drewsum/VFD_Clock/README.md

A VFD clock centered around a PIC32MZ EF microcontroller
