drewsum/VFD_Clock/rev_b/hdw/README.md

rev B control boards use rev A display boards
