drewsum/VFD_Clock/(threads)

Thread 21 (2020-02-05):

Consider a different RTC for backup RTC

drewsum, 2020-02-05:
The DS3231 is too large to be justified since it's in an SO-16 package. Try to find an 8 pin part

drewsum, 2020-02-06:
This ended up being fake news

Closed 2020-02-06.

Thread 22 (2020-02-07):

Consider IV-1 tubes as colons

drewsum, 2020-02-07:

drewsum, 2020-02-13:
Parts ordered, just need to find pinout

drewsum, 2020-02-17:
https://www.radiomuseum.org/tubes/tube_iv-1.html

drewsum, 2020-02-17:
Looks like that source requires you to register to access pinouts/datasheets

drewsum, 2020-02-17:
http://www.tube-tester.com/sites/nixie/dat_arch/russian_tubes.pdf

drewsum, 2020-02-17:
https://radiokot.ru/circuit/digital/home/175/

drewsum, 2020-02-17:
https://kama-labs.com/vfd_iv-11-4

drewsum, 2020-02-17:
https://kama-labs.com/boards

drewsum, 2020-02-17:
http://www.spark-tube.com/wp-content/uploads/2018/08/iv-1-datasheet.jpg

drewsum, 2020-02-17:
Translation of previous comment:
AND B-1
Vacuum luminescent indicator for displaying information-
mations in the form of dots and dashes.
Design-glass, over-
miniature. Pro indication-
is harassed through the side by-
the surface of the cylinder. The color of the candles-
nia green. Weight 7
7 g.
Thirty
Thirty six
Twenty
The findings of the electrodes:
1 ... cathode;
7 grid (mask); 8-cathode,
conductive layer on the inner-
surface area of the balloon; 10
anode-segment (dash); 13-anode-
segment (point).
Master data
The brightness of
Viewing angle
Incandescent current
The current of anode-segment (in static mode)
Total anode current
Filament voltage
The voltage of the anode and the grid:
in static mode
in pulse mode
MTBF
300-500 CD / m2
60°
2.5-5.0 mA
0.25 mA
0.6 mA

drewsum, 2020-02-24:
The above pinout was verified using received parts:
GND(cathode): 1
Grid: 7
Filament voltage: 8
Dash anode: 10
Dot anode: 13
in numbering follows the same scheme as IV-6, but with more pins

Closed 2020-03-04.

Thread 25 (2020-02-13):

Switch to LTC6900 for buzzer clock generation

drewsum, 2020-02-13:
The 555 is bulky and takes up too much room with its external circuits. LTC6900 looks like a good alternative to keep part count and solution size down

Closed 2020-02-15.

Thread 30 (2020-02-25):

Flip connector/buffer pinout for grid drive signals

drewsum, 2020-02-25:
This would make routing on the display board easier and since the signals are just paired to PIC I/O it doesn't matter which GPIO they go to

Closed 2020-02-27.

Thread 33 (2020-02-28):

VFD tube sanity check

drewsum, 2020-02-28:
Do a final sanity check on VFD tube pinout before ordering boards. This is a lot to get wrong

Closed 2020-03-04.

Thread 37 (2020-03-18):

Fix dsp io connector footprints

drewsum, 2020-03-18:
The connector footprint used on the logic board is far too narrow. Extend the pads outward to make it easier to solder. The same might be the case for the connector on the display board

Closed 2020-10-07.

Thread 38 (2020-03-20):

Adjust clock settings to source clock from 8MHz external POSC

drewsum, 2020-03-20:
Replace the stuff in the `PLLInitialize()` function within device_control.c

Closed 2020-03-26.

Thread 42 (2020-03-28):

Fix schematic I2C addresses

drewsum, 2020-03-28:
A lot of the I2C addresses noted in the schematic are wrong. All INA219s are wrong

Closed 2020-04-13.

Thread 44 (2020-04-03):

BOM change  display I/O expander series resistors to a higher value

drewsum, 2020-04-03:
Right now they're 499 ohms, which leaves the cyan LEDs way too bright. Try something way higher. Try something as strong as 10k or 100k

drewsum, 2020-04-03:
Switched to 10k in hardware, if this is good need to update the schematic

drewsum, 2020-04-03:
These should probably actually be on the order of 100k, they're still too bright with 10k

drewsum, 2020-04-14:
Going to leave these at 10k

Closed 2020-04-14.

Thread 45 (2020-04-10):

BOM change all INA219 Filter Resistors

drewsum, 2020-04-10:
You had 100 ohms in the schematic. INA219 datasheet recommends 10. This could have something to do with odd current results

Closed 2020-04-14.

Thread 46 (2020-04-10):

Move WDT clearing to main()

drewsum, 2020-04-10:
Right now the ISR for the heartbeat timer is what clears the watchdog. This leaves room for issues to arise when the application does not properly return back to `main()`. You should switch to setting a clear WDT request flag in the ISR, and actually clear the WDT from main. This would absolutely force a reset if `main()` is not being properly returned to

Closed 2020-04-11.

Thread 48 (2020-04-11):

Fix I2C driver to avoid weird interrupt return issues

drewsum, 2020-04-11:
An issue with I2C that has plagued the electronic calendar is appearing on this board as well. This is making me think it's either interrupt related or has something to do with storing all of your telemetry in a C structure. Regardless, the CPU gets hung up every once in a while. Since moving the WDT clearing function to `main()`, rather than "stall", the CPU is reset by the WDT. This confirms that when this stalling issue happens, the CPU core is not returning back to IPL level 0, or back to main. If I comment out the continuous I2C polling for all of the telemetry sensors, this issue disappears.

Figure this out and apply it to electronic_calendar too.

May want to switch to a purely-blocking implementation of I2C instead of interrupt driven, since you're blocking anyway. If shit is still completely broken, consider using a bit bang implementation.

I2C has a lot tied to it on this board and it would suck to throw in the towel on this. At the very least, leave the IO expander/RTC nonsense but get rid of polling telemetry sensors. This really sucks to see appear on this project as well.

drewsum, 2020-04-15:
This is in progress. I've minimized the likelihood of the issue arising during normal operation by having I2C sensors only be polled during telemetry serial stream. I also set the I2C1 Master Interrupt to IPL7 in the hopes that this was caused by strange timing issues with the master interrupt being interrupted by higher priority interrupts. Seems promising so far. I also gutted all of the 10-bit I2C support code in the I2C master driver since this is never used. This should hopefully speed up execution of the master ISR, since it's really long. Here'es hoping this will fix this!

drewsum, 2020-04-15:
This didn't fix it, but it helped.

drewsum, 2020-04-15:
Actually it's unclear if these changes even helped, I'm still seeing a ton of resets

drewsum, 2020-07-09:
This was solved by changing to the MPLabX Harmony I2C driver. Use this for future projects, this is what was used on pulse oximeter

Closed 2020-10-07.

Thread 51 (2020-04-12):

Fix *IDN? Return string

drewsum, 2020-04-12:
Still prints out that it's an electronic calendar, oops

Closed 2020-04-13.

Thread 58 (2020-04-19):

Add BLE stuff?

drewsum, 2020-04-19:
This is hit or miss. The project is clearly complex enough already as it is. I kicked the can down the road on this and wasn't able to get the BLE module to reply to the host. I'm planning on soldering another one down in the case that the installed module is blown or something. If I still can't get it to work after replacing the part, let's ditch this. Setting over USB and pushbuttons is good enough.

Closed 2020-10-07.

Thread 59 (2020-04-19):

Add I2C slaves status command

drewsum, 2020-04-19:
print off manufacturing ID stuff for supported I2C slave devices from a serial command

drewsum, 2020-04-19:
I completed this for INA219

drewsum, 2020-04-19:
Finished this! It's awesome

Closed 2020-04-19.

Thread 61 (2020-10-07):

Control Board rev B

drewsum, 2020-10-07:
Improvements from rev A would include:
~~* Fixing display board I/O connector footprint (pads are located too close to centerline/anchor to hand solder)~~
~~* Remove PIC32MZ backup VCC supply from battery, hard wire to +3.3V~~
~~* Make expensive components like telemetry and time of flight optional with config hardstraps~~
~~* Remove USB UART isolation, share grounds~~
~~* Switch to PICKIT4 header for programming~~
~~* Switch to cheaper input power protection circuitry~~
~~* Switch to smaller +3.3V, +5V and +1.2VFF power supplies (lower output current rating, smaller inductor)~~
~~* Remove BLE module~~
~~* Switch to smaller CR1616 RTC backup battery, remove duplicate battery footprints, add VBAT comparator~~

drewsum, 2020-10-07:
* Change power discharge circuits to match your more recent projects

drewsum, 2020-10-07:
* Fix USB bridge sheet to use most recent version of this circuit

drewsum, 2020-10-07:
* Remove excessive MCU bypass (1000pF, 10nF) and switch to using a 0.1uF and 10uF parallel combination per power pin bank

drewsum, 2020-10-07:
* Change all telemetry filter resistors to 10 ohms
* Remove input telemetry on converters?

drewsum, 2020-10-08:
Change UART level shifter to SN74AVC2T245RSWR

drewsum, 2020-10-09:
~~* Switch from TPS62130 to TPS62150A to fix PGOOD issues with older part~~
I actually used the correct Digi-Key part number for this, just need to update my schematic symbol library to reflect the parts I've been ordering are the "A" version

drewsum, 2020-10-09:
* Add notes to TPS62150 sheets to keep offsheet output capacitance below 200uF

drewsum, 2020-10-13:
* Remove VBAT comparator and switch to this: https://electronics.stackexchange.com/questions/416336/monitor-coin-cell-voltage-without-loading-it-when-power-is-off

drewsum, 2020-10-14:
Switch PIC32MZ oscillator voltage source to +3.3V from +3.3V_BCKUP

drewsum, 2020-10-14:
* Remove DNP pull resistors in order to clean up BOM, make hand soldering easier

drewsum, 2020-10-14:
* Change POS5_USB current sense filter resistors to 10 ohms, they're currently at 100

Closed 2020-10-26.

Thread 63 (2020-10-20):

fix PIC digi-key PN in rev B schematic

drewsum, 2020-10-20:
change from 12x12mm part number to 14x14mm part number, since the footprint is 14mmx14mm

Closed 2020-10-26.

Thread 64 (2020-10-26):

Add "Display Toggle" serial command

drewsum, 2020-10-26:
sending this serial command would essentially do the same thing as pressing the power capacitive touch button

Closed 2020-12-17.

Thread 65 (2020-11-16):

Fix 2 bit UART transceiver footprint

drewsum, 2020-11-16:
the pin order of this footprint was reversed. Try to fix it to match the actual device pinout for future projects

Thread 67 (2020-11-25):

Goals for Rev B Firmware

drewsum, 2020-11-25:
* ~~Update GPIO macros and pin setup to match rev B hardware~~
* ~~Update all I2C device drivers to use new I2C master code~~
* ~~Update peripheral files such as I2C, RTCC, USB UART, ADC~~
* ~~Update device control to fix clocking issues~~
* ~~Update telemetry to remove PS input power monitors, since these are not present on rev B hardware~~
* ~~Update USB UART commands to include optimizations made in past projects~~
* ~~Update error handler~~
* ~~Make functionality configurable with hardstraps~~
* ~~convert all I2C code from I2C5 to I2C1 (or make configurable with macros like you did for USB UART)~~
* ~~Convert to new, faster heartbeat timer with PWM LED~~
* ~~Properly implement `IDLE` mode on power pushbutton toggle~~ Not doing this
* ~~Add serial command to set power state (emulate pressing the power button)~~
* ~~Add serial command to set clock display state (pressing menu buttons)~~
* ~~Add backup rtc temp and battery voltage telemetry configuration based on hardstrap~~
* ~~Copy INA219 driver bug fixes from analog clock firmware~~
* ~~Add display board time of flight to platform status command~~
* ~~Add firmware version macro~~
* ~~Start powered off by default~~

Closed 2020-12-17.

Thread 70 (2020-12-30):

Add RTC Backup when setting time with pushbuttons

drewsum, 2020-12-30:
Rev B firmware doesn't backup RTC time in the backup IC when setting time with capacitive touch pushbuttons. Add this when the user switches any RTC parameters using these pushbuttons and "locks" them

Closed 2021-01-09.
