drewsum/VFD_Clock/rev_b/hdw/Logic_Board/VFD_Clock/VFD_Clock.pdf

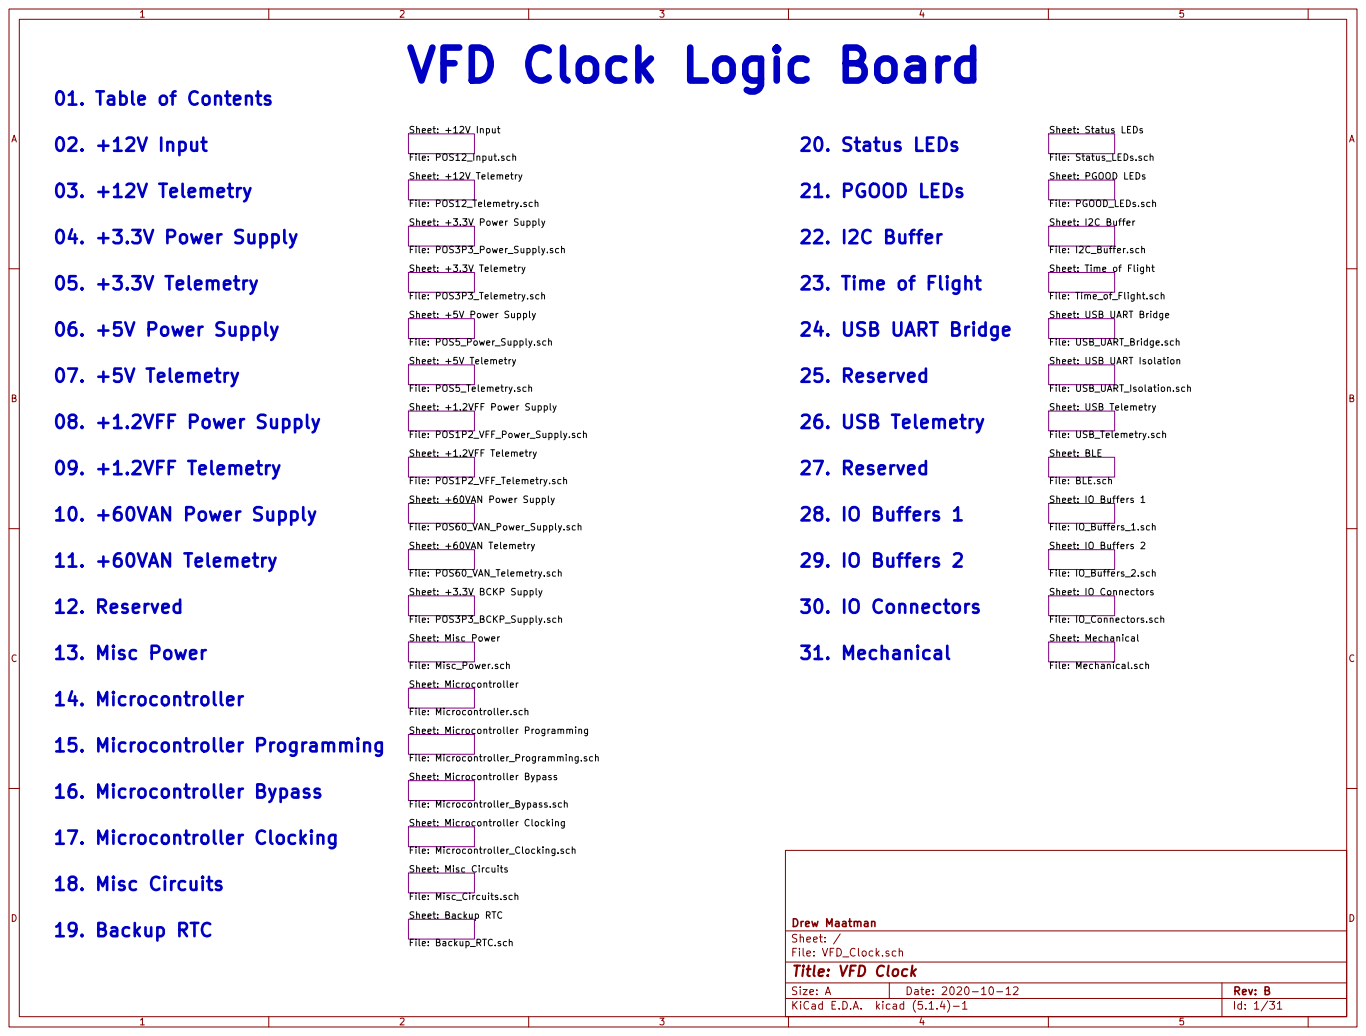
[picture p1: page 1]

VFD Clock Logic Board

File: Time_of_Flight.sch Sheet: I2C Buffer File: I2C_Buffer.sch Sheet: PGOOD LEDs File: PGOOD_LEDs.sch Sheet: Status LEDs File: Status_LEDs.sch

Sheet: Time of Flight

File: USB_Telemetry.sch Sheet: USB UART Isolation File: USB_UART_Isolation.sch Sheet: USB UART Bridge

File: BLE.sch Sheet: USB Telemetry

File: POS3P3_BCKP_Supply.sch Sheet: Misc Power File: Misc_Power.sch Sheet: Microcontroller File: Microcontroller.sch Sheet: Microcontroller Programming

File: Microcontroller_Programming.sch
File: Backup_RTC.sch Sheet: Misc Circuits File: Misc_Circuits.sch Sheet: Microcontroller Bypass

File: VFD_Clock.sch Sheet: / Drew Maatman

Id: 1/31 Title: VFD Clock

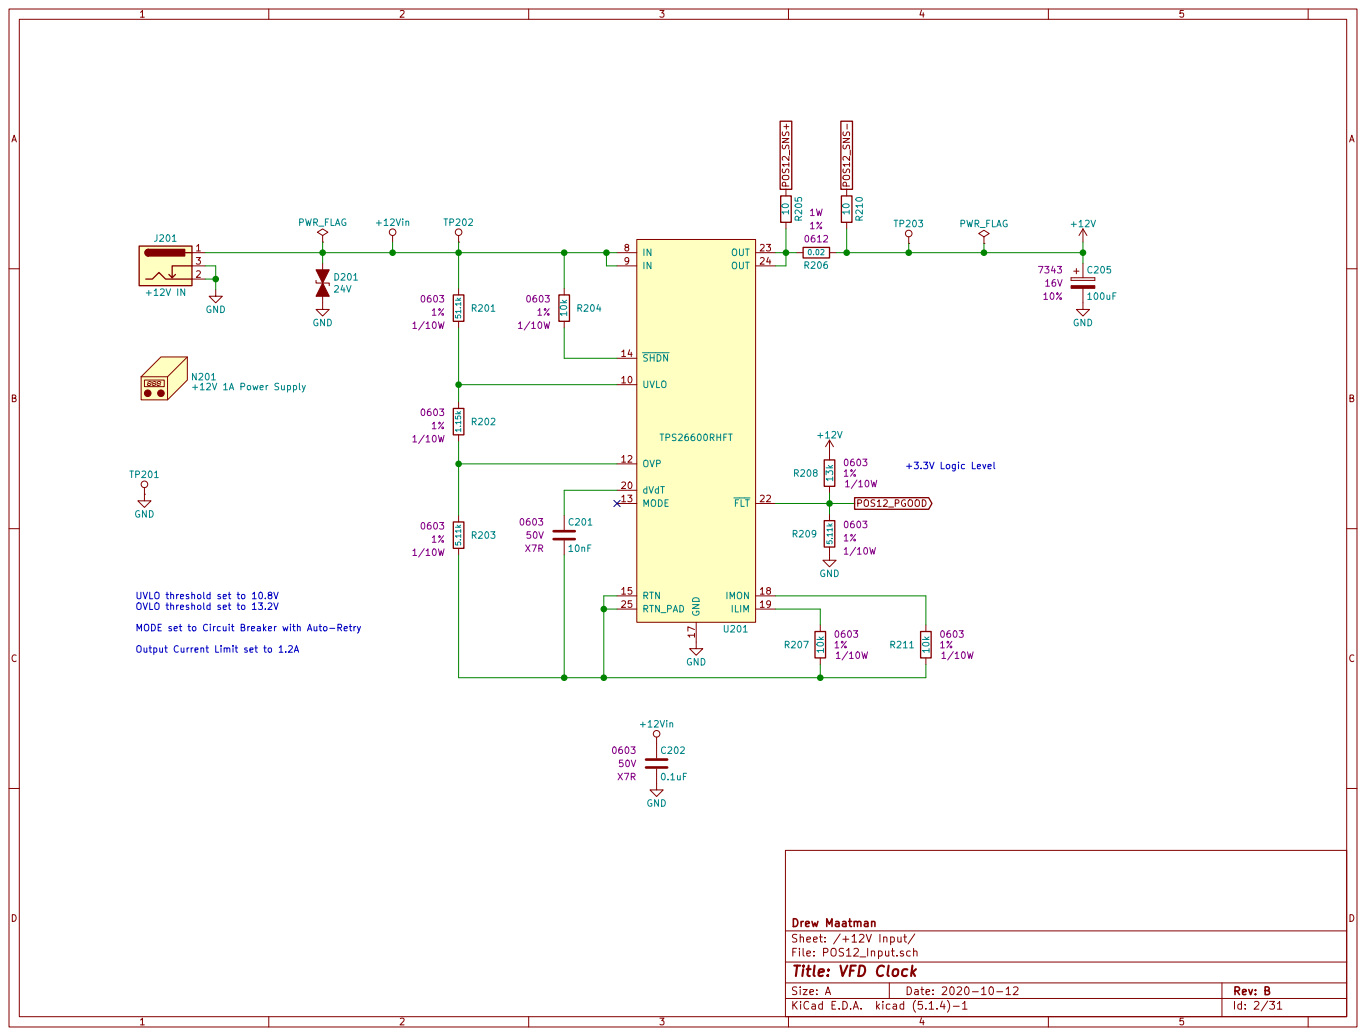
[picture p2: page 2]

+3.3V Logic Level UVLO threshold set to 10.8V OVLO threshold set to 13.2V MODE set to Circuit Breaker with Auto-Retry

Sheet: /+12V Input/ Drew Maatman GND

Output Current Limit set to 1.2A

File: POS12_Input.sch
Id: 2/31 Title: VFD Clock

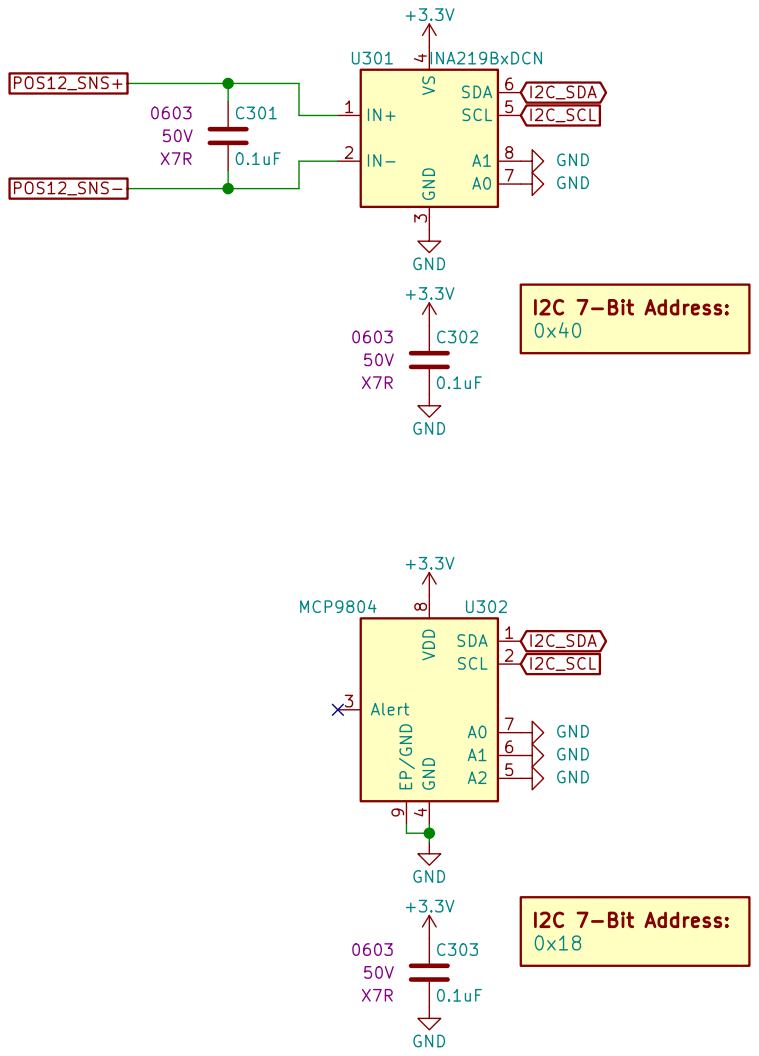
[picture p3: page 3]

Sheet: /+12V Telemetry/ Drew Maatman

File: POS12_Telemetry.sch
Id: 3/31 Title: VFD Clock

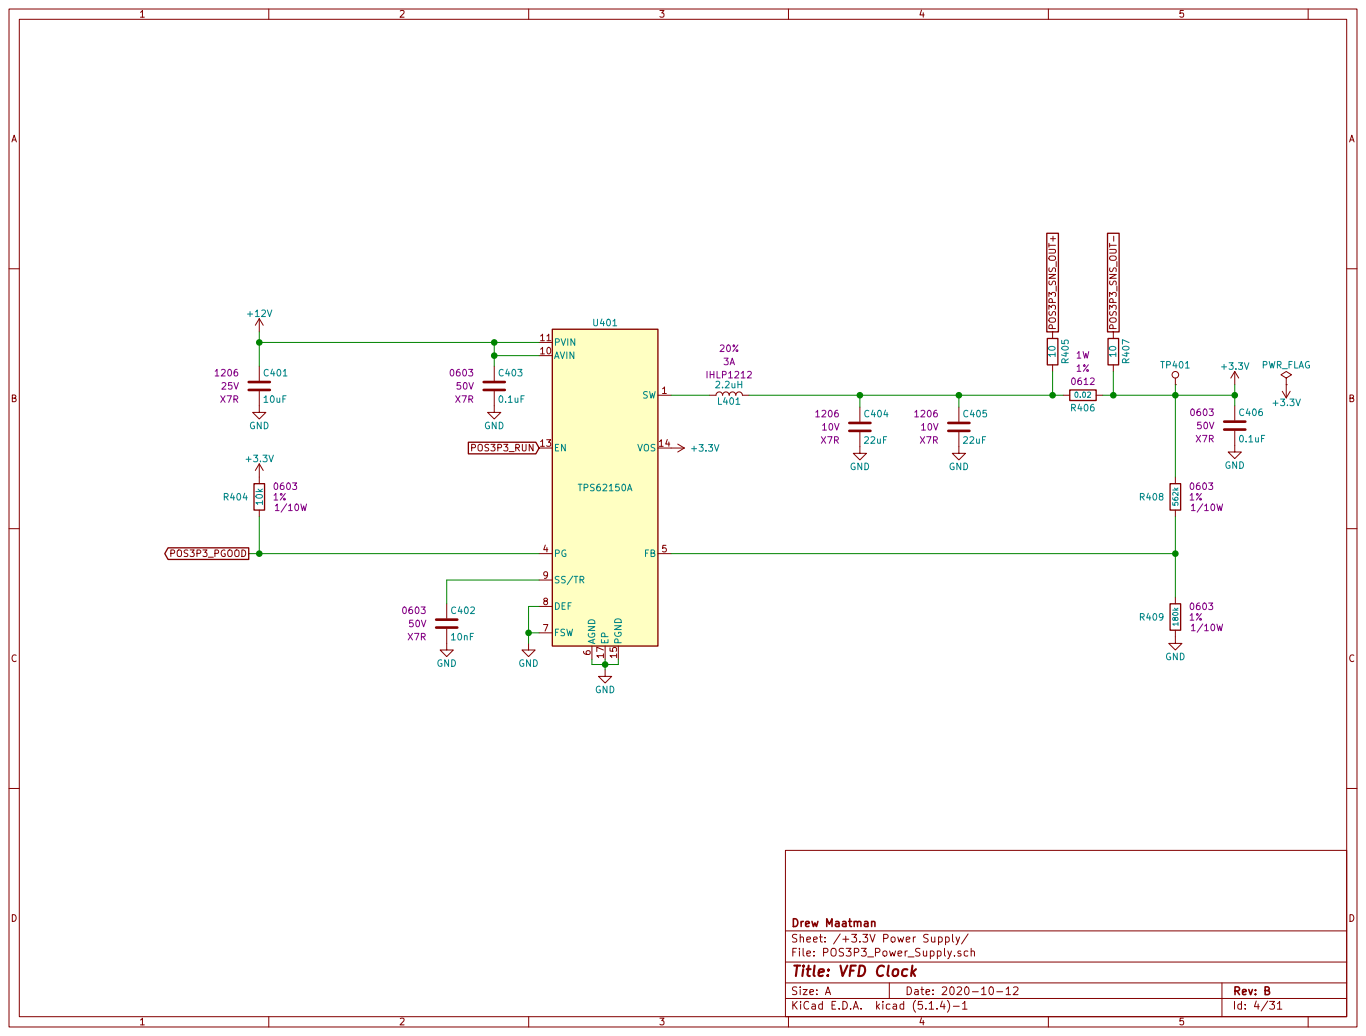
[picture p4: page 4]

6 FSW 7 DEF 8 SS/TR 9 U401 TPS62150A C403

Sheet: /+3.3V Power Supply/ Drew Maatman

File: POS3P3_Power_Supply.sch
Id: 4/31 Title: VFD Clock

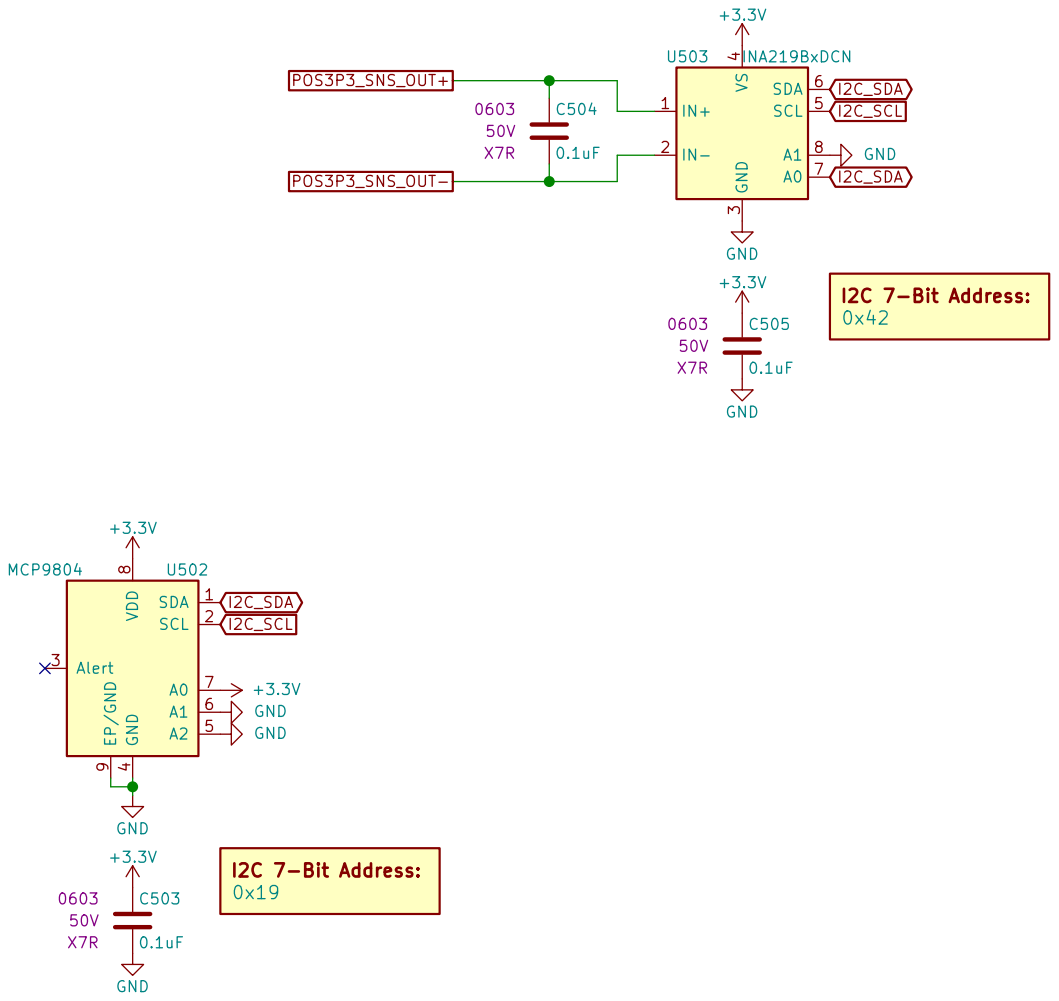
[picture p5: page 5]

File: POS3P3_Telemetry.sch
Id: 5/31 Title: VFD Clock

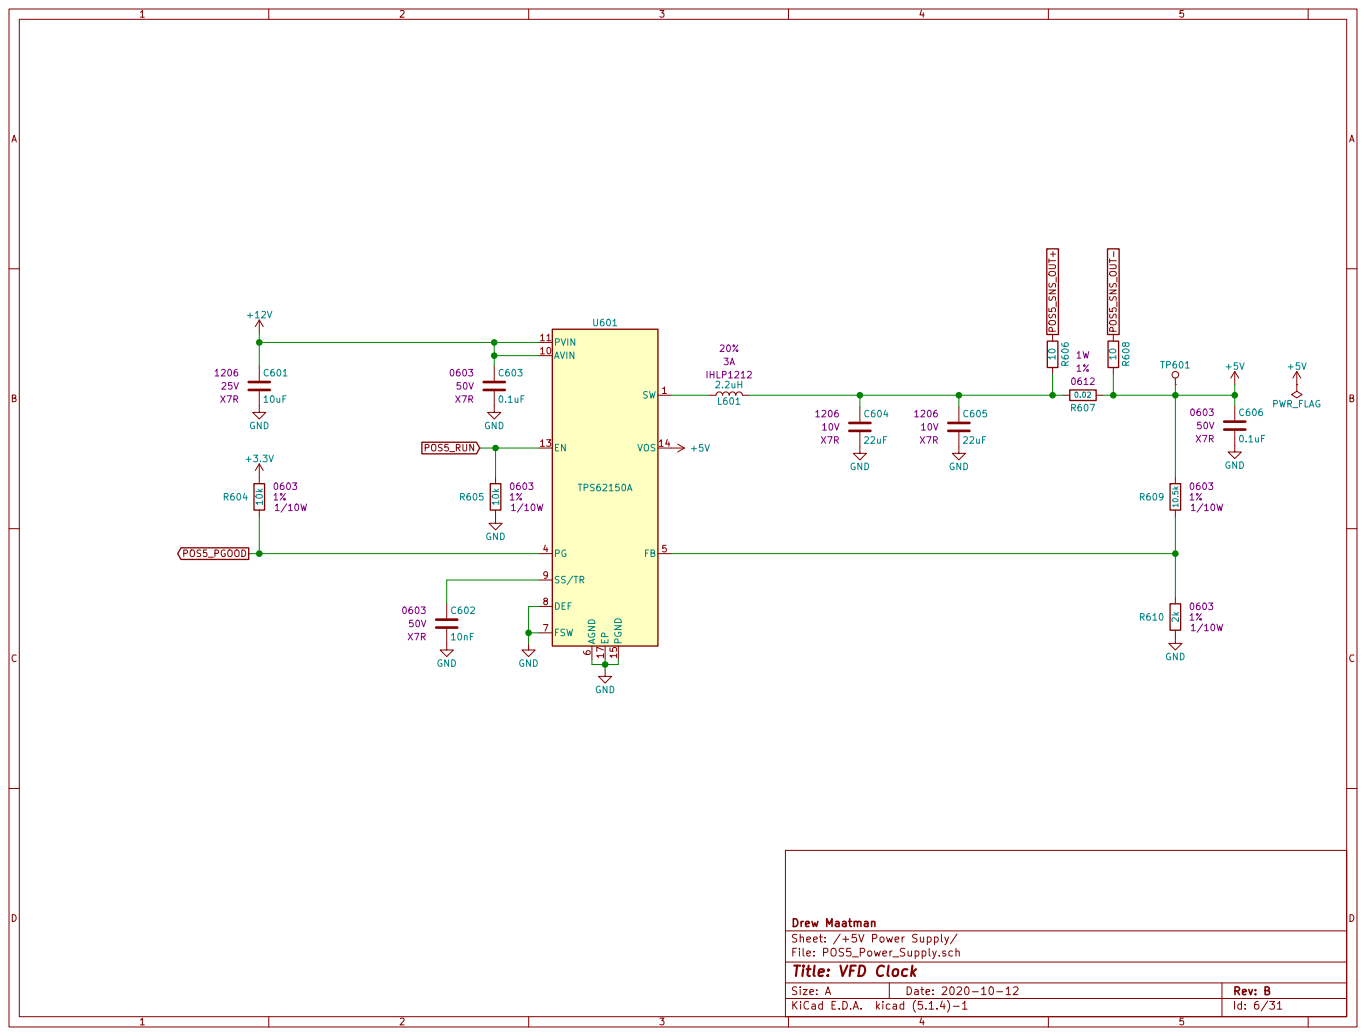
[picture p6: page 6]

6 FSW 7 DEF 8 SS/TR 9 U601 TPS62150A

Sheet: /+5V Power Supply/ Drew Maatman

File: POS5_Power_Supply.sch
Id: 6/31 Title: VFD Clock

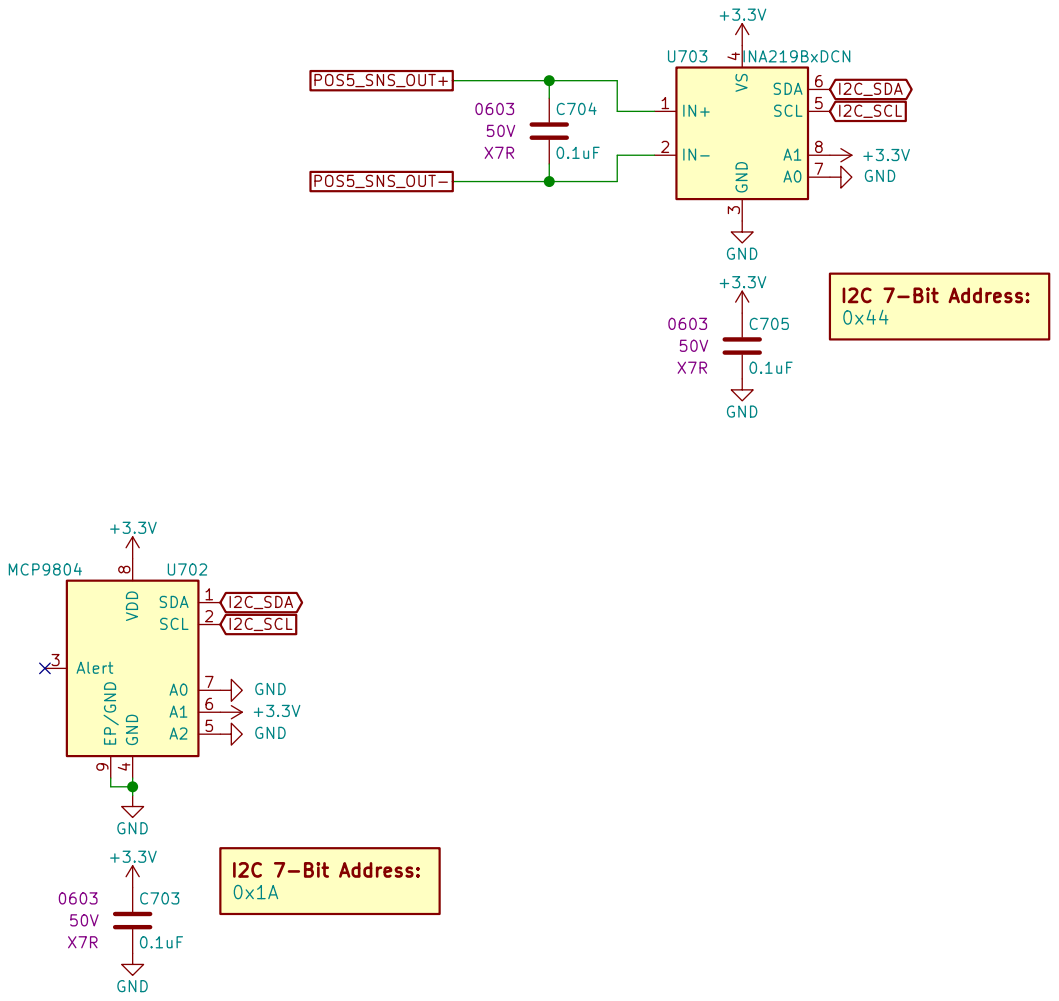
[picture p7: page 7]

File: POS5_Telemetry.sch
Id: 7/31 Title: VFD Clock

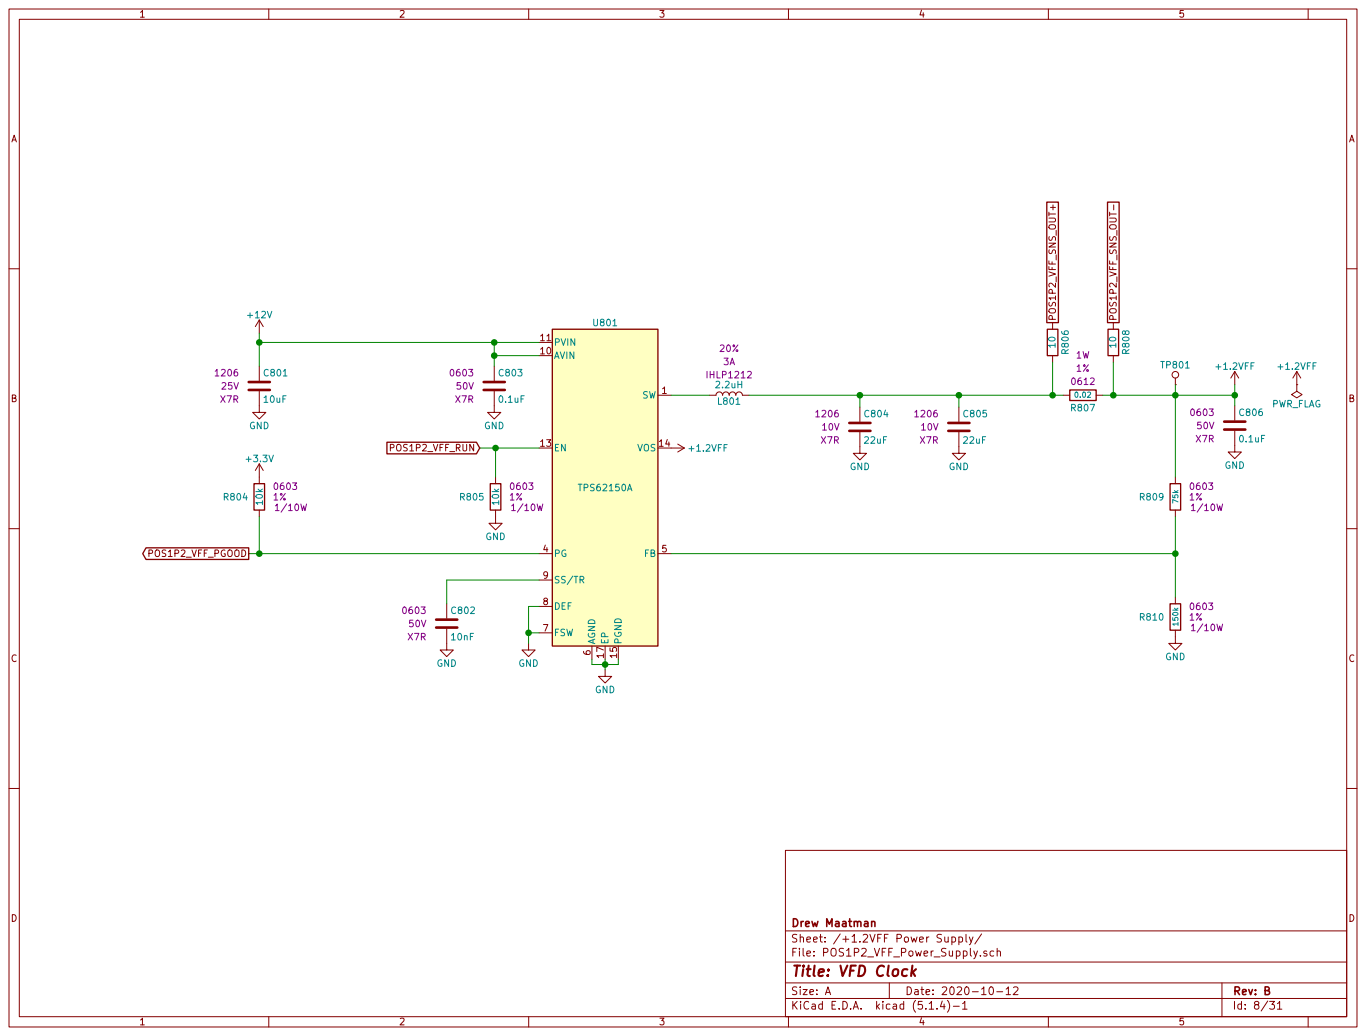
[picture p8: page 8]

6 FSW 7 DEF 8 SS/TR 9 U801 TPS62150A GND GND

File: POS1P2_VFF_Power_Supply.sch
Id: 8/31 Title: VFD Clock

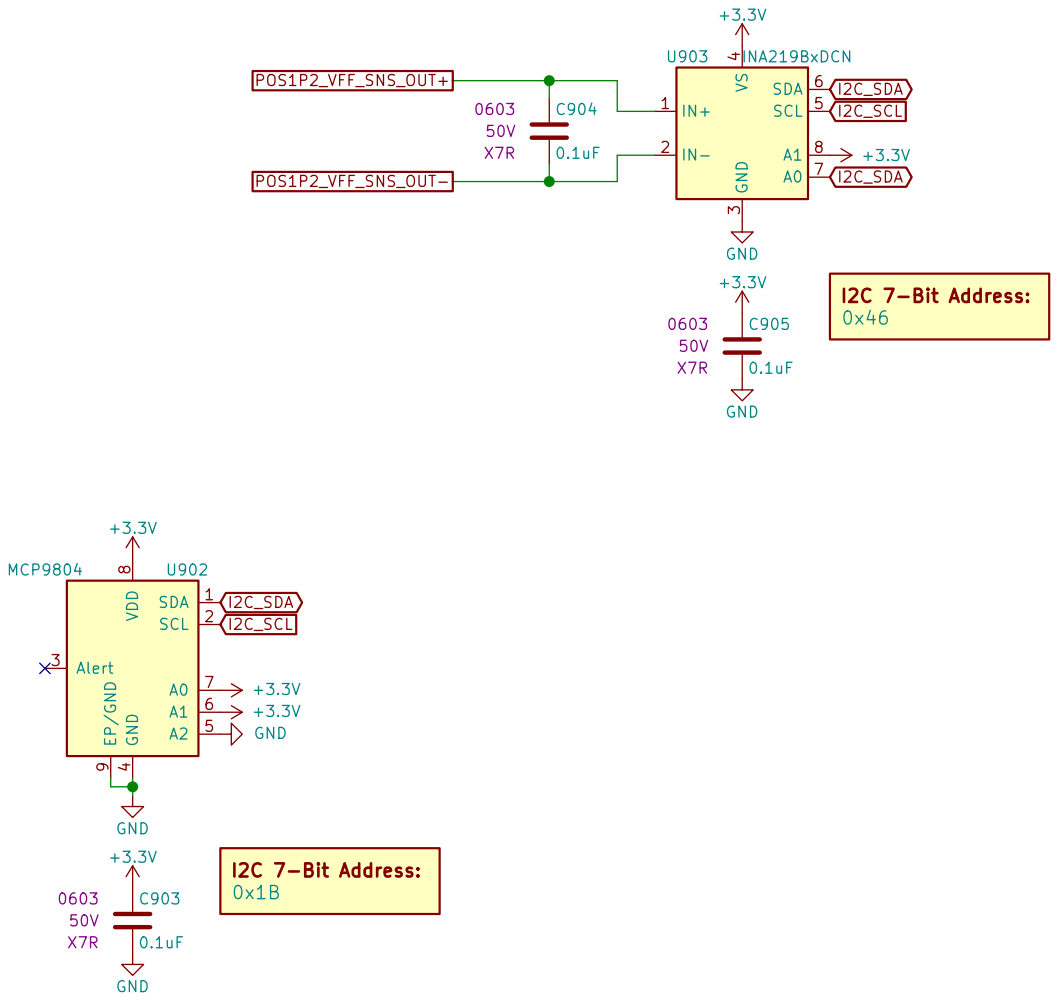
[picture p9: page 9]

File: POS1P2_VFF_Telemetry.sch
Id: 9/31 Title: VFD Clock

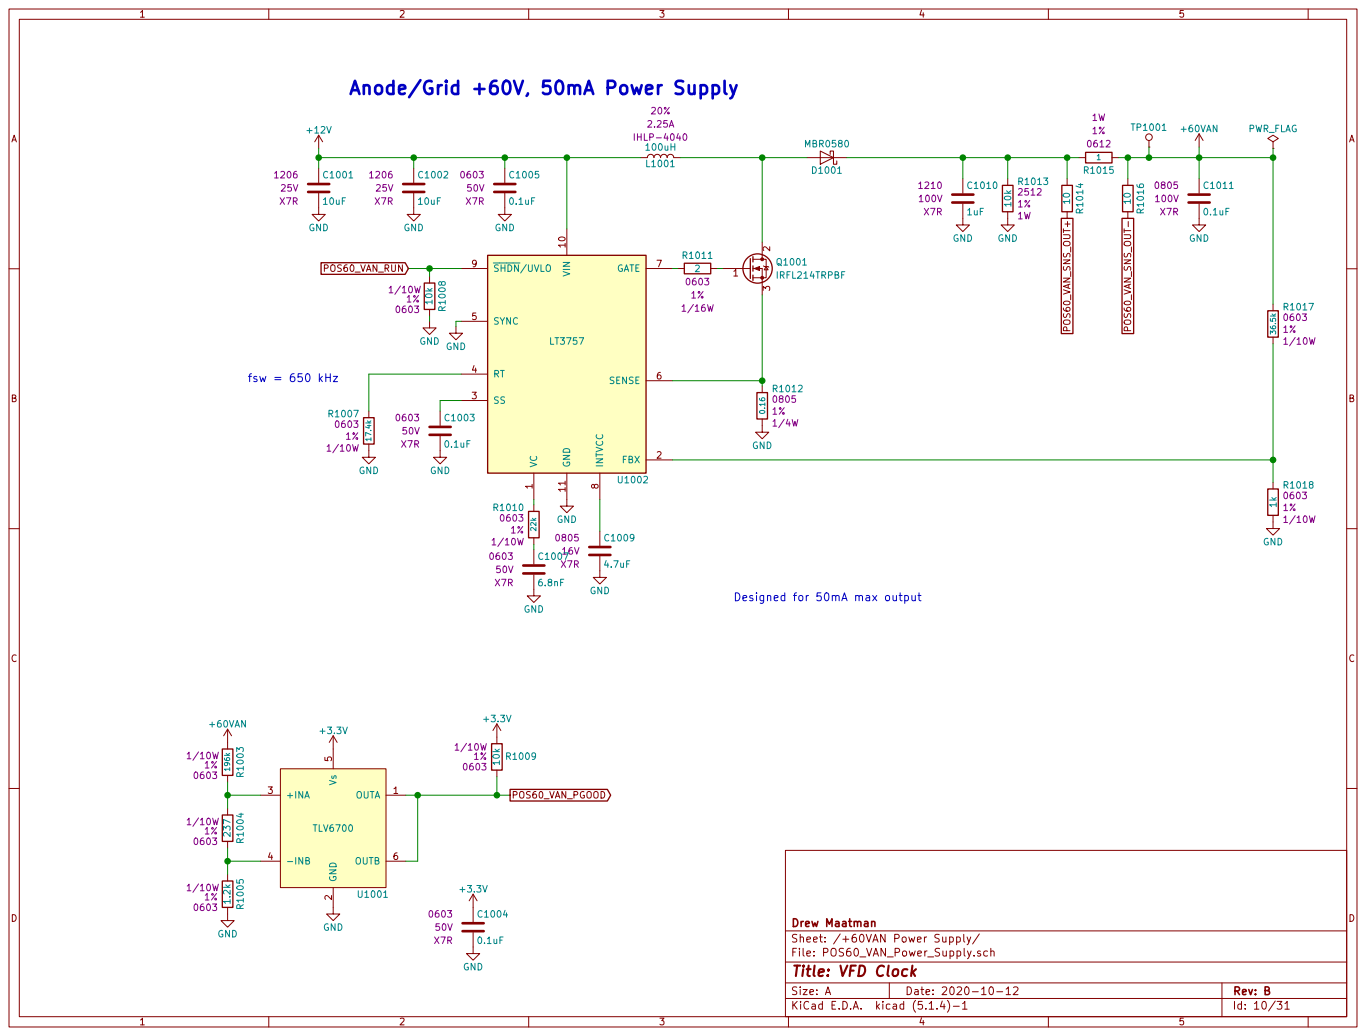
[picture p10: page 10]

POS60_VAN_PGOOD Anode/Grid +60V, 50mA Power Supply

1 VIN 10 GND 11 FBX 2 SS 3 RT 4 SYNC 5 SENSE 6 GATE 7 INTVCC

Sheet: /+60VAN Power Supply/ Drew Maatman GND

Designed for 50mA max output

File: POS60_VAN_Power_Supply.sch
Id: 10/31 Title: VFD Clock

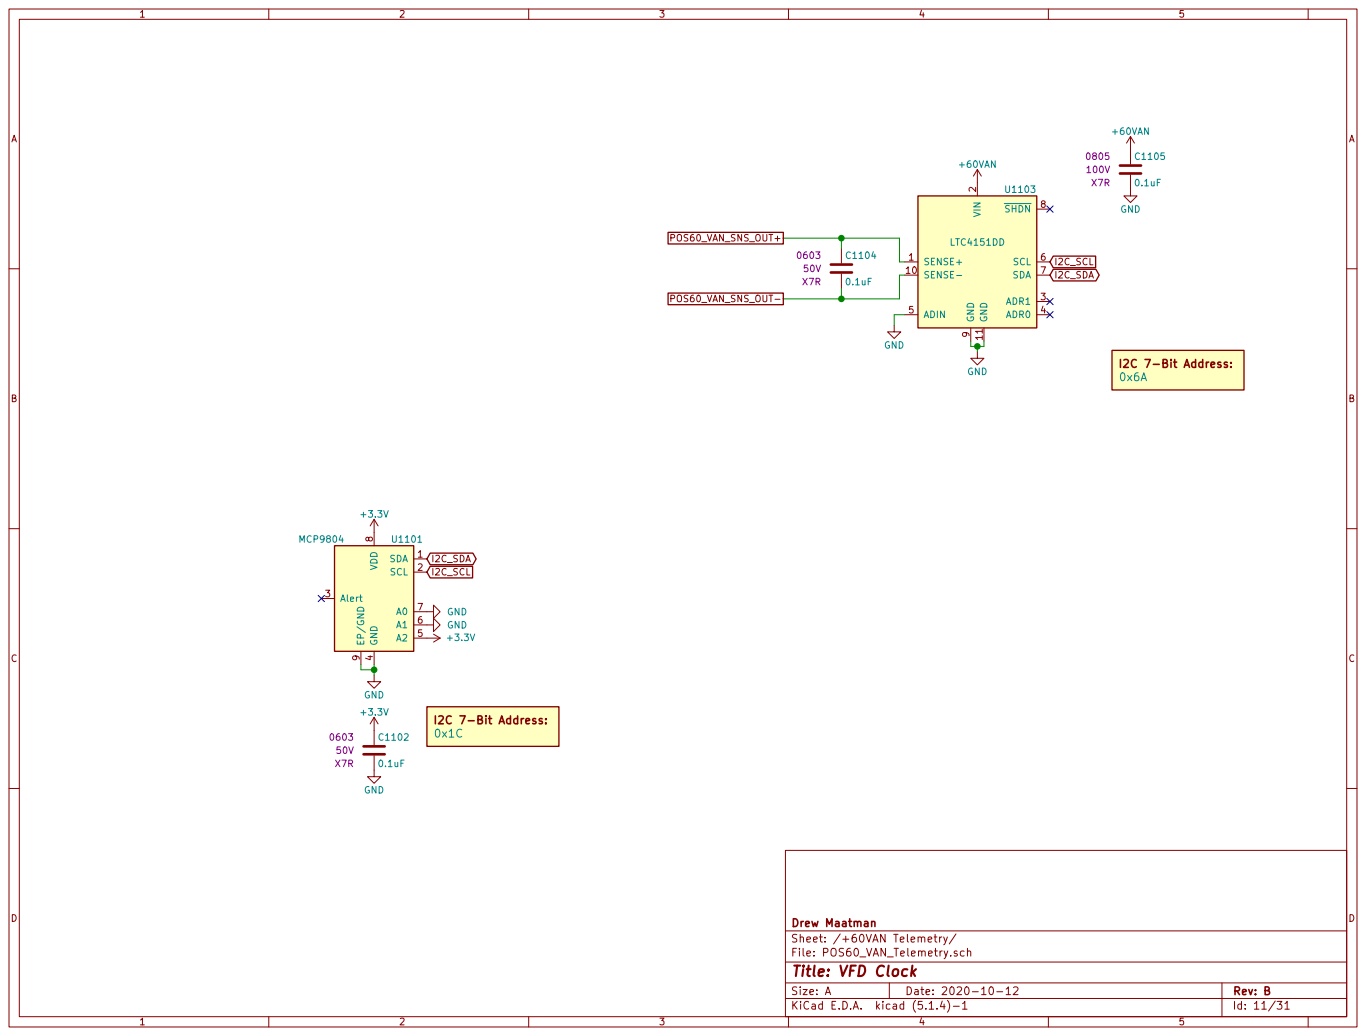
[picture p11: page 11]

2 ADR1 3 ADR0 4 ADIN 5 SCL 6 SDA 7 SHDN 8 GND

Sheet: /+60VAN Telemetry/ Drew Maatman

File: POS60_VAN_Telemetry.sch
Id: 11/31 Title: VFD Clock

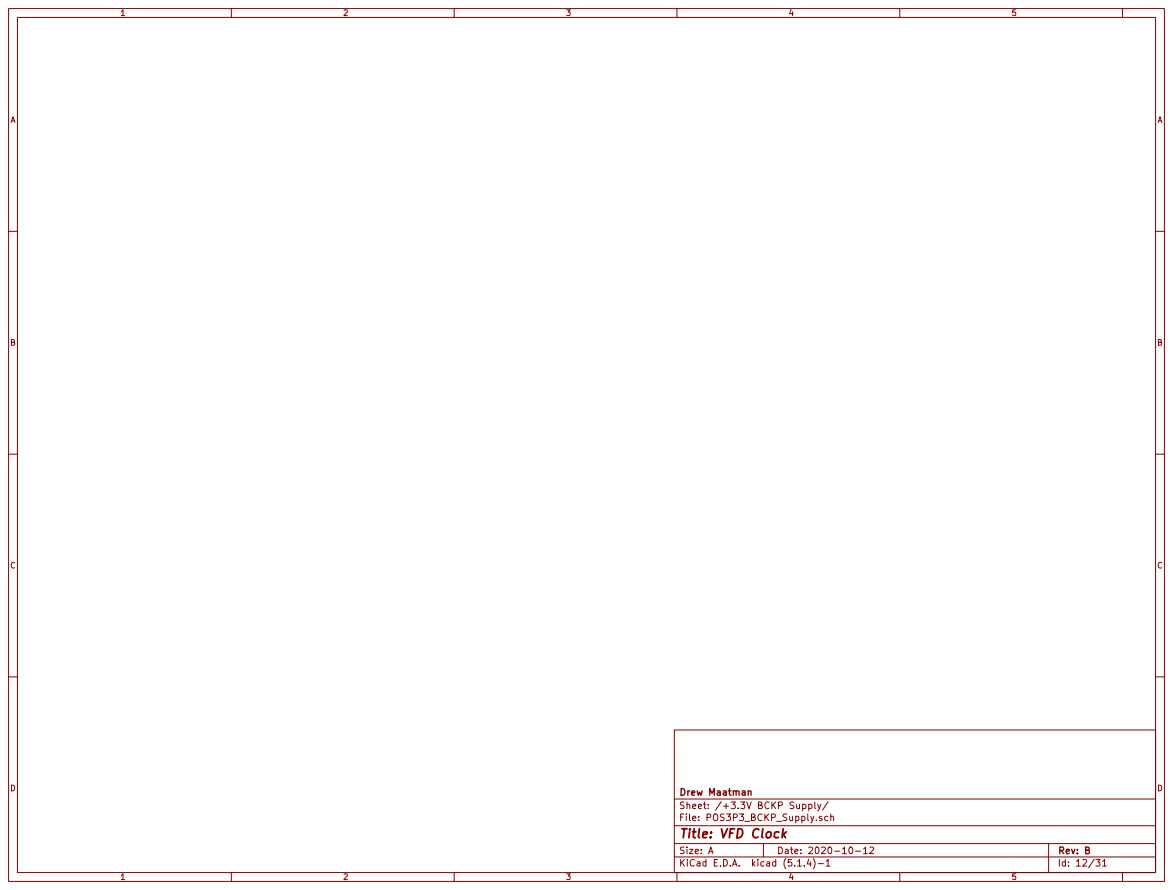
[picture p12: page 12]

Sheet: /+3.3V BCKP Supply/ Drew Maatman

File: POS3P3_BCKP_Supply.sch
Id: 12/31 Title: VFD Clock

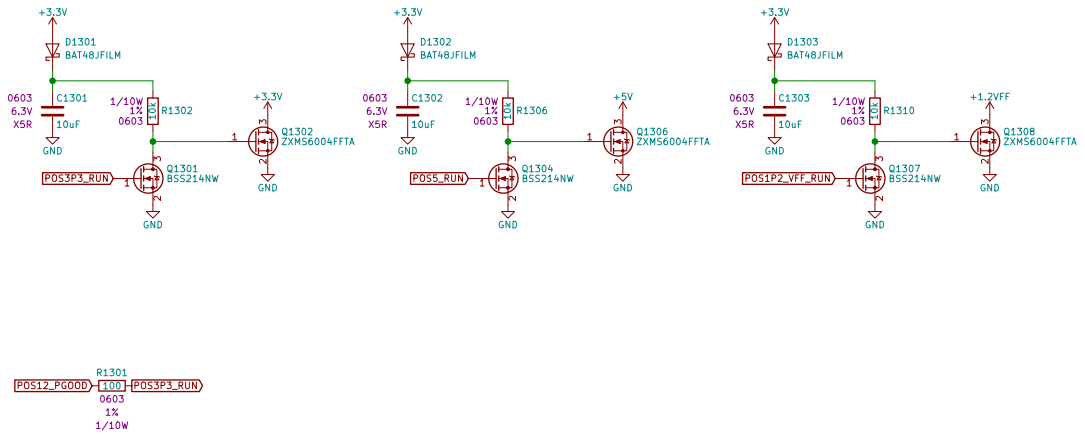
[picture p13: page 13]

File: Misc_Power.sch Sheet: /Misc Power/ Drew Maatman

Id: 13/31 Title: VFD Clock

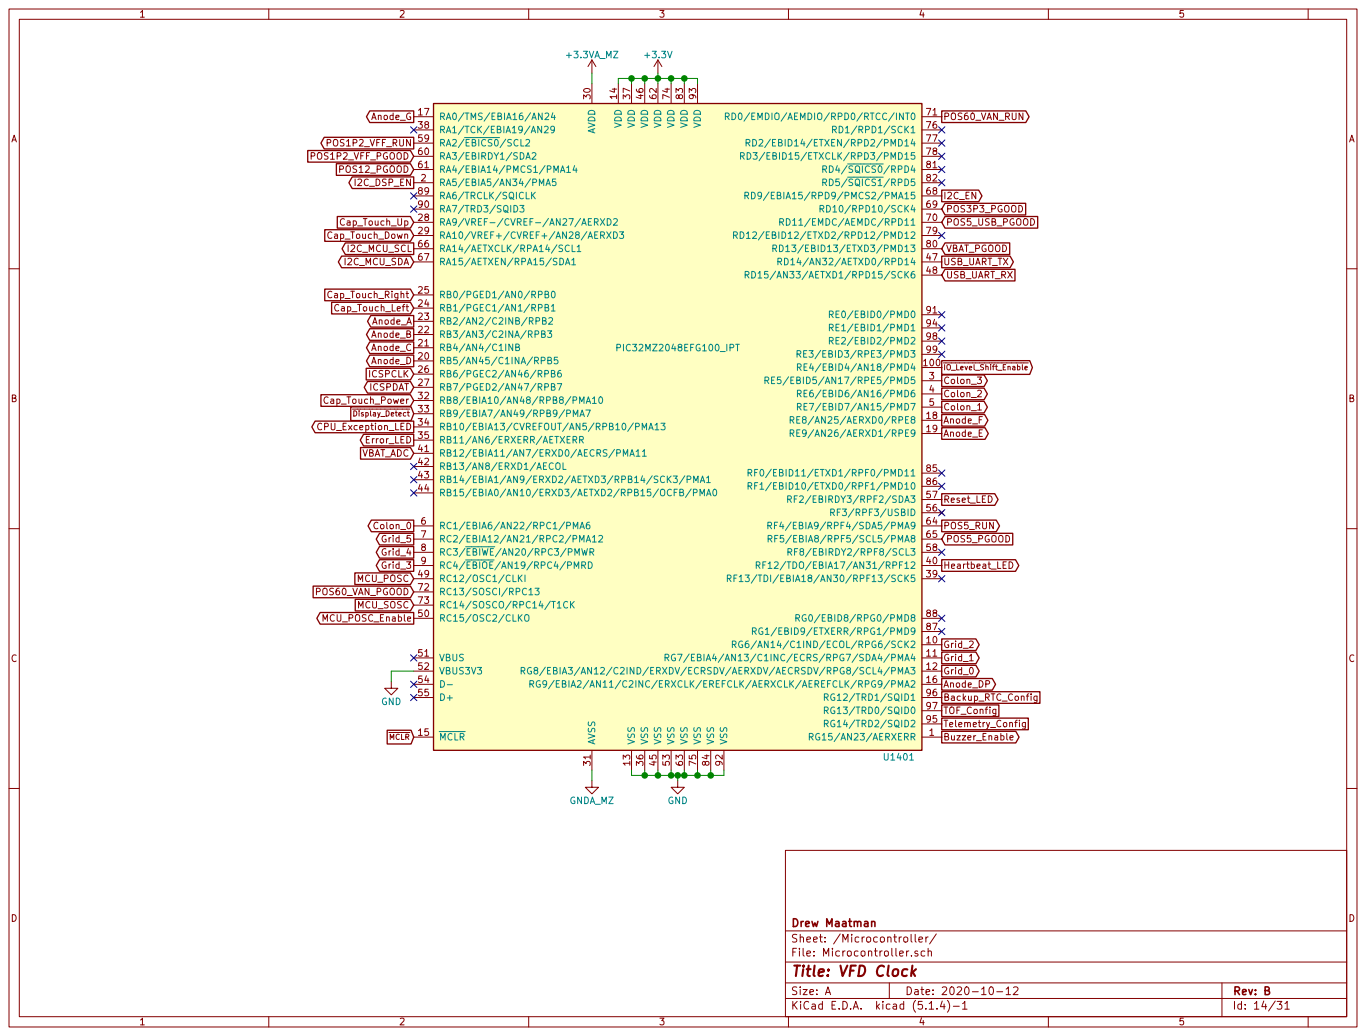
[picture p14: page 14]

File: Microcontroller.sch Sheet: /Microcontroller/ Drew Maatman

Id: 14/31 Title: VFD Clock

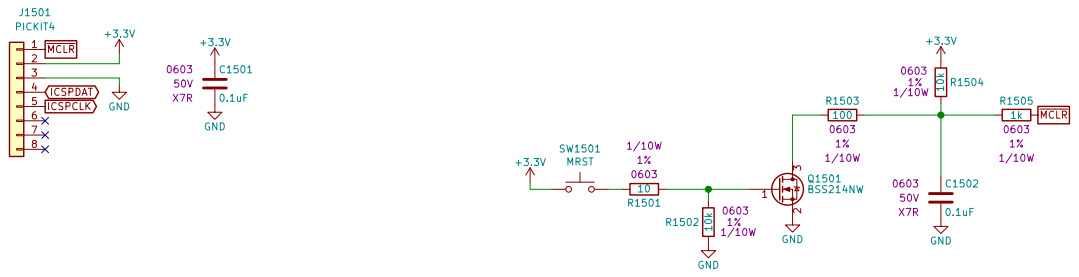
[picture p15: page 15]

Sheet: /Microcontroller Programming/ Drew Maatman

File: Microcontroller_Programming.sch
Id: 15/31 Title: VFD Clock

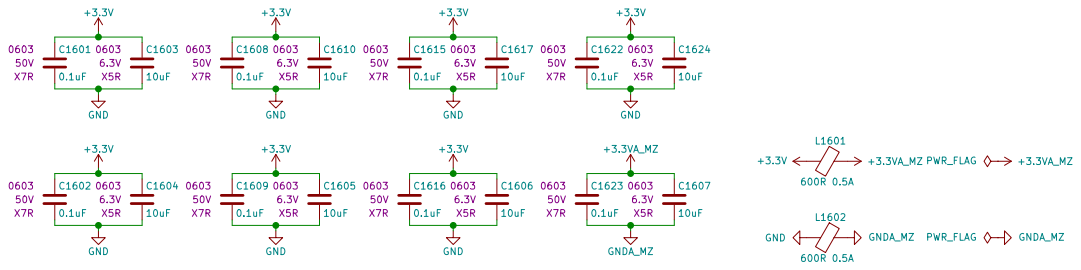
[picture p16: page 16]

Sheet: /Microcontroller Bypass/ Drew Maatman

File: Microcontroller_Bypass.sch
Id: 16/31 Title: VFD Clock

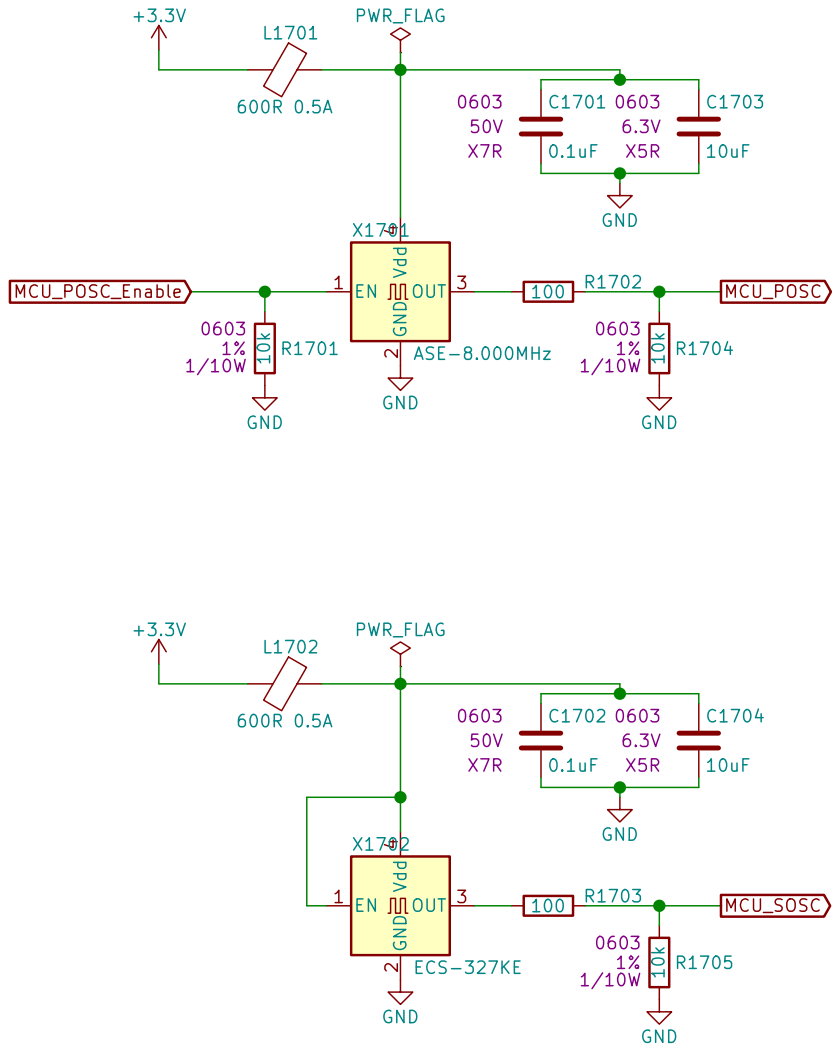
[picture p17: page 17]

2 OUT 3 Vdd X17024 ECS-327KE GND

Sheet: /Microcontroller Clocking/ Drew Maatman

File: Microcontroller_Clocking.sch
Id: 17/31 Title: VFD Clock

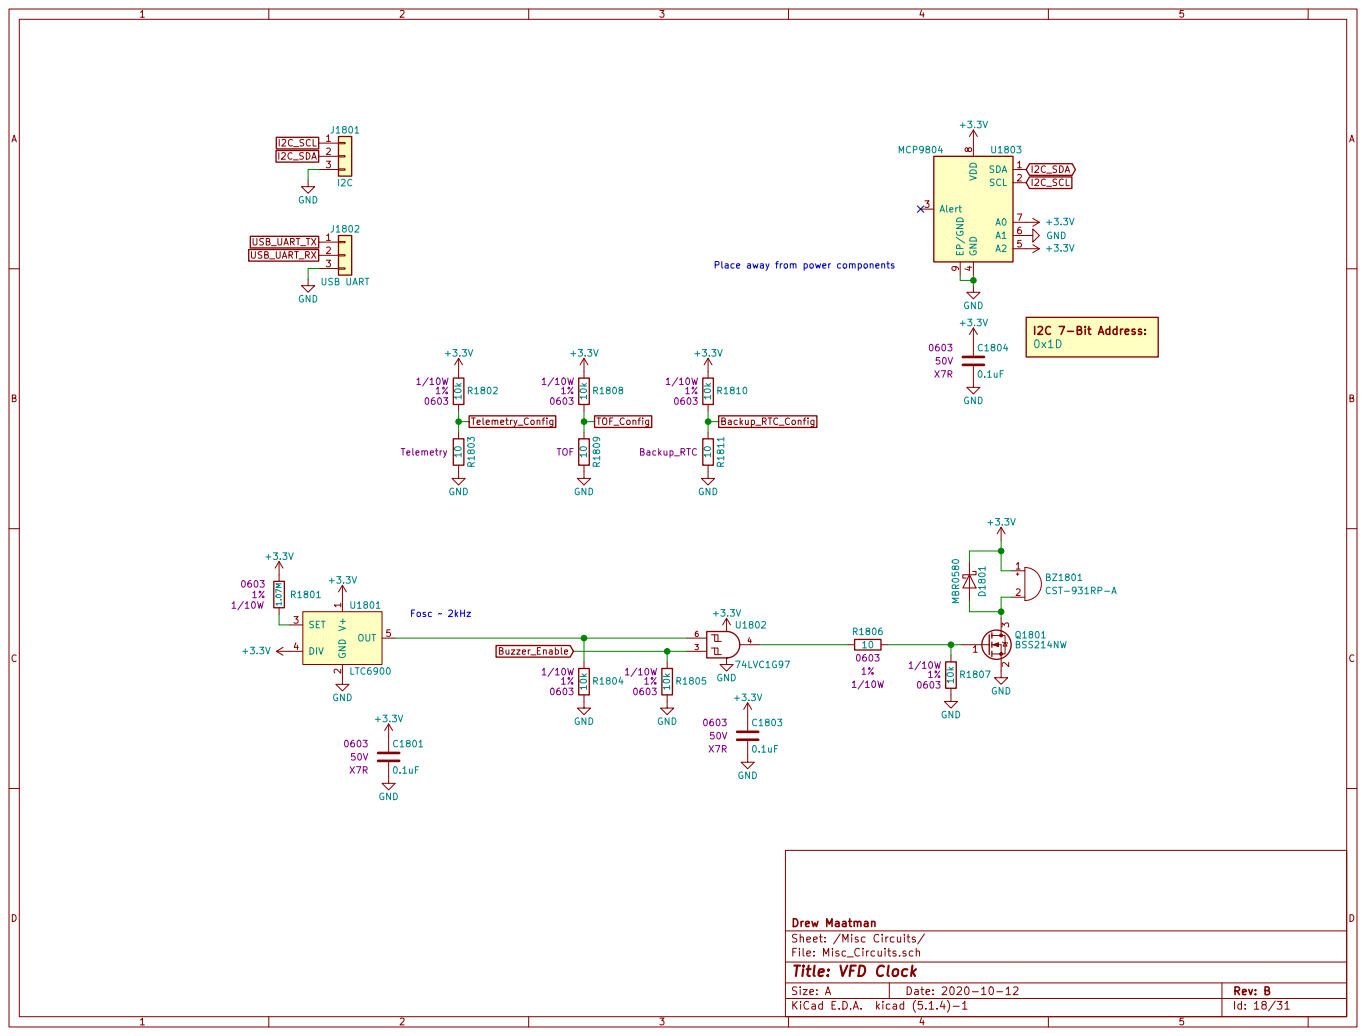
[picture p18: page 18]

Id: 18/31 Title: VFD Clock

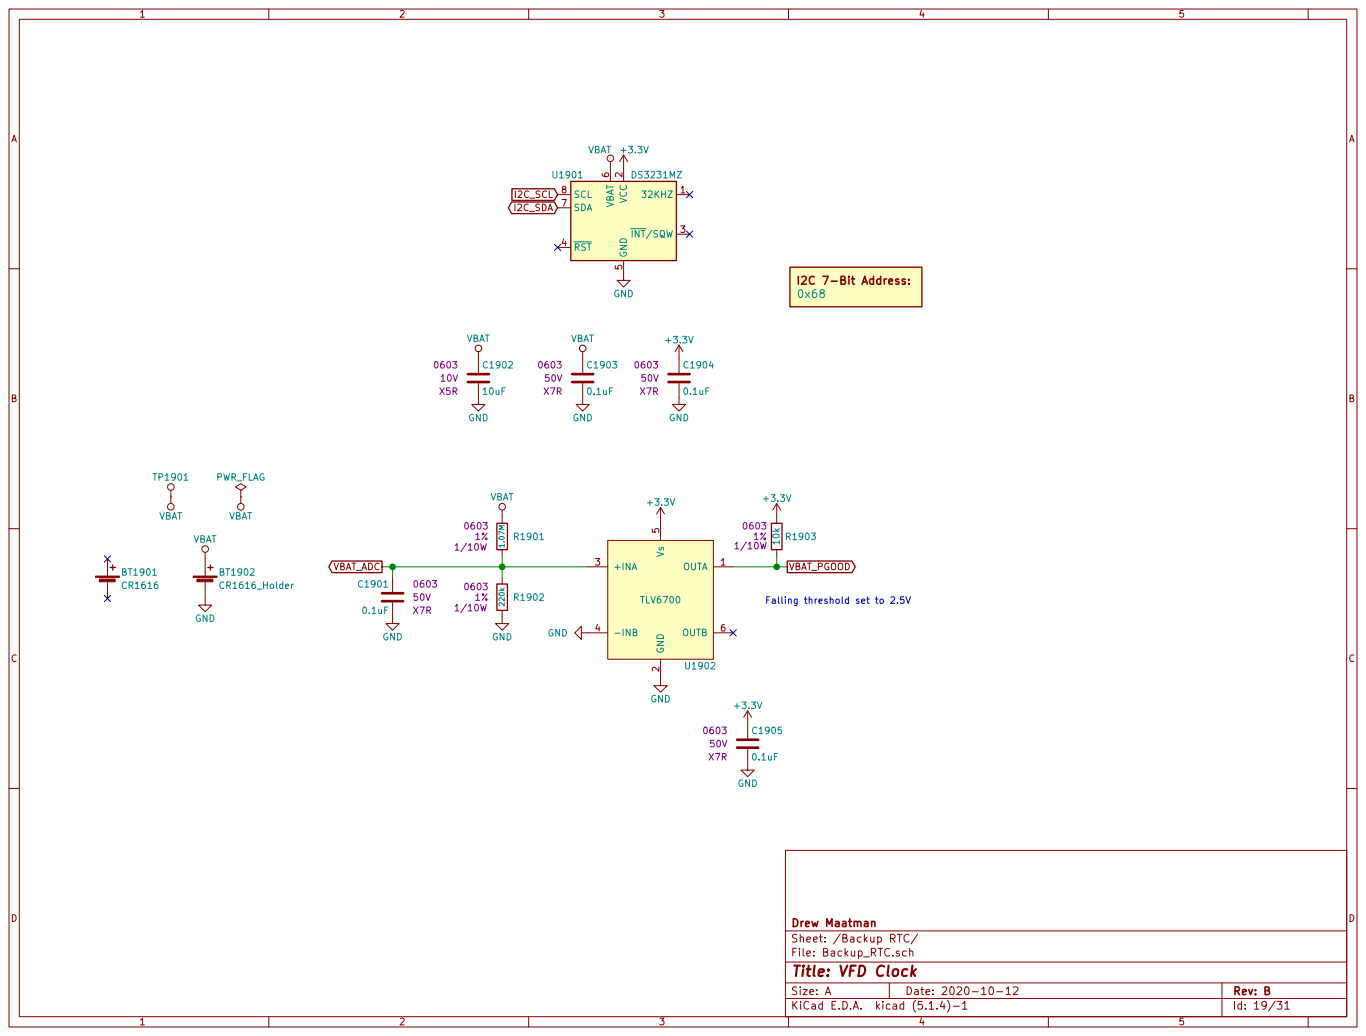
[picture p19: page 19]

File: Backup_RTC.sch
Id: 19/31 Title: VFD Clock

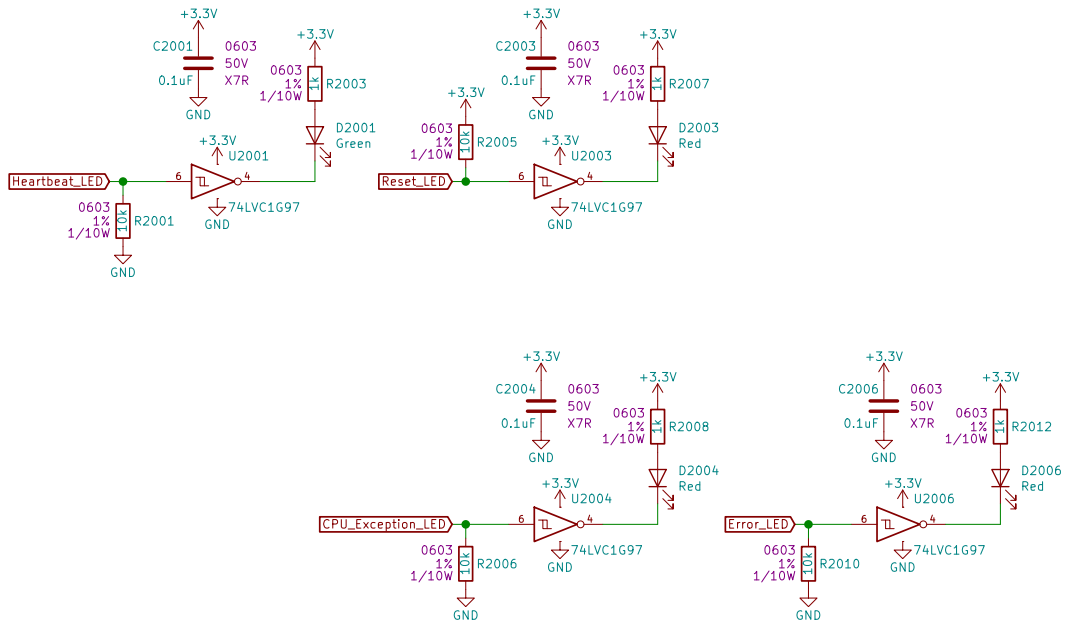
[picture p20: page 20]

File: Status_LEDs.sch Sheet: /Status LEDs/ Drew Maatman GND

Id: 20/31 Title: VFD Clock

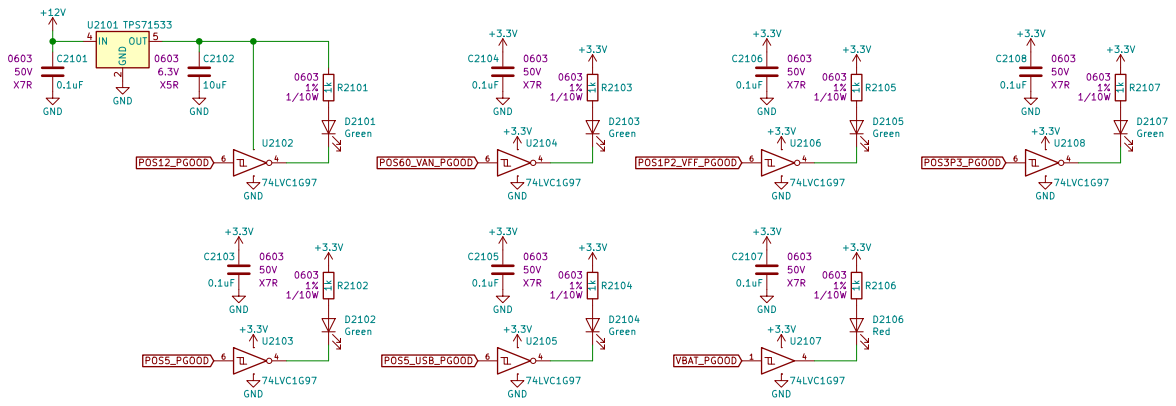
[picture p21: page 21]

File: PGOOD_LEDs.sch Sheet: /PGOOD LEDs/ Drew Maatman

Id: 21/31 Title: VFD Clock

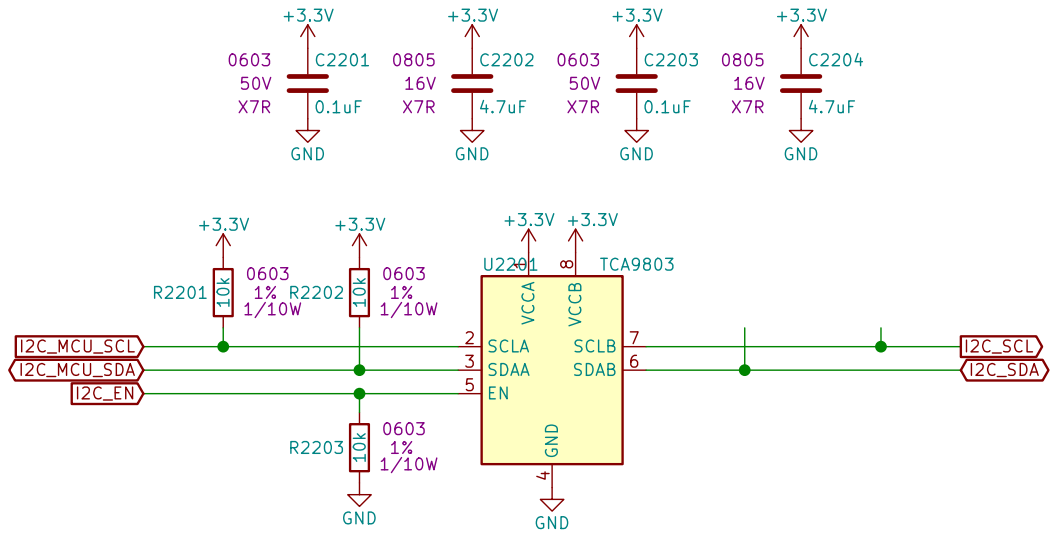
[picture p22: page 22]

4 EN 5 SDAB 6 SCLB 7 VCCB U2201 8TCA9803 C2202

File: I2C_Buffer.sch Sheet: /I2C Buffer/ Drew Maatman

Id: 22/31 Title: VFD Clock

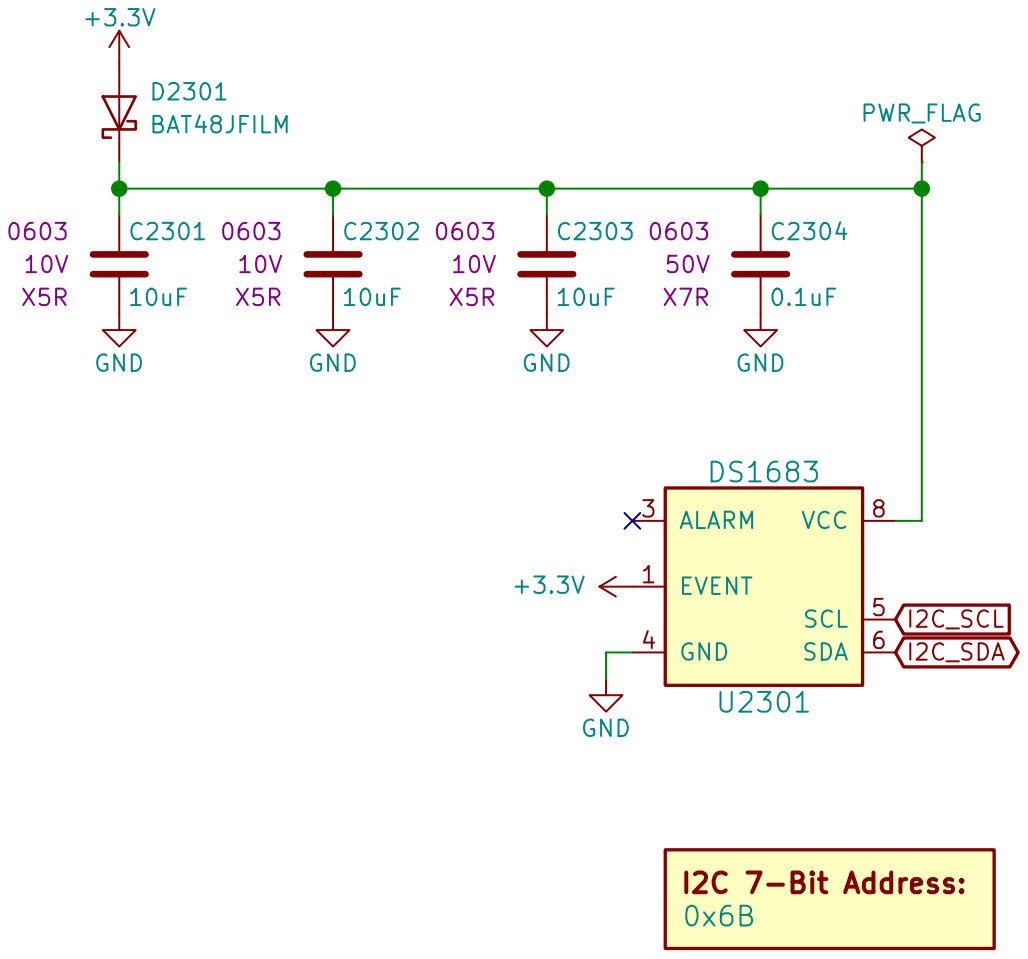
[picture p23: page 23]

Sheet: /Time of Flight/ Drew Maatman

File: Time_of_Flight.sch
Id: 23/31 Title: VFD Clock

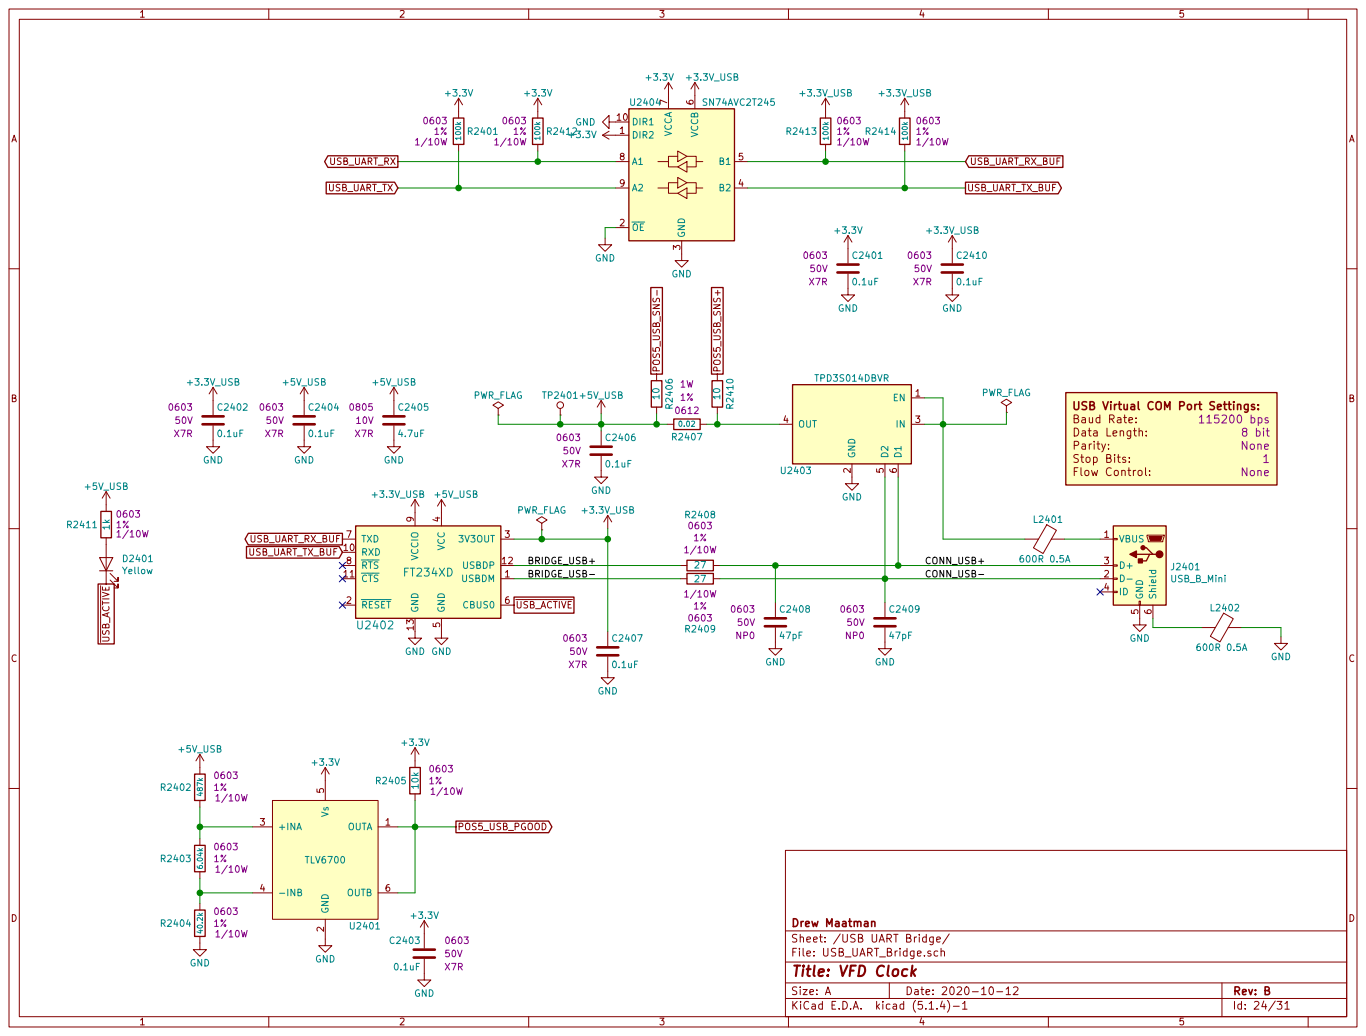
[picture p24: page 24]

USB Virtual COM Port Settings:
Baud Rate: Data Length:

Sheet: /USB UART Bridge/ Drew Maatman

File: USB_UART_Bridge.sch
Id: 24/31 Title: VFD Clock

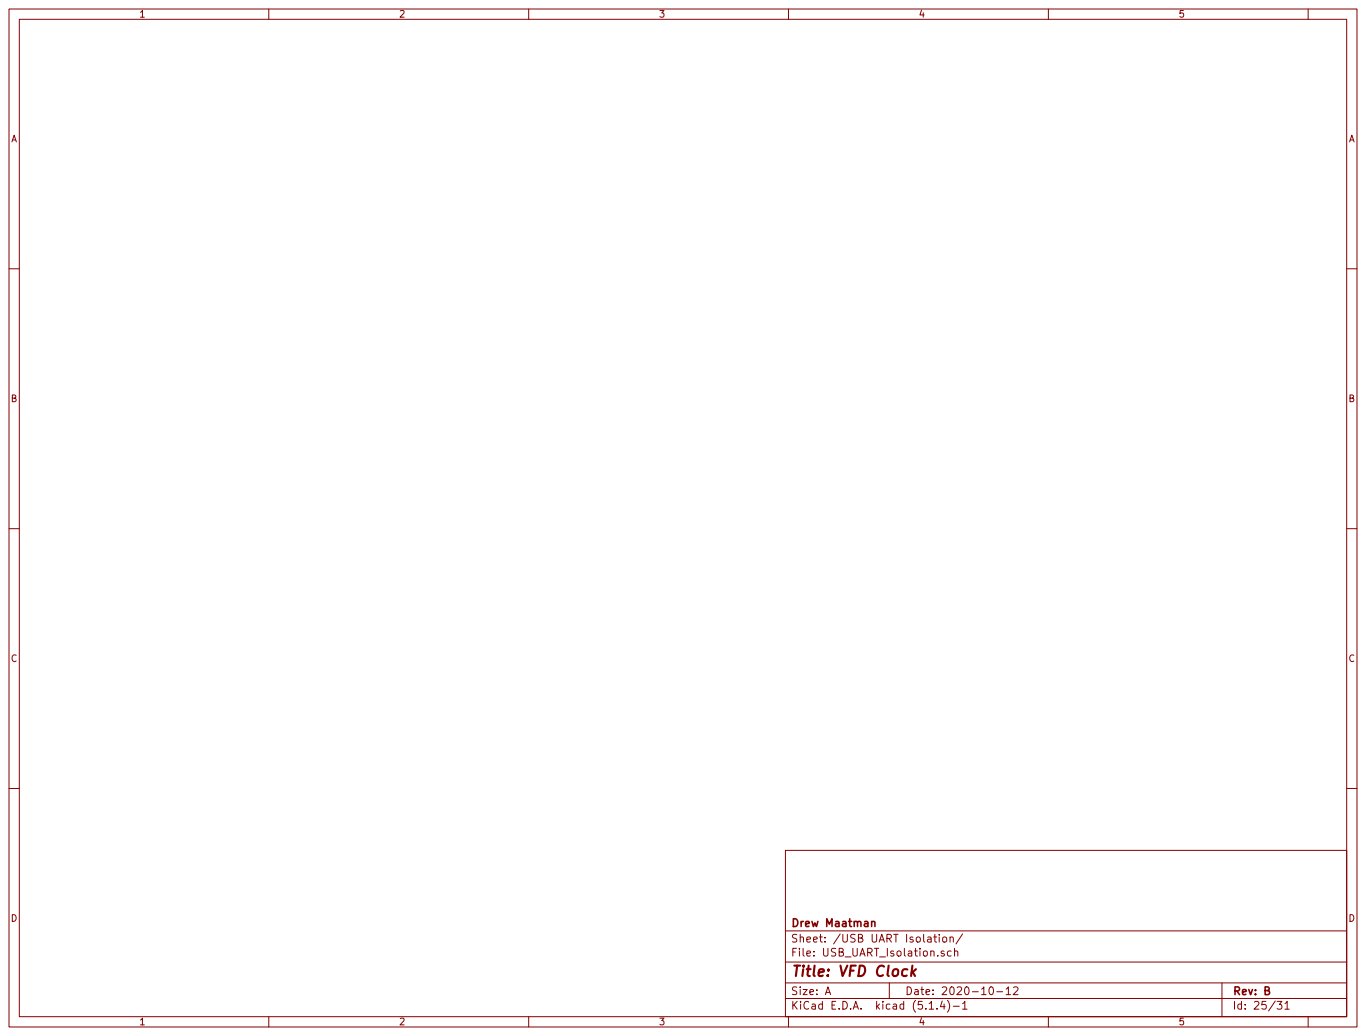
[picture p25: page 25]

File: USB_UART_Isolation.sch Sheet: /USB UART Isolation/ Drew Maatman

Id: 25/31 Title: VFD Clock

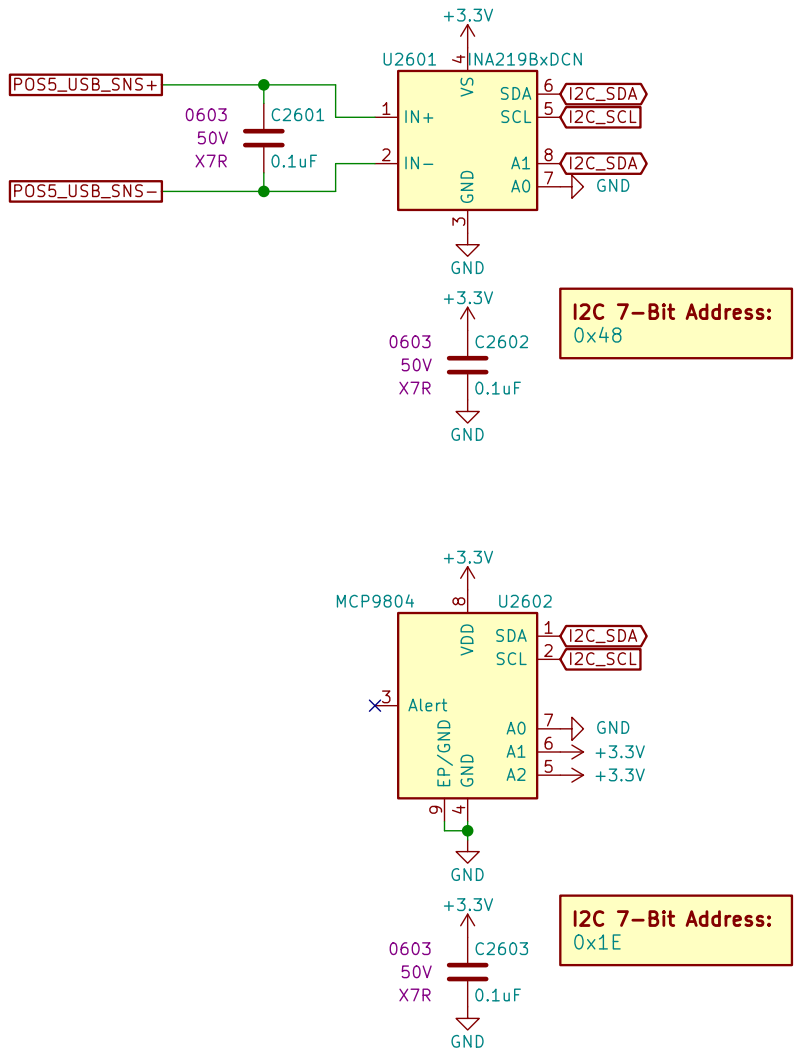
[picture p26: page 26]

File: USB_Telemetry.sch
Id: 26/31 Title: VFD Clock

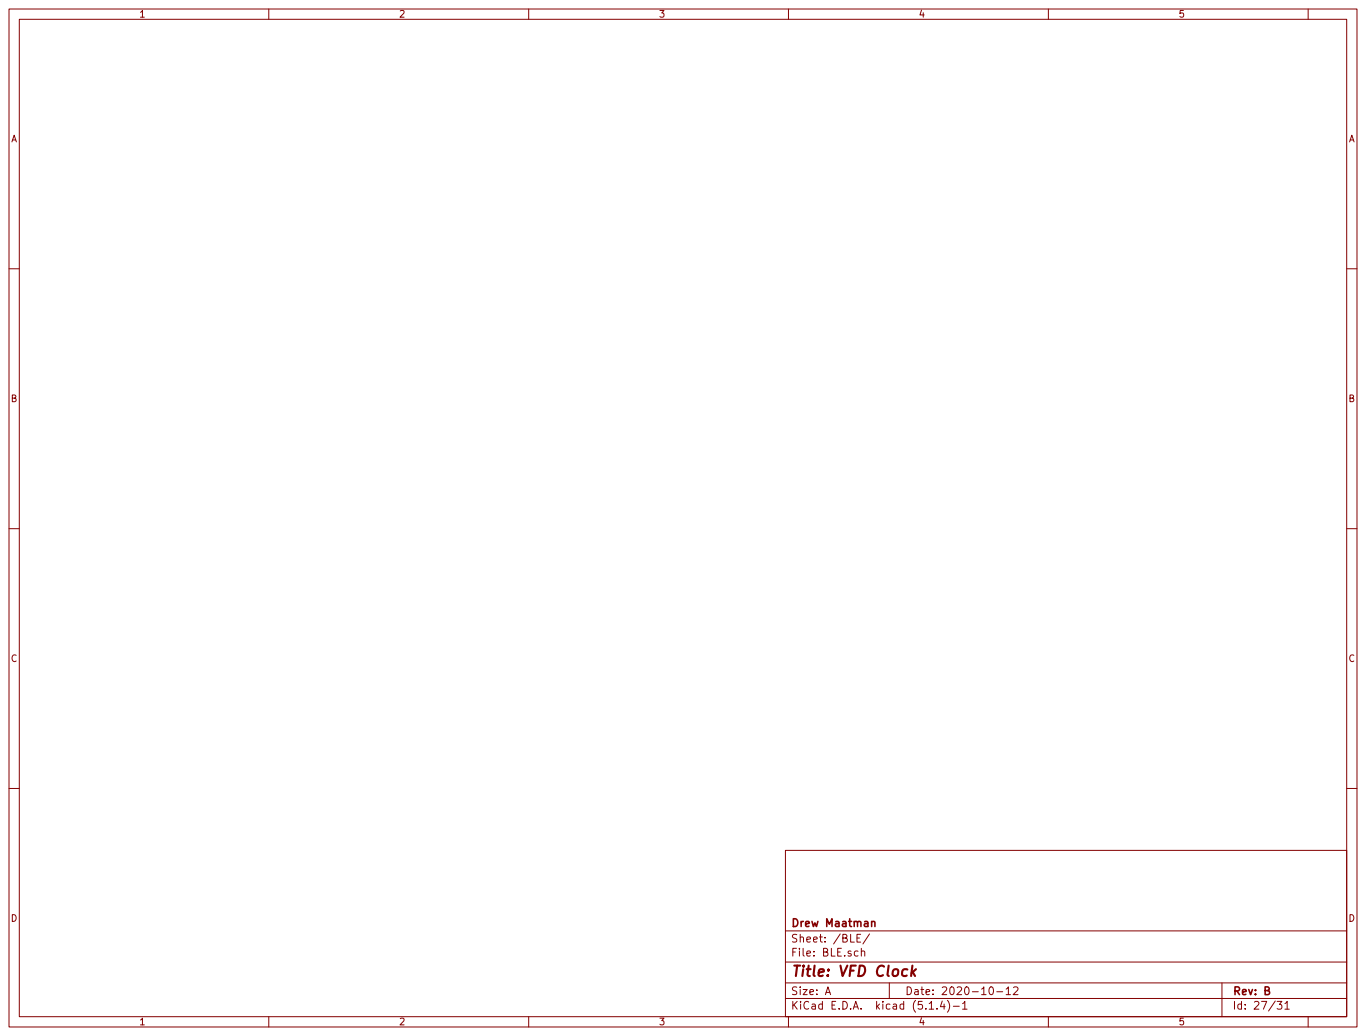
[picture p27: page 27]

File: BLE.sch Sheet: /BLE/ Drew Maatman

Id: 27/31 Title: VFD Clock

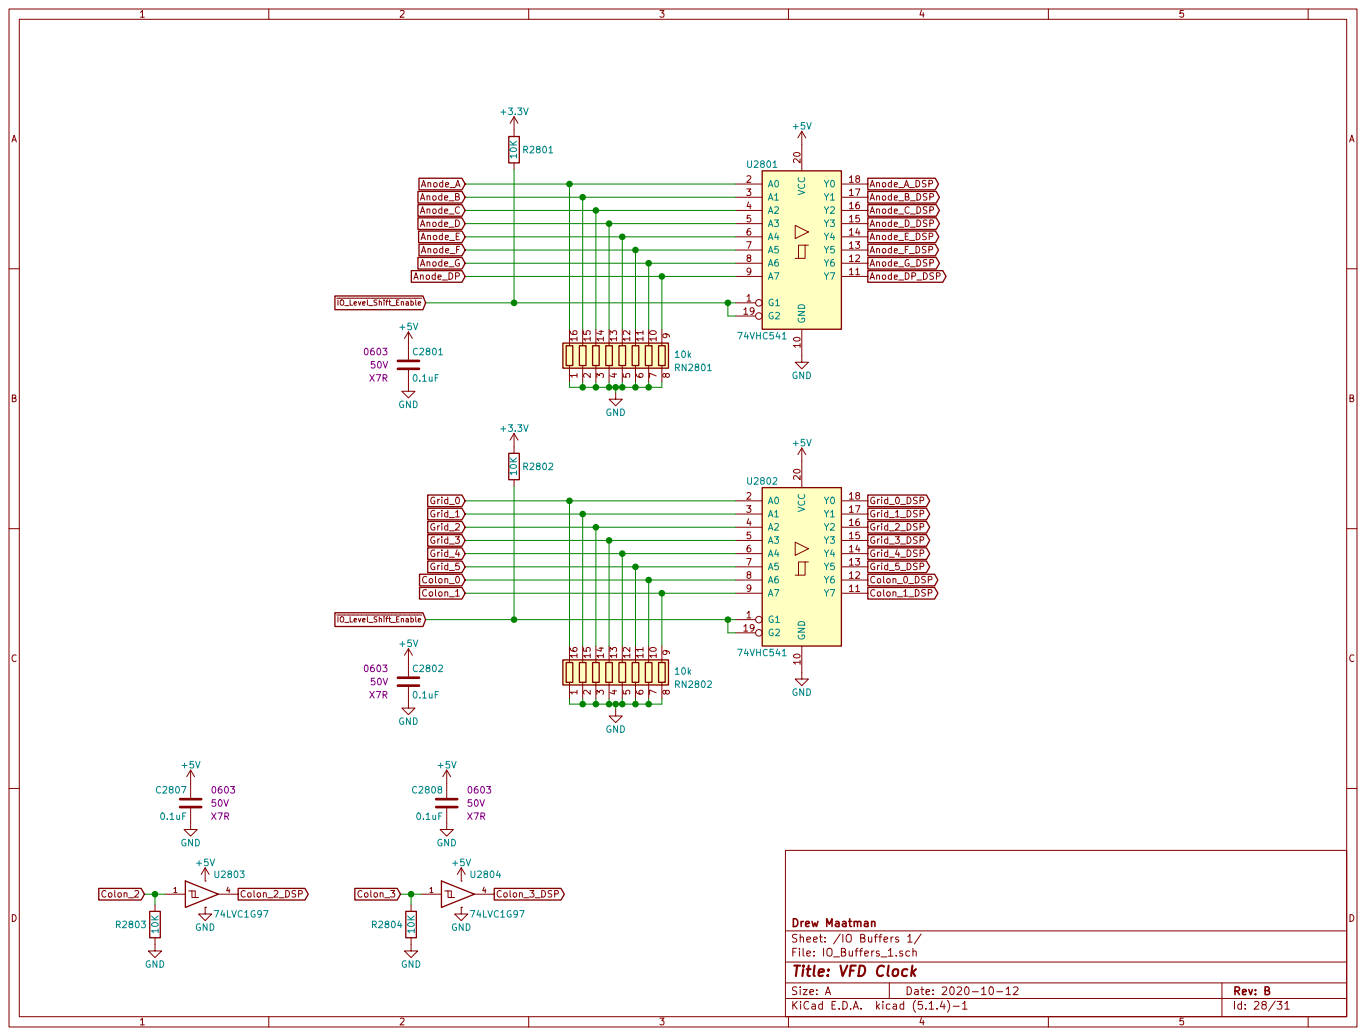
[picture p28: page 28]

File: IO_Buffers_1.sch Sheet: /IO Buffers 1/ Drew Maatman

Id: 28/31 Title: VFD Clock

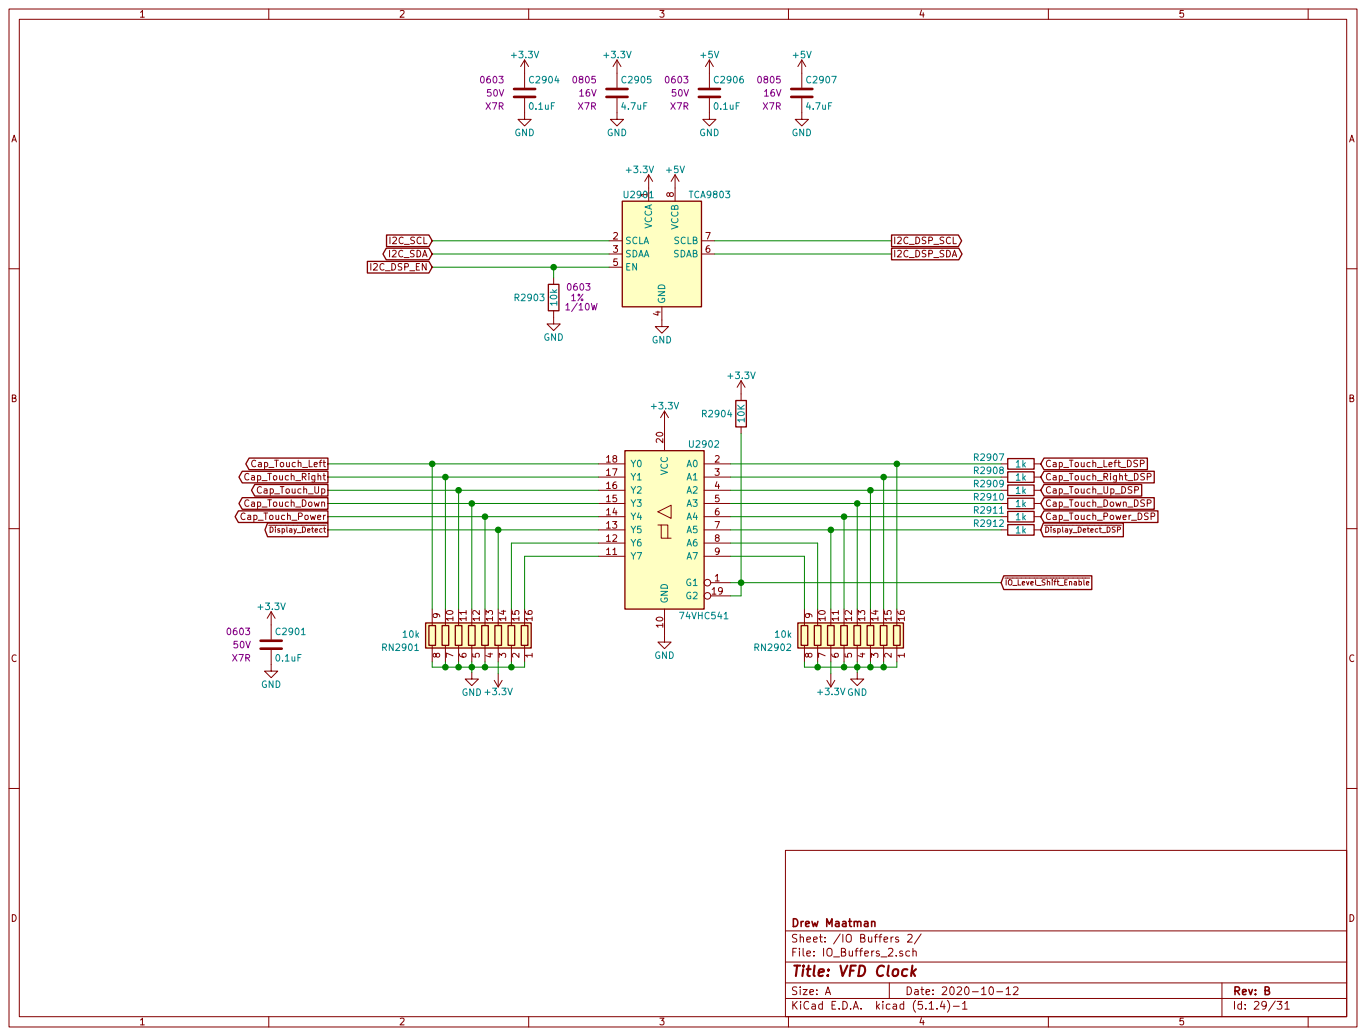
[picture p29: page 29]

4 EN 5 SDAB 6 SCLB 7 VCCB U2901 8TCA9803 GND

Id: 29/31 Title: VFD Clock

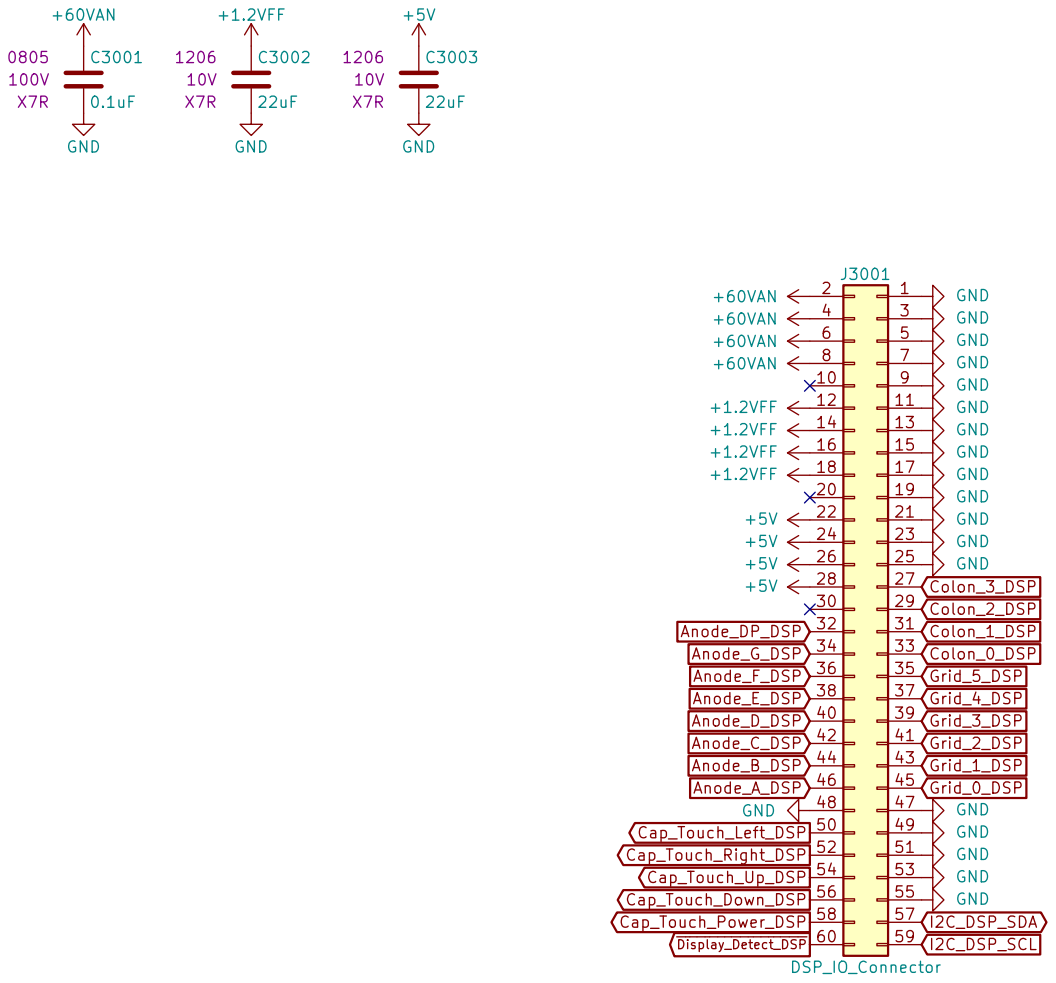
[picture p30: page 30]

File: IO_Connectors.sch Sheet: /IO Connectors/ Drew Maatman

Id: 30/31 Title: VFD Clock

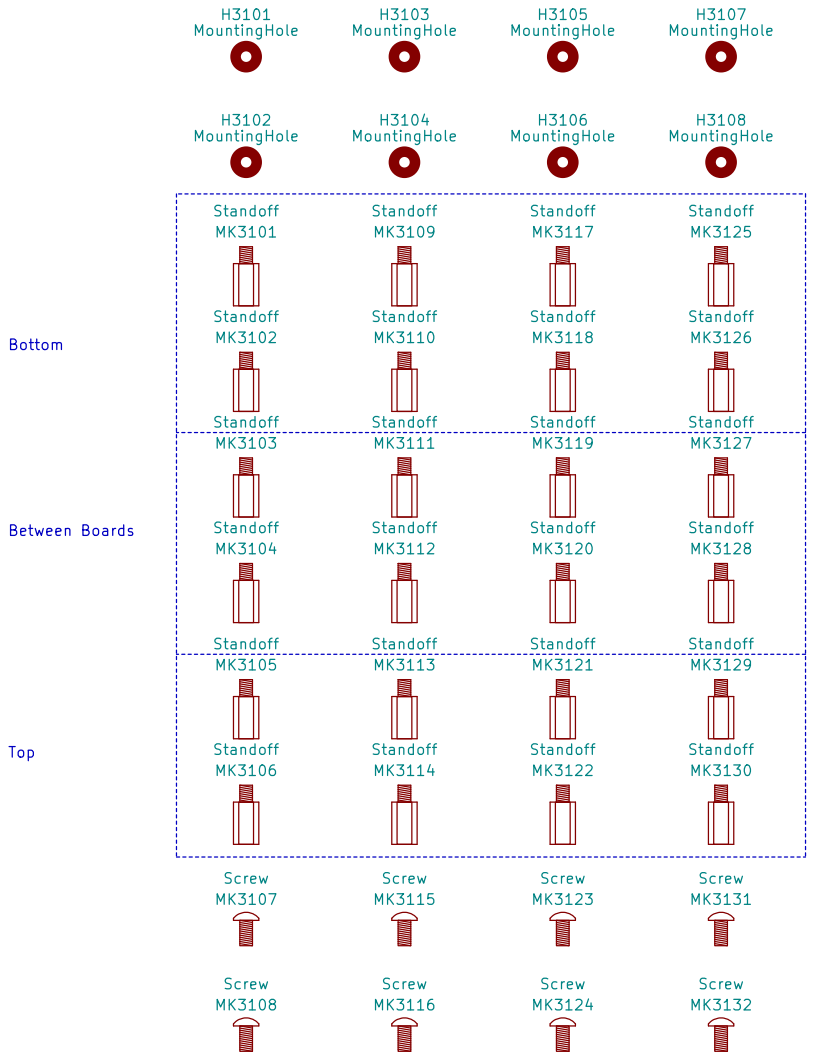
[picture p31: page 31]

Id: 31/31 Title: VFD Clock
