drewsum/VFD_Clock/rev_a/hdw/Display_Board/IV-6_Display_Board/IV-6_Display_Board.pdf

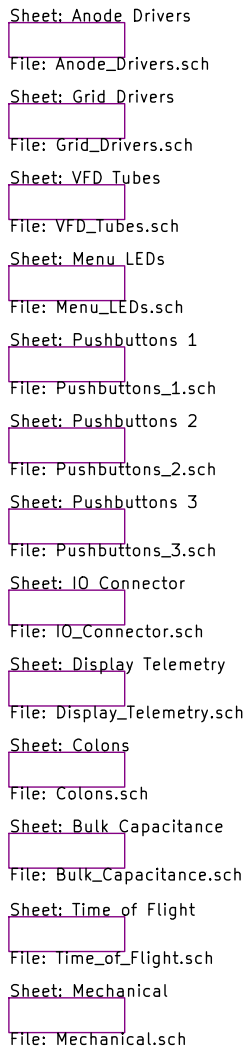
[picture p32: page 1]

Sheet: Anode Drivers File: Anode_Drivers.sch Sheet: Grid Drivers File: Grid_Drivers.sch Sheet: VFD Tubes File: VFD_Tubes.sch Sheet: Menu LEDs File: Menu_LEDs.sch Sheet: Pushbuttons 1 File: Pushbuttons_1.sch Sheet: IO Connector File: IO_Connector.sch Sheet: Pushbuttons 2 File: Pushbuttons_2.sch Sheet: Pushbuttons 3 File: Pushbuttons_3.sch Sheet: Display Telemetry

File: Display_Telemetry.sch Sheet: Colons File: Colons.sch Sheet: Bulk Capacitance

File: Bulk_Capacitance.sch
Sheet: Time of Flight

File: Time_of_Flight.sch Sheet: Mechanical File: Mechanical.sch

File: IV-6_Display_Board.sch Sheet: /

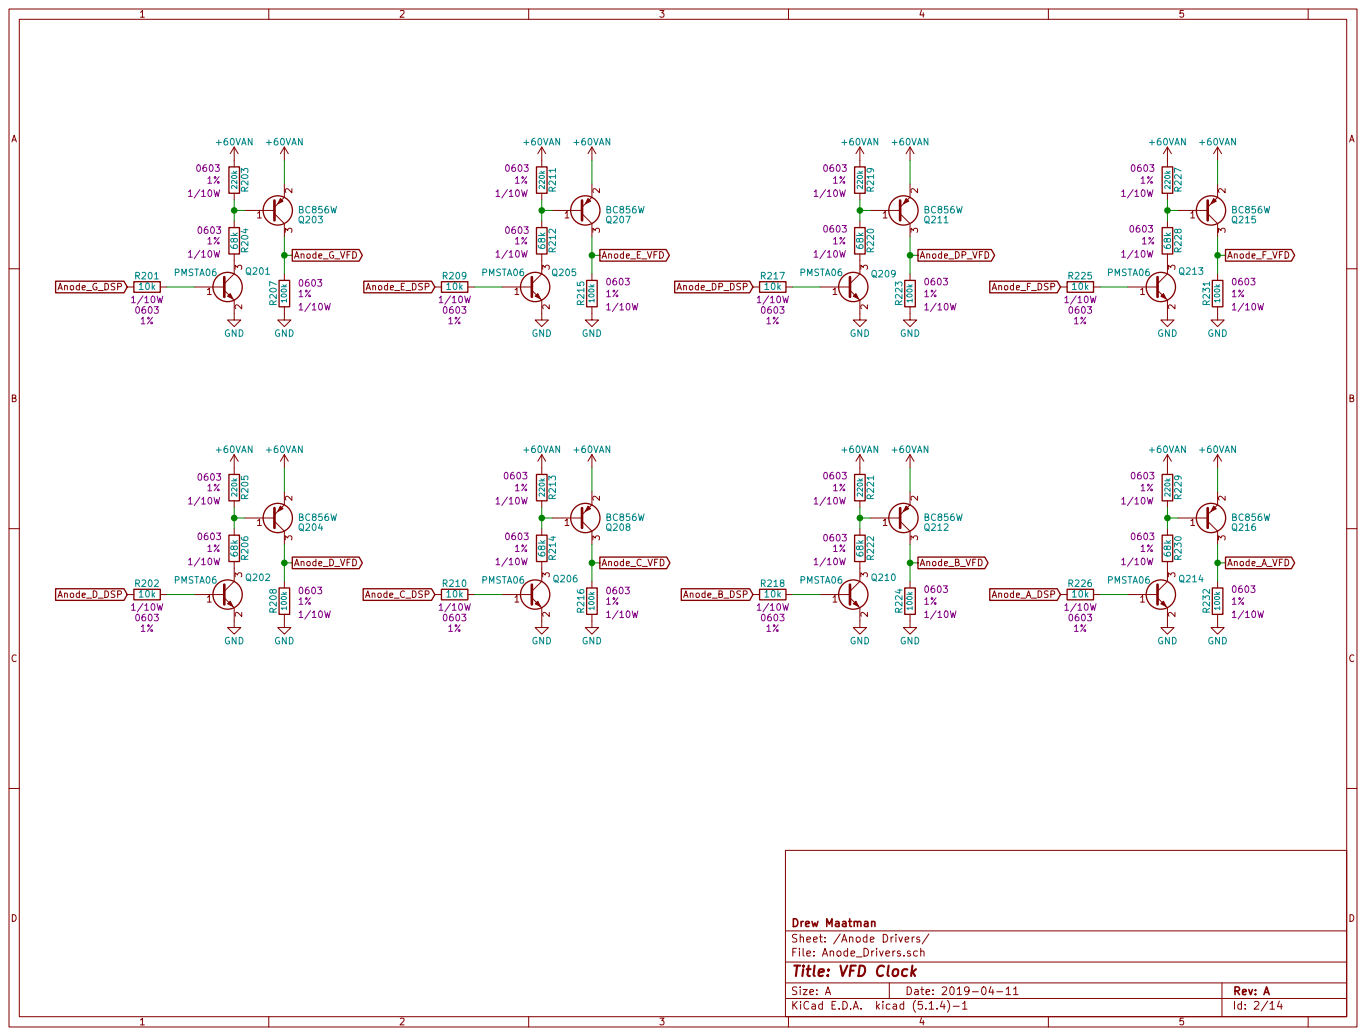
[picture p33: page 2]

2 3PMSTA06 Q209 GND GND GND GND

2 3PMSTA06 Q214 GND GND GND GND

Id: 2/14 Title: VFD Clock

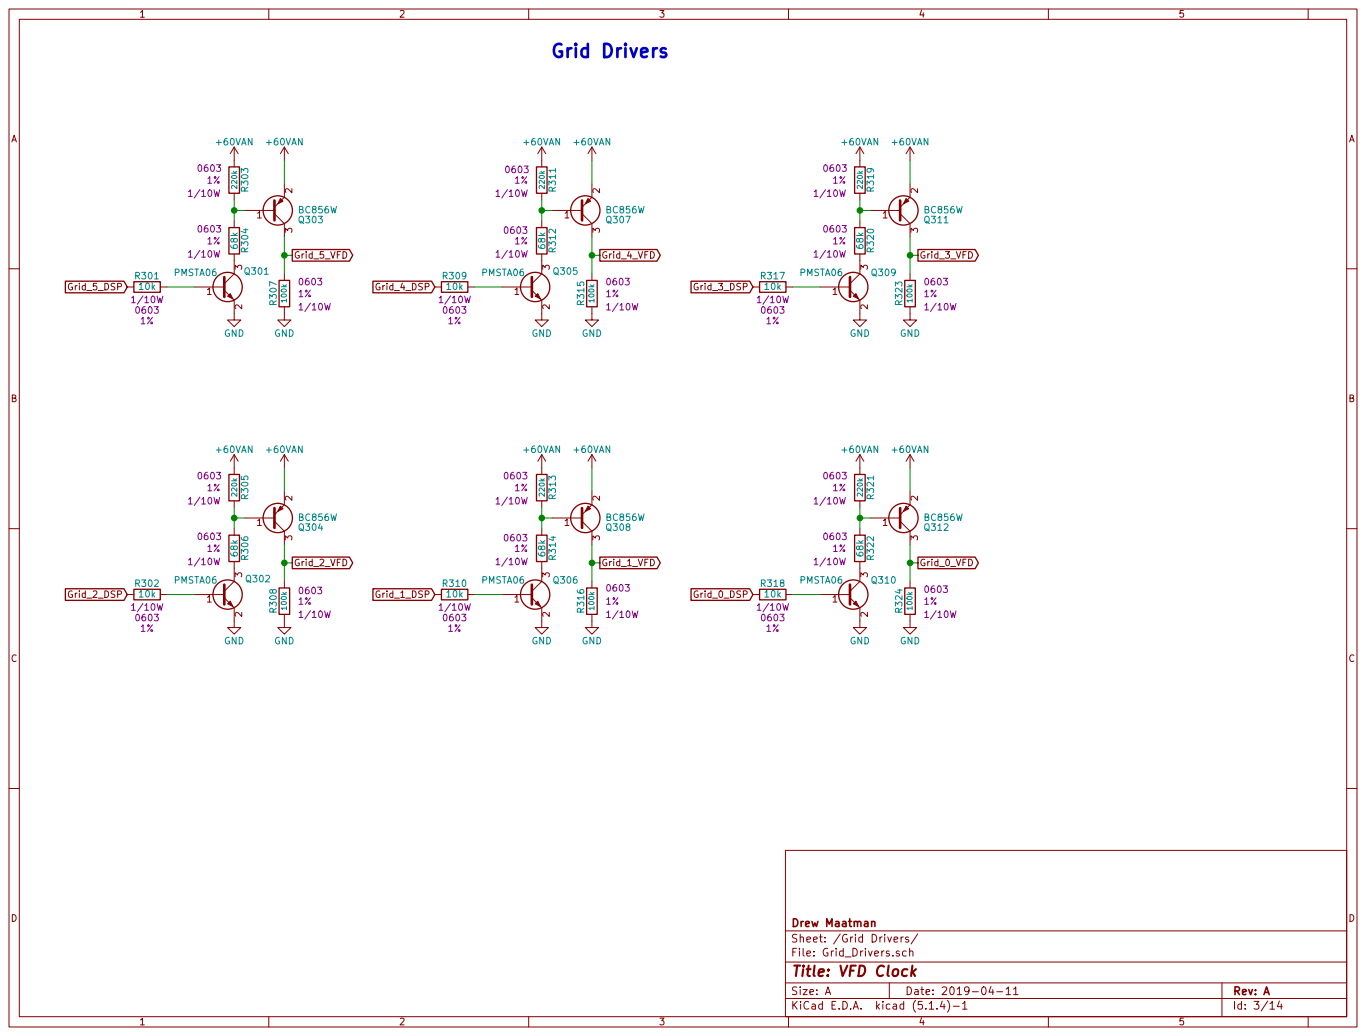
[picture p34: page 3]

File: Grid_Drivers.sch Sheet: /Grid Drivers/ Drew Maatman

Id: 3/14 Title: VFD Clock

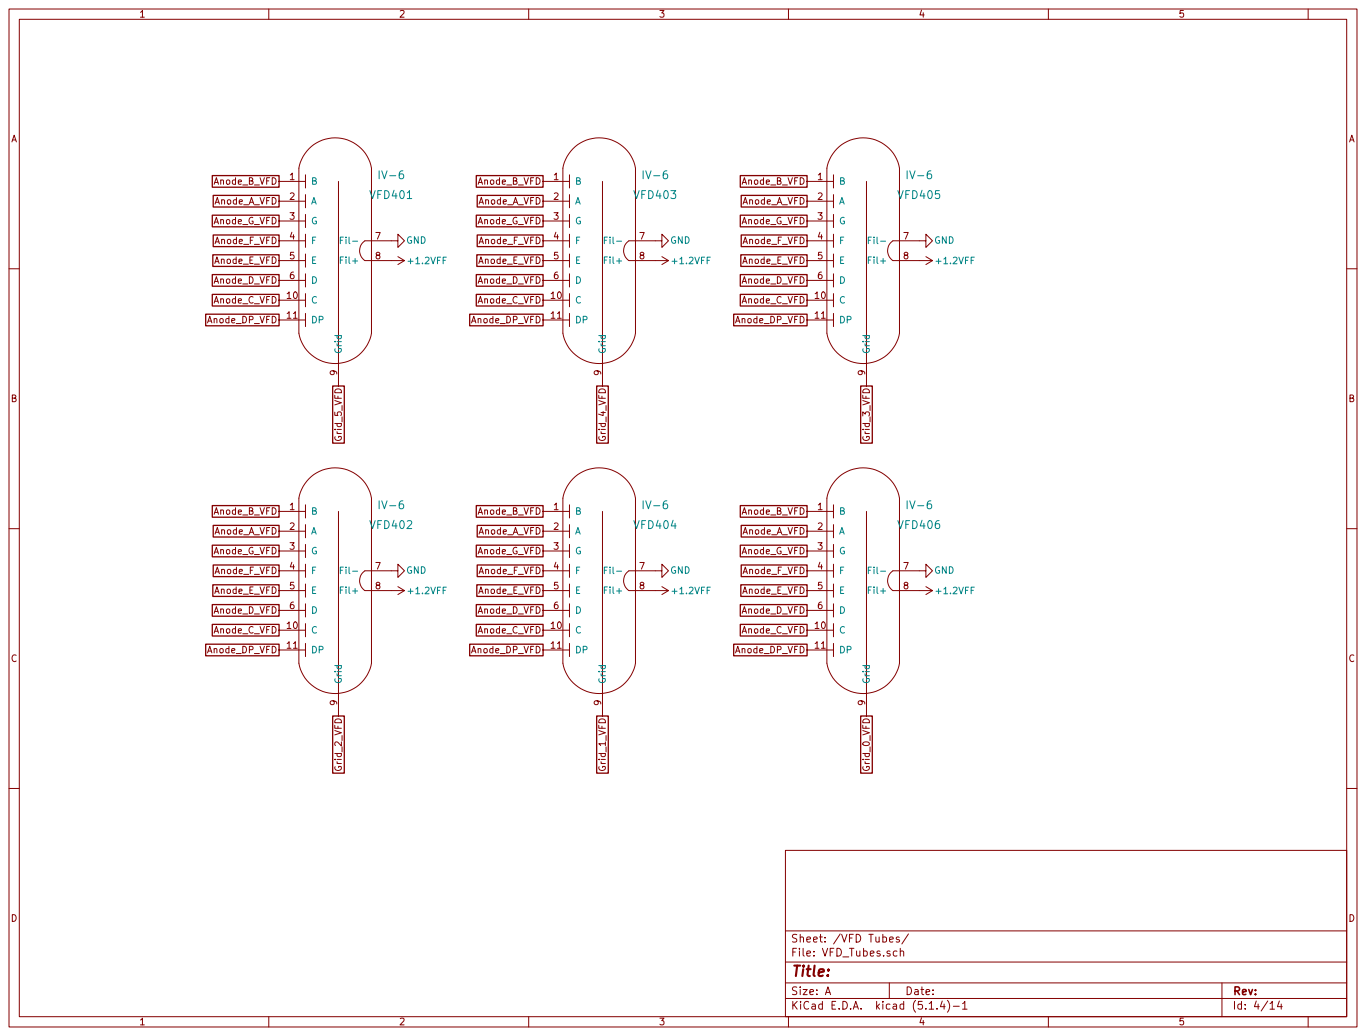
[picture p35: page 4]

File: VFD_Tubes.sch Sheet: /VFD Tubes/

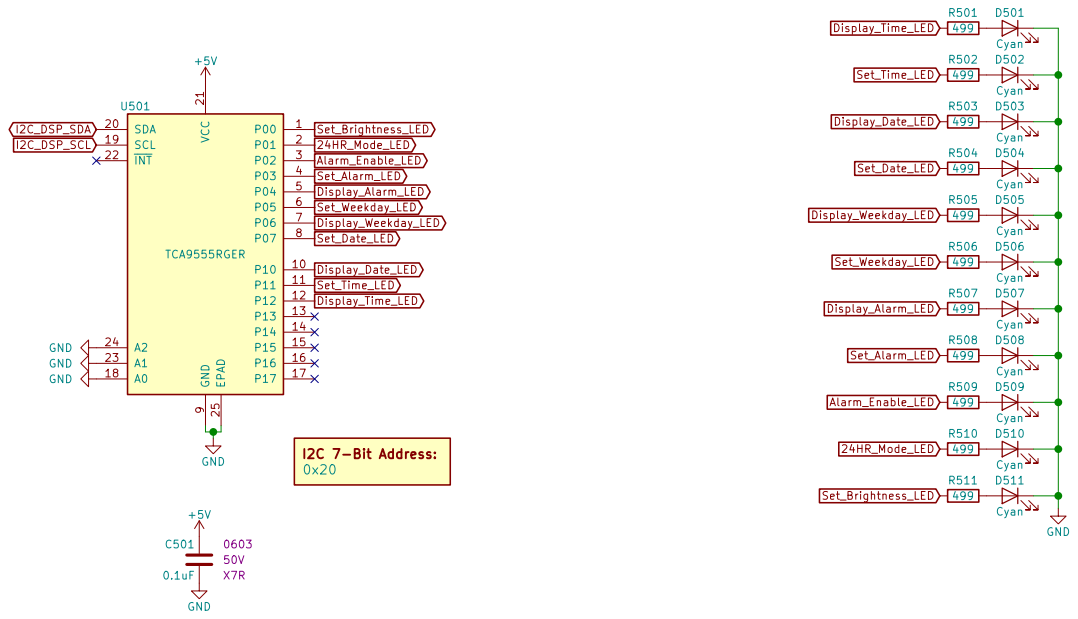
[picture p36: page 5]

File: Menu_LEDs.sch Sheet: /Menu LEDs/

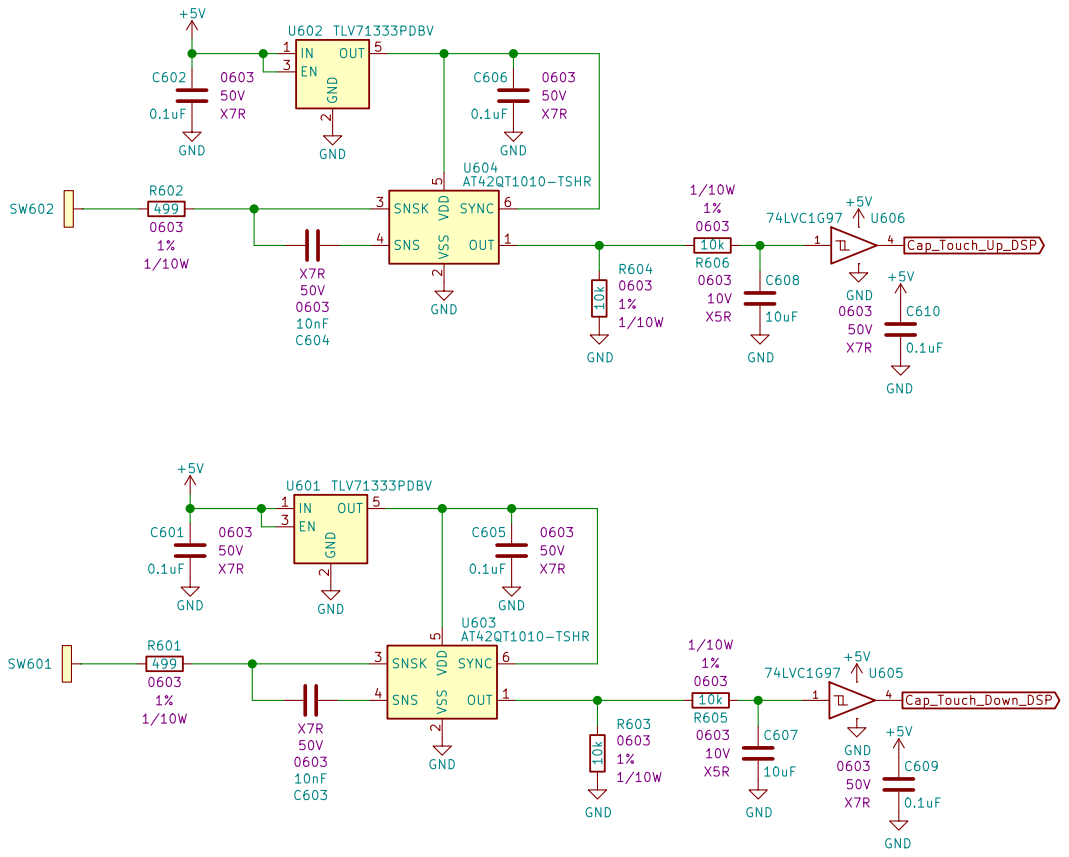
[picture p37: page 6]

File: Pushbuttons_1.sch Sheet: /Pushbuttons 1/ Drew Maatman C605

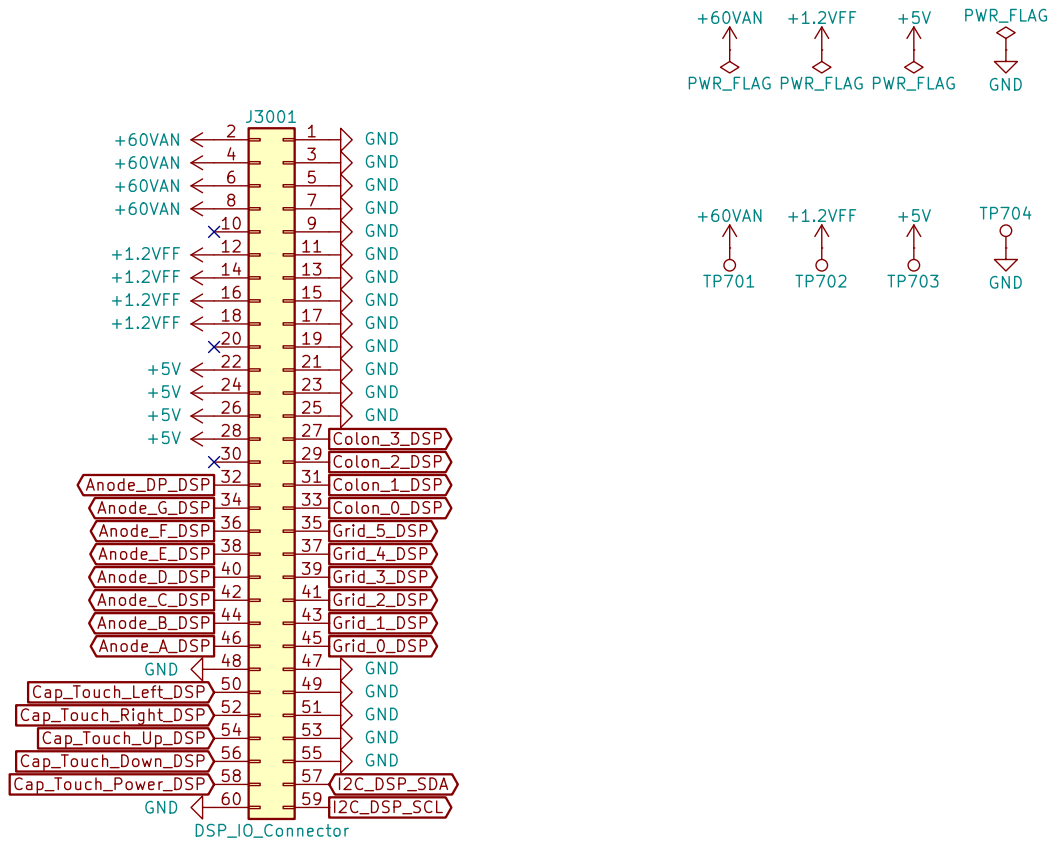
[picture p38: page 7]

File: IO_Connector.sch Sheet: /IO Connector/

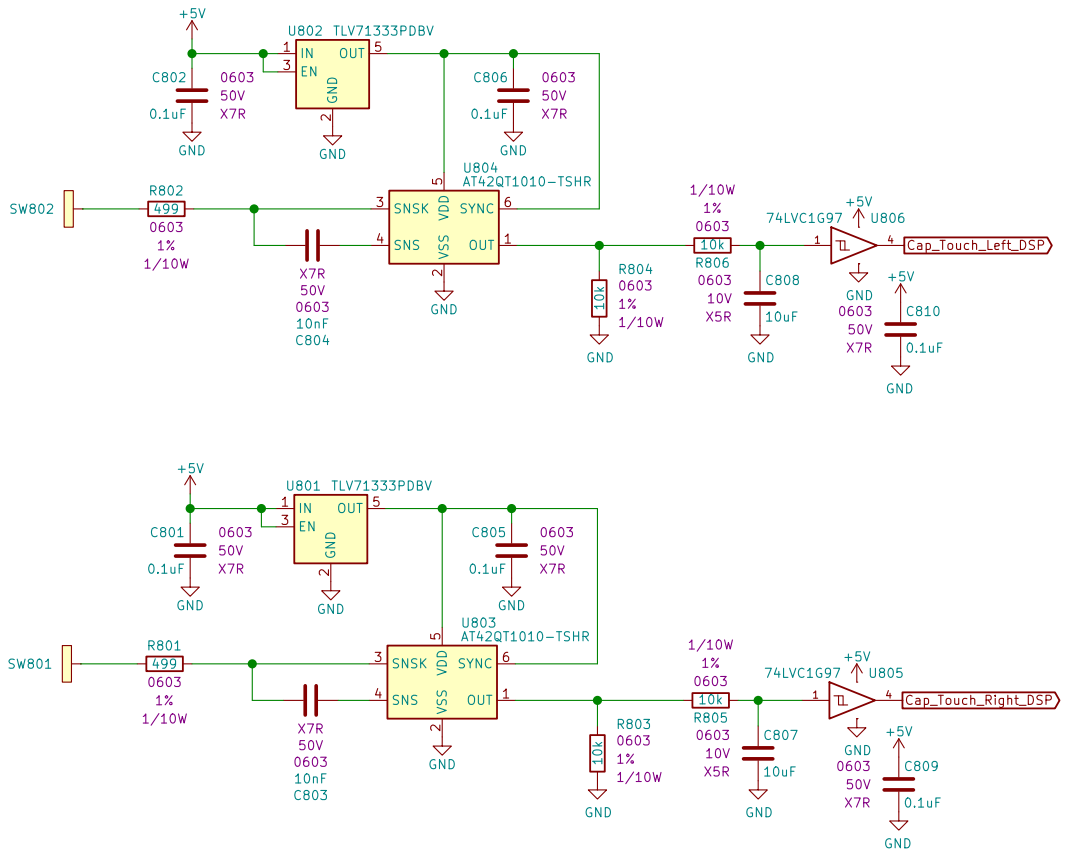
[picture p39: page 8]

File: Pushbuttons_2.sch Sheet: /Pushbuttons 2/ Drew Maatman C805

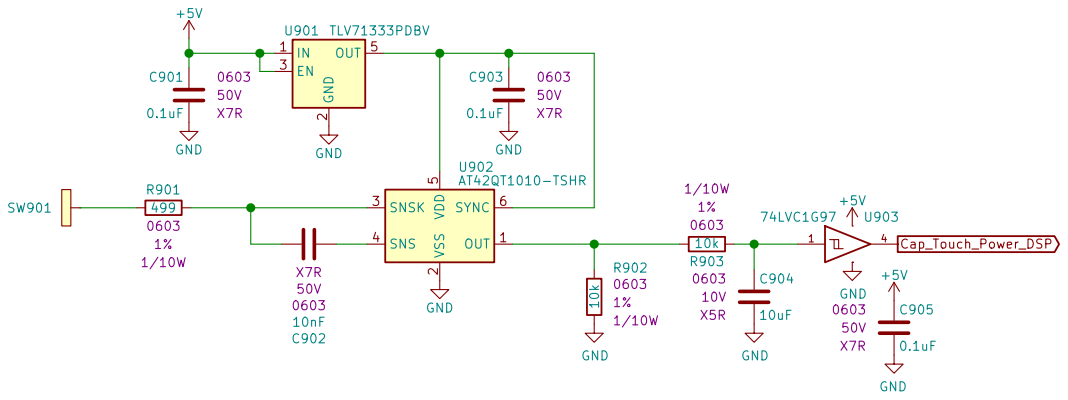
[picture p40: page 9]

File: Pushbuttons_3.sch Sheet: /Pushbuttons 3/ Drew Maatman

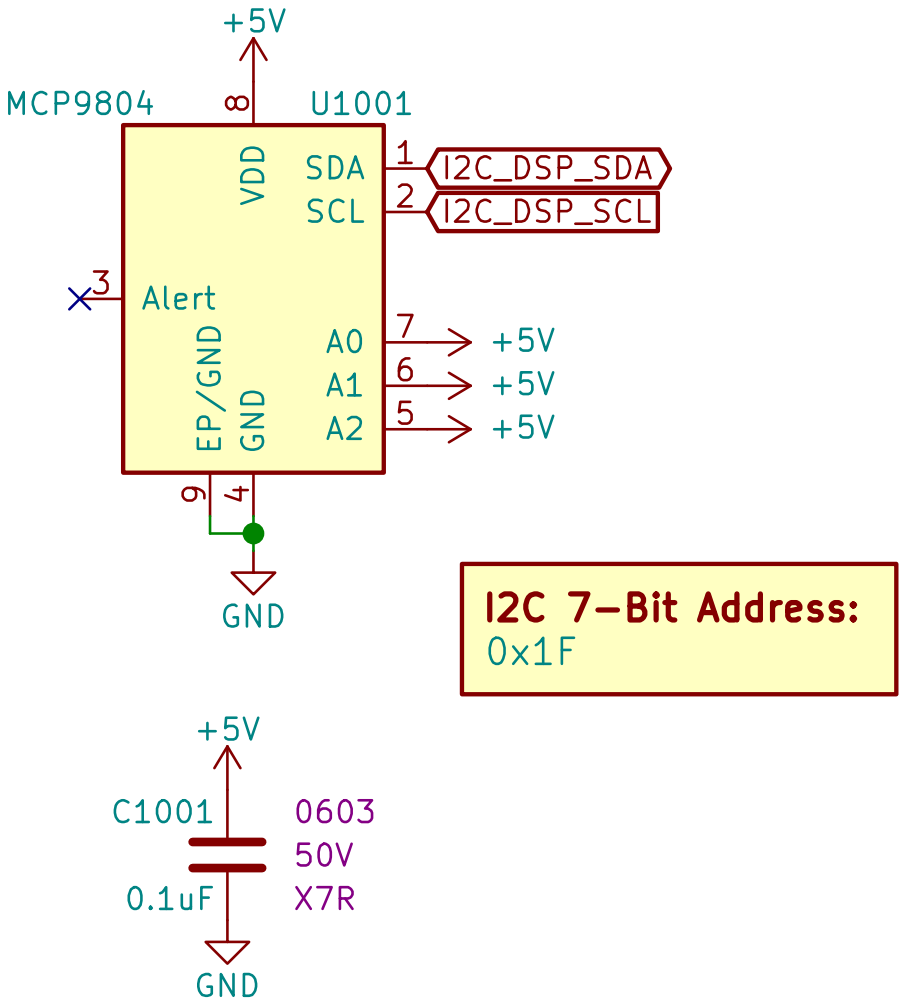
[picture p41: page 10]

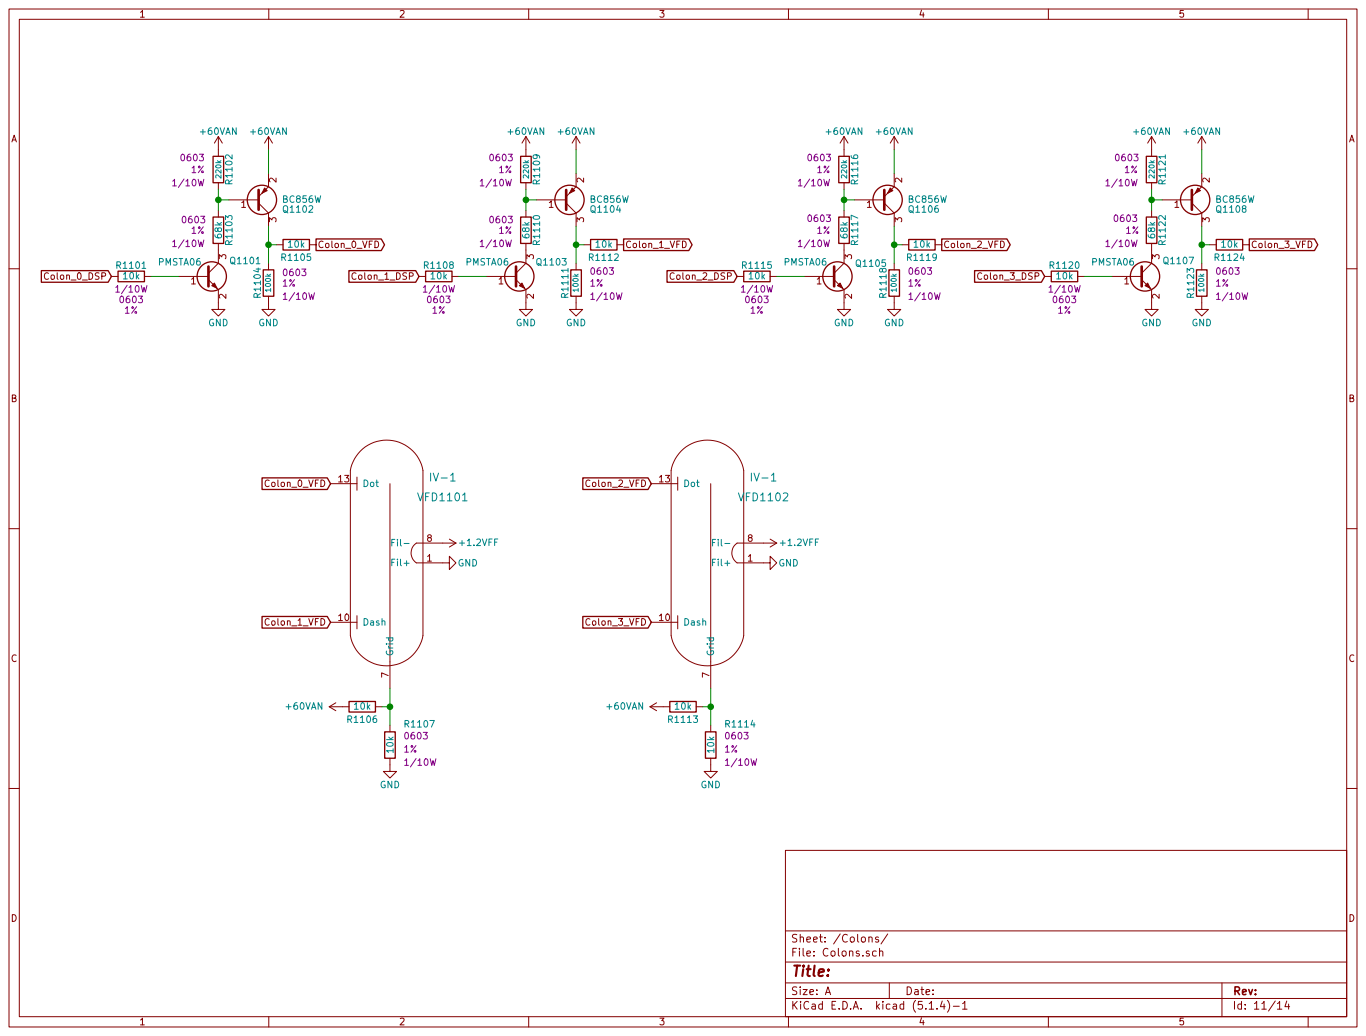
[picture p42: page 11]

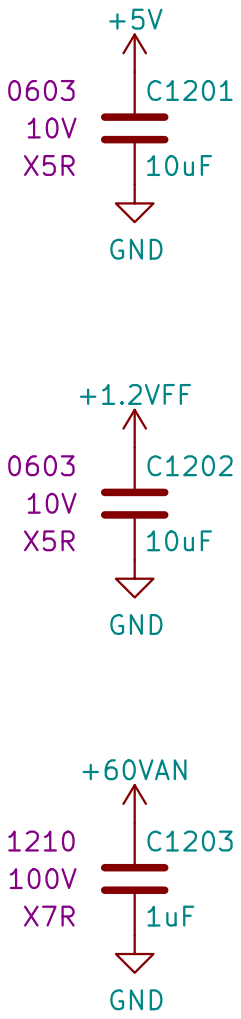
[picture p43: page 12]

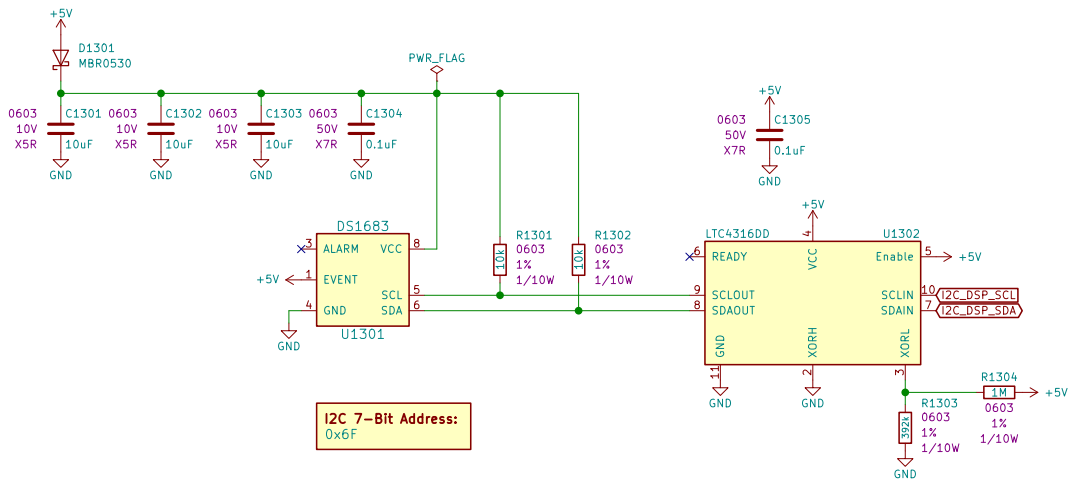
[picture p44: page 13]

4 Enable 5 READY 6 SDAIN 7 SDAOUT 8 SCLOUT 9

Sheet: /Time of Flight/
File: Time_of_Flight.sch
Id: 13/14 Title:

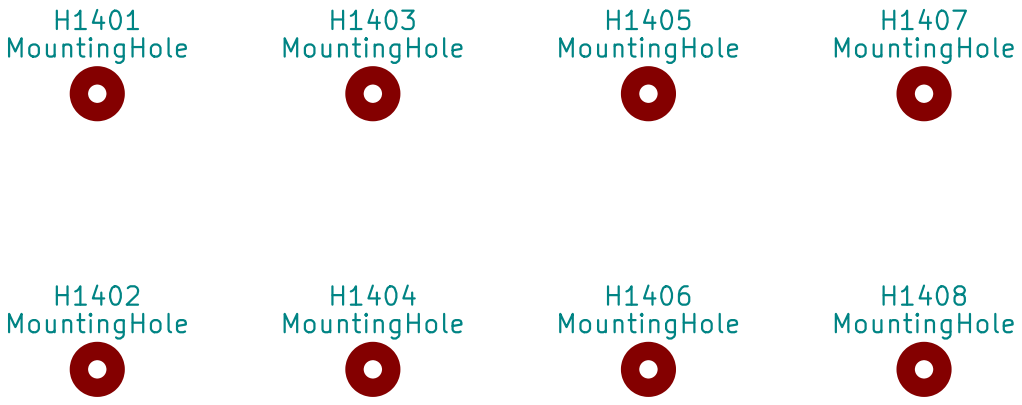
[picture p45: page 14]

Id: 14/14 Title: File: Mechanical.sch Sheet: /Mechanical/
