drewsum/VFD_Clock/(list of files, drawings)

Other design files:
rev_a/hdw/Display_Board/IV-6_Display_Board/IV-6_Display_Board.dsn
