drewsum/VFD_Clock/rev_a/hdw/Display_Board/IV-6_Display_Board/IV-6_Display_Board.kicad_pcb

## KiCad design rev_a/hdw/Display_Board/IV-6_Display_Board/IV-6_Display_Board.kicad_pcb (2020-03-08, an earlier design)

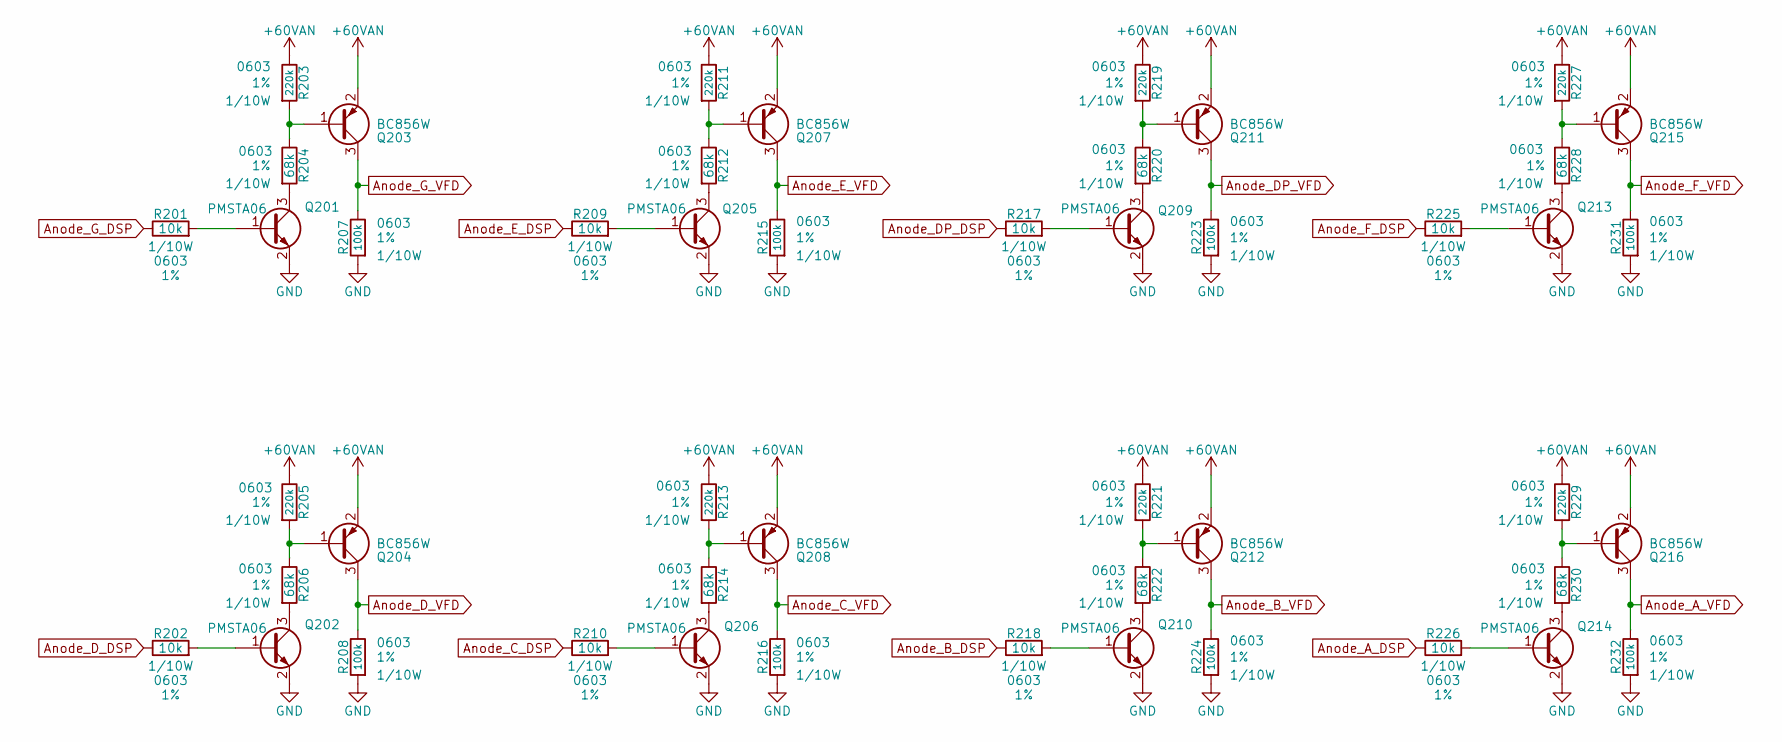
[picture p46: schematic Anode_Drivers.sch, VFD Clock]

Parts:
Q201, Q202, Q205, Q206, Q209, Q210, Q213, Q214: PMSTA06; SOT-323_SC-70; Digi-Key PN 1727-6293-1-ND
Q203, Q204, Q207, Q208, Q211, Q212, Q215, Q216: BC856W; SOT-323_SC-70; Digi-Key PN 1727-4865-1-ND
R201, R202, R209, R210, R217, R218, R225, R226: 10k; R_0603; Tolerance 1%; Digi-Key PN P10.0KHCT-ND
R203, R205, R211, R213, R219, R221, R227, R229: 220k; R_0603; Tolerance 1%; Digi-Key PN P220KHCT-ND
R204, R206, R212, R214, R220, R222, R228, R230: 68k; R_0603; Tolerance 1%; Digi-Key PN P68KDBCT-ND
R207, R208, R215, R216, R223, R224, R231, R232: 100k; R_0603; Tolerance 1%; Digi-Key PN P16019CT-ND

Connections:
+60VAN: Q203.2 (E), Q204.2 (E), Q207.2 (E), Q208.2 (E), Q211.2 (E), Q212.2 (E), Q215.2 (E), Q216.2 (E), R203.1, R205.1, R211.1, R213.1, R219.1, R221.1, R227.1, R229.1; also elsewhere on the board
Anode_A_DSP: R226.1; also elsewhere on the board
Anode_A_VFD: Q216.3 (C), R232.1; also elsewhere on the board
Anode_B_DSP: R218.1; also elsewhere on the board
Anode_B_VFD: Q212.3 (C), R224.1; also elsewhere on the board
Anode_C_DSP: R210.1; also elsewhere on the board
Anode_C_VFD: Q208.3 (C), R216.1; also elsewhere on the board
Anode_DP_DSP: R217.1; also elsewhere on the board
Anode_DP_VFD: Q211.3 (C), R223.1; also elsewhere on the board
Anode_D_DSP: R202.1; also elsewhere on the board
Anode_D_VFD: Q204.3 (C), R208.1; also elsewhere on the board
Anode_E_DSP: R209.1; also elsewhere on the board
Anode_E_VFD: Q207.3 (C), R215.1; also elsewhere on the board
Anode_F_DSP: R225.1; also elsewhere on the board
Anode_F_VFD: Q215.3 (C), R231.1; also elsewhere on the board
Anode_G_DSP: R201.1; also elsewhere on the board
Anode_G_VFD: Q203.3 (C), R207.1; also elsewhere on the board
GND: Q201.2 (E), Q202.2 (E), Q205.2 (E), Q206.2 (E), Q209.2 (E), Q210.2 (E), Q213.2 (E), Q214.2 (E), R207.2, R208.2, R215.2, R216.2, R223.2, R224.2, R231.2, R232.2; also elsewhere on the board
unnamed: Q201.1 (B), R201.2
unnamed: Q201.3 (C), R204.2
unnamed: Q202.1 (B), R202.2
unnamed: Q202.3 (C), R206.2
unnamed: Q203.1 (B), R203.2, R204.1
unnamed: Q204.1 (B), R205.2, R206.1
unnamed: Q205.1 (B), R209.2
unnamed: Q205.3 (C), R212.2
unnamed: Q206.1 (B), R210.2
unnamed: Q206.3 (C), R214.2
unnamed: Q207.1 (B), R211.2, R212.1
unnamed: Q208.1 (B), R213.2, R214.1
unnamed: Q209.1 (B), R217.2
unnamed: Q209.3 (C), R220.2
unnamed: Q210.1 (B), R218.2
unnamed: Q210.3 (C), R222.2
unnamed: Q211.1 (B), R219.2, R220.1
unnamed: Q212.1 (B), R221.2, R222.1
unnamed: Q213.1 (B), R225.2
unnamed: Q213.3 (C), R228.2
unnamed: Q214.1 (B), R226.2
unnamed: Q214.3 (C), R230.2
unnamed: Q215.1 (B), R227.2, R228.1
unnamed: Q216.1 (B), R229.2, R230.1

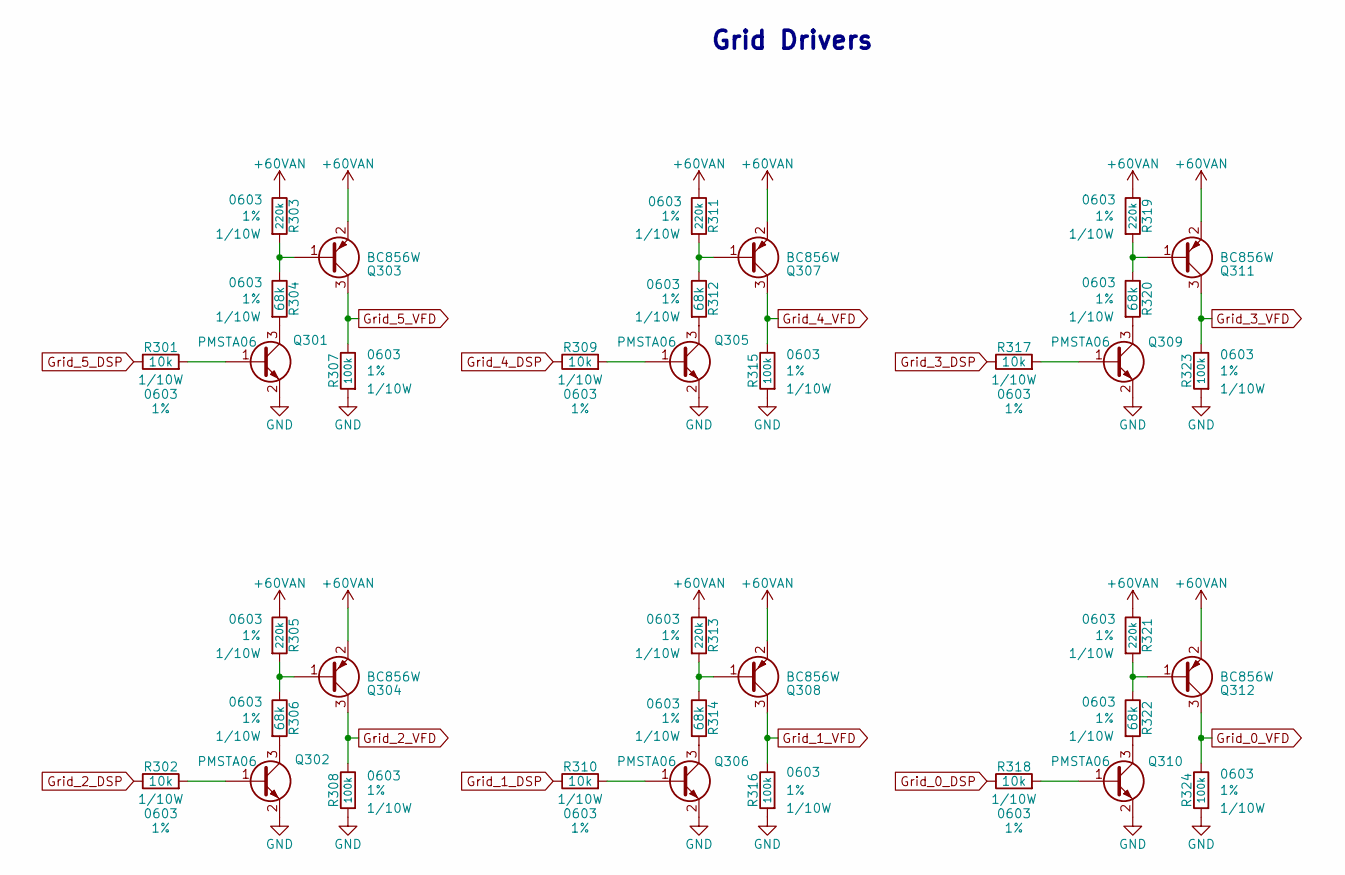
[picture p47: schematic Grid_Drivers.sch, VFD Clock]

Parts:
Q301, Q302, Q305, Q306, Q309, Q310: PMSTA06; SOT-323_SC-70; Digi-Key PN 1727-6293-1-ND
Q303, Q304, Q307, Q308, Q311, Q312: BC856W; SOT-323_SC-70; Digi-Key PN 1727-4865-1-ND
R301, R302, R309, R310, R317, R318: 10k; R_0603; Tolerance 1%; Digi-Key PN P10.0KHCT-ND
R303, R305, R311, R313, R319, R321: 220k; R_0603; Tolerance 1%; Digi-Key PN P220KHCT-ND
R304, R306, R312, R314, R320, R322: 68k; R_0603; Tolerance 1%; Digi-Key PN P68KDBCT-ND
R307, R308, R315, R316, R323, R324: 100k; R_0603; Tolerance 1%; Digi-Key PN P16019CT-ND

Connections:
+60VAN: Q303.2 (E), Q304.2 (E), Q307.2 (E), Q308.2 (E), Q311.2 (E), Q312.2 (E), R303.1, R305.1, R311.1, R313.1, R319.1, R321.1; also elsewhere on the board
GND: Q301.2 (E), Q302.2 (E), Q305.2 (E), Q306.2 (E), Q309.2 (E), Q310.2 (E), R307.2, R308.2, R315.2, R316.2, R323.2, R324.2; also elsewhere on the board
Grid_0_DSP: R318.1; also elsewhere on the board
Grid_0_VFD: Q312.3 (C), R324.1; also elsewhere on the board
Grid_1_DSP: R310.1; also elsewhere on the board
Grid_1_VFD: Q308.3 (C), R316.1; also elsewhere on the board
Grid_2_DSP: R302.1; also elsewhere on the board
Grid_2_VFD: Q304.3 (C), R308.1; also elsewhere on the board
Grid_3_DSP: R317.1; also elsewhere on the board
Grid_3_VFD: Q311.3 (C), R323.1; also elsewhere on the board
Grid_4_DSP: R309.1; also elsewhere on the board
Grid_4_VFD: Q307.3 (C), R315.1; also elsewhere on the board
Grid_5_DSP: R301.1; also elsewhere on the board
Grid_5_VFD: Q303.3 (C), R307.1; also elsewhere on the board
unnamed: Q301.1 (B), R301.2
unnamed: Q301.3 (C), R304.2
unnamed: Q302.1 (B), R302.2
unnamed: Q302.3 (C), R306.2
unnamed: Q303.1 (B), R303.2, R304.1
unnamed: Q304.1 (B), R305.2, R306.1
unnamed: Q305.1 (B), R309.2
unnamed: Q305.3 (C), R312.2
unnamed: Q306.1 (B), R310.2
unnamed: Q306.3 (C), R314.2
unnamed: Q307.1 (B), R311.2, R312.1
unnamed: Q308.1 (B), R313.2, R314.1
unnamed: Q309.1 (B), R317.2
unnamed: Q309.3 (C), R320.2
unnamed: Q310.1 (B), R318.2
unnamed: Q310.3 (C), R322.2
unnamed: Q311.1 (B), R319.2, R320.1
unnamed: Q312.1 (B), R321.2, R322.1

Notes on the sheet:
Grid Drivers

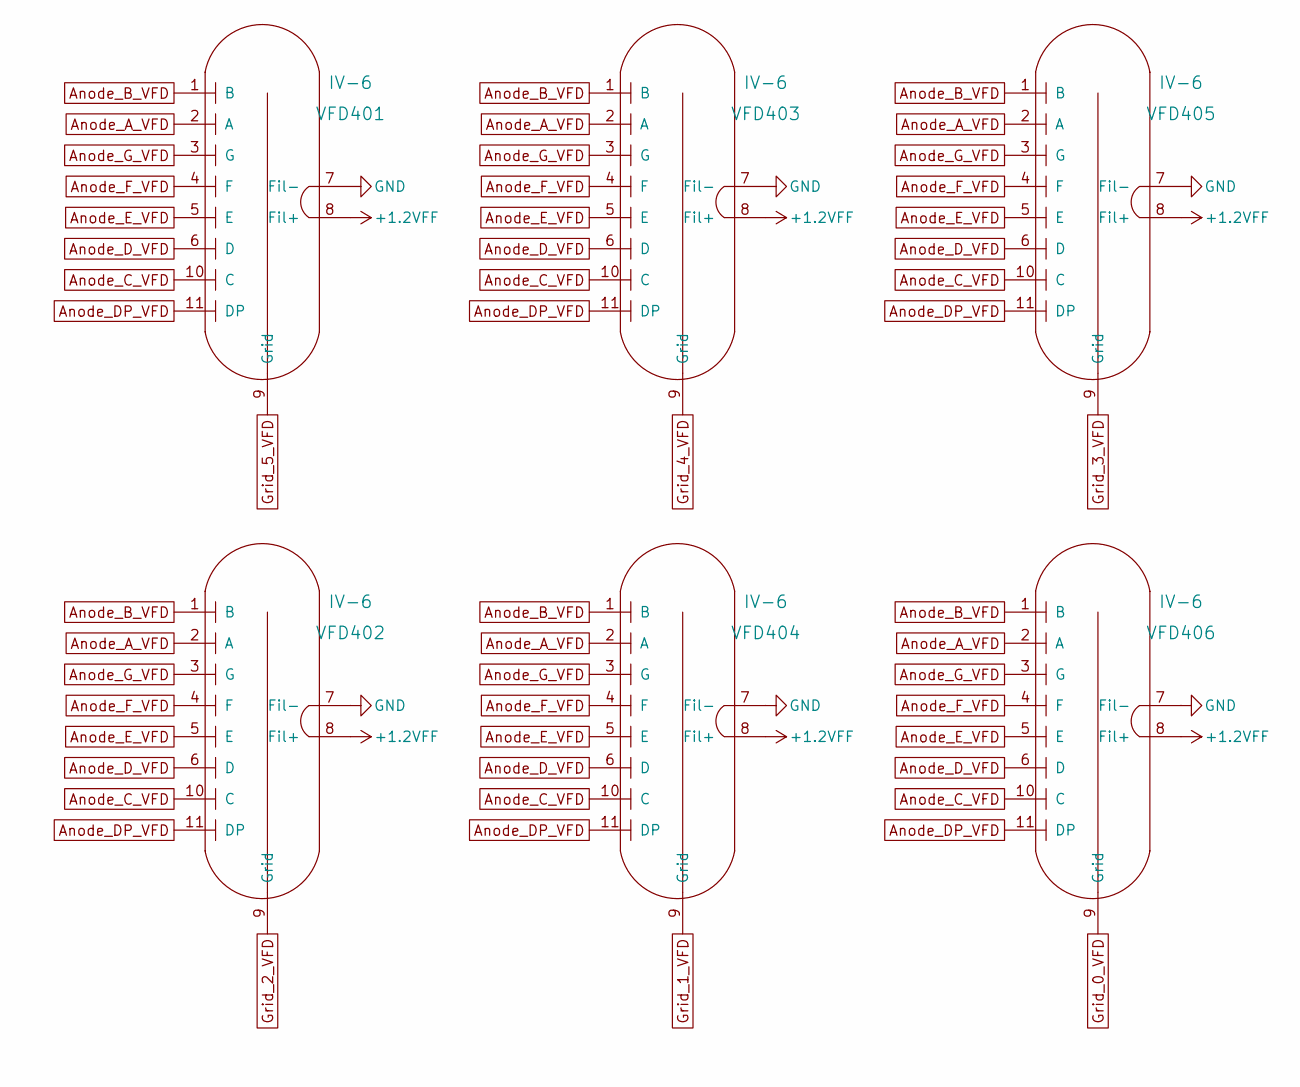
[picture p48: schematic VFD_Tubes.sch]

Parts:
VFD401, VFD402, VFD403, VFD404, VFD405, VFD406: IV-6

Connections:
+1.2VFF: VFD401.8 (Fil+), VFD402.8 (Fil+), VFD403.8 (Fil+), VFD404.8 (Fil+), VFD405.8 (Fil+), VFD406.8 (Fil+); also elsewhere on the board
Anode_A_VFD: VFD401.2 (A), VFD402.2 (A), VFD403.2 (A), VFD404.2 (A), VFD405.2 (A), VFD406.2 (A); also elsewhere on the board
Anode_B_VFD: VFD401.1 (B), VFD402.1 (B), VFD403.1 (B), VFD404.1 (B), VFD405.1 (B), VFD406.1 (B); also elsewhere on the board
Anode_C_VFD: VFD401.10 (C), VFD402.10 (C), VFD403.10 (C), VFD404.10 (C), VFD405.10 (C), VFD406.10 (C); also elsewhere on the board
Anode_DP_VFD: VFD401.11 (DP), VFD402.11 (DP), VFD403.11 (DP), VFD404.11 (DP), VFD405.11 (DP), VFD406.11 (DP); also elsewhere on the board
Anode_D_VFD: VFD401.6 (D), VFD402.6 (D), VFD403.6 (D), VFD404.6 (D), VFD405.6 (D), VFD406.6 (D); also elsewhere on the board
Anode_E_VFD: VFD401.5 (E), VFD402.5 (E), VFD403.5 (E), VFD404.5 (E), VFD405.5 (E), VFD406.5 (E); also elsewhere on the board
Anode_F_VFD: VFD401.4 (F), VFD402.4 (F), VFD403.4 (F), VFD404.4 (F), VFD405.4 (F), VFD406.4 (F); also elsewhere on the board
Anode_G_VFD: VFD401.3 (G), VFD402.3 (G), VFD403.3 (G), VFD404.3 (G), VFD405.3 (G), VFD406.3 (G); also elsewhere on the board
GND: VFD401.7 (Fil-), VFD402.7 (Fil-), VFD403.7 (Fil-), VFD404.7 (Fil-), VFD405.7 (Fil-), VFD406.7 (Fil-); also elsewhere on the board
Grid_0_VFD: VFD406.9 (Grid); also elsewhere on the board
Grid_1_VFD: VFD404.9 (Grid); also elsewhere on the board
Grid_2_VFD: VFD402.9 (Grid); also elsewhere on the board
Grid_3_VFD: VFD405.9 (Grid); also elsewhere on the board
Grid_4_VFD: VFD403.9 (Grid); also elsewhere on the board
Grid_5_VFD: VFD401.9 (Grid); also elsewhere on the board

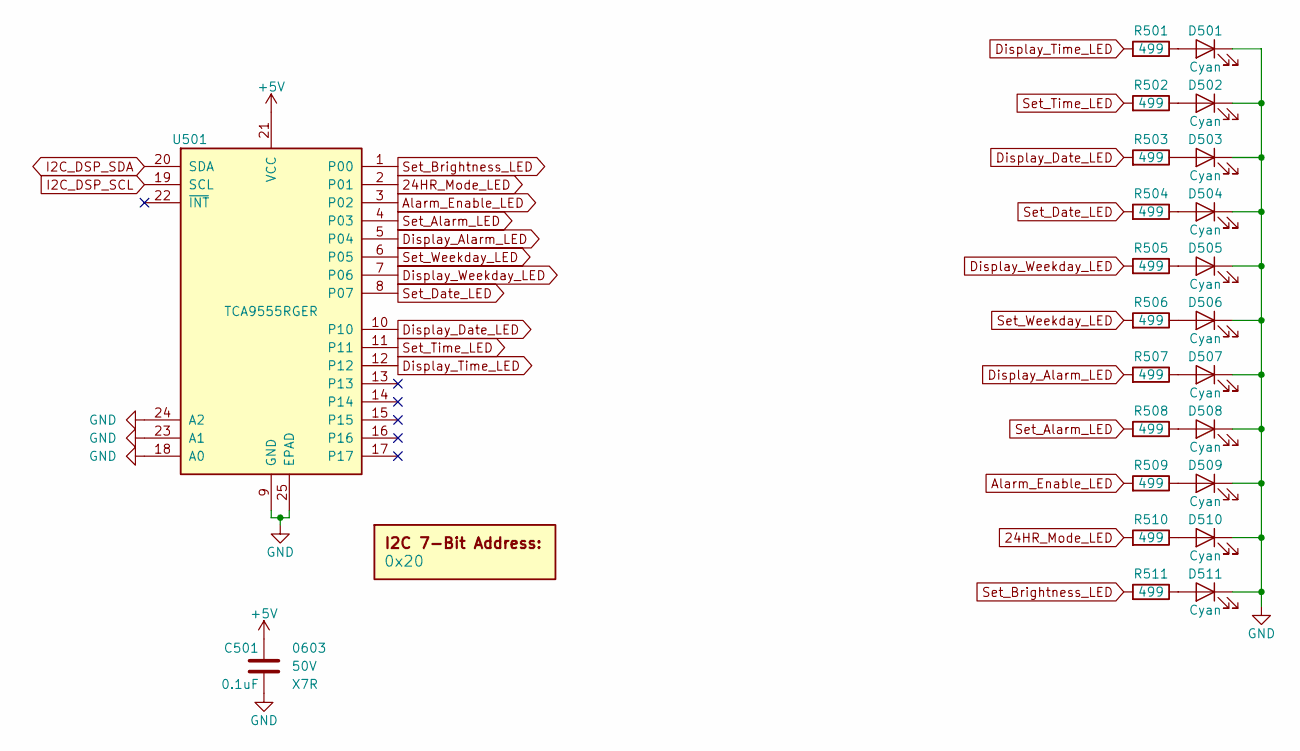
[picture p49: schematic Menu_LEDs.sch]

Parts:
C501: 0.1uF; C_0603; Voltage 50V; Digi-Key PN 311-1344-1-ND
D501, D502, D503, D504, D505, D506, D507, D508, D509, D510, D511: Cyan; LED_0603; Digi-Key PN 754-2180-1-ND
DOC501: 0x20
R501, R502, R503, R504, R505, R506, R507, R508, R509, R510, R511: 499; R_0603; Tolerance 1%; Digi-Key PN P499HCT-ND
U501: TCA9555RGER; QFN-24-1EP_4x4mm_P0.5mm_EP2.6x2.6mm; Digi-Key PN 296-44537-1-ND

Connections:
24HR_Mode_LED: R510.1, U501.2 (P01)
+5V: C501.1, U501.21 (VCC); also elsewhere on the board
Alarm_Enable_LED: R509.1, U501.3 (P02)
Display_Alarm_LED: R507.1, U501.5 (P04)
Display_Date_LED: R503.1, U501.10
Display_Time_LED: R501.1, U501.12
Display_Weekday_LED: R505.1, U501.7 (P06)
GND: C501.2, D501.1 (K), D502.1 (K), D503.1 (K), D504.1 (K), D505.1 (K), D506.1 (K), D507.1 (K), D508.1 (K), D509.1 (K), D510.1 (K), D511.1 (K), U501.9 (GND), U501.18 (A0), U501.23 (A1), U501.24 (A2), U501.25 (EPAD); also elsewhere on the board
I2C_DSP_SCL: U501.19 (SCL); also elsewhere on the board
I2C_DSP_SDA: U501.20 (SDA); also elsewhere on the board
unnamed: D501.2 (A), R501.2
unnamed: D502.2 (A), R502.2
unnamed: D503.2 (A), R503.2
unnamed: D504.2 (A), R504.2
unnamed: D505.2 (A), R505.2
unnamed: D506.2 (A), R506.2
unnamed: D507.2 (A), R507.2
unnamed: D508.2 (A), R508.2
unnamed: D509.2 (A), R509.2
unnamed: D510.2 (A), R510.2
unnamed: D511.2 (A), R511.2
Set_Alarm_LED: R508.1, U501.4 (P03)
Set_Brightness_LED: R511.1, U501.1 (P00)
Set_Date_LED: R504.1, U501.8 (P07)
Set_Time_LED: R502.1, U501.11
Set_Weekday_LED: R506.1, U501.6 (P05)

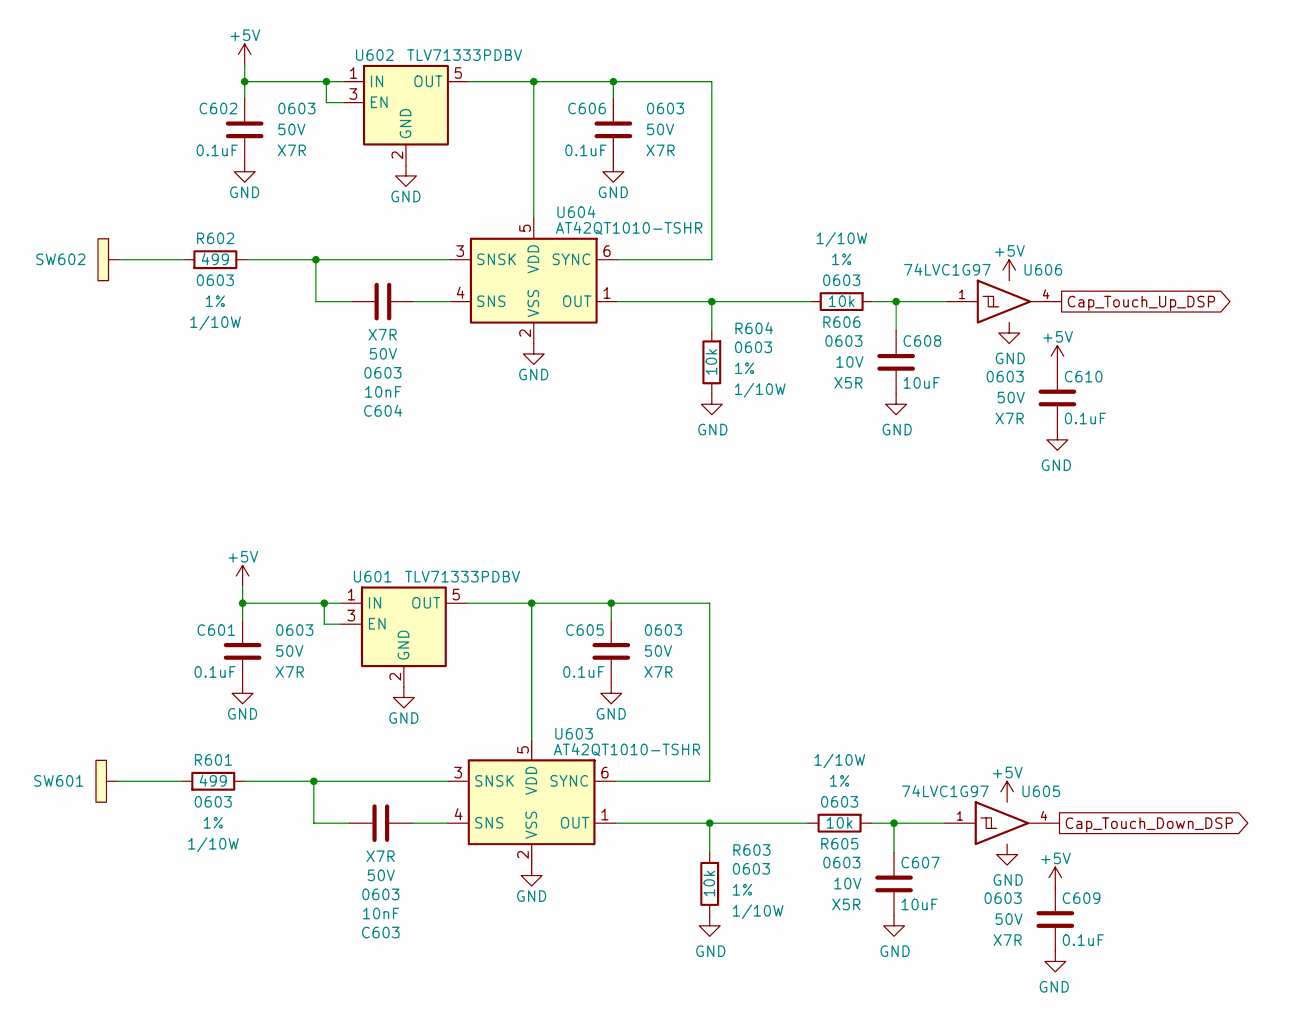
[picture p50: schematic Pushbuttons_1.sch, Incrementor]

Parts:
C601, C602, C605, C606, C609, C610: 0.1uF; C_0603; Voltage 50V; Digi-Key PN 311-1344-1-ND
C603, C604: 10nF; C_0603; Voltage 50V; Digi-Key PN 1276-1921-1-ND
C607, C608: 10uF; C_0603; Voltage 10V; Digi-Key PN 490-14372-1-ND
R601, R602: 499; R_0603; Tolerance 1%; Digi-Key PN P499HCT-ND
R603, R604, R605, R606: 10k; R_0603; Tolerance 1%; Digi-Key PN RMCF0603FT10K0CT-ND
SW601, SW602: Cap_Touch; Capacitive_Touch_Pad
U601, U602: TLV71333PDBV; SOT-23-5; Digi-Key PN 296-35591-1-ND
U603, U604: AT42QT1010-TSHR; SOT-23-6; Digi-Key PN AT42QT1010-TSHRCT-ND
U605, U606: 74LVC1G97; SOT-363_SC-70-6; Digi-Key PN 296-17671-1-ND

Connections:
+5V: C601.1, C602.1, C609.1, C610.1, U601.1 (IN), U601.3 (EN), U602.1 (IN), U602.3 (EN), U605.5 (VCC), U606.5 (VCC); also elsewhere on the board
Cap_Touch_Down_DSP: U605.4; also elsewhere on the board
Cap_Touch_Up_DSP: U606.4; also elsewhere on the board
GND: C601.2, C602.2, C605.2, C606.2, C607.2, C608.2, C609.2, C610.2, R603.2, R604.2, U601.2 (GND), U602.2 (GND), U603.2 (VSS), U604.2 (VSS), U605.2 (GND), U605.3 (GND), U605.6 (GND), U606.2 (GND), U606.3 (GND), U606.6 (GND); also elsewhere on the board
unnamed: C603.1, U603.4 (SNS)
unnamed: C603.2, R601.2, U603.3 (SNSK)
unnamed: C604.1, U604.4 (SNS)
unnamed: C604.2, R602.2, U604.3 (SNSK)
unnamed: C605.1, U601.5 (OUT), U603.5 (VDD), U603.6 (SYNC)
unnamed: C606.1, U602.5 (OUT), U604.5 (VDD), U604.6 (SYNC)
unnamed: C607.1, R605.1, U605.1
unnamed: C608.1, R606.1, U606.1
unnamed: R601.1, SW601.1
unnamed: R602.1, SW602.1
unnamed: R603.1, R605.2, U603.1 (OUT)
unnamed: R604.1, R606.2, U604.1 (OUT)

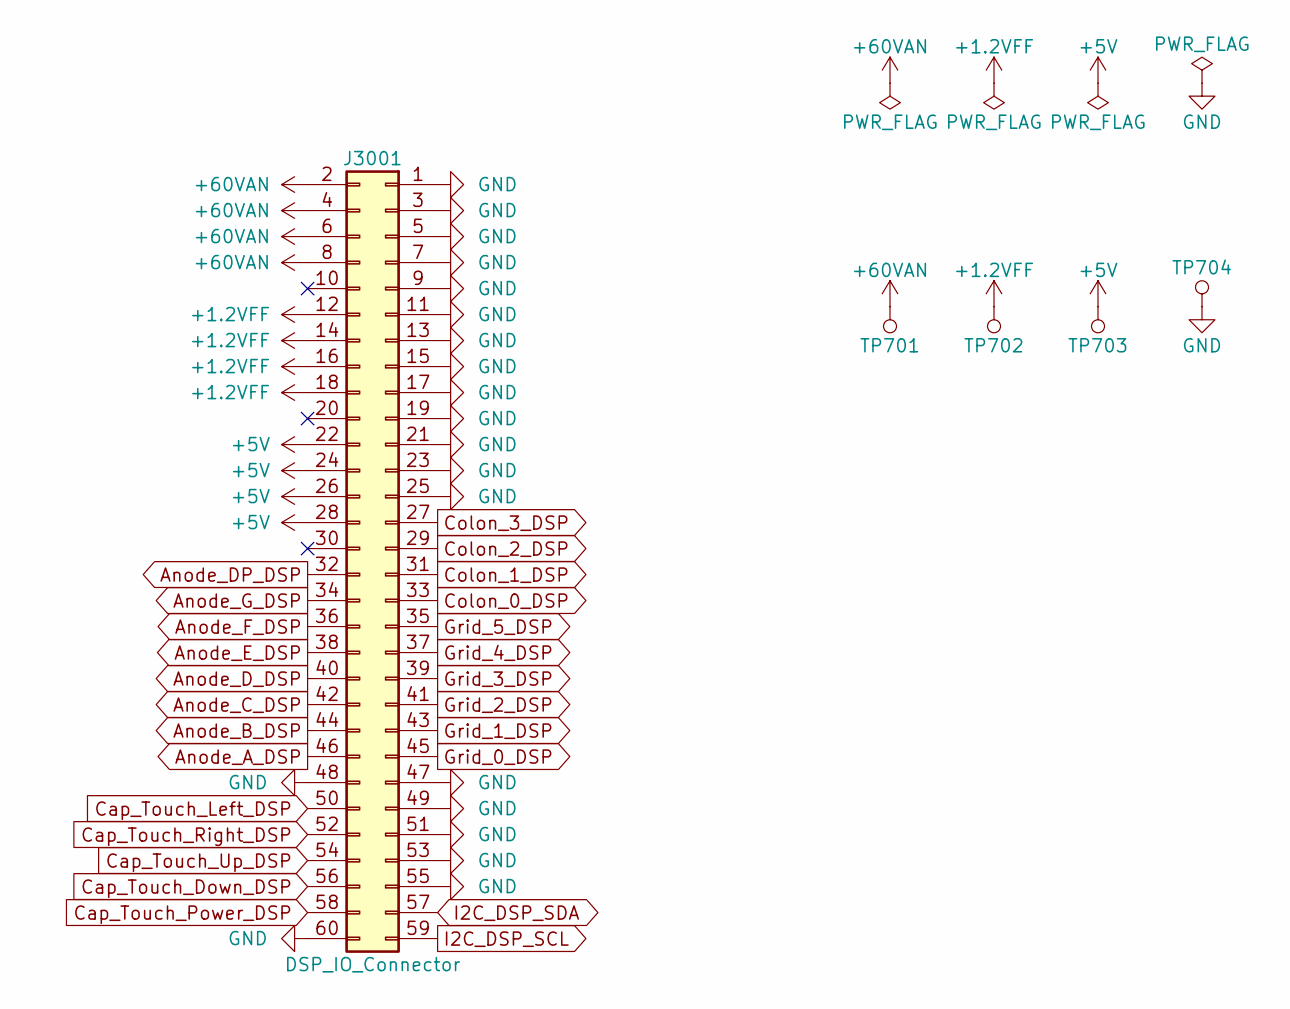
[picture p51: schematic IO_Connector.sch]

Parts:
J3001: DSP_IO_Connector; ERM8-030-09.0-L-DV-TR; Digi-Key PN ERM8-030-09.0-L-DV-K-TR
TP701, TP702, TP703: TP_Pad; Test_Point
TP704: TP; PinHeader_1x01_P2.54mm_Horizontal

Connections:
+1.2VFF: J3001.12, J3001.14, J3001.16, J3001.18, TP702.1; also elsewhere on the board
+5V: J3001.22, J3001.24, J3001.26, J3001.28, TP703.1; also elsewhere on the board
+60VAN: J3001.2, J3001.4, J3001.6, J3001.8, TP701.1; also elsewhere on the board
Anode_A_DSP: J3001.46; also elsewhere on the board
Anode_B_DSP: J3001.44; also elsewhere on the board
Anode_C_DSP: J3001.42; also elsewhere on the board
Anode_DP_DSP: J3001.32; also elsewhere on the board
Anode_D_DSP: J3001.40; also elsewhere on the board
Anode_E_DSP: J3001.38; also elsewhere on the board
Anode_F_DSP: J3001.36; also elsewhere on the board
Anode_G_DSP: J3001.34; also elsewhere on the board
Cap_Touch_Down_DSP: J3001.56; also elsewhere on the board
Cap_Touch_Left_DSP: J3001.50; also elsewhere on the board
Cap_Touch_Power_DSP: J3001.58; also elsewhere on the board
Cap_Touch_Right_DSP: J3001.52; also elsewhere on the board
Cap_Touch_Up_DSP: J3001.54; also elsewhere on the board
Colon_0_DSP: J3001.33; also elsewhere on the board
Colon_1_DSP: J3001.31; also elsewhere on the board
Colon_2_DSP: J3001.29; also elsewhere on the board
Colon_3_DSP: J3001.27; also elsewhere on the board
GND: J3001.1, J3001.3, J3001.5, J3001.7, J3001.9, J3001.11, J3001.13, J3001.15, J3001.17, J3001.19, J3001.21, J3001.23, J3001.25, J3001.47, J3001.48, J3001.49, J3001.51, J3001.53, J3001.55, J3001.60, TP704.1; also elsewhere on the board
Grid_0_DSP: J3001.45; also elsewhere on the board
Grid_1_DSP: J3001.43; also elsewhere on the board
Grid_2_DSP: J3001.41; also elsewhere on the board
Grid_3_DSP: J3001.39; also elsewhere on the board
Grid_4_DSP: J3001.37; also elsewhere on the board
Grid_5_DSP: J3001.35; also elsewhere on the board
I2C_DSP_SCL: J3001.59; also elsewhere on the board
I2C_DSP_SDA: J3001.57; also elsewhere on the board

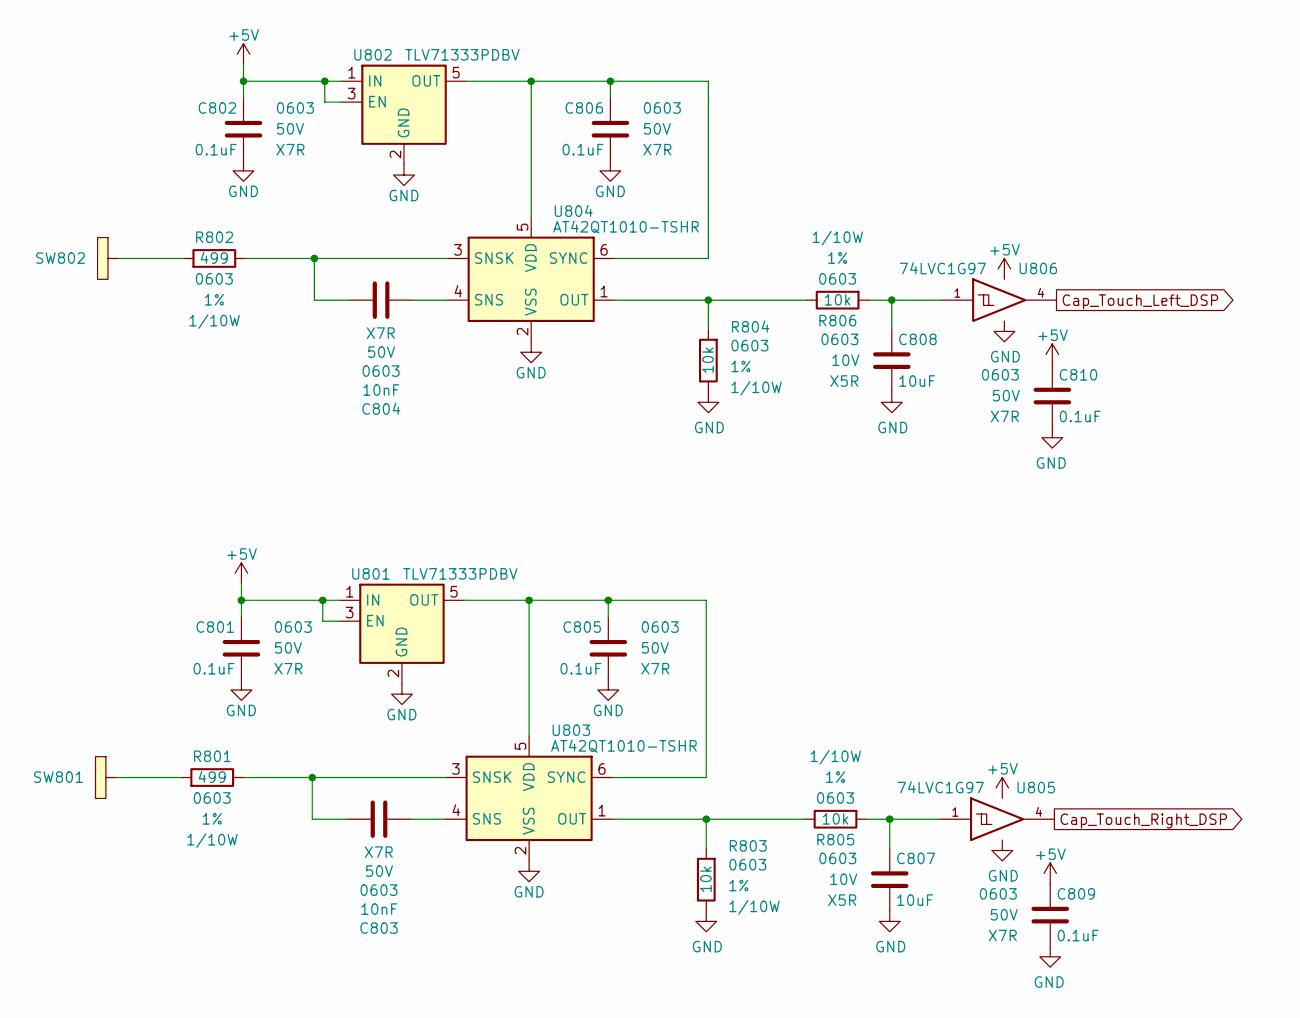
[picture p52: schematic Pushbuttons_2.sch, Incrementor]

Parts:
C801, C802, C805, C806, C809, C810: 0.1uF; C_0603; Voltage 50V; Digi-Key PN 311-1344-1-ND
C803, C804: 10nF; C_0603; Voltage 50V; Digi-Key PN 1276-1921-1-ND
C807, C808: 10uF; C_0603; Voltage 10V; Digi-Key PN 490-14372-1-ND
R801, R802: 499; R_0603; Tolerance 1%; Digi-Key PN P499HCT-ND
R803, R804, R805, R806: 10k; R_0603; Tolerance 1%; Digi-Key PN RMCF0603FT10K0CT-ND
SW801, SW802: Cap_Touch; Capacitive_Touch_Pad
U801, U802: TLV71333PDBV; SOT-23-5; Digi-Key PN 296-35591-1-ND
U803, U804: AT42QT1010-TSHR; SOT-23-6; Digi-Key PN AT42QT1010-TSHRCT-ND
U805, U806: 74LVC1G97; SOT-363_SC-70-6; Digi-Key PN 296-17671-1-ND

Connections:
+5V: C801.1, C802.1, C809.1, C810.1, U801.1 (IN), U801.3 (EN), U802.1 (IN), U802.3 (EN), U805.5 (VCC), U806.5 (VCC); also elsewhere on the board
Cap_Touch_Left_DSP: U806.4; also elsewhere on the board
Cap_Touch_Right_DSP: U805.4; also elsewhere on the board
GND: C801.2, C802.2, C805.2, C806.2, C807.2, C808.2, C809.2, C810.2, R803.2, R804.2, U801.2 (GND), U802.2 (GND), U803.2 (VSS), U804.2 (VSS), U805.2 (GND), U805.3 (GND), U805.6 (GND), U806.2 (GND), U806.3 (GND), U806.6 (GND); also elsewhere on the board
unnamed: C803.1, U803.4 (SNS)
unnamed: C803.2, R801.2, U803.3 (SNSK)
unnamed: C804.1, U804.4 (SNS)
unnamed: C804.2, R802.2, U804.3 (SNSK)
unnamed: C805.1, U801.5 (OUT), U803.5 (VDD), U803.6 (SYNC)
unnamed: C806.1, U802.5 (OUT), U804.5 (VDD), U804.6 (SYNC)
unnamed: C807.1, R805.1, U805.1
unnamed: C808.1, R806.1, U806.1
unnamed: R801.1, SW801.1
unnamed: R802.1, SW802.1
unnamed: R803.1, R805.2, U803.1 (OUT)
unnamed: R804.1, R806.2, U804.1 (OUT)

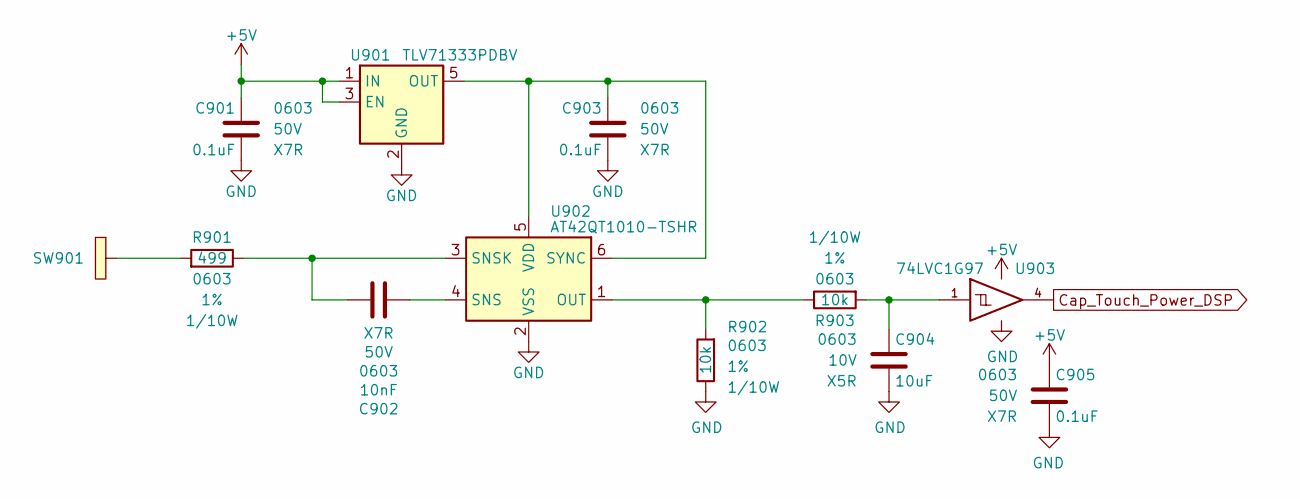
[picture p53: schematic Pushbuttons_3.sch, Incrementor]

Parts:
C901, C903, C905: 0.1uF; C_0603; Voltage 50V; Digi-Key PN 311-1344-1-ND
C902: 10nF; C_0603; Voltage 50V; Digi-Key PN 1276-1921-1-ND
C904: 10uF; C_0603; Voltage 10V; Digi-Key PN 490-14372-1-ND
R901: 499; R_0603; Tolerance 1%; Digi-Key PN P499HCT-ND
R902, R903: 10k; R_0603; Tolerance 1%; Digi-Key PN RMCF0603FT10K0CT-ND
SW901: Cap_Touch; Capacitive_Touch_Pad
U901: TLV71333PDBV; SOT-23-5; Digi-Key PN 296-35591-1-ND
U902: AT42QT1010-TSHR; SOT-23-6; Digi-Key PN AT42QT1010-TSHRCT-ND
U903: 74LVC1G97; SOT-363_SC-70-6; Digi-Key PN 296-17671-1-ND

Connections:
+5V: C901.1, C905.1, U901.1 (IN), U901.3 (EN), U903.5 (VCC); also elsewhere on the board
Cap_Touch_Power_DSP: U903.4; also elsewhere on the board
GND: C901.2, C903.2, C904.2, C905.2, R902.2, U901.2 (GND), U902.2 (VSS), U903.2 (GND), U903.3 (GND), U903.6 (GND); also elsewhere on the board
unnamed: C902.1, U902.4 (SNS)
unnamed: C902.2, R901.2, U902.3 (SNSK)
unnamed: C903.1, U901.5 (OUT), U902.5 (VDD), U902.6 (SYNC)
unnamed: C904.1, R903.1, U903.1
unnamed: R901.1, SW901.1
unnamed: R902.1, R903.2, U902.1 (OUT)

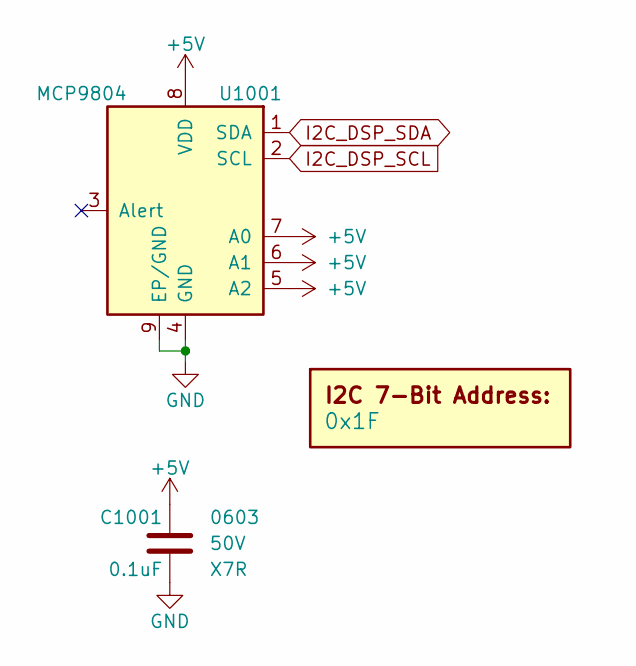
[picture p54: schematic Display_Telemetry.sch]

Parts:
C1001: 0.1uF; C_0603; Voltage 50V; Digi-Key PN 311-1344-1-ND
DOC1001: 0x1F
U1001: MCP9804; DFN-8-1EP_3x2mm_P0.5mm_EP1.75x1.45mm; Digi-Key PN MCP9804T-E/MCCT-ND

Connections:
+5V: C1001.1, U1001.5 (A2), U1001.6 (A1), U1001.7 (A0), U1001.8 (VDD); also elsewhere on the board
GND: C1001.2, U1001.4 (GND), U1001.9 (EP/GND); also elsewhere on the board
I2C_DSP_SCL: U1001.2 (SCL); also elsewhere on the board
I2C_DSP_SDA: U1001.1 (SDA); also elsewhere on the board

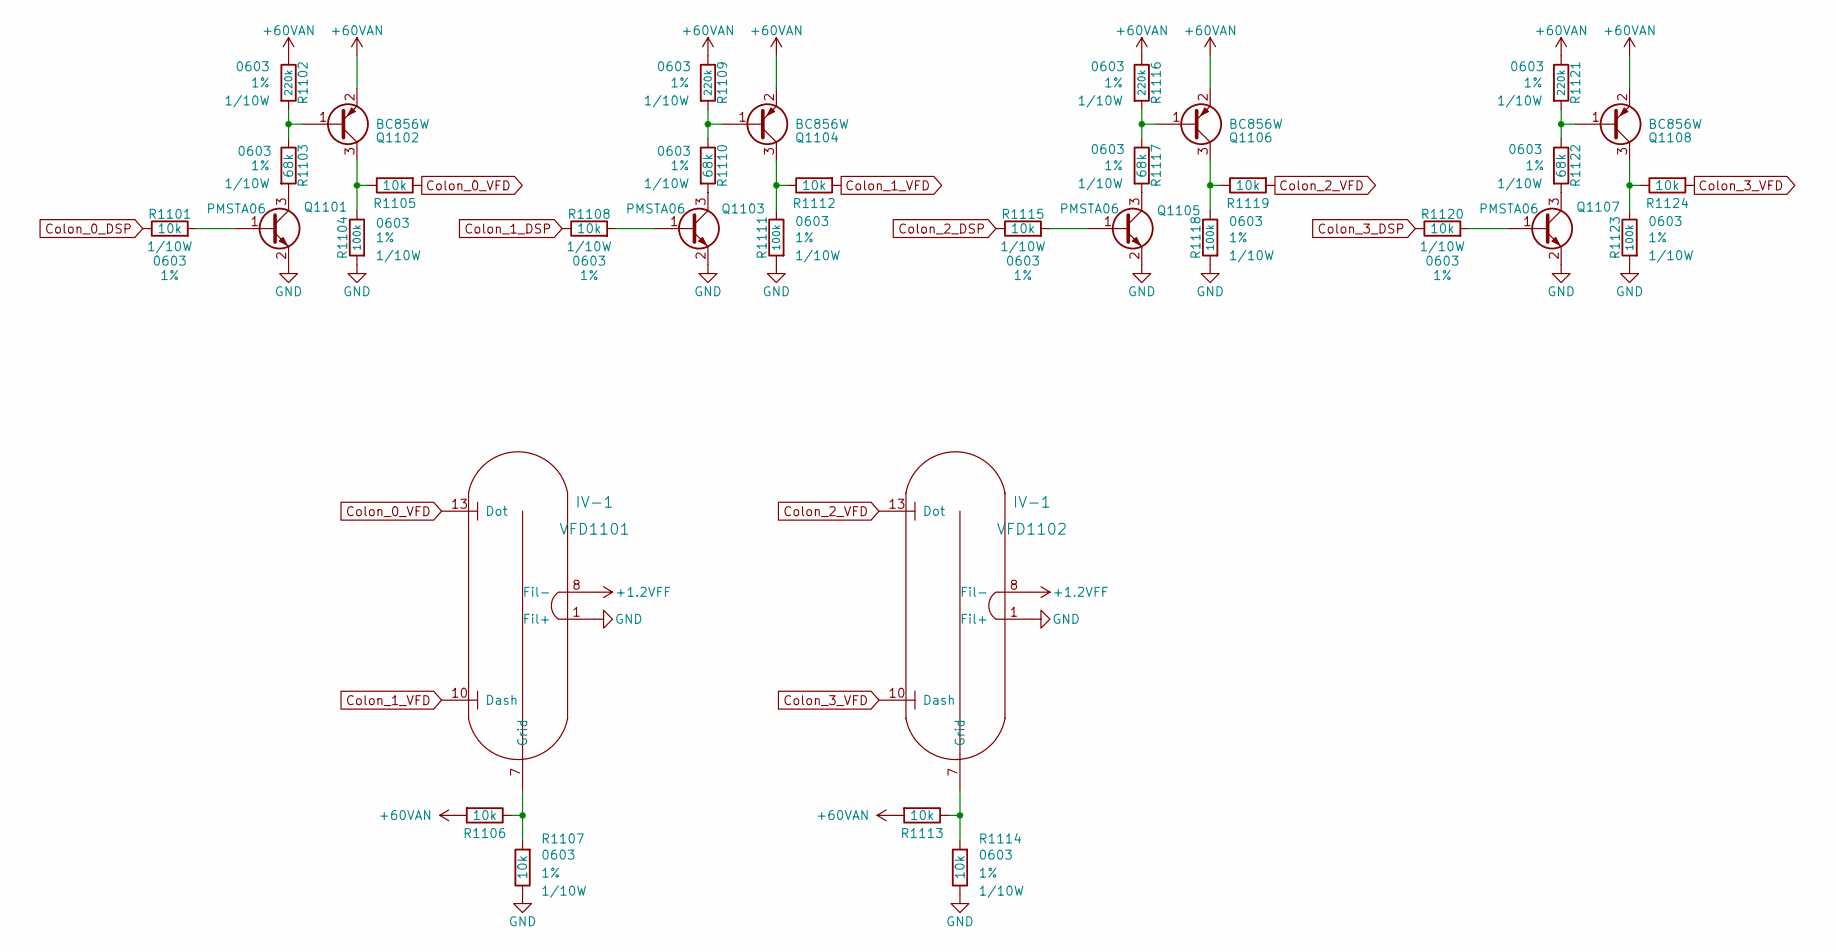
[picture p55: schematic Colons.sch]

Parts:
Q1101, Q1103, Q1105, Q1107: PMSTA06; SOT-323_SC-70; Digi-Key PN 1727-6293-1-ND
Q1102, Q1104, Q1106, Q1108: BC856W; SOT-323_SC-70; Digi-Key PN 1727-4865-1-ND
R1101, R1108, R1115, R1120: 10k; R_0603; Tolerance 1%; Digi-Key PN P10.0KHCT-ND
R1102, R1109, R1116, R1121: 220k; R_0603; Tolerance 1%; Digi-Key PN P220KHCT-ND
R1103, R1110, R1117, R1122: 68k; R_0603; Tolerance 1%; Digi-Key PN P68KDBCT-ND
R1104, R1111, R1118, R1123: 100k; R_0603; Tolerance 1%; Digi-Key PN P16019CT-ND
R1105, R1106, R1107, R1112, R1113, R1114, R1119, R1124: 10k; R_0603; Tolerance 1%; Digi-Key PN RMCF0603FT10K0CT-ND
VFD1101, VFD1102: IV-1

Connections:
+1.2VFF: VFD1101.8 (Fil-), VFD1102.8 (Fil-); also elsewhere on the board
+60VAN: Q1102.2 (E), Q1104.2 (E), Q1106.2 (E), Q1108.2 (E), R1102.1, R1106.1, R1109.1, R1113.1, R1116.1, R1121.1; also elsewhere on the board
Colon_0_DSP: R1101.1; also elsewhere on the board
Colon_0_VFD: R1105.1, VFD1101.13 (Dot)
Colon_1_DSP: R1108.1; also elsewhere on the board
Colon_1_VFD: R1112.1, VFD1101.10 (Dash)
Colon_2_DSP: R1115.1; also elsewhere on the board
Colon_2_VFD: R1119.1, VFD1102.13 (Dot)
Colon_3_DSP: R1120.1; also elsewhere on the board
Colon_3_VFD: R1124.1, VFD1102.10 (Dash)
GND: Q1101.2 (E), Q1103.2 (E), Q1105.2 (E), Q1107.2 (E), R1104.2, R1107.2, R1111.2, R1114.2, R1118.2, R1123.2, VFD1101.1 (Fil+), VFD1102.1 (Fil+); also elsewhere on the board
unnamed: Q1101.1 (B), R1101.2
unnamed: Q1101.3 (C), R1103.2
unnamed: Q1102.1 (B), R1102.2, R1103.1
unnamed: Q1102.3 (C), R1104.1, R1105.2
unnamed: Q1103.1 (B), R1108.2
unnamed: Q1103.3 (C), R1110.2
unnamed: Q1104.1 (B), R1109.2, R1110.1
unnamed: Q1104.3 (C), R1111.1, R1112.2
unnamed: Q1105.1 (B), R1115.2
unnamed: Q1105.3 (C), R1117.2
unnamed: Q1106.1 (B), R1116.2, R1117.1
unnamed: Q1106.3 (C), R1118.1, R1119.2
unnamed: Q1107.1 (B), R1120.2
unnamed: Q1107.3 (C), R1122.2
unnamed: Q1108.1 (B), R1121.2, R1122.1
unnamed: Q1108.3 (C), R1123.1, R1124.2
unnamed: R1106.2, R1107.1, VFD1101.7 (Grid)
unnamed: R1113.2, R1114.1, VFD1102.7 (Grid)

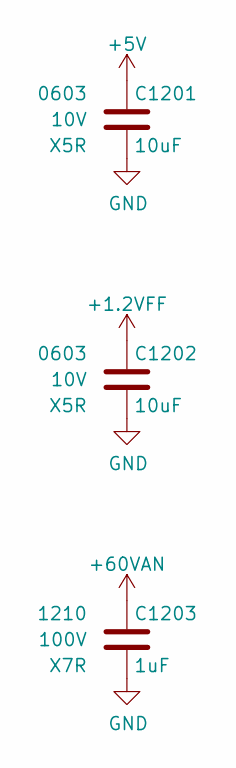
[picture p56: schematic Bulk_Capacitance.sch]

Parts:
C1201, C1202: 10uF; C_0603; Voltage 10V; Digi-Key PN 490-14372-1-ND
C1203: 1uF; C_1210; Voltage 100V; Digi-Key PN 399-17668-1-ND

Connections:
+1.2VFF: C1202.1; also elsewhere on the board
+5V: C1201.1; also elsewhere on the board
+60VAN: C1203.1; also elsewhere on the board
GND: C1201.2, C1202.2, C1203.2; also elsewhere on the board
