drewsum/VFD_Clock/rev_a/hdw/Display_Board/IV-6_Display_Board/IV-6_Display_Board.kicad_pcb

## KiCad design rev_a/hdw/Display_Board/IV-6_Display_Board/IV-6_Display_Board.kicad_pcb (continued)

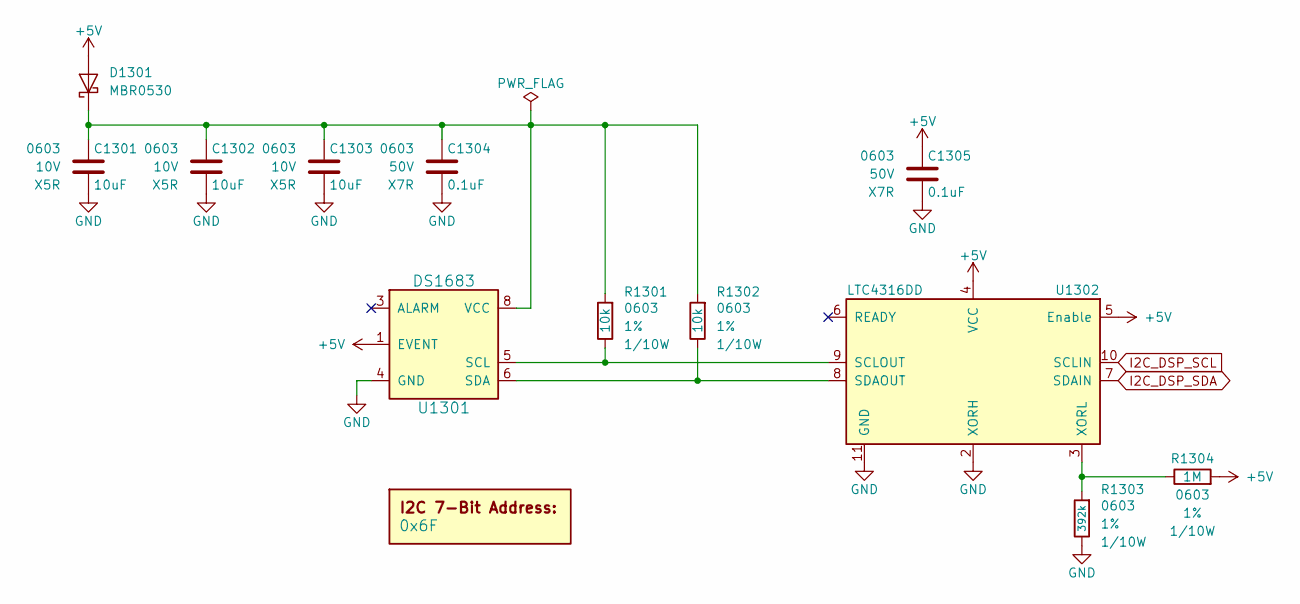
[picture p57: schematic Time_of_Flight.sch]

Parts:
C1301, C1302, C1303: 10uF; C_0603; Voltage 10V; Digi-Key PN 490-14372-1-ND
C1304, C1305: 0.1uF; C_0603; Voltage 50V; Digi-Key PN 311-1344-1-ND
D1301: MBR0530; D_SOD-123; Digi-Key PN MBR0530T1GOSCT-ND
DOC1301: 0x6F
R1301, R1302: 10k; R_0603; Tolerance 1%; Digi-Key PN RMCF0603FT10K0CT-ND
R1303: 392k; R_0603; Tolerance 1%; Digi-Key PN 311-392KHRCT-ND
R1304: 1M; R_0603; Tolerance 1%; Digi-Key PN 311-1.00MHRCT-ND
U1301: DS1683; SOIC-8_3.9x4.9mm_Pitch1.27mm; Digi-Key PN DS1683S+-ND
U1302: LTC4316DD; DFN-10-1EP_3x3mm_Pitch0.5mm; Digi-Key PN LTC4316IDD#PBF-ND

Connections:
+5V: C1305.1, D1301.2 (A), R1304.1, U1301.1 (EVENT), U1302.4 (VCC), U1302.5 (Enable); also elsewhere on the board
GND: C1301.2, C1302.2, C1303.2, C1304.2, C1305.2, R1303.2, U1301.4 (GND), U1302.1 (GND), U1302.2 (XORH), U1302.11 (GND); also elsewhere on the board
I2C_DSP_SCL: U1302.10 (SCLIN); also elsewhere on the board
I2C_DSP_SDA: U1302.7 (SDAIN); also elsewhere on the board
unnamed: C1301.1, C1302.1, C1303.1, C1304.1, D1301.1 (K), R1301.1, R1302.1, U1301.8 (VCC)
unnamed: R1301.2, U1301.5 (SCL), U1302.9 (SCLOUT)
unnamed: R1302.2, U1301.6 (SDA), U1302.8 (SDAOUT)
unnamed: R1303.1, R1304.2, U1302.3 (XORL)

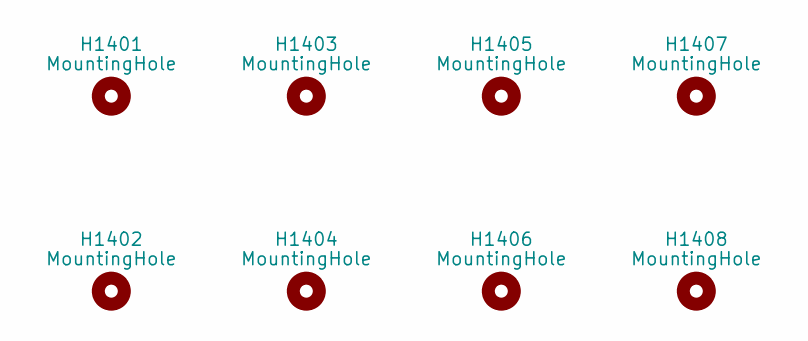
[picture p58: schematic Mechanical.sch]

Parts:
H1401, H1402, H1403, H1404, H1405, H1406, H1407, H1408: MountingHole; MountingHole_3mm

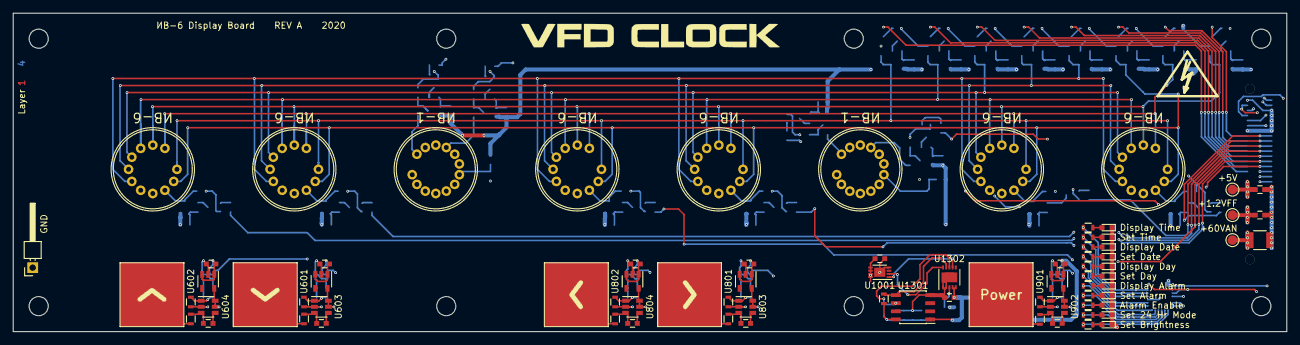
[picture p59: board IV-6_Display_Board.kicad_pcb from above]

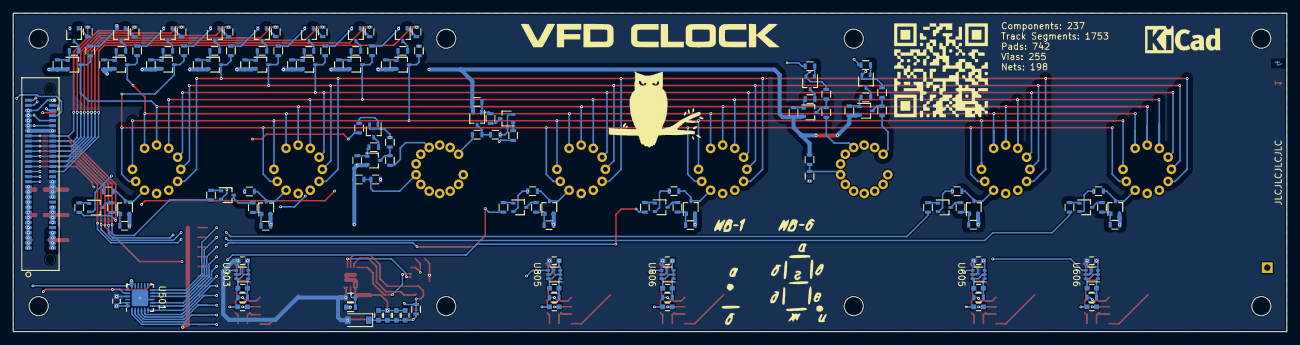
[picture p60: board IV-6_Display_Board.kicad_pcb from below]

Board: 4 copper layers, 200.0 x 50.0 mm, 238 parts (152 on the bottom side), 163 nets.
