drewsum/VFD_Clock/rev_a/hdw/Logic_Board/VFD_Clock/VFD_Clock.kicad_pcb

## KiCad design rev_a/hdw/Logic_Board/VFD_Clock/VFD_Clock.kicad_pcb (2020-03-08, an earlier design)

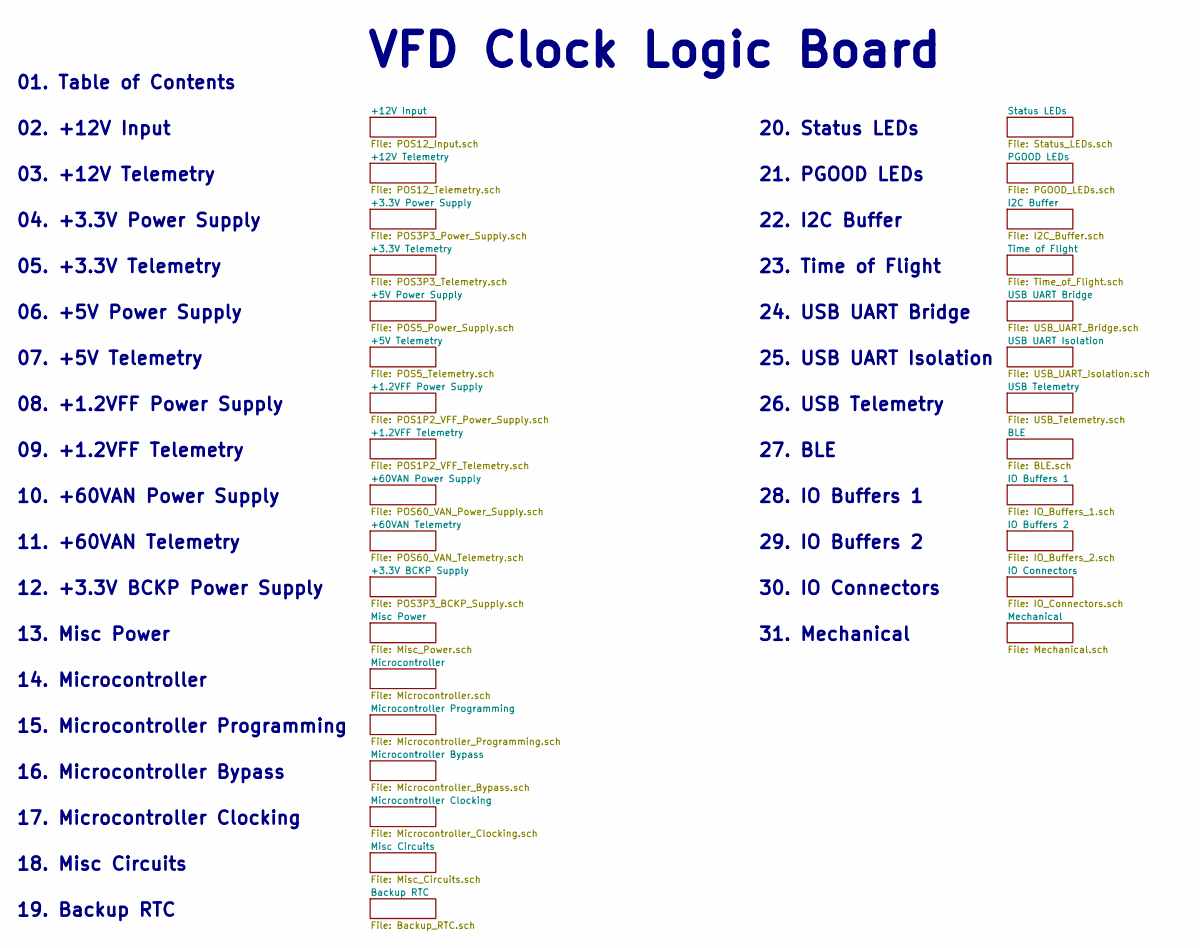
[picture p61: schematic VFD_Clock.sch, VFD Clock]

Notes on the sheet:
VFD Clock Logic Board
02. +12V Input
03. +12V Telemetry
04. +3.3V Power Supply
05. +3.3V Telemetry
06. +5V Power Supply
07. +5V Telemetry
08. +1.2VFF Power Supply
09. +1.2VFF Telemetry
10. +60VAN Power Supply
11. +60VAN Telemetry
12. +3.3V BCKP Power Supply
13. Misc Power
14. Microcontroller
15. Microcontroller Programming
16. Microcontroller Bypass
17. Microcontroller Clocking
18. Misc Circuits
19. Backup RTC
01. Table of Contents
20. Status LEDs
21. PGOOD LEDs
22. I2C Buffer
23. Time of Flight
24. USB UART Bridge
25. USB UART Isolation
26. USB Telemetry
28. IO Buffers 1
29. IO Buffers 2
30. IO Connectors
31. Mechanical
27. BLE

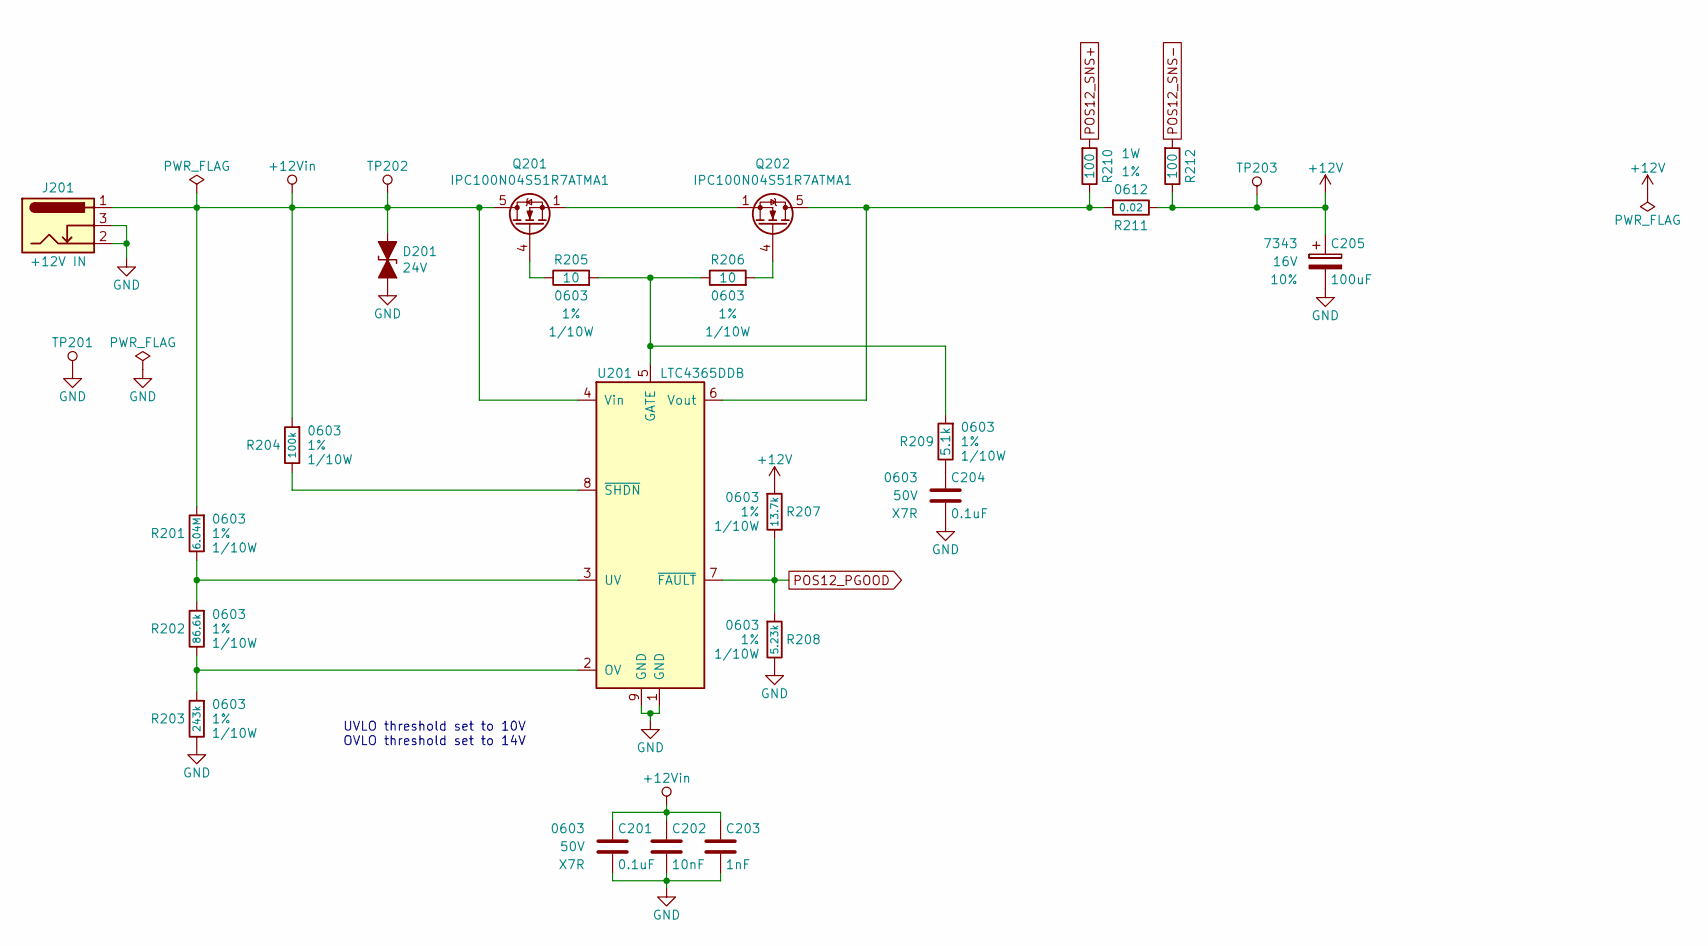
[picture p62: schematic POS12_Input.sch, QI Charger]

Parts:
C201, C204: 0.1uF; C_0603; Voltage 50V; Digi-Key PN 311-1344-1-ND
C202: 10nF; C_0603; Voltage 50V; Digi-Key PN 1276-1921-1-ND
C203: 1nF; C_0603; Voltage 50V; Digi-Key PN 1276-1018-1-ND
C205: 100uF; CP_Tantalum_Case-X_EIA-7343-43_Reflow; Voltage 16V; Tolerance 10%; Digi-Key PN 718-1102-1-ND
D201: 24V; D_SMA; Digi-Key PN SMAJ24CALFCT-ND
J201: +12V IN; BARREL_JACK; Digi-Key PN CP-202BH-ND
Q201, Q202: IPC100N04S51R7ATMA1; TDSON-8-1; Digi-Key PN IPC100N04S51R7ATMA1CT-ND
R201: 6.04M; R_0603; Tolerance 1%; Digi-Key PN 541-6.04MHCT-ND
R202: 86.6k; R_0603; Tolerance 1%; Digi-Key PN 311-86.6KHRCT-ND
R203: 243k; R_0603; Tolerance 1%; Digi-Key PN 311-243KHRCT-ND
R204: 100k; R_0603; Tolerance 1%; Digi-Key PN A106046CT-ND
R205, R206: 10; R_0603; Tolerance 1%; Digi-Key PN YAG3351CT-ND
R207: 13.7k; R_0603; Tolerance 1%; Digi-Key PN RMCF0603FT13K7CT-ND
R208: 5.23k; R_0603; Tolerance 1%; Digi-Key PN RMCF0603FT5K23CT-ND
R209: 5.1k; R_0603; Tolerance 1%; Digi-Key PN YAG3621CT-ND
R210, R212: 100; R_0603; Tolerance 1%; Digi-Key PN A106047CT-ND
R211: 0.02; R_0612; Tolerance 1%; Digi-Key PN P16010CT-ND
TP201: TP; Pin_Header_Angled_1x01_Pitch2.54mm
TP202, TP203: TP; Test_Point
U201: LTC4365DDB; DFN-8-1EP_2x3mm_Pitch0.5mm; Digi-Key PN LTC4365IDDB#TRMPBFCT-ND

Connections:
+12V: C205.1, R207.1, R211.2, R212.2, TP203.1; also elsewhere on the board
+12Vin: C201.1, C202.1, C203.1, D201.1 (A1), J201.1, Q201.5 (D), R201.1, R204.1, TP202.1, U201.4 (Vin)
GND: C201.2, C202.2, C203.2, C204.2, C205.2, D201.2 (A2), J201.2, J201.3, R203.2, R208.2, TP201.1, U201.1 (GND), U201.9 (GND); also elsewhere on the board
unnamed: C204.1, R209.2
unnamed: Q201.1 (S), Q201.2 (S), Q201.3 (S), Q202.1 (S), Q202.2 (S), Q202.3 (S)
unnamed: Q201.4 (G), R205.2
unnamed: Q202.4 (G), R206.1
unnamed: Q202.5 (D), R210.2, R211.1, U201.6 (Vout)
unnamed: R201.2, R202.1, U201.3 (UV)
unnamed: R202.2, R203.1, U201.2 (OV)
unnamed: R204.2, U201.8 (~SHDN)
unnamed: R205.1, R206.2, R209.1, U201.5 (GATE)
POS12_PGOOD: R207.2, R208.1, U201.7 (~FAULT); also elsewhere on the board
POS12_SNS+: R210.1; also elsewhere on the board
POS12_SNS-: R212.1; also elsewhere on the board

Notes on the sheet:
UVLO threshold set to 10V OVLO threshold set to 14V

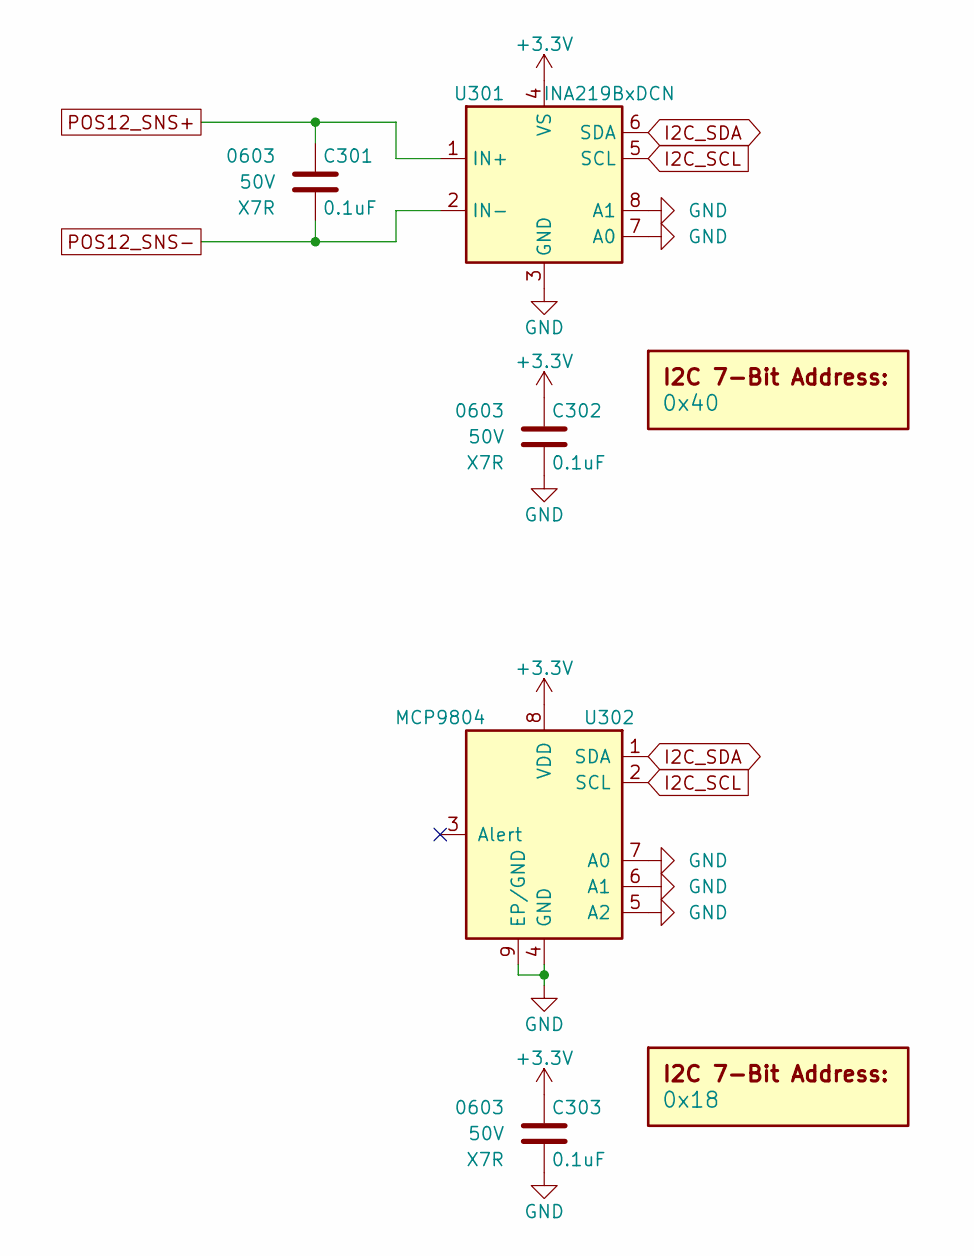
[picture p63: schematic POS12_Telemetry.sch]

Parts:
C301, C302, C303: 0.1uF; C_0603; Voltage 50V; Digi-Key PN 399-6856-1-ND
DOC301: 0x40
DOC302: 0x18
U301: INA219BxDCN; SOT-23-8; Digi-Key PN 296-46420-1-ND
U302: MCP9804; DFN-8-1EP_3x2mm_P0.5mm_EP1.3x1.5mm; Digi-Key PN MCP9804T-E/MCCT-ND

Connections:
+3V3: C302.1, C303.1, U301.4 (VS), U302.8 (VDD); also elsewhere on the board
GND: C302.2, C303.2, U301.3 (GND), U301.7 (A0), U301.8 (A1), U302.4 (GND), U302.5 (A2), U302.6 (A1), U302.7 (A0), U302.9 (EP/GND); also elsewhere on the board
I2C_SCL: U301.5 (SCL), U302.2 (SCL); also elsewhere on the board
I2C_SDA: U301.6 (SDA), U302.1 (SDA); also elsewhere on the board
POS12_SNS+: C301.1, U301.1 (IN+); also elsewhere on the board
POS12_SNS-: C301.2, U301.2 (IN-); also elsewhere on the board

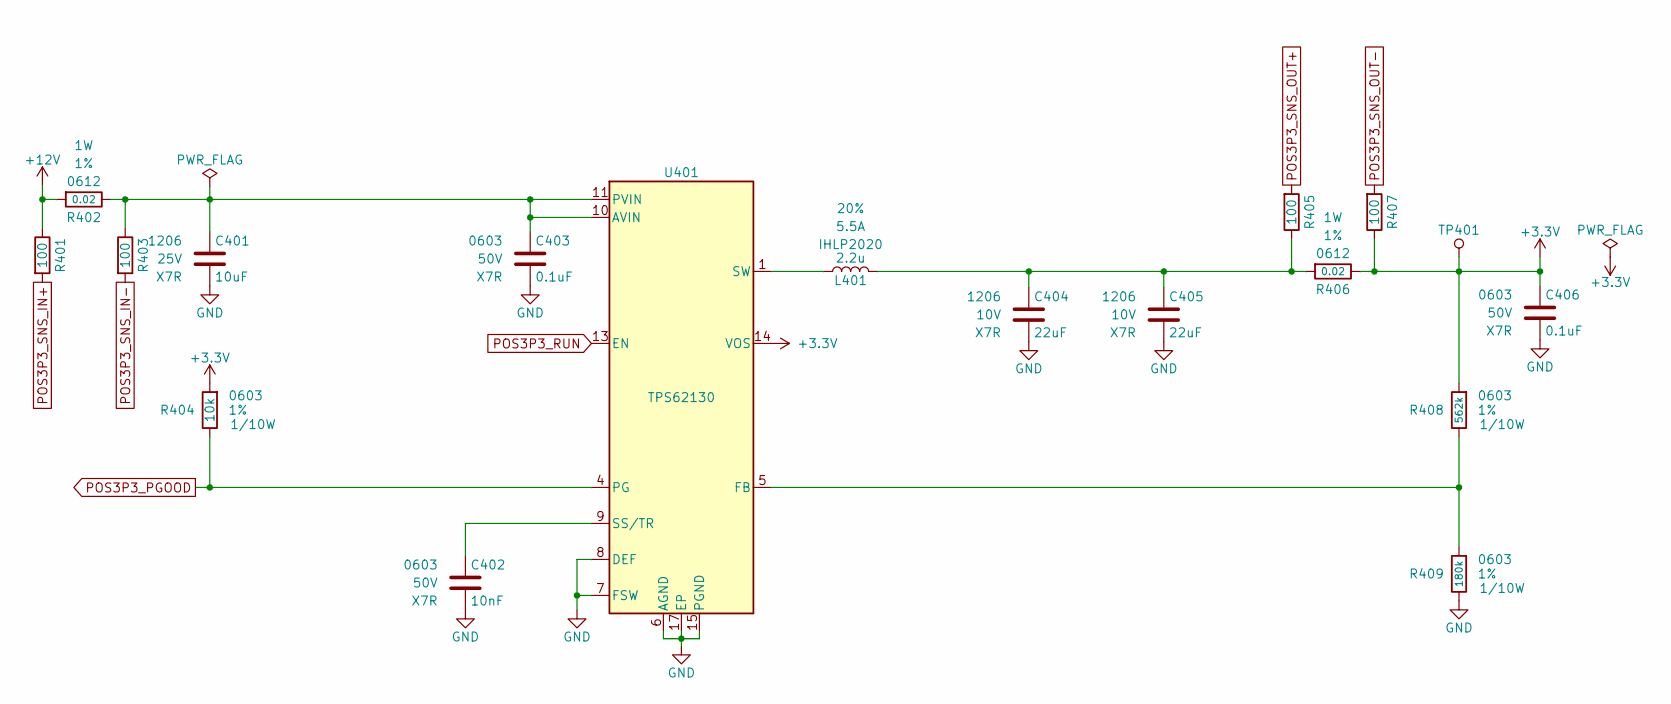
[picture p64: schematic POS3P3_Power_Supply.sch, QI Charger]

Parts:
C401: 10uF; C_1206; Voltage 25V; Digi-Key PN 1276-7031-1-ND
C402: 10nF; C_0603; Voltage 50V; Digi-Key PN 1276-1921-1-ND
C403, C406: 0.1uF; C_0603; Voltage 50V; Digi-Key PN 490-8020-1-ND
C404, C405: 22uF; C_1206; Voltage 10V; Digi-Key PN 1276-3148-1-ND
L401: 2.2u; L_Vishay_IHLP-2020; Tolerance 20%; Digi-Key PN 541-1236-1-ND
R401, R403, R405, R407: 100; R_0603; Tolerance 1%; Digi-Key PN A106047CT-ND
R402, R406: 0.02; R_0612; Tolerance 1%; Digi-Key PN P16010CT-ND
R404: 10k; R_0603; Tolerance 1%; Digi-Key PN RHM10KADCT-ND
R408: 562k; R_0603; Tolerance 1%; Digi-Key PN 311-562KHRCT-ND
R409: 180k; R_0603; Tolerance 1%; Digi-Key PN 749-1763-1-ND
TP401: TP; Test_Point
U401: TPS62130; QFN-16-1EP_3x3mm_Pitch0.5mm; Digi-Key PN 296-37878-1-ND

Connections:
+3V3: C406.1, R404.1, R406.2, R407.2, R408.1, TP401.1, U401.14 (VOS); also elsewhere on the board
+12V: R401.2, R402.1; also elsewhere on the board
GND: C401.2, C402.2, C403.2, C404.2, C405.2, C406.2, R409.2, U401.6 (AGND), U401.7 (FSW), U401.8 (DEF), U401.15 (PGND), U401.16 (PGND), U401.17 (EP); also elsewhere on the board
unnamed: C401.1, C403.1, R402.2, R403.2, U401.10 (AVIN), U401.11 (PVIN), U401.12 (PVIN)
unnamed: C402.1, U401.9 (SS/TR)
unnamed: C404.1, C405.1, L401.2, R405.2, R406.1
unnamed: L401.1, U401.1 (SW), U401.2 (SW), U401.3 (SW)
unnamed: R408.2, R409.1, U401.5 (FB)
POS3P3_PGOOD: R404.2, U401.4 (PG); also elsewhere on the board
POS3P3_RUN: U401.13 (EN); also elsewhere on the board
POS3P3_SNS_IN+: R401.1; also elsewhere on the board
POS3P3_SNS_IN-: R403.1; also elsewhere on the board
POS3P3_SNS_OUT+: R405.1; also elsewhere on the board
POS3P3_SNS_OUT-: R407.1; also elsewhere on the board

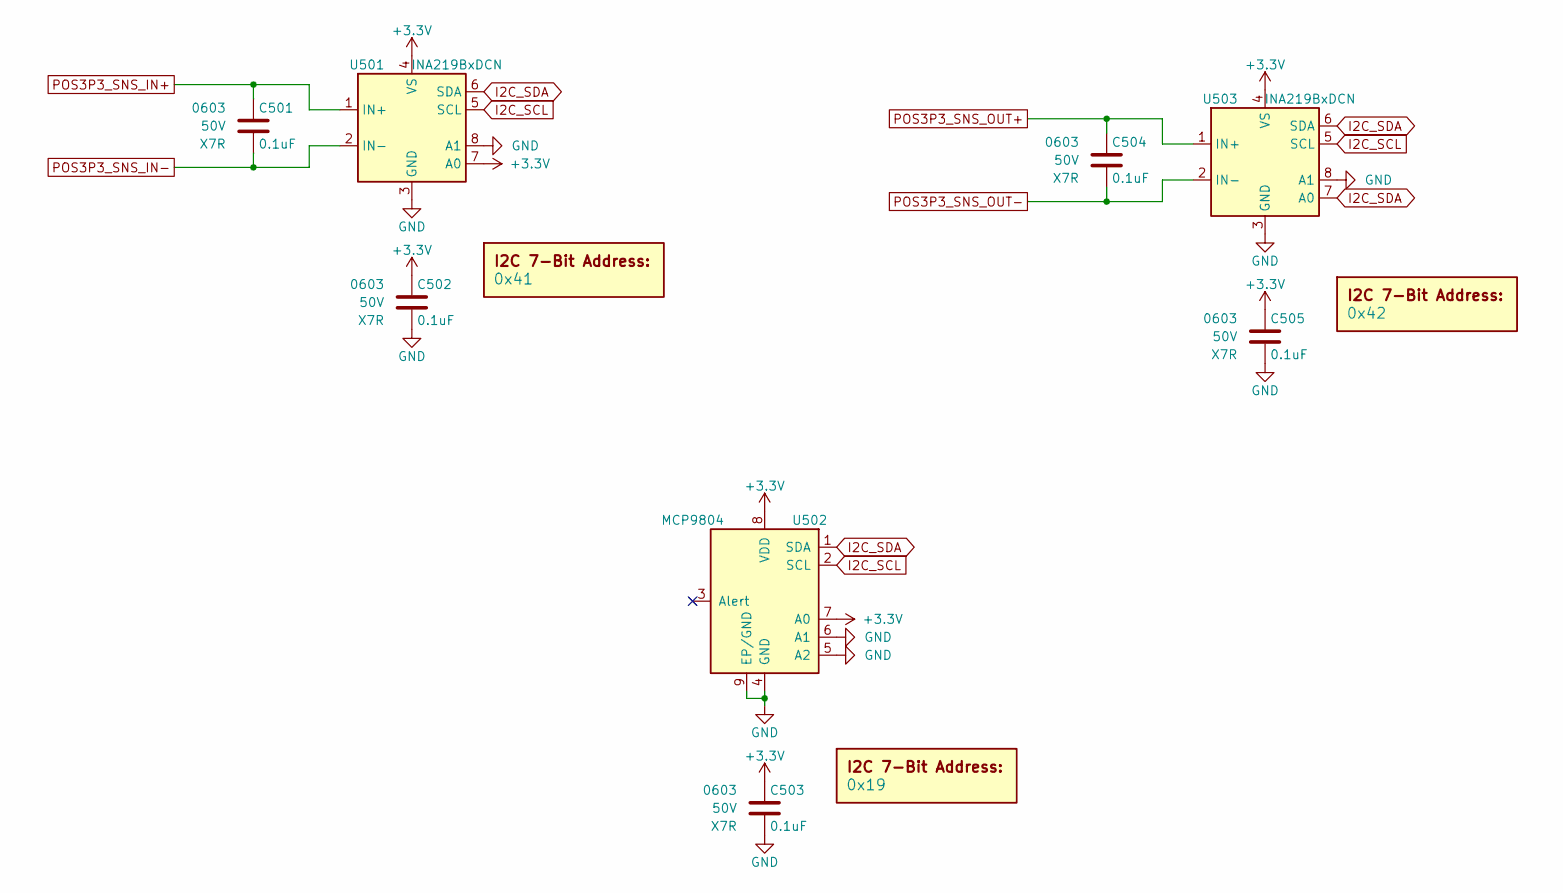
[picture p65: schematic POS3P3_Telemetry.sch]

Parts:
C501, C502, C503, C504, C505: 0.1uF; C_0603; Voltage 50V; Digi-Key PN 399-6856-1-ND
DOC501: 0x41
DOC502: 0x19
DOC503: 0x42
U501, U503: INA219BxDCN; SOT-23-8; Digi-Key PN 296-46420-1-ND
U502: MCP9804; DFN-8-1EP_3x2mm_P0.5mm_EP1.3x1.5mm; Digi-Key PN MCP9804T-E/MCCT-ND

Connections:
+3V3: C502.1, C503.1, C505.1, U501.4 (VS), U501.7 (A0), U502.7 (A0), U502.8 (VDD), U503.4 (VS); also elsewhere on the board
GND: C502.2, C503.2, C505.2, U501.3 (GND), U501.8 (A1), U502.4 (GND), U502.5 (A2), U502.6 (A1), U502.9 (EP/GND), U503.3 (GND), U503.8 (A1); also elsewhere on the board
I2C_SCL: U501.5 (SCL), U502.2 (SCL), U503.5 (SCL); also elsewhere on the board
I2C_SDA: U501.6 (SDA), U502.1 (SDA), U503.6 (SDA), U503.7 (A0); also elsewhere on the board
POS3P3_SNS_IN+: C501.1, U501.1 (IN+); also elsewhere on the board
POS3P3_SNS_IN-: C501.2, U501.2 (IN-); also elsewhere on the board
POS3P3_SNS_OUT+: C504.1, U503.1 (IN+); also elsewhere on the board
POS3P3_SNS_OUT-: C504.2, U503.2 (IN-); also elsewhere on the board

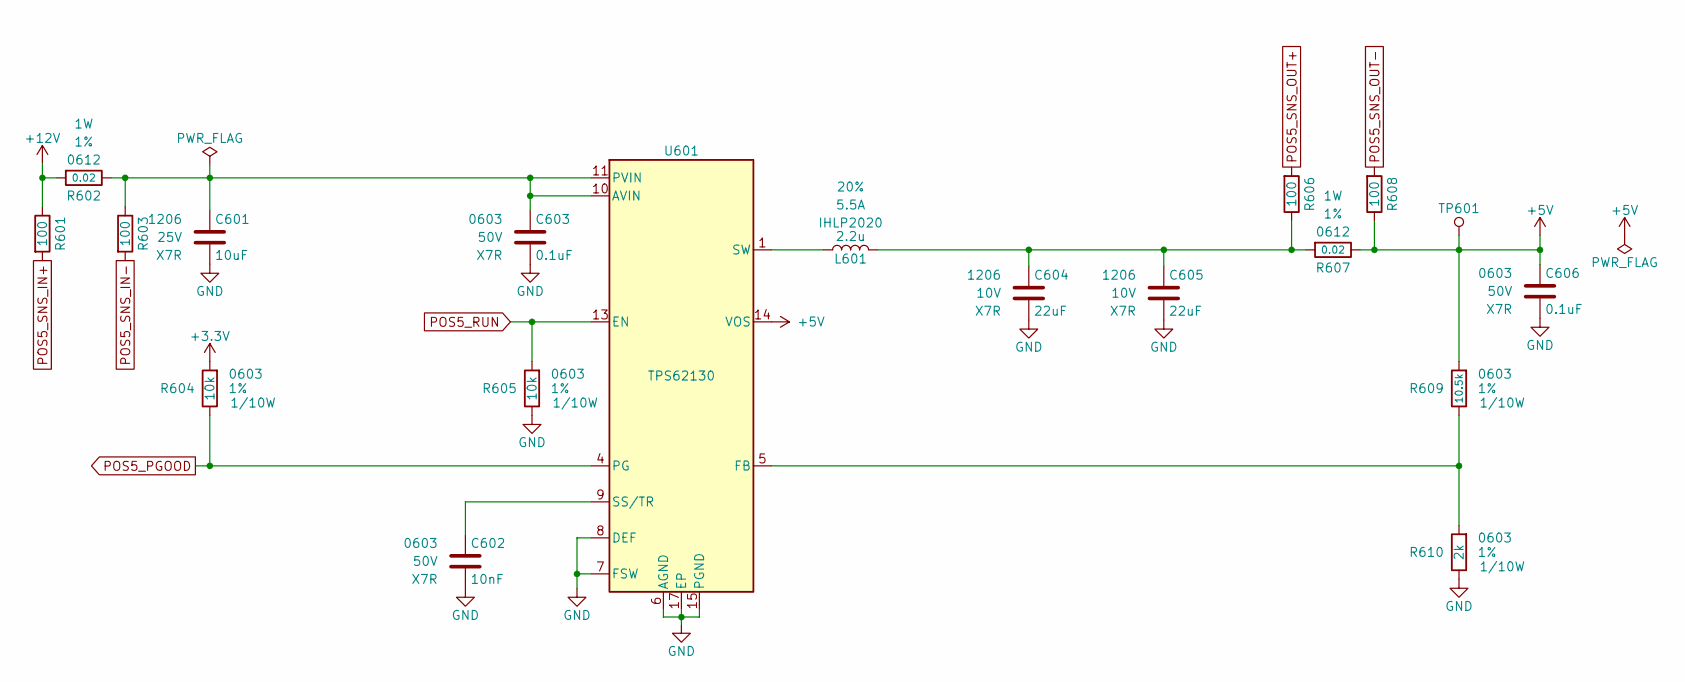
[picture p66: schematic POS5_Power_Supply.sch, QI Charger]

Parts:
C601: 10uF; C_1206; Voltage 25V; Digi-Key PN 1276-7031-1-ND
C602: 10nF; C_0603; Voltage 50V; Digi-Key PN 1276-1921-1-ND
C603, C606: 0.1uF; C_0603; Voltage 50V; Digi-Key PN 490-8020-1-ND
C604, C605: 22uF; C_1206; Voltage 10V; Digi-Key PN 1276-3148-1-ND
L601: 2.2u; L_Vishay_IHLP-2020; Tolerance 20%; Digi-Key PN 541-1236-1-ND
R601, R603, R606, R608: 100; R_0603; Tolerance 1%; Digi-Key PN A106047CT-ND
R602, R607: 0.02; R_0612; Tolerance 1%; Digi-Key PN P16010CT-ND
R604, R605: 10k; R_0603; Tolerance 1%; Digi-Key PN RHM10KADCT-ND
R609: 10.5k; R_0603; Tolerance 1%; Digi-Key PN 311-10.5KHRCT-ND
R610: 2k; R_0603; Tolerance 1%; Digi-Key PN 311-2.00KHRCT-ND
TP601: TP; Test_Point
U601: TPS62130; QFN-16-1EP_3x3mm_Pitch0.5mm; Digi-Key PN 296-37878-1-ND

Connections:
+3V3: R604.1; also elsewhere on the board
+5V: C606.1, R607.2, R608.2, R609.1, TP601.1, U601.14 (VOS); also elsewhere on the board
+12V: R601.2, R602.1; also elsewhere on the board
GND: C601.2, C602.2, C603.2, C604.2, C605.2, C606.2, R605.2, R610.2, U601.6 (AGND), U601.7 (FSW), U601.8 (DEF), U601.15 (PGND), U601.16 (PGND), U601.17 (EP); also elsewhere on the board
unnamed: C601.1, C603.1, R602.2, R603.2, U601.10 (AVIN), U601.11 (PVIN), U601.12 (PVIN)
unnamed: C602.1, U601.9 (SS/TR)
unnamed: C604.1, C605.1, L601.2, R606.2, R607.1
unnamed: L601.1, U601.1 (SW), U601.2 (SW), U601.3 (SW)
unnamed: R609.2, R610.1, U601.5 (FB)
POS5_PGOOD: R604.2, U601.4 (PG); also elsewhere on the board
POS5_RUN: R605.1, U601.13 (EN); also elsewhere on the board
POS5_SNS_IN+: R601.1; also elsewhere on the board
POS5_SNS_IN-: R603.1; also elsewhere on the board
POS5_SNS_OUT+: R606.1; also elsewhere on the board
POS5_SNS_OUT-: R608.1; also elsewhere on the board

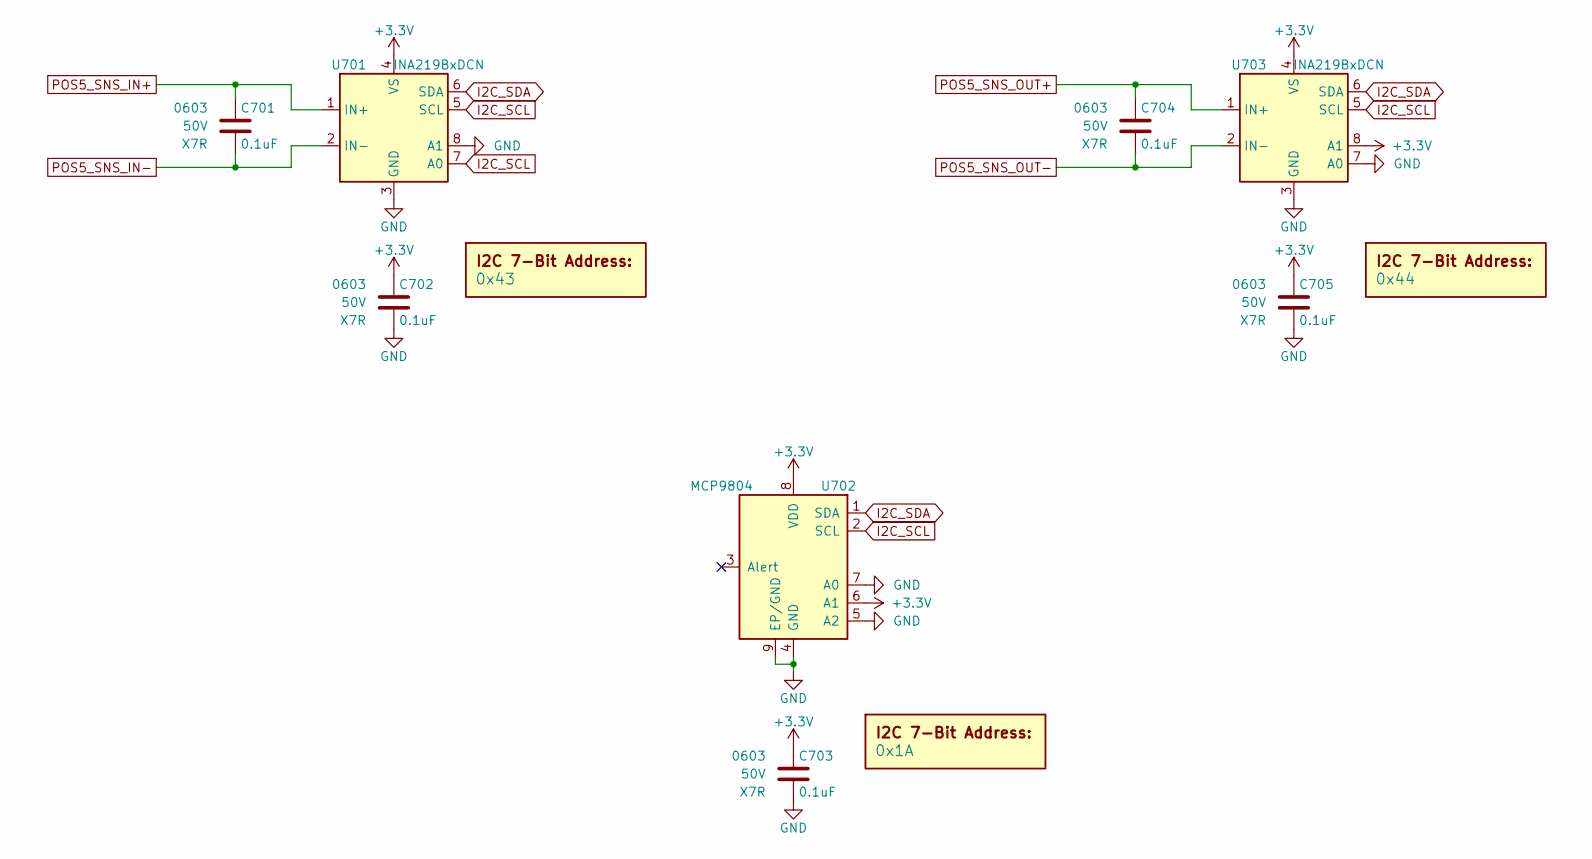
[picture p67: schematic POS5_Telemetry.sch]

Parts:
C701, C702, C703, C704, C705: 0.1uF; C_0603; Voltage 50V; Digi-Key PN 399-6856-1-ND
DOC701: 0x43
DOC702: 0x1A
DOC703: 0x44
U701, U703: INA219BxDCN; SOT-23-8; Digi-Key PN 296-46420-1-ND
U702: MCP9804; DFN-8-1EP_3x2mm_P0.5mm_EP1.3x1.5mm; Digi-Key PN MCP9804T-E/MCCT-ND

Connections:
+3V3: C702.1, C703.1, C705.1, U701.4 (VS), U702.6 (A1), U702.8 (VDD), U703.4 (VS), U703.8 (A1); also elsewhere on the board
GND: C702.2, C703.2, C705.2, U701.3 (GND), U701.8 (A1), U702.4 (GND), U702.5 (A2), U702.7 (A0), U702.9 (EP/GND), U703.3 (GND), U703.7 (A0); also elsewhere on the board
I2C_SCL: U701.5 (SCL), U701.7 (A0), U702.2 (SCL), U703.5 (SCL); also elsewhere on the board
I2C_SDA: U701.6 (SDA), U702.1 (SDA), U703.6 (SDA); also elsewhere on the board
POS5_SNS_IN+: C701.1, U701.1 (IN+); also elsewhere on the board
POS5_SNS_IN-: C701.2, U701.2 (IN-); also elsewhere on the board
POS5_SNS_OUT+: C704.1, U703.1 (IN+); also elsewhere on the board
POS5_SNS_OUT-: C704.2, U703.2 (IN-); also elsewhere on the board

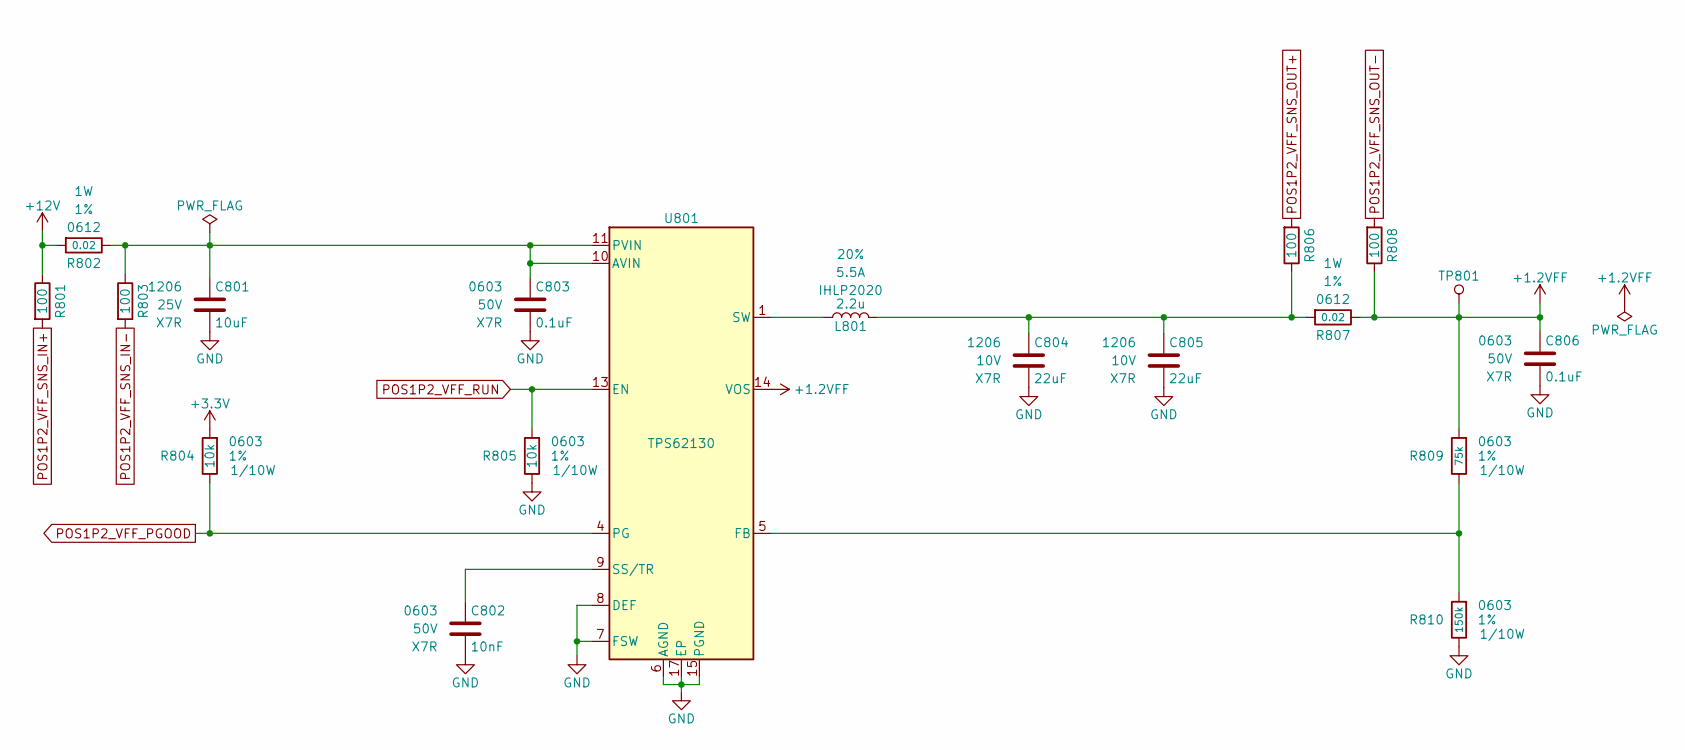
[picture p68: schematic POS1P2_VFF_Power_Supply.sch, QI Charger]

Parts:
C801: 10uF; C_1206; Voltage 25V; Digi-Key PN 1276-7031-1-ND
C802: 10nF; C_0603; Voltage 50V; Digi-Key PN 1276-1921-1-ND
C803, C806: 0.1uF; C_0603; Voltage 50V; Digi-Key PN 490-8020-1-ND
C804, C805: 22uF; C_1206; Voltage 10V; Digi-Key PN 1276-3148-1-ND
L801: 2.2u; L_Vishay_IHLP-2020; Tolerance 20%; Digi-Key PN 541-1236-1-ND
R801, R803, R806, R808: 100; R_0603; Tolerance 1%; Digi-Key PN A106047CT-ND
R802, R807: 0.02; R_0612; Tolerance 1%; Digi-Key PN P16010CT-ND
R804, R805: 10k; R_0603; Tolerance 1%; Digi-Key PN RHM10KADCT-ND
R809: 75k; R_0603; Tolerance 1%; Digi-Key PN 749-1681-1-ND
R810: 150k; R_0603; Tolerance 1%; Digi-Key PN A129714CT-ND
TP801: TP; Test_Point
U801: TPS62130; QFN-16-1EP_3x3mm_Pitch0.5mm; Digi-Key PN 296-37878-1-ND

Connections:
+1.2VFF: C806.1, R807.2, R808.2, R809.1, TP801.1, U801.14 (VOS); also elsewhere on the board
+3V3: R804.1; also elsewhere on the board
+12V: R801.2, R802.1; also elsewhere on the board
GND: C801.2, C802.2, C803.2, C804.2, C805.2, C806.2, R805.2, R810.2, U801.6 (AGND), U801.7 (FSW), U801.8 (DEF), U801.15 (PGND), U801.16 (PGND), U801.17 (EP); also elsewhere on the board
unnamed: C801.1, C803.1, R802.2, R803.2, U801.10 (AVIN), U801.11 (PVIN), U801.12 (PVIN)
unnamed: C802.1, U801.9 (SS/TR)
unnamed: C804.1, C805.1, L801.2, R806.2, R807.1
unnamed: L801.1, U801.1 (SW), U801.2 (SW), U801.3 (SW)
unnamed: R809.2, R810.1, U801.5 (FB)
POS1P2_VFF_PGOOD: R804.2, U801.4 (PG); also elsewhere on the board
POS1P2_VFF_RUN: R805.1, U801.13 (EN); also elsewhere on the board
POS1P2_VFF_SNS_IN+: R801.1; also elsewhere on the board
POS1P2_VFF_SNS_IN-: R803.1; also elsewhere on the board
POS1P2_VFF_SNS_OUT+: R806.1; also elsewhere on the board
POS1P2_VFF_SNS_OUT-: R808.1; also elsewhere on the board

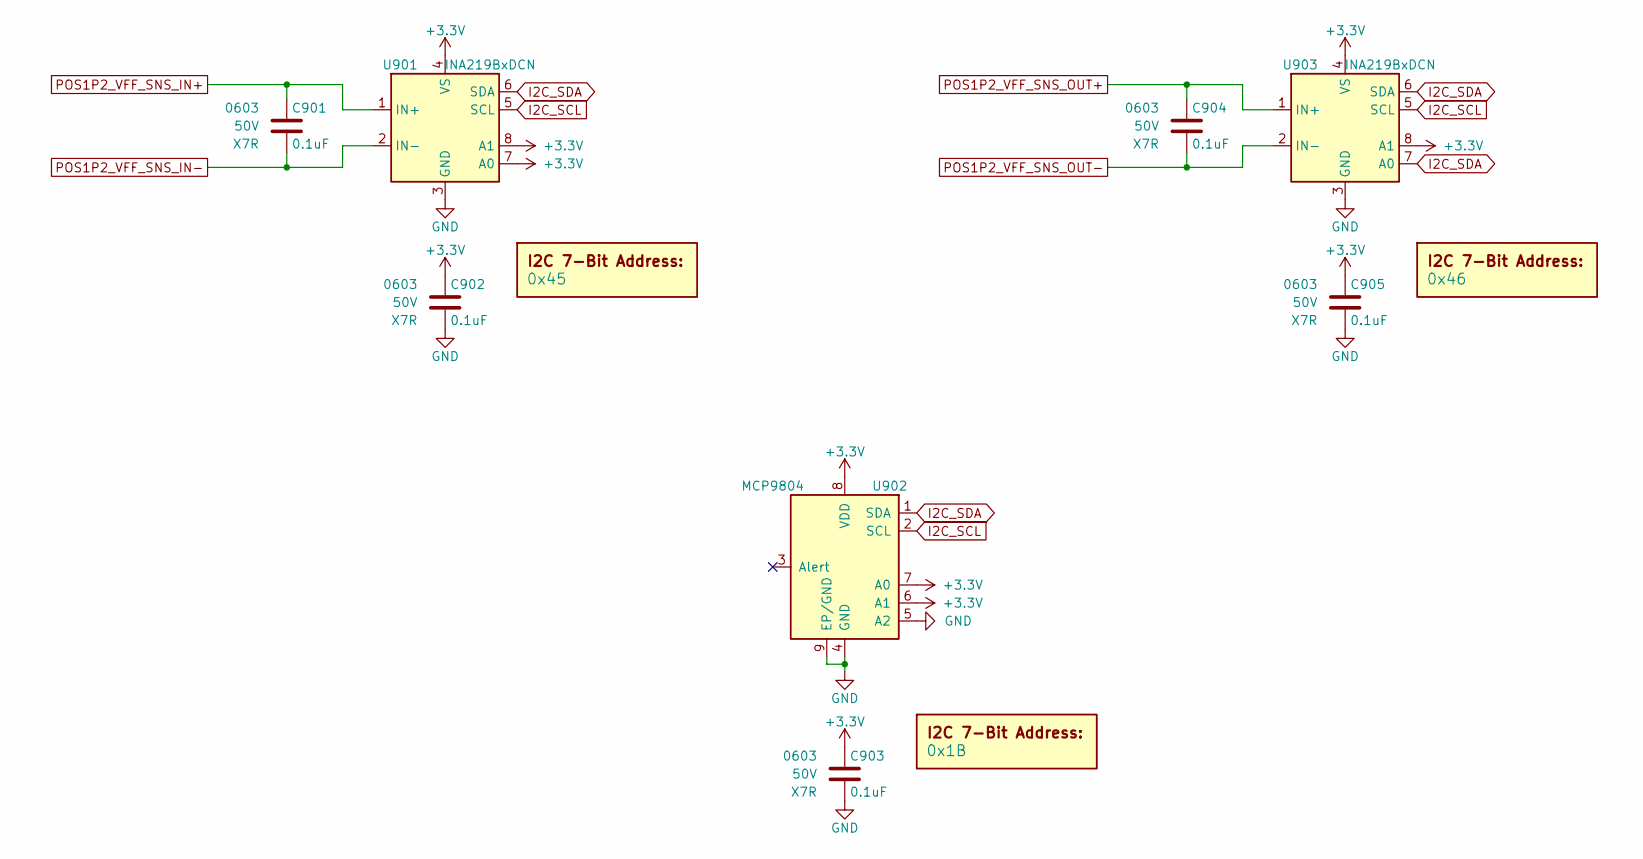
[picture p69: schematic POS1P2_VFF_Telemetry.sch]

Parts:
C901, C902, C903, C904, C905: 0.1uF; C_0603; Voltage 50V; Digi-Key PN 399-6856-1-ND
DOC901: 0x45
DOC902: 0x1B
DOC903: 0x46
U901, U903: INA219BxDCN; SOT-23-8; Digi-Key PN 296-46420-1-ND
U902: MCP9804; DFN-8-1EP_3x2mm_P0.5mm_EP1.3x1.5mm; Digi-Key PN MCP9804T-E/MCCT-ND

Connections:
+3V3: C902.1, C903.1, C905.1, U901.4 (VS), U901.7 (A0), U901.8 (A1), U902.6 (A1), U902.7 (A0), U902.8 (VDD), U903.4 (VS), U903.8 (A1); also elsewhere on the board
GND: C902.2, C903.2, C905.2, U901.3 (GND), U902.4 (GND), U902.5 (A2), U902.9 (EP/GND), U903.3 (GND); also elsewhere on the board
I2C_SCL: U901.5 (SCL), U902.2 (SCL), U903.5 (SCL); also elsewhere on the board
I2C_SDA: U901.6 (SDA), U902.1 (SDA), U903.6 (SDA), U903.7 (A0); also elsewhere on the board
POS1P2_VFF_SNS_IN+: C901.1, U901.1 (IN+); also elsewhere on the board
POS1P2_VFF_SNS_IN-: C901.2, U901.2 (IN-); also elsewhere on the board
POS1P2_VFF_SNS_OUT+: C904.1, U903.1 (IN+); also elsewhere on the board
POS1P2_VFF_SNS_OUT-: C904.2, U903.2 (IN-); also elsewhere on the board
