drewsum/VFD_Clock/rev_a/hdw/Logic_Board/VFD_Clock/VFD_Clock.kicad_pcb

## KiCad design rev_a/hdw/Logic_Board/VFD_Clock/VFD_Clock.kicad_pcb (continued)

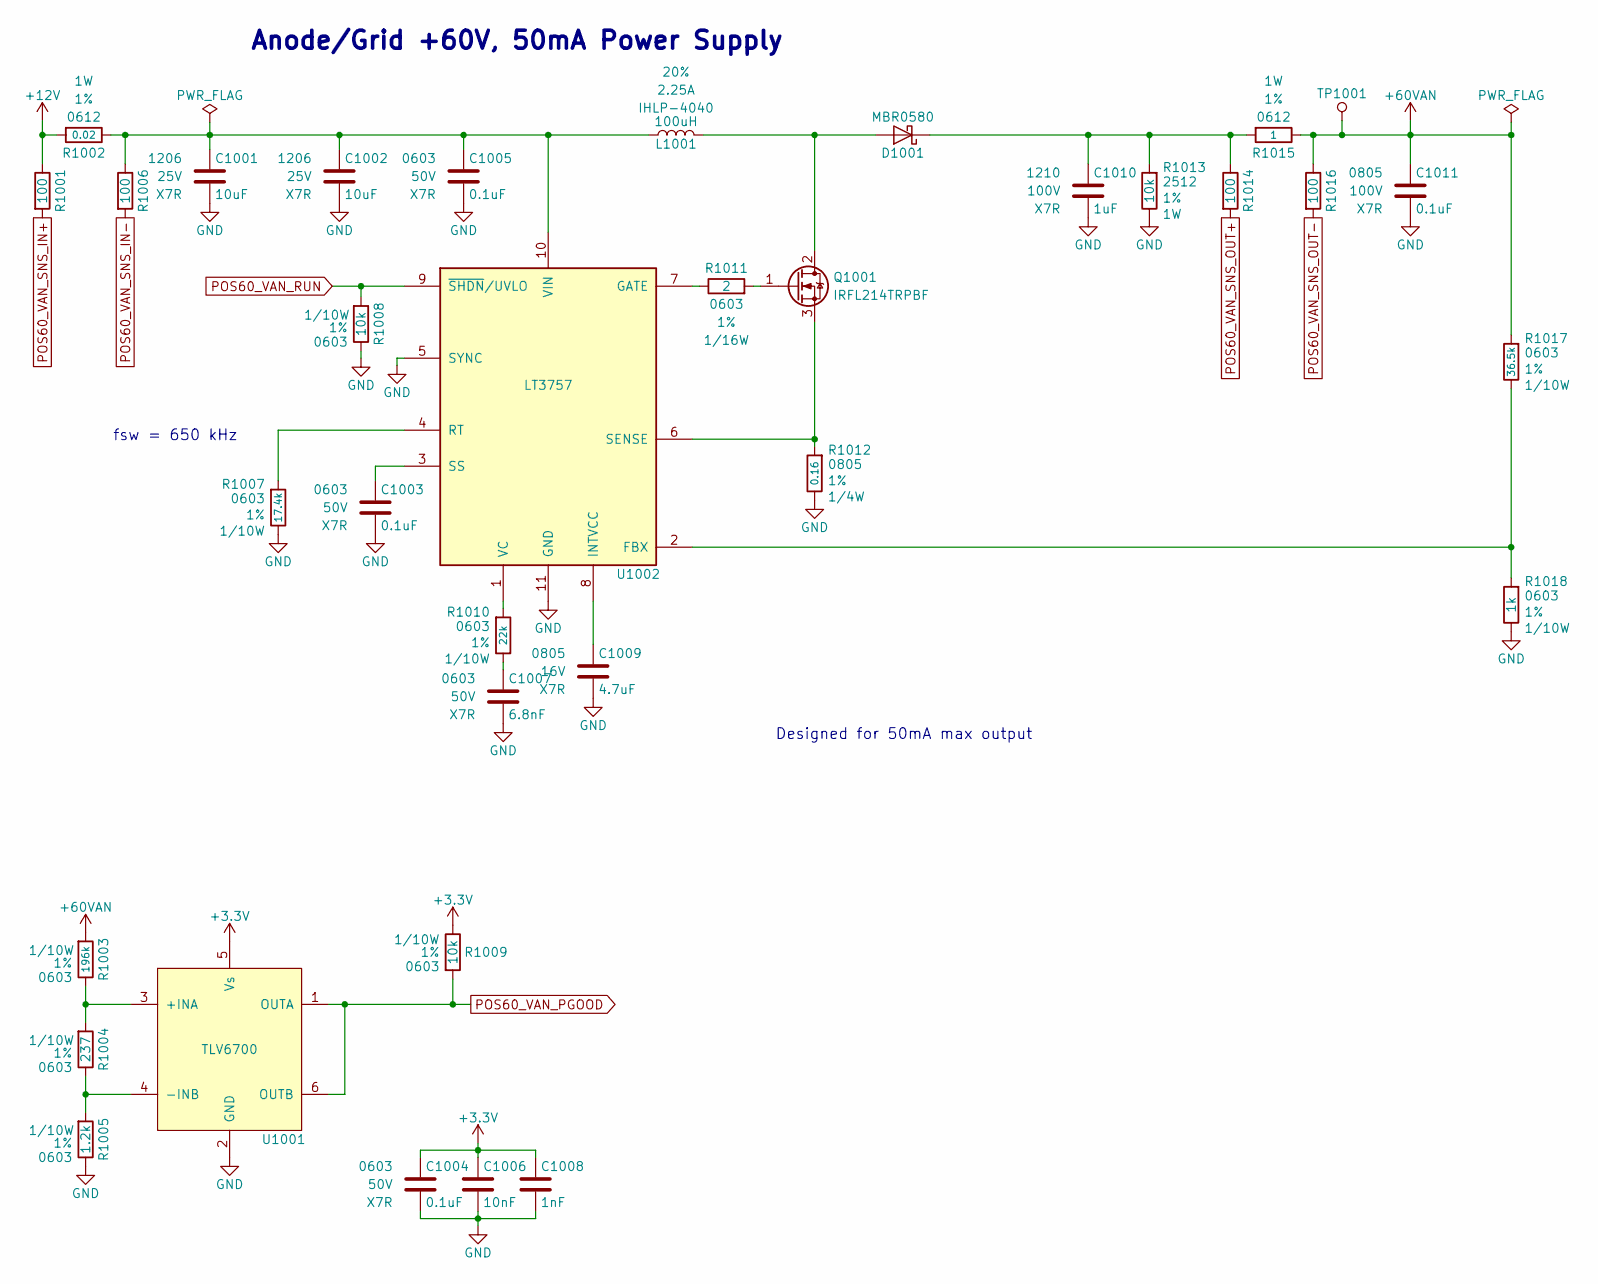
[picture p70: schematic POS60_VAN_Power_Supply.sch, VFD Clock]

Parts:
C1001, C1002: 10uF; C_1206; Voltage 25V; Digi-Key PN 1276-1804-6-ND
C1003, C1004, C1005: 0.1uF; C_0603; Voltage 50V; Digi-Key PN 399-6856-1-ND
C1006: 10nF; C_0603; Voltage 50V; Digi-Key PN 399-1092-1-ND
C1007: 6.8nF; C_0603; Voltage 50V; Digi-Key PN 311-1084-1-ND
C1008: 1nF; C_0603; Voltage 50V; Digi-Key PN 399-1083-1-ND
C1009: 4.7uF; C_0805; Voltage 16V; Digi-Key PN 1276-2970-1-ND
C1010: 1uF; C_1210; Voltage 100V; Digi-Key PN 490-1857-1-ND
C1011: 0.1uF; C_0805; Voltage 100V; Digi-Key PN 490-4789-1-ND
D1001: MBR0580; D_SOD-123; Digi-Key PN MBR0580S1-7DICT-ND
L1001: 100uH; L_Vishay_IHLP-4040; Tolerance 20%; Digi-Key PN 541-1310-1-ND
Q1001: IRFL214TRPBF; SOT-223-3_TabPin2; Digi-Key PN IRFL214PBFCT-ND
R1001, R1006, R1014, R1016: 100; R_0603; Tolerance 1%; Digi-Key PN A106047CT-ND
R1002: 0.02; R_0612; Tolerance 1%; Digi-Key PN P16010CT-ND
R1003: 196k; R_0603; Tolerance 1%; Digi-Key PN P196KHCT-ND
R1004: 237; R_0603; Tolerance 1%; Digi-Key PN 541-237HCT-ND
R1005: 1.2k; R_0603; Tolerance 1%; Digi-Key PN P1.20KHCT-ND
R1007: 17.4k; R_0603; Tolerance 1%; Digi-Key PN 311-17.4KHRCT-ND
R1008, R1009: 10k; R_0603; Tolerance 1%; Digi-Key PN P10.0KHCT-ND
R1010: 22k; R_0603; Tolerance 1%; Digi-Key PN A129704CT-ND
R1011: 2; R_0603; Tolerance 1%; Digi-Key PN 541-2.00SCT-ND
R1012: 0.16; R_0805; Tolerance 1%; Digi-Key PN P.16BJCT-ND
R1013: 10k; R_2512; Tolerance 1%; Digi-Key PN 541-10.0KAFCT-ND
R1015: 1; R_0612; Tolerance 1%; Digi-Key PN RHM1220CT-ND
R1017: 36.5k; R_0603; Tolerance 1%; Digi-Key PN RMCF0603FT36K5CT-ND
R1018: 1k; R_0603; Tolerance 1%; Digi-Key PN RMCF0603FT1K00CT-ND
TP1001: TP; Test_Point
U1001: TLV6700; SOT-23-6; Digi-Key PN 296-51696-1-ND
U1002: LT3757; DFN-10-1EP_3x3mm_Pitch0.5mm; Digi-Key PN LT3757EDD#PBF-ND

Connections:
+3V3: C1004.1, C1006.1, C1008.1, R1009.2, U1001.5 (Vs); also elsewhere on the board
+12V: R1001.2, R1002.1; also elsewhere on the board
+60VAN: C1011.1, R1003.1, R1015.2, R1016.2, R1017.1, TP1001.1; also elsewhere on the board
GND: C1001.2, C1002.2, C1003.2, C1004.2, C1005.2, C1006.2, C1007.2, C1008.2, C1009.2, C1010.2, C1011.2, R1005.2, R1007.2, R1008.2, R1012.2, R1013.2, R1018.2, U1001.2 (GND), U1002.5 (SYNC), U1002.11 (GND); also elsewhere on the board
unnamed: C1001.1, C1002.1, C1005.1, L1001.1, R1002.2, R1006.2, U1002.10 (VIN)
unnamed: C1003.1, U1002.3 (SS)
unnamed: C1007.1, R1010.2
unnamed: C1009.1, U1002.8 (INTVCC)
unnamed: C1010.1, D1001.1 (K), R1013.1, R1014.2, R1015.1
unnamed: D1001.2 (A), L1001.2, Q1001.2 (D)
unnamed: Q1001.1 (G), R1011.1
unnamed: Q1001.3 (S), R1012.1, U1002.6 (SENSE)
unnamed: R1003.2, R1004.1, U1001.3 (+INA)
unnamed: R1004.2, R1005.1, U1001.4 (-INB)
unnamed: R1007.1, U1002.4 (RT)
unnamed: R1010.1, U1002.1 (VC)
unnamed: R1011.2, U1002.7 (GATE)
unnamed: R1017.2, R1018.1, U1002.2 (FBX)
POS60_VAN_PGOOD: R1009.1, U1001.1 (OUTA), U1001.6 (OUTB); also elsewhere on the board
POS60_VAN_RUN: R1008.1, U1002.9 (~SHDN~/UVLO); also elsewhere on the board
POS60_VAN_SNS_IN+: R1001.1; also elsewhere on the board
POS60_VAN_SNS_IN-: R1006.1; also elsewhere on the board
POS60_VAN_SNS_OUT+: R1014.1; also elsewhere on the board
POS60_VAN_SNS_OUT-: R1016.1; also elsewhere on the board

Notes on the sheet:
Anode/Grid +60V, 50mA Power Supply
Designed for 50mA max output
fsw = 650 kHz

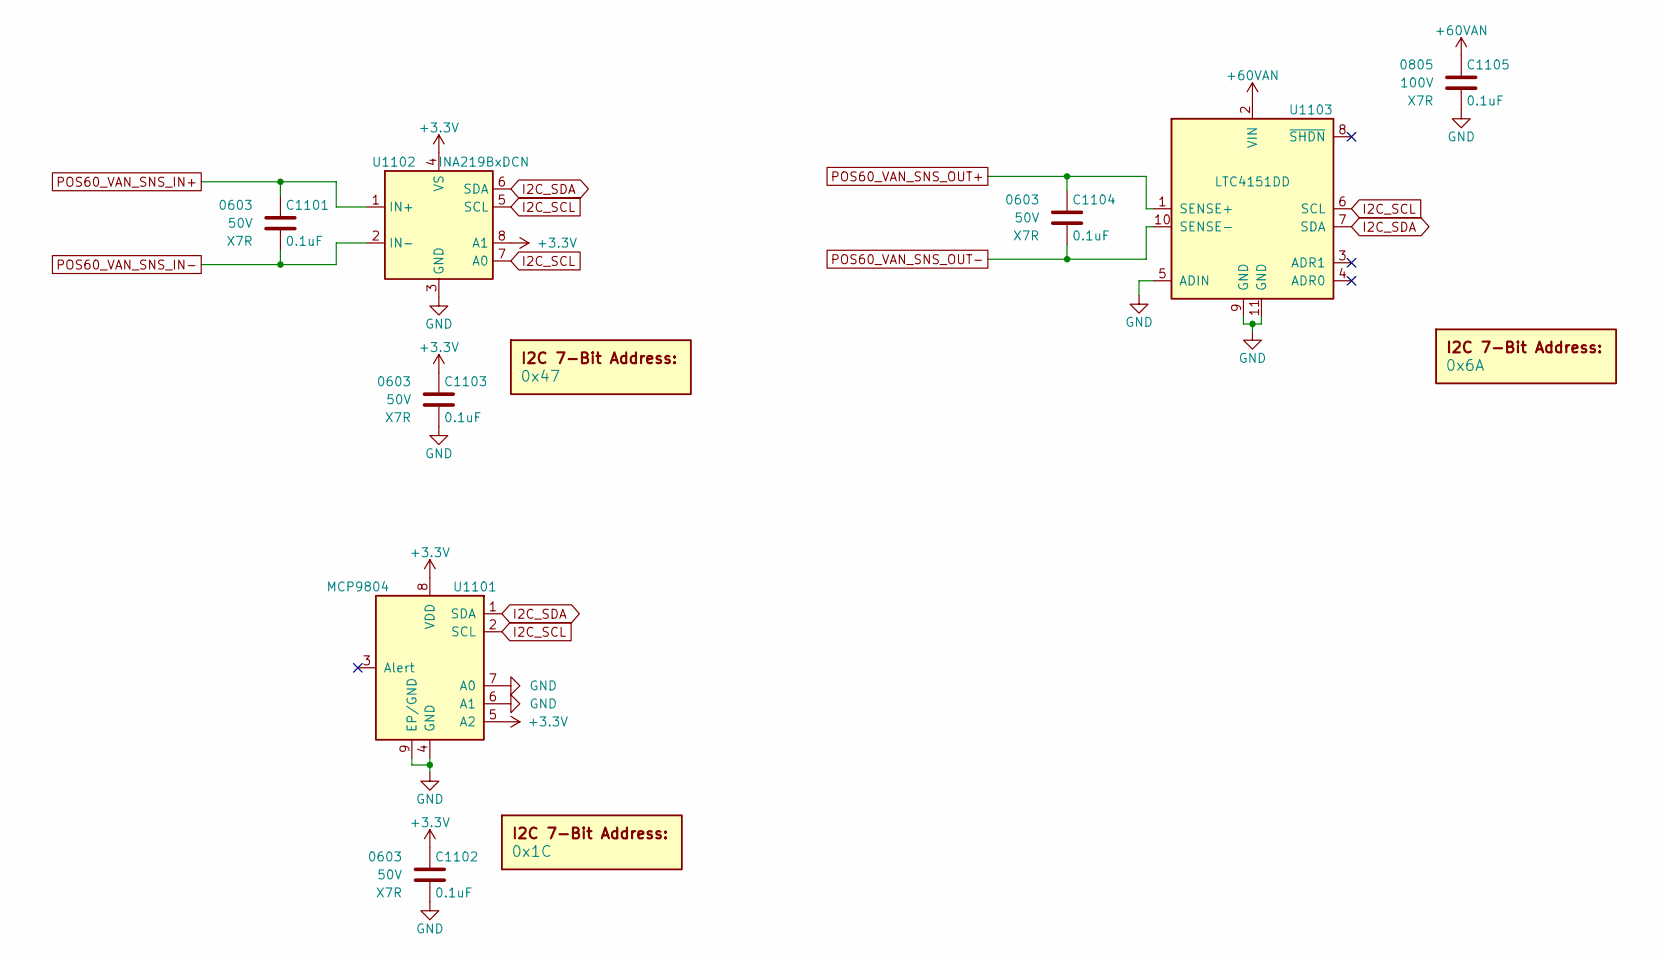
[picture p71: schematic POS60_VAN_Telemetry.sch]

Parts:
C1101, C1102, C1103, C1104: 0.1uF; C_0603; Voltage 50V; Digi-Key PN 399-6856-1-ND
C1105: 0.1uF; C_0805; Voltage 100V; Digi-Key PN 490-4789-1-ND
DOC1101: 0x1C
DOC1102: 0x47
DOC1103: 0x6A
U1101: MCP9804; DFN-8-1EP_3x2mm_P0.5mm_EP1.3x1.5mm; Digi-Key PN MCP9804T-E/MCCT-ND
U1102: INA219BxDCN; SOT-23-8; Digi-Key PN 296-46420-1-ND
U1103: LTC4151DD; DFN-10-1EP_3x3mm_Pitch0.5mm; Digi-Key PN LTC4151CDD#PBF-ND

Connections:
+3V3: C1102.1, C1103.1, U1101.5 (A2), U1101.8 (VDD), U1102.4 (VS), U1102.8 (A1); also elsewhere on the board
+60VAN: C1105.1, U1103.2 (VIN); also elsewhere on the board
GND: C1102.2, C1103.2, C1105.2, U1101.4 (GND), U1101.6 (A1), U1101.7 (A0), U1101.9 (EP/GND), U1102.3 (GND), U1103.5 (ADIN), U1103.9 (GND), U1103.11 (GND); also elsewhere on the board
I2C_SCL: U1101.2 (SCL), U1102.5 (SCL), U1102.7 (A0), U1103.6 (SCL); also elsewhere on the board
I2C_SDA: U1101.1 (SDA), U1102.6 (SDA), U1103.7 (SDA); also elsewhere on the board
POS60_VAN_SNS_IN+: C1101.1, U1102.1 (IN+); also elsewhere on the board
POS60_VAN_SNS_IN-: C1101.2, U1102.2 (IN-); also elsewhere on the board
POS60_VAN_SNS_OUT+: C1104.1, U1103.1 (SENSE+); also elsewhere on the board
POS60_VAN_SNS_OUT-: C1104.2, U1103.10 (SENSE-); also elsewhere on the board

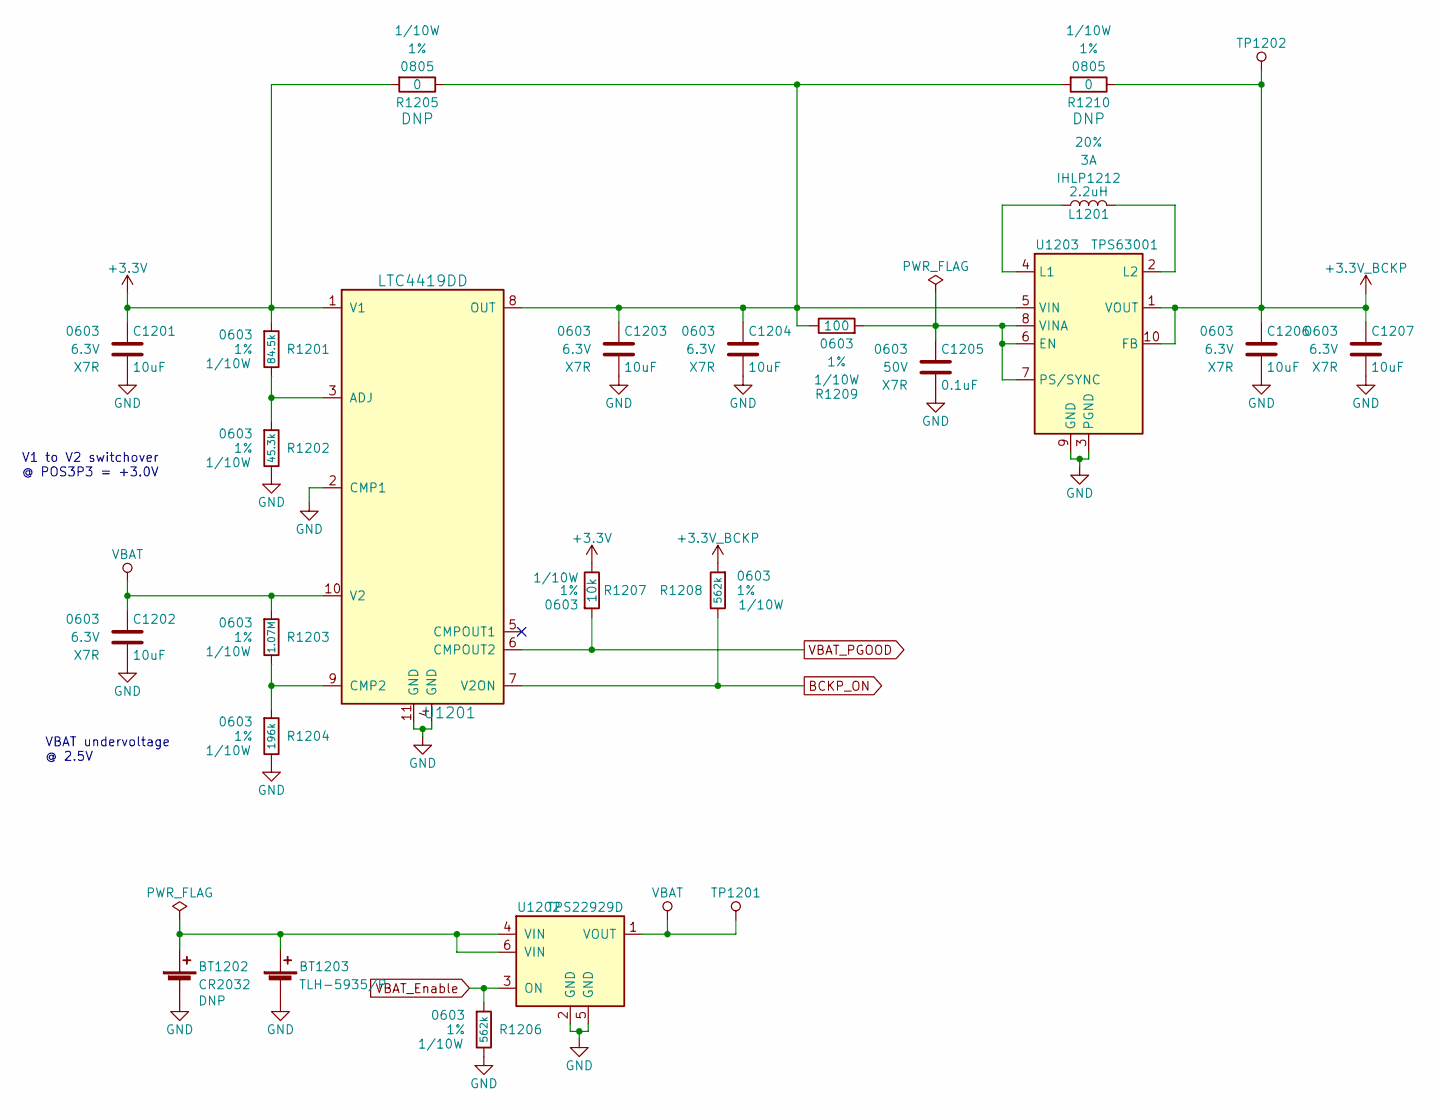
[picture p72: schematic POS3P3_BCKP_Supply.sch, VFD Clock]

Parts:
BT1202: CR2032; Keystone_1058_1x2032-CoinCell; Digi-Key PN DNP
BT1203: TLH-5935/P; TLH-5935; Digi-Key PN 439-1038-ND
C1201, C1202, C1203, C1204, C1206, C1207: 10uF; C_1206; Voltage 6.3V; Digi-Key PN 399-4938-1-ND
C1205: 0.1uF; C_0603; Voltage 50V; Digi-Key PN 399-6856-1-ND
L1201: 2.2uH; L_Vishay_IHLP-1212; Tolerance 20%; Digi-Key PN 541-1322-1-ND
R1201: 84.5k; R_0603; Tolerance 1%; Digi-Key PN RMCF0603FT84K5CT-ND
R1202: 45.3k; R_0603; Tolerance 1%; Digi-Key PN RMCF0603FT45K3CT-ND
R1203: 1.07M; R_0603; Tolerance 1%; Digi-Key PN 541-1.07MHCT-ND
R1204: 196k; R_0603; Tolerance 1%; Digi-Key PN RMCF0603FT196KCT-ND
R1205, R1210: 0; R_0805; Tolerance 1%; Digi-Key PN DNP
R1206, R1208: 562k; R_0603; Tolerance 1%; Digi-Key PN 311-562KHRCT-ND
R1207: 10k; R_0603; Tolerance 1%; Digi-Key PN P10.0KHCT-ND
R1209: 100; R_0603; Tolerance 1%; Digi-Key PN A106047CT-ND
TP1201, TP1202: TP; Test_Point
U1201: LTC4419DD; DFN-10-1EP_3x3mm_Pitch0.5mm; Digi-Key PN LTC4419IDD#PBF
U1202: TPS22929D; SOT-23-6; Digi-Key PN 296-38579-1-ND
U1203: TPS63001; Texas_DRC0010J_ThermalVias; Digi-Key PN 296-19643-1-ND

Connections:
+3.3V_BCKP: C1206.1, C1207.1, R1208.1, R1210.2, TP1202.1, U1203.1 (VOUT), U1203.10 (FB); also elsewhere on the board
+3V3: C1201.1, R1201.1, R1205.1, R1207.2, U1201.1 (V1); also elsewhere on the board
BCKP_ON: R1208.2, U1201.7 (V2ON); also elsewhere on the board
GND: BT1202.2 (-), BT1203.2 (-), C1201.2, C1202.2, C1203.2, C1204.2, C1205.2, C1206.2, C1207.2, R1202.2, R1204.2, R1206.2, U1201.2 (CMP1), U1201.4 (GND), U1201.11 (GND), U1202.2 (GND), U1202.5 (GND), U1203.3 (PGND), U1203.9 (GND), U1203.11 (PGND); also elsewhere on the board
unnamed: BT1202.1 (+), BT1203.1 (+), U1202.4 (VIN), U1202.6 (VIN)
unnamed: C1203.1, C1204.1, R1205.2, R1209.2, R1210.1, U1201.8 (OUT), U1203.5 (VIN)
unnamed: C1205.1, R1209.1, U1203.6 (EN), U1203.7 (PS/SYNC), U1203.8 (VINA)
unnamed: L1201.1, U1203.4 (L1)
unnamed: L1201.2, U1203.2 (L2)
unnamed: R1201.2, R1202.1, U1201.3 (ADJ)
unnamed: R1203.2, R1204.1, U1201.9 (CMP2)
VBAT: C1202.1, R1203.1, TP1201.1, U1201.10 (V2), U1202.1 (VOUT); also elsewhere on the board
VBAT_Enable: R1206.1, U1202.3 (ON); also elsewhere on the board
VBAT_PGOOD: R1207.1, U1201.6 (CMPOUT2); also elsewhere on the board

Notes on the sheet:
V1 to V2 switchover @ POS3P3 = +3.0V
VBAT undervoltage @ 2.5V

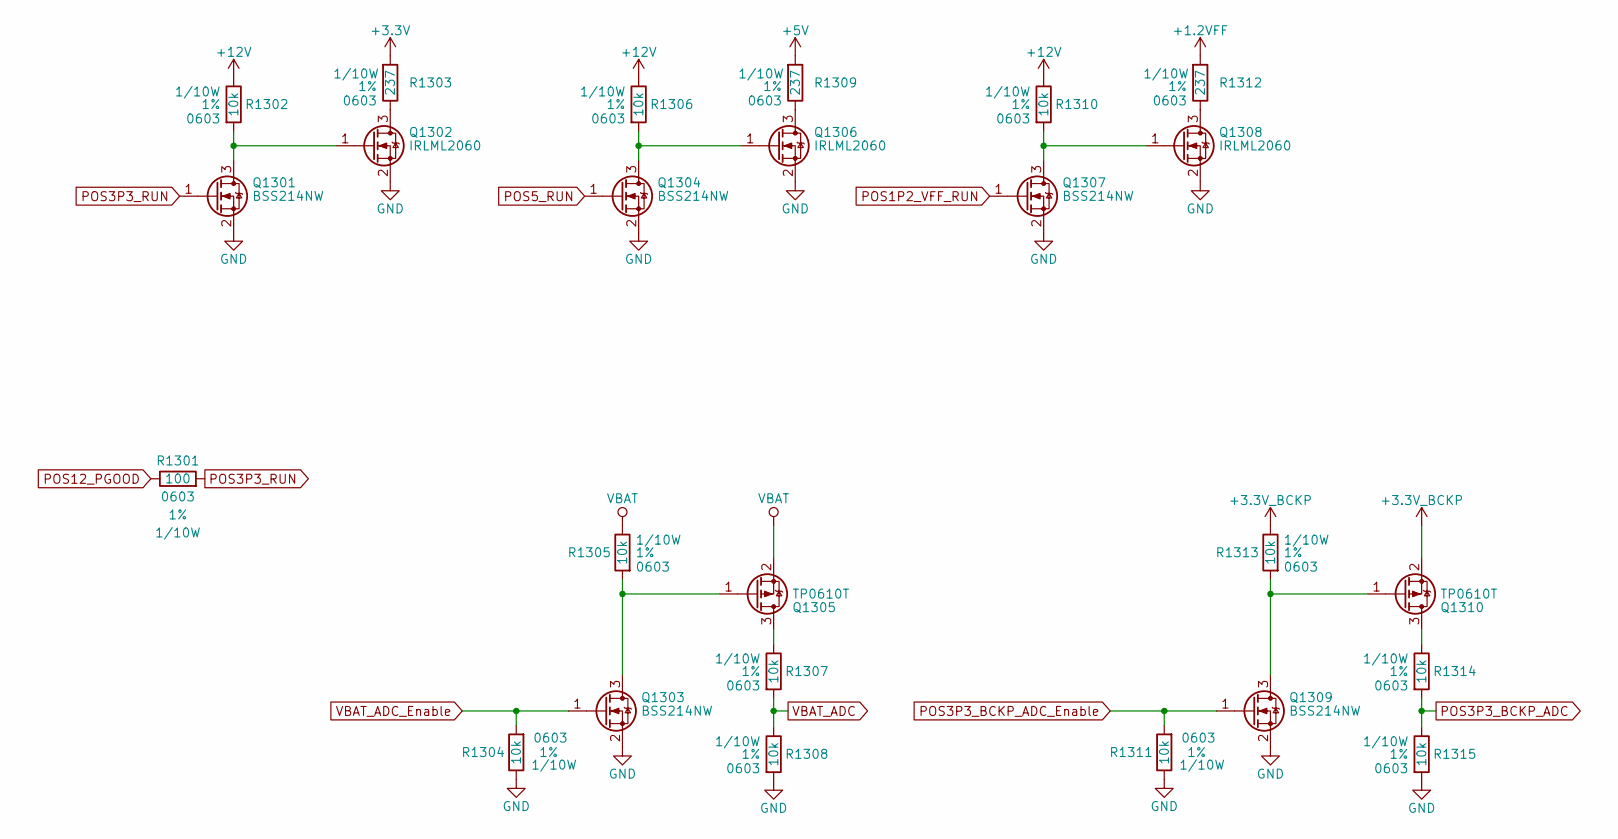
[picture p73: schematic Misc_Power.sch]

Parts:
Q1301, Q1303, Q1304, Q1307, Q1309: BSS214NW; SOT-323_SC-70; Digi-Key PN BSS214NWH6327XTSA1CT-ND
Q1302, Q1306, Q1308: IRLML2060; SOT-23; Digi-Key PN IRLML2060TRPBFCT-ND
Q1305, Q1310: TP0610T; SOT-23; Digi-Key PN TP0610T-GCT-ND
R1301: 100; R_0603; Tolerance 1%; Digi-Key PN A106047CT-ND
R1302, R1305, R1306, R1307, R1308, R1310, R1313, R1314, R1315: 10k; R_0603; Tolerance 1%; Digi-Key PN P10.0KHCT-ND
R1303, R1309, R1312: 237; R_0603; Tolerance 1%; Digi-Key PN 541-237HCT-ND
R1304, R1311: 10k; R_0603; Tolerance 1%; Digi-Key PN RMCF0603FT10K0CT-ND

Connections:
+1.2VFF: R1312.1; also elsewhere on the board
+3.3V_BCKP: Q1310.2 (S), R1313.2; also elsewhere on the board
+3V3: R1303.1; also elsewhere on the board
+5V: R1309.1; also elsewhere on the board
+12V: R1302.2, R1306.2, R1310.2; also elsewhere on the board
GND: Q1301.2 (S), Q1302.2 (S), Q1303.2 (S), Q1304.2 (S), Q1306.2 (S), Q1307.2 (S), Q1308.2 (S), Q1309.2 (S), R1304.2, R1308.1, R1311.2, R1315.1; also elsewhere on the board
unnamed: Q1301.3 (D), Q1302.1 (G), R1302.1
unnamed: Q1302.3 (D), R1303.2
unnamed: Q1303.3 (D), Q1305.1 (G), R1305.1
unnamed: Q1304.3 (D), Q1306.1 (G), R1306.1
unnamed: Q1305.3 (D), R1307.2
unnamed: Q1306.3 (D), R1309.2
unnamed: Q1307.3 (D), Q1308.1 (G), R1310.1
unnamed: Q1308.3 (D), R1312.2
unnamed: Q1309.3 (D), Q1310.1 (G), R1313.1
unnamed: Q1310.3 (D), R1314.2
POS1P2_VFF_RUN: Q1307.1 (G); also elsewhere on the board
POS3P3_BCKP_ADC: R1314.1, R1315.2; also elsewhere on the board
POS3P3_BCKP_ADC_Enable: Q1309.1 (G), R1311.1; also elsewhere on the board
POS3P3_RUN: Q1301.1 (G), R1301.1; also elsewhere on the board
POS5_RUN: Q1304.1 (G); also elsewhere on the board
POS12_PGOOD: R1301.2; also elsewhere on the board
VBAT: Q1305.2 (S), R1305.2; also elsewhere on the board
VBAT_ADC: R1307.1, R1308.2; also elsewhere on the board
VBAT_ADC_Enable: Q1303.1 (G), R1304.1; also elsewhere on the board

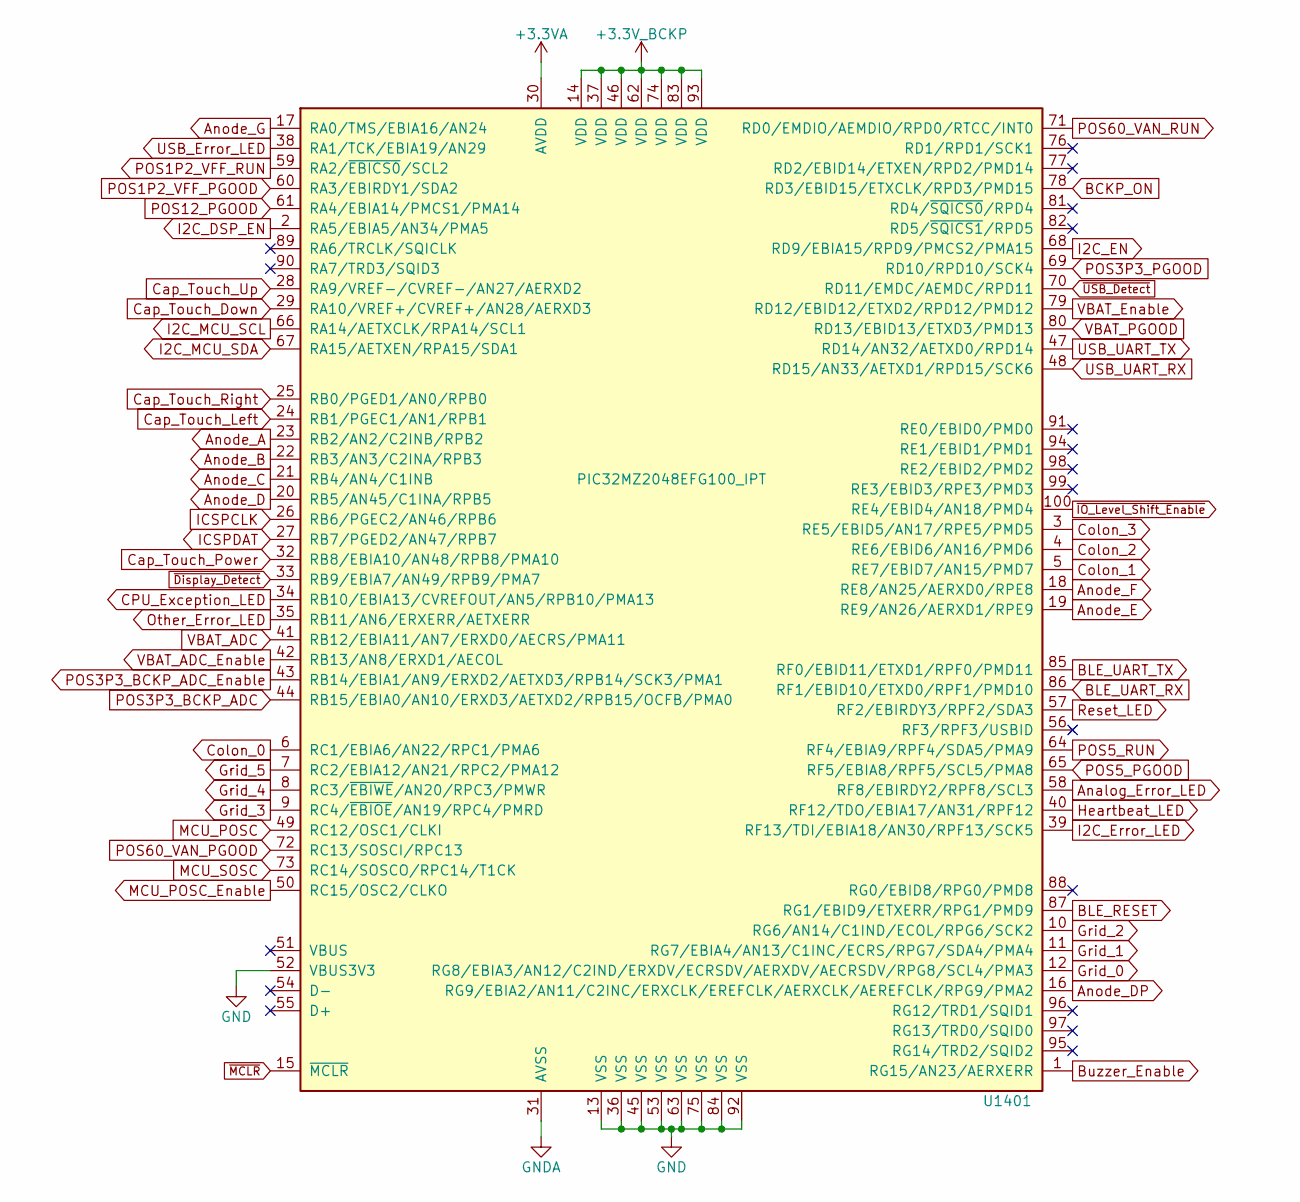
[picture p74: schematic Microcontroller.sch, VFD Clock]

Parts:
U1401: PIC32MZ2048EFG100_IPT; TQFP-100_14x14mm_Pitch0.5mm; Digi-Key PN PIC32MZ2048EFG100-I/PT-ND

Connections:
+3.3VA: U1401.30 (AVDD); also elsewhere on the board
+3.3V_BCKP: U1401.14 (VDD), U1401.37 (VDD), U1401.46 (VDD), U1401.62 (VDD), U1401.74 (VDD), U1401.83 (VDD), U1401.93 (VDD); also elsewhere on the board
Analog_Error_LED: U1401.58 (RF8/EBIRDY2/RPF8/SCL3); also elsewhere on the board
Anode_A: U1401.23 (RB2/AN2/C2INB/RPB2); also elsewhere on the board
Anode_B: U1401.22 (RB3/AN3/C2INA/RPB3); also elsewhere on the board
Anode_C: U1401.21 (RB4/AN4/C1INB); also elsewhere on the board
Anode_D: U1401.20 (RB5/AN45/C1INA/RPB5); also elsewhere on the board
Anode_DP: U1401.16 (RG9/EBIA2/AN11/C2INC/ERXCLK/EREFCLK/AER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); also elsewhere on the board
Anode_E: U1401.19 (RE9/AN26/AERXD1/RPE9); also elsewhere on the board
Anode_F: U1401.18 (RE8/AN25/AERXD0/RPE8); also elsewhere on the board
Anode_G: U1401.17 (RA0/TMS/EBIA16/AN24); also elsewhere on the board
BCKP_ON: U1401.78 (RD3/EBID15/ETXCLK/RPD3/PMD15); also elsewhere on the board
BLE_RESET: U1401.87 (RG1/EBID9/ETXERR/RPG1/PMD9); also elsewhere on the board
BLE_UART_RX: U1401.86 (RF1/EBID10/ETXD0/RPF1/PMD10); also elsewhere on the board
BLE_UART_TX: U1401.85 (RF0/EBID11/ETXD1/RPF0/PMD11); also elsewhere on the board
Buzzer_Enable: U1401.1 (RG15/AN23/AERXERR); also elsewhere on the board
CPU_Exception_LED: U1401.34 (RB10/EBIA13/CVREFOUT/AN5/RPB10/PMA13); also elsewhere on the board
Cap_Touch_Down: U1401.29 (RA10/VREF+/CVREF+/AN28/AERXD3); also elsewhere on the board
Cap_Touch_Left: U1401.24 (RB1/PGEC1/AN1/RPB1); also elsewhere on the board
Cap_Touch_Power: U1401.32 (RB8/EBIA10/AN48/RPB8/PMA10); also elsewhere on the board
Cap_Touch_Right: U1401.25 (RB0/PGED1/AN0/RPB0); also elsewhere on the board
Cap_Touch_Up: U1401.28 (RA9/VREF-/CVREF-/AN27/AERXD2); also elsewhere on the board
Colon_0: U1401.6 (RC1/EBIA6/AN22/RPC1/PMA6); also elsewhere on the board
Colon_1: U1401.5 (RE7/EBID7/AN15/PMD7); also elsewhere on the board
Colon_2: U1401.4 (RE6/EBID6/AN16/PMD6); also elsewhere on the board
Colon_3: U1401.3 (RE5/EBID5/AN17/RPE5/PMD5); also elsewhere on the board
GND: U1401.13 (VSS), U1401.36 (VSS), U1401.45 (VSS), U1401.52 (VBUS3V3), U1401.53 (VSS), U1401.63 (VSS), U1401.75 (VSS), U1401.84 (VSS), U1401.92 (VSS); also elsewhere on the board
GNDA: U1401.31 (AVSS); also elsewhere on the board
Grid_0: U1401.12 (RG8/EBIA3/AN12/C2IND/ERXDV/ECRSDV/AERXD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); also elsewhere on the board
Grid_1: U1401.11 (RG7/EBIA4/AN13/C1INC/ECRS/RPG7/SDA4/PMA4); also elsewhere on the board
Grid_2: U1401.10 (RG6/AN14/C1IND/ECOL/RPG6/SCK2); also elsewhere on the board
Grid_3: U1401.9 (RC4/~EBIOE~/AN19/RPC4/PMRD); also elsewhere on the board
Grid_4: U1401.8 (RC3/~EBIWE~/AN20/RPC3/PMWR); also elsewhere on the board
Grid_5: U1401.7 (RC2/EBIA12/AN21/RPC2/PMA12); also elsewhere on the board
Heartbeat_LED: U1401.40 (RF12/TDO/EBIA17/AN31/RPF12); also elsewhere on the board
I2C_DSP_EN: U1401.2 (RA5/EBIA5/AN34/PMA5); also elsewhere on the board
I2C_EN: U1401.68 (RD9/EBIA15/RPD9/PMCS2/PMA15); also elsewhere on the board
I2C_Error_LED: U1401.39 (RF13/TDI/EBIA18/AN30/RPF13/SCK5); also elsewhere on the board
I2C_MCU_SCL: U1401.66 (RA14/AETXCLK/RPA14/SCL1); also elsewhere on the board
I2C_MCU_SDA: U1401.67 (RA15/AETXEN/RPA15/SDA1); also elsewhere on the board
ICSPCLK: U1401.26 (RB6/PGEC2/AN46/RPB6); also elsewhere on the board
ICSPDAT: U1401.27 (RB7/PGED2/AN47/RPB7); also elsewhere on the board
MCU_POSC: U1401.49 (RC12/OSC1/CLKI); also elsewhere on the board
MCU_POSC_Enable: U1401.50 (RC15/OSC2/CLKO); also elsewhere on the board
MCU_SOSC: U1401.73 (RC14/SOSCO/RPC14/T1CK); also elsewhere on the board
Other_Error_LED: U1401.35 (RB11/AN6/ERXERR/AETXERR); also elsewhere on the board
POS1P2_VFF_PGOOD: U1401.60 (RA3/EBIRDY1/SDA2); also elsewhere on the board
POS1P2_VFF_RUN: U1401.59 (RA2/~EBICS0~/SCL2); also elsewhere on the board
POS3P3_BCKP_ADC: U1401.44 (RB15/EBIA0/AN10/ERXD3/AETXD2/RPB15/OCFB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); also elsewhere on the board
POS3P3_BCKP_ADC_Enable: U1401.43 (RB14/EBIA1/AN9/ERXD2/AETXD3/RPB14/SCK3/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); also elsewhere on the board
POS3P3_PGOOD: U1401.69 (RD10/RPD10/SCK4); also elsewhere on the board
POS5_PGOOD: U1401.65 (RF5/EBIA8/RPF5/SCL5/PMA8); also elsewhere on the board
POS5_RUN: U1401.64 (RF4/EBIA9/RPF4/SDA5/PMA9); also elsewhere on the board
POS12_PGOOD: U1401.61 (RA4/EBIA14/PMCS1/PMA14); also elsewhere on the board
POS60_VAN_PGOOD: U1401.72 (RC13/SOSCI/RPC13); also elsewhere on the board
POS60_VAN_RUN: U1401.71 (RD0/EMDIO/AEMDIO/RPD0/RTCC/INT0); also elsewhere on the board
Reset_LED: U1401.57 (RF2/EBIRDY3/RPF2/SDA3); also elsewhere on the board
USB_Error_LED: U1401.38 (RA1/TCK/EBIA19/AN29); also elsewhere on the board
USB_UART_RX: U1401.48 (RD15/AN33/AETXD1/RPD15/SCK6); also elsewhere on the board
USB_UART_TX: U1401.47 (RD14/AN32/AETXD0/RPD14); also elsewhere on the board
VBAT_ADC: U1401.41 (RB12/EBIA11/AN7/ERXD0/AECRS/PMA11); also elsewhere on the board
VBAT_ADC_Enable: U1401.42 (RB13/AN8/ERXD1/AECOL); also elsewhere on the board
VBAT_Enable: U1401.79 (RD12/EBID12/ETXD2/RPD12/PMD12); also elsewhere on the board
VBAT_PGOOD: U1401.80 (RD13/EBID13/ETXD3/PMD13); also elsewhere on the board
~Display_Detect: U1401.33 (RB9/EBIA7/AN49/RPB9/PMA7); also elsewhere on the board
~IO_Level_Shift_Enable: U1401.100 (RE4/EBID4/AN18/PMD4); also elsewhere on the board
~MCLR: U1401.15 (~MCLR~); also elsewhere on the board
~USB_Detect: U1401.70 (RD11/EMDC/AEMDC/RPD11); also elsewhere on the board

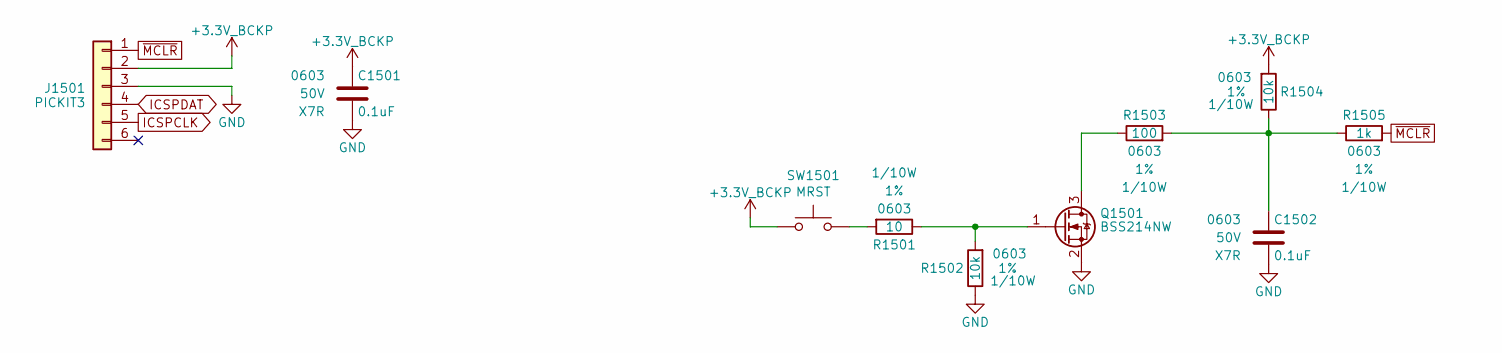
[picture p75: schematic Microcontroller_Programming.sch, VFD Clock]

Parts:
C1501, C1502: 0.1uF; C_0603; Voltage 50V; Digi-Key PN 311-1344-1-ND
J1501: PICKIT3; PICKIT3_Header
Q1501: BSS214NW; SOT-323_SC-70; Digi-Key PN BSS214NWH6327XTSA1CT-ND
R1501: 10; R_0603; Tolerance 1%; Digi-Key PN YAG3351CT-ND
R1502, R1504: 10k; R_0603; Tolerance 1%; Digi-Key PN RMCF0603FT10K0CT-ND
R1503: 100; R_0603; Tolerance 1%; Digi-Key PN A106047CT-ND
R1505: 1k; R_0603; Tolerance 1%; Digi-Key PN RMCF0603FT1K00CT-ND
SW1501: MRST; SW_PUSH_6mm

Connections:
+3.3V_BCKP: C1501.1, J1501.2, R1504.1, SW1501.1; also elsewhere on the board
GND: C1501.2, C1502.2, J1501.3, Q1501.2 (S), R1502.2; also elsewhere on the board
ICSPCLK: J1501.5; also elsewhere on the board
ICSPDAT: J1501.4; also elsewhere on the board
unnamed: C1502.1, R1503.1, R1504.2, R1505.2
unnamed: Q1501.1 (G), R1501.2, R1502.1
unnamed: Q1501.3 (D), R1503.2
unnamed: R1501.1, SW1501.2
~MCLR: J1501.1, R1505.1; also elsewhere on the board

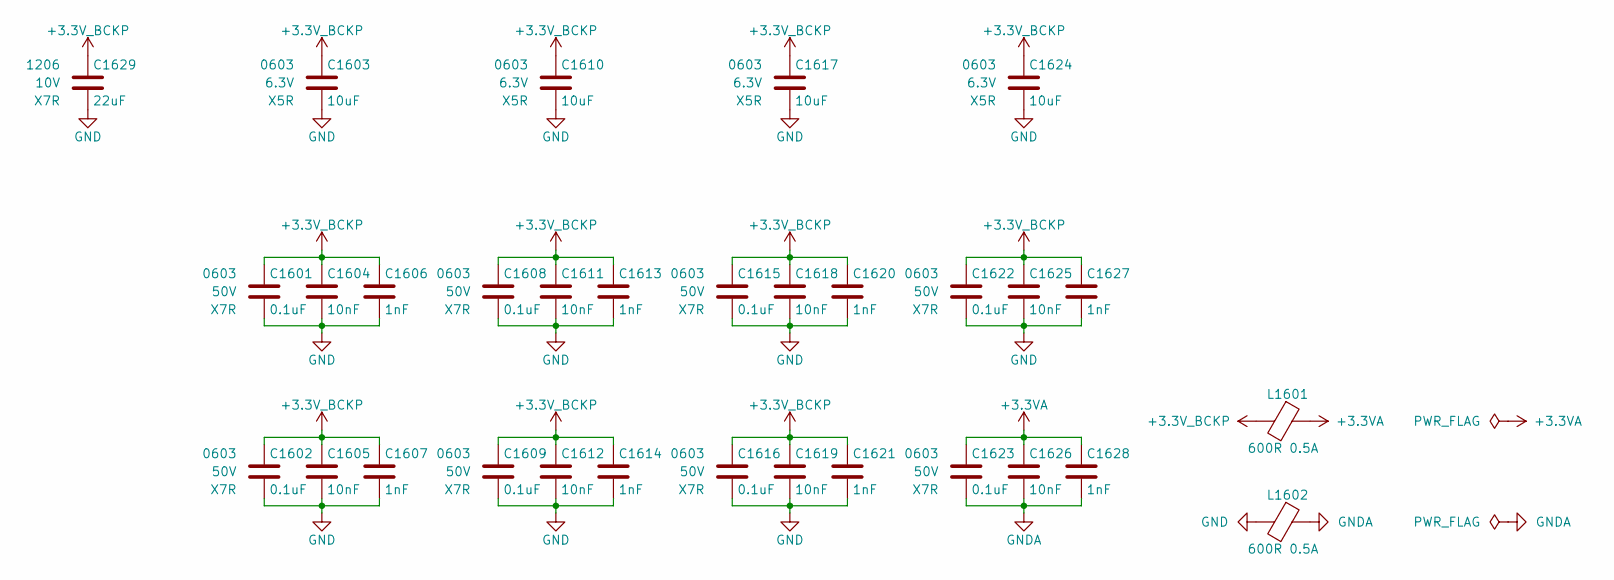
[picture p76: schematic Microcontroller_Bypass.sch]

Parts:
C1601, C1602, C1608, C1609, C1615, C1616, C1622, C1623: 0.1uF; C_0603; Voltage 50V; Digi-Key PN 399-6856-1-ND
C1603, C1610, C1617, C1624: 10uF; C_0603; Voltage 6.3V; Digi-Key PN 490-12538-1-ND
C1604, C1605, C1611, C1612, C1618, C1619, C1625, C1626: 10nF; C_0603; Voltage 50V; Digi-Key PN 399-1092-1-ND
C1606, C1607, C1613, C1614, C1620, C1621, C1627, C1628: 1nF; C_0603; Voltage 50V; Digi-Key PN 399-1083-1-ND
C1629: 22uF; C_1206; Voltage 10V; Digi-Key PN 1276-3148-1-ND
L1601, L1602: 600R 0.5A; L_0603; Digi-Key PN 732-2389-1-ND

Connections:
+3.3VA: C1623.1, C1626.1, C1628.1, L1601.1; also elsewhere on the board
+3.3V_BCKP: C1601.1, C1602.1, C1603.1, C1604.1, C1605.1, C1606.1, C1607.1, C1608.1, C1609.1, C1610.1, C1611.1, C1612.1, C1613.1, C1614.1, C1615.1, C1616.1, C1617.1, C1618.1, C1619.1, C1620.1, C1621.1, C1622.1, C1624.1, C1625.1, C1627.1, C1629.1, L1601.2; also elsewhere on the board
GND: C1601.2, C1602.2, C1603.2, C1604.2, C1605.2, C1606.2, C1607.2, C1608.2, C1609.2, C1610.2, C1611.2, C1612.2, C1613.2, C1614.2, C1615.2, C1616.2, C1617.2, C1618.2, C1619.2, C1620.2, C1621.2, C1622.2, C1624.2, C1625.2, C1627.2, C1629.2, L1602.2; also elsewhere on the board
GNDA: C1623.2, C1626.2, C1628.2, L1602.1; also elsewhere on the board

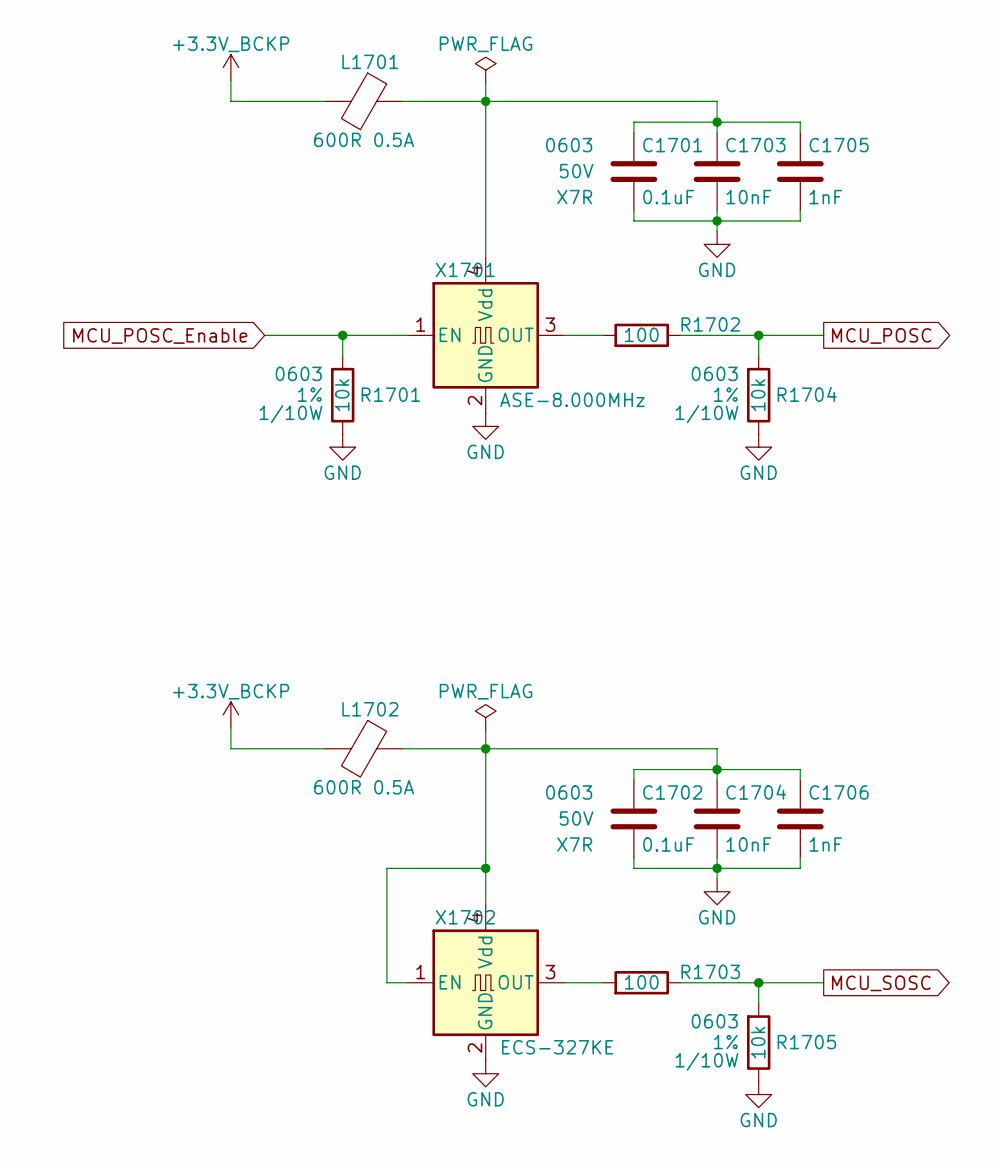
[picture p77: schematic Microcontroller_Clocking.sch]

Parts:
C1701, C1702: 0.1uF; C_0603; Voltage 50V; Digi-Key PN 399-6856-1-ND
C1703, C1704: 10nF; C_0603; Voltage 50V; Digi-Key PN 399-1092-1-ND
C1705, C1706: 1nF; C_0603; Voltage 50V; Digi-Key PN 399-1083-1-ND
L1701, L1702: 600R 0.5A; L_0603; Digi-Key PN 732-2389-1-ND
R1701, R1704, R1705: 10k; R_0603; Tolerance 1%; Digi-Key PN RMCF0603FT10K0CT-ND
R1702, R1703: 100; R_0603; Tolerance 1%; Digi-Key PN A106047CT-ND
X1701: ASE-8.000MHz; Oscillator_SMD_Abracon_ASE-4Pin_3.2x2.5mm; Digi-Key PN 535-9558-1-ND
X1702: ECS-327KE; Digi-Key PN XC1751CT-ND

Connections:
+3.3V_BCKP: L1701.2, L1702.2; also elsewhere on the board
GND: C1701.2, C1702.2, C1703.2, C1704.2, C1705.2, C1706.2, R1701.2, R1704.2, R1705.2, X1701.2 (GND), X1702.2 (GND); also elsewhere on the board
MCU_POSC: R1702.2, R1704.1; also elsewhere on the board
MCU_POSC_Enable: R1701.1, X1701.1 (EN); also elsewhere on the board
MCU_SOSC: R1703.2, R1705.1; also elsewhere on the board
unnamed: C1701.1, C1703.1, C1705.1, L1701.1, X1701.4 (Vdd)
unnamed: C1702.1, C1704.1, C1706.1, L1702.1, X1702.1 (EN), X1702.4 (Vdd)
unnamed: R1702.1, X1701.3 (OUT)
unnamed: R1703.1, X1702.3 (OUT)
