drewsum/VFD_Clock/rev_a/hdw/Logic_Board/VFD_Clock/VFD_Clock.kicad_pcb

## KiCad design rev_a/hdw/Logic_Board/VFD_Clock/VFD_Clock.kicad_pcb (continued)

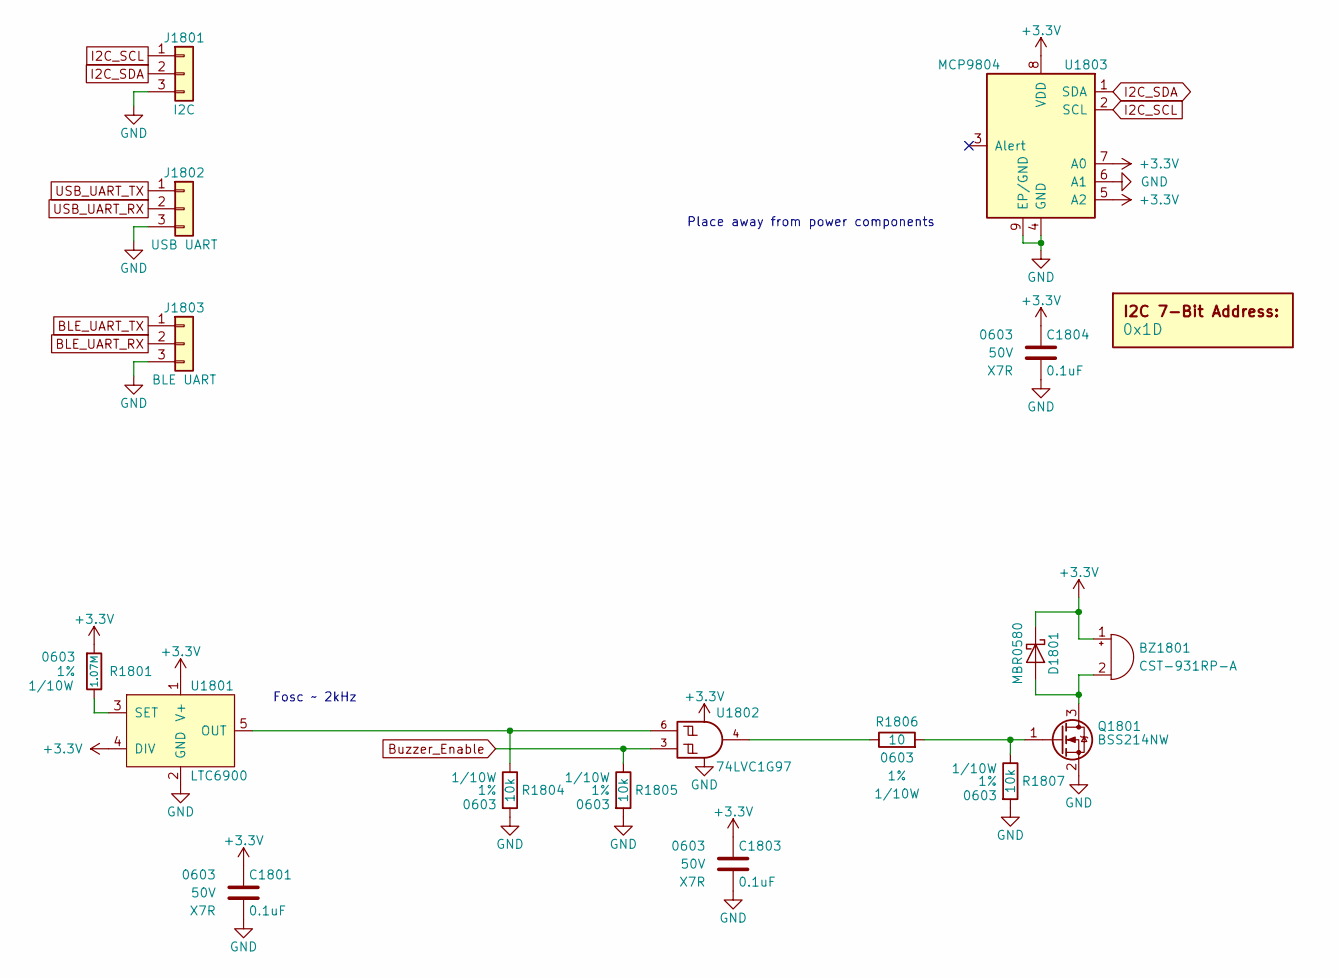
[picture p78: schematic Misc_Circuits.sch]

Parts:
BZ1801: CST-931RP-A; MagneticBuzzer_CUI_CST-931RP-A; Digi-Key PN 102-1461-ND
C1801, C1803, C1804: 0.1uF; C_0603; Voltage 50V; Digi-Key PN 399-6856-1-ND
D1801: MBR0580; D_SOD-123; Digi-Key PN MBR0580S1-7DICT-ND
DOC1801: 0x1D
J1801: I2C; Pin_Header_Straight_1x03_Pitch2.54mm
J1802: USB UART; Pin_Header_Straight_1x03_Pitch2.54mm
J1803: BLE UART; Pin_Header_Straight_1x03_Pitch2.54mm
Q1801: BSS214NW; SOT-323_SC-70; Digi-Key PN BSS214NWH6327XTSA1CT-ND
R1801: 1.07M; R_0603; Tolerance 1%; Digi-Key PN 541-1.07MHCT-ND
R1804, R1805, R1807: 10k; R_0603; Tolerance 1%; Digi-Key PN P10.0KHCT-ND
R1806: 10; R_0603; Tolerance 1%; Digi-Key PN YAG3351CT-ND
U1801: LTC6900; SOT-23-5; Digi-Key PN LTC6900CS5#TRMPBFCT-ND
U1802: 74LVC1G97; SOT-363_SC-70-6; Digi-Key PN 296-15582-1-ND
U1803: MCP9804; DFN-8-1EP_3x2mm_P0.5mm_EP1.3x1.5mm; Digi-Key PN MCP9804T-E/MCCT-ND

Connections:
+3V3: BZ1801.1 (-), C1801.1, C1803.1, C1804.1, D1801.1 (K), R1801.1, U1801.1 (V+), U1801.4 (DIV), U1802.5 (VCC), U1803.5 (A2), U1803.7 (A0), U1803.8 (VDD); also elsewhere on the board
BLE_UART_RX: J1803.2; also elsewhere on the board
BLE_UART_TX: J1803.1; also elsewhere on the board
Buzzer_Enable: R1805.2, U1802.3; also elsewhere on the board
GND: C1801.2, C1803.2, C1804.2, J1801.3, J1802.3, J1803.3, Q1801.2 (S), R1804.1, R1805.1, R1807.1, U1801.2 (GND), U1802.1 (GND), U1802.2 (GND), U1803.4 (GND), U1803.6 (A1), U1803.9 (EP/GND); also elsewhere on the board
I2C_SCL: J1801.1, U1803.2 (SCL); also elsewhere on the board
I2C_SDA: J1801.2, U1803.1 (SDA); also elsewhere on the board
unnamed: BZ1801.2 (+), D1801.2 (A), Q1801.3 (D)
unnamed: Q1801.1 (G), R1806.1, R1807.2
unnamed: R1801.2, U1801.3 (SET)
unnamed: R1804.2, U1801.5 (OUT), U1802.6
unnamed: R1806.2, U1802.4
USB_UART_RX: J1802.2; also elsewhere on the board
USB_UART_TX: J1802.1; also elsewhere on the board

Notes on the sheet:
Place away from power components
Fosc ~~ 2kHz

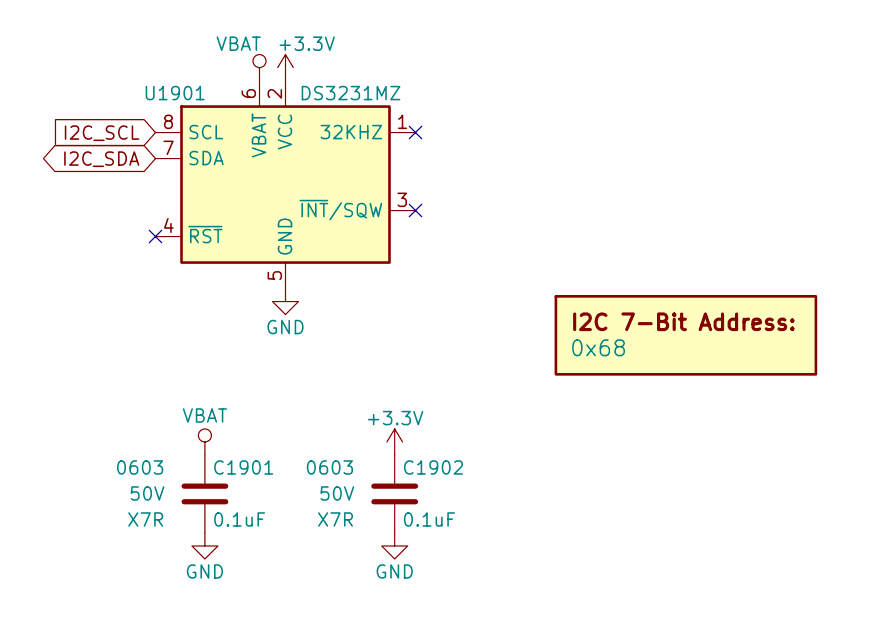
[picture p79: schematic Backup_RTC.sch]

Parts:
C1901, C1902: 0.1uF; C_0603; Voltage 50V; Digi-Key PN 311-1344-1-ND
U1901: DS3231MZ; SOIC-8_3.9x4.9mm_P1.27mm; Digi-Key PN DS3231MZ+-ND

Connections:
+3V3: C1902.1, U1901.2 (VCC); also elsewhere on the board
GND: C1901.2, C1902.2, U1901.5 (GND); also elsewhere on the board
I2C_SCL: U1901.8 (SCL); also elsewhere on the board
I2C_SDA: U1901.7 (SDA); also elsewhere on the board
VBAT: C1901.1, U1901.6 (VBAT); also elsewhere on the board

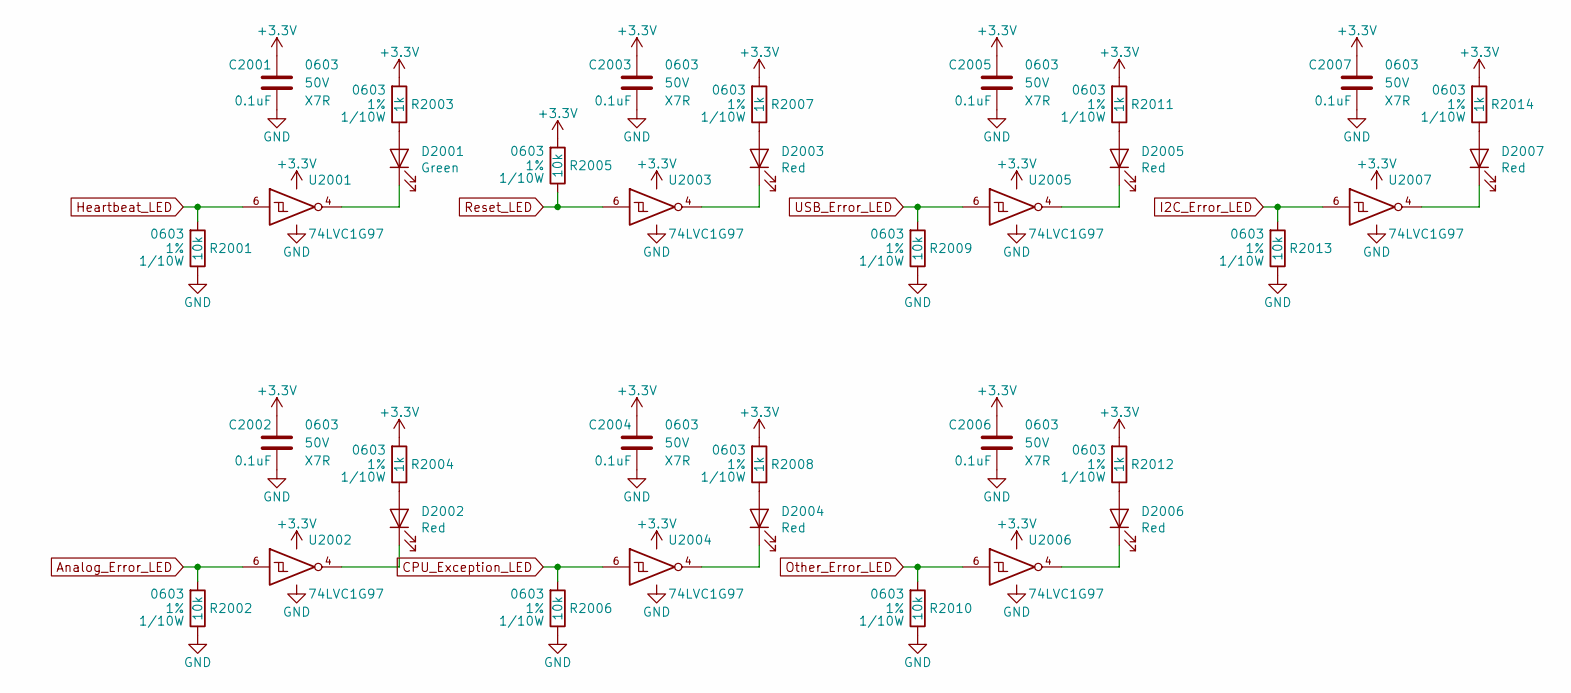
[picture p80: schematic Status_LEDs.sch]

Parts:
C2001, C2002, C2003, C2004, C2005, C2006, C2007: 0.1uF; C_0603; Voltage 50V; Digi-Key PN 311-1344-1-ND
D2001: Green; LED_0603; Digi-Key PN 160-1446-1-ND
D2002, D2003, D2004, D2005, D2006, D2007: Red; LED_0603; Digi-Key PN 160-1447-1-ND
R2001, R2002, R2005, R2006, R2009, R2010, R2013: 10k; R_0603; Tolerance 1%; Digi-Key PN RMCF0603FT10K0CT-ND
R2003, R2004, R2007, R2008, R2011, R2012, R2014: 1k; R_0603; Tolerance 1%; Digi-Key PN RMCF0603FT1K00CT-ND
U2001, U2002, U2003, U2004, U2005, U2006, U2007: 74LVC1G97; SOT-363_SC-70-6; Digi-Key PN 296-15582-1-ND

Connections:
+3V3: C2001.1, C2002.1, C2003.1, C2004.1, C2005.1, C2006.1, C2007.1, R2003.1, R2004.1, R2005.1, R2007.1, R2008.1, R2011.1, R2012.1, R2014.1, U2001.1 (VCC), U2001.5 (VCC), U2002.1 (VCC), U2002.5 (VCC), U2003.1 (VCC), U2003.5 (VCC), U2004.1 (VCC), U2004.5 (VCC), U2005.1 (VCC), U2005.5 (VCC), U2006.1 (VCC), U2006.5 (VCC), U2007.1 (VCC), U2007.5 (VCC); also elsewhere on the board
Analog_Error_LED: R2002.1, U2002.6; also elsewhere on the board
CPU_Exception_LED: R2006.1, U2004.6; also elsewhere on the board
GND: C2001.2, C2002.2, C2003.2, C2004.2, C2005.2, C2006.2, C2007.2, R2001.2, R2002.2, R2006.2, R2009.2, R2010.2, R2013.2, U2001.2 (GND), U2001.3 (GND), U2002.2 (GND), U2002.3 (GND), U2003.2 (GND), U2003.3 (GND), U2004.2 (GND), U2004.3 (GND), U2005.2 (GND), U2005.3 (GND), U2006.2 (GND), U2006.3 (GND), U2007.2 (GND), U2007.3 (GND); also elsewhere on the board
Heartbeat_LED: R2001.1, U2001.6; also elsewhere on the board
I2C_Error_LED: R2013.1, U2007.6; also elsewhere on the board
unnamed: D2001.1 (K), U2001.4
unnamed: D2001.2 (A), R2003.2
unnamed: D2002.1 (K), U2002.4
unnamed: D2002.2 (A), R2004.2
unnamed: D2003.1 (K), U2003.4
unnamed: D2003.2 (A), R2007.2
unnamed: D2004.1 (K), U2004.4
unnamed: D2004.2 (A), R2008.2
unnamed: D2005.1 (K), U2005.4
unnamed: D2005.2 (A), R2011.2
unnamed: D2006.1 (K), U2006.4
unnamed: D2006.2 (A), R2012.2
unnamed: D2007.1 (K), U2007.4
unnamed: D2007.2 (A), R2014.2
Other_Error_LED: R2010.1, U2006.6; also elsewhere on the board
Reset_LED: R2005.2, U2003.6; also elsewhere on the board
USB_Error_LED: R2009.1, U2005.6; also elsewhere on the board

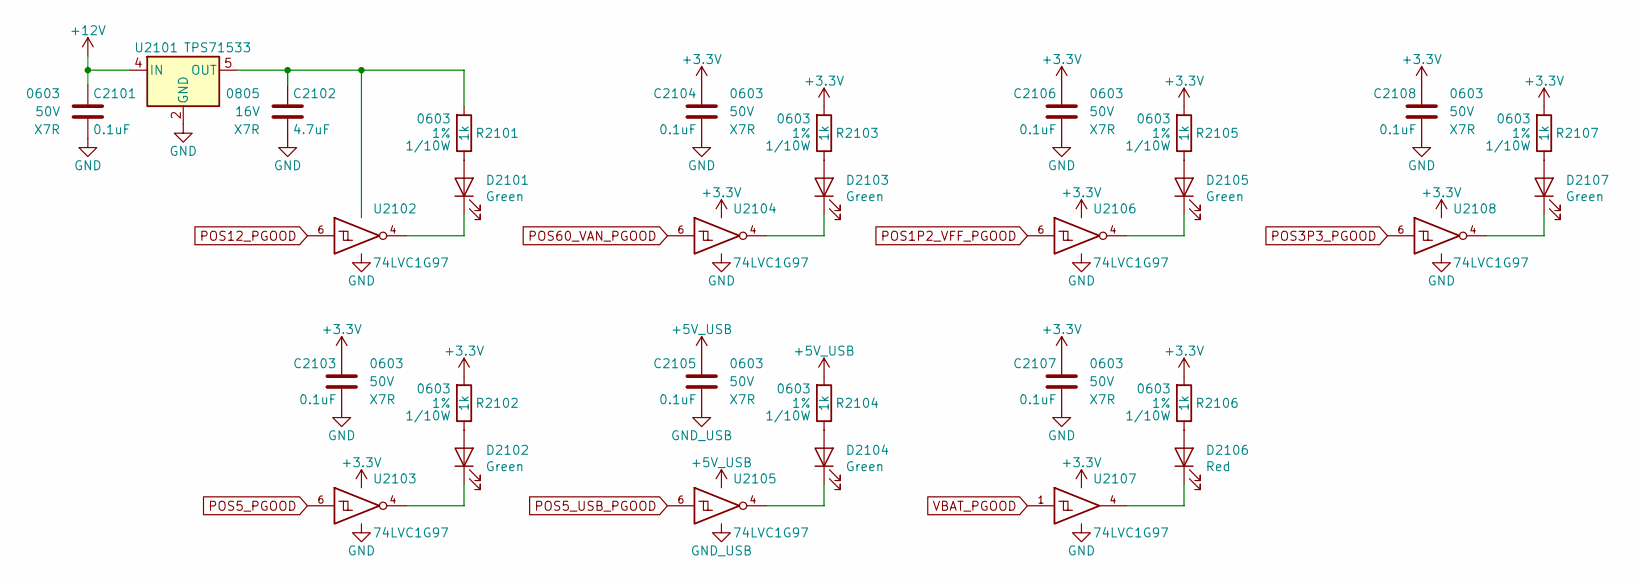
[picture p81: schematic PGOOD_LEDs.sch]

Parts:
C2101, C2103, C2104, C2105, C2106, C2107, C2108: 0.1uF; C_0603; Voltage 50V; Digi-Key PN 311-1344-1-ND
C2102: 4.7uF; C_0805; Voltage 16V; Digi-Key PN 1276-2970-1-ND
D2101, D2102, D2103, D2104, D2105, D2107: Green; LED_0603; Digi-Key PN 160-1446-1-ND
D2106: Red; LED_0603; Digi-Key PN 160-1447-1-ND
R2101, R2102, R2103, R2104, R2105, R2106, R2107: 1k; R_0603; Tolerance 1%; Digi-Key PN RMCF0603FT1K00CT-ND
U2101: TPS71533; SOT-353_SC-70-5; Digi-Key PN 296-12008-1-ND
U2102, U2103, U2104, U2105, U2106, U2107, U2108: 74LVC1G97; SOT-363_SC-70-6; Digi-Key PN 296-15582-1-ND

Connections:
+3V3: C2103.1, C2104.1, C2106.1, C2107.1, C2108.1, R2102.1, R2103.1, R2105.1, R2106.1, R2107.1, U2103.1 (VCC), U2103.5 (VCC), U2104.1 (VCC), U2104.5 (VCC), U2106.1 (VCC), U2106.5 (VCC), U2107.5 (VCC), U2108.1 (VCC), U2108.5 (VCC); also elsewhere on the board
+5V_USB: C2105.1, R2104.1, U2105.1 (VCC), U2105.5 (VCC); also elsewhere on the board
+12V: C2101.1, U2101.4 (IN); also elsewhere on the board
GND: C2101.2, C2102.2, C2103.2, C2104.2, C2106.2, C2107.2, C2108.2, U2101.2 (GND), U2102.2 (GND), U2102.3 (GND), U2103.2 (GND), U2103.3 (GND), U2104.2 (GND), U2104.3 (GND), U2106.2 (GND), U2106.3 (GND), U2107.2 (GND), U2107.3 (GND), U2107.6 (GND), U2108.2 (GND), U2108.3 (GND); also elsewhere on the board
GND_USB: C2105.2, U2105.2 (GND), U2105.3 (GND); also elsewhere on the board
unnamed: C2102.1, R2101.1, U2101.5 (OUT), U2102.1 (VCC), U2102.5 (VCC)
unnamed: D2101.1 (K), U2102.4
unnamed: D2101.2 (A), R2101.2
unnamed: D2102.1 (K), U2103.4
unnamed: D2102.2 (A), R2102.2
unnamed: D2103.1 (K), U2104.4
unnamed: D2103.2 (A), R2103.2
unnamed: D2104.1 (K), U2105.4
unnamed: D2104.2 (A), R2104.2
unnamed: D2105.1 (K), U2106.4
unnamed: D2105.2 (A), R2105.2
unnamed: D2106.1 (K), U2107.4
unnamed: D2106.2 (A), R2106.2
unnamed: D2107.1 (K), U2108.4
unnamed: D2107.2 (A), R2107.2
POS1P2_VFF_PGOOD: U2106.6; also elsewhere on the board
POS3P3_PGOOD: U2108.6; also elsewhere on the board
POS5_PGOOD: U2103.6; also elsewhere on the board
POS5_USB_PGOOD: U2105.6; also elsewhere on the board
POS12_PGOOD: U2102.6; also elsewhere on the board
POS60_VAN_PGOOD: U2104.6; also elsewhere on the board
VBAT_PGOOD: U2107.1; also elsewhere on the board

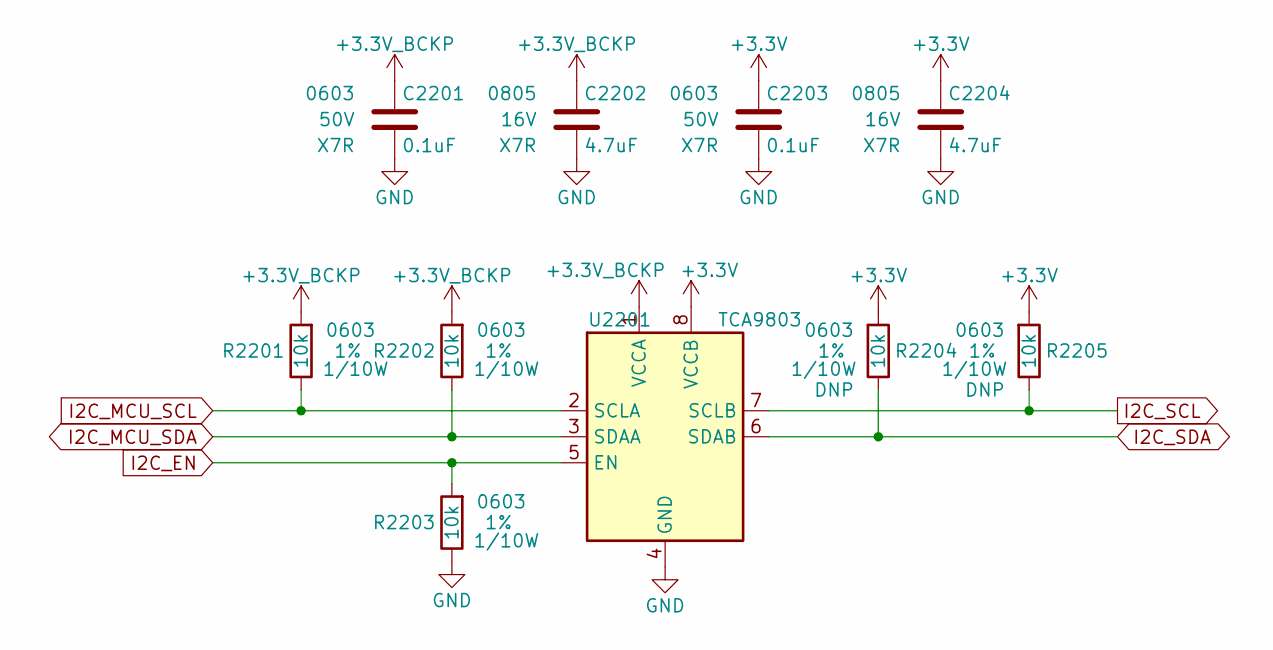
[picture p82: schematic I2C_Buffer.sch]

Parts:
C2201, C2203: 0.1uF; C_0603; Voltage 50V; Digi-Key PN 311-1344-1-ND
C2202, C2204: 4.7uF; C_0805; Voltage 16V; Digi-Key PN 1276-2970-1-ND
R2201, R2202, R2203: 10k; R_0603; Tolerance 1%; Digi-Key PN RMCF0603FT10K0CT-ND
R2204, R2205: 10k; R_0603; Tolerance 1%; Digi-Key PN DNP
U2201: TCA9803; VSSOP-8_3.0x3.0mm_P0.65mm; Digi-Key PN 296-47829-1-ND

Connections:
+3.3V_BCKP: C2201.1, C2202.1, R2201.1, R2202.1, U2201.1 (VCCA); also elsewhere on the board
+3V3: C2203.1, C2204.1, R2204.1, R2205.1, U2201.8 (VCCB); also elsewhere on the board
GND: C2201.2, C2202.2, C2203.2, C2204.2, R2203.2, U2201.4 (GND); also elsewhere on the board
I2C_EN: R2203.1, U2201.5 (EN); also elsewhere on the board
I2C_MCU_SCL: R2201.2, U2201.2 (SCLA); also elsewhere on the board
I2C_MCU_SDA: R2202.2, U2201.3 (SDAA); also elsewhere on the board
I2C_SCL: R2205.2, U2201.7 (SCLB); also elsewhere on the board
I2C_SDA: R2204.2, U2201.6 (SDAB); also elsewhere on the board

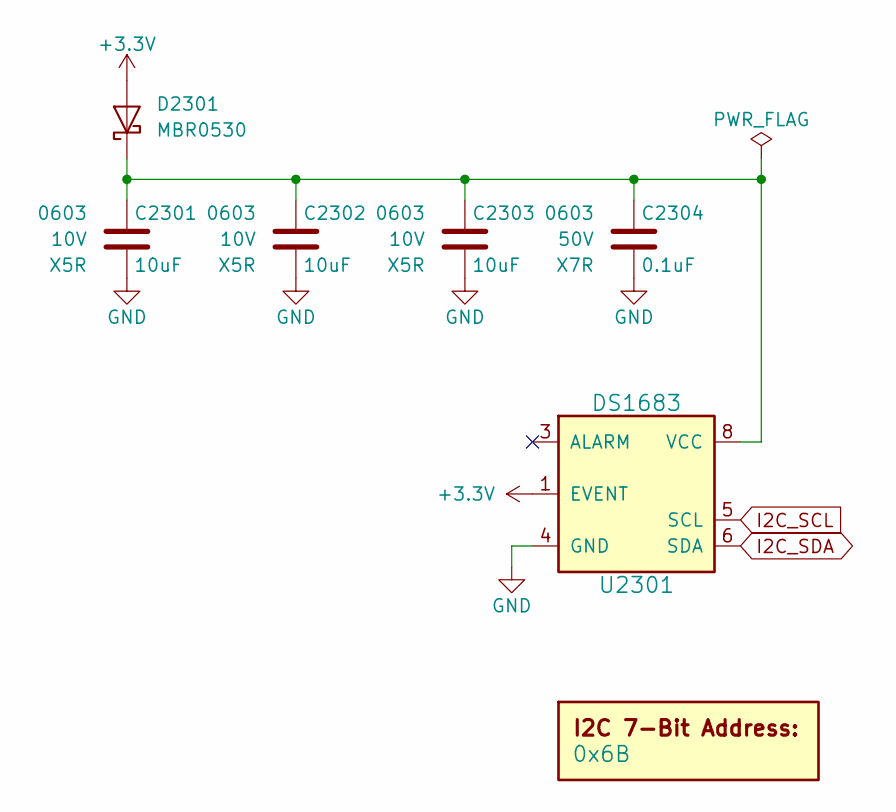
[picture p83: schematic Time_of_Flight.sch]

Parts:
C2301, C2302, C2303: 10uF; C_0603; Voltage 10V; Digi-Key PN 490-14372-1-ND
C2304: 0.1uF; C_0603; Voltage 50V; Digi-Key PN 311-1344-1-ND
D2301: MBR0530; D_SOD-123; Digi-Key PN MBR0530T1GOSCT-ND
DOC2301: 0x6B
U2301: DS1683; SOIC-8_3.9x4.9mm_Pitch1.27mm; Digi-Key PN DS1683S+-ND

Connections:
+3V3: D2301.2 (A), U2301.1 (EVENT); also elsewhere on the board
GND: C2301.2, C2302.2, C2303.2, C2304.2, U2301.4 (GND); also elsewhere on the board
I2C_SCL: U2301.5 (SCL); also elsewhere on the board
I2C_SDA: U2301.6 (SDA); also elsewhere on the board
unnamed: C2301.1, C2302.1, C2303.1, C2304.1, D2301.1 (K), U2301.8 (VCC)

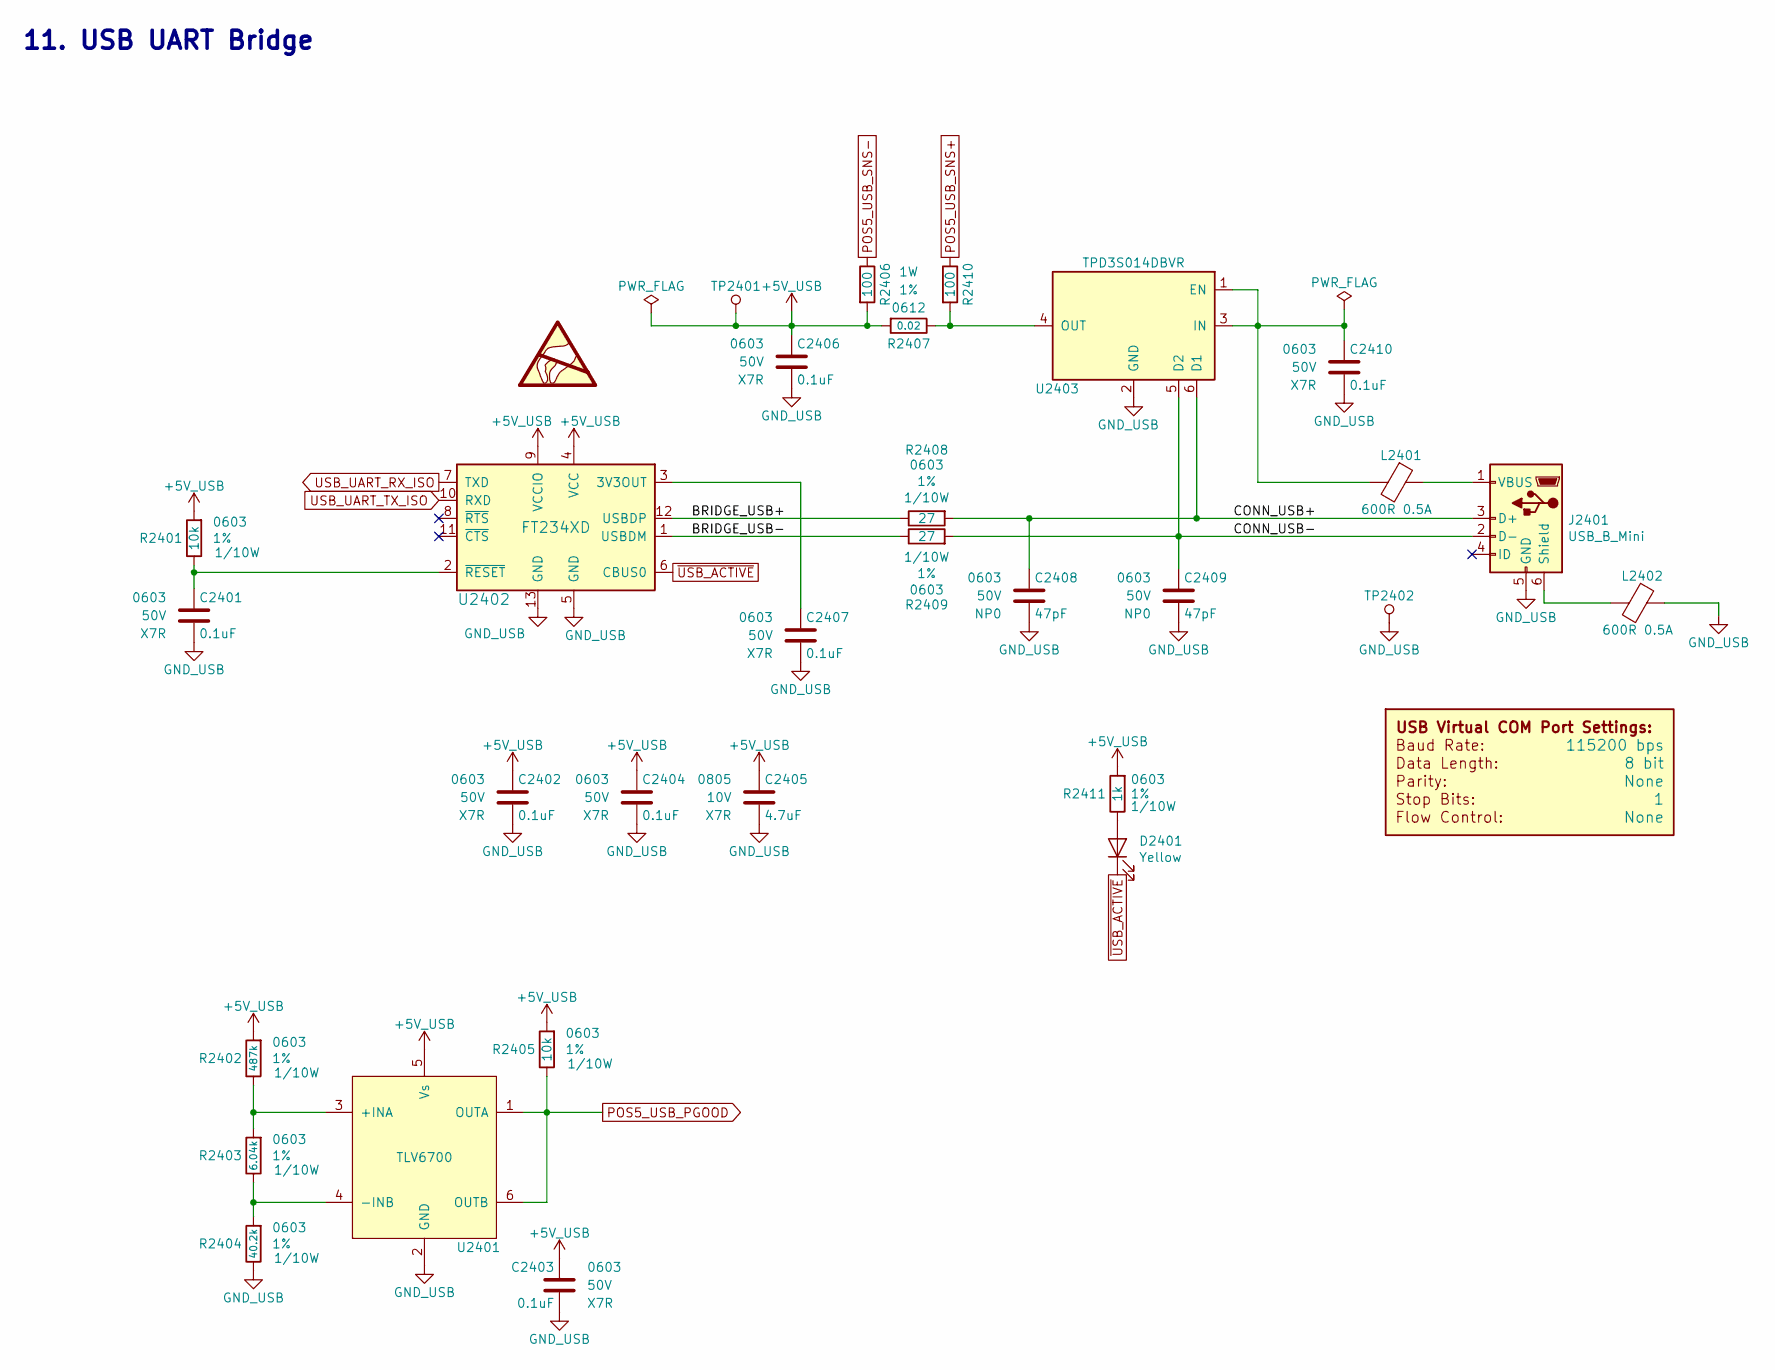
[picture p84: schematic USB_UART_Bridge.sch, VFD Clock]

Parts:
C2401, C2402, C2403, C2404, C2406, C2407, C2410: 0.1uF; C_0603; Voltage 50V; Digi-Key PN 311-1344-1-ND
C2405: 4.7uF; C_0805; Voltage 10V; Digi-Key PN 1276-2972-1-ND
C2408, C2409: 47pF; C_0603; Voltage 50V; Digi-Key PN 478-1171-1-ND
D2401: Yellow; LED_0603; Digi-Key PN 160-1448-1-ND
DOC2401: COM_Port_Settings
J2401: USB_B_Mini; USB_Mini-B; Digi-Key PN 732-2109-1-ND
L2401, L2402: 600R 0.5A; L_0603; Digi-Key PN 732-2389-1-ND
R2401, R2405: 10k; R_0603; Tolerance 1%; Digi-Key PN RMCF0603FT10K0CT-ND
R2402: 487k; R_0603; Tolerance 1%; Digi-Key PN 311-487KHRCT-ND
R2403: 6.04k; R_0603; Tolerance 1%; Digi-Key PN RMCF0603FT6K04CT-ND
R2404: 40.2k; R_0603; Tolerance 1%; Digi-Key PN 311-40.2KHRCT-ND
R2406, R2410: 100; R_0603; Tolerance 1%; Digi-Key PN A106047CT-ND
R2407: 0.02; R_0612; Tolerance 1%; Digi-Key PN P16010CT-ND
R2408, R2409: 27; R_0603; Tolerance 1%; Digi-Key PN RMCF0603FT27R0CT-ND
R2411: 1k; R_0603; Tolerance 1%; Digi-Key PN RMCF0603FT1K00CT-ND
TP2401: TP; Test_Point
TP2402: TP; Pin_Header_Angled_1x01_Pitch2.54mm
U2401: TLV6700; SOT-23-6; Digi-Key PN 296-51696-1-ND
U2402: FT234XD; DFN-12-1EP_3x3mm_Pitch0.45mm; Digi-Key PN 768-1178-1-ND
U2403: TPD3S014DBVR; SOT-23-6; Digi-Key PN 296-38835-1-ND

Connections:
+5V_USB: C2402.1, C2403.1, C2404.1, C2405.1, C2406.1, R2401.1, R2402.1, R2405.1, R2406.1, R2407.1, R2411.1, TP2401.1, U2401.5 (Vs), U2402.4 (VCC), U2402.9 (VCCIO); also elsewhere on the board
/USB UART Bridge/BRIDGE_USB+: R2408.2, U2402.12 (USBDP)
/USB UART Bridge/BRIDGE_USB-: R2409.2, U2402.1 (USBDM)
/USB UART Bridge/CONN_USB+: C2408.1, J2401.3 (D+), R2408.1, U2403.6 (D1)
/USB UART Bridge/CONN_USB-: C2409.1, J2401.2 (D-), R2409.1, U2403.5 (D2)
GND_USB: C2401.2, C2402.2, C2403.2, C2404.2, C2405.2, C2406.2, C2407.2, C2408.2, C2409.2, C2410.2, J2401.5 (GND), L2402.1, R2404.2, TP2402.1, U2401.2 (GND), U2402.5 (GND), U2402.13 (GND), U2403.2 (GND); also elsewhere on the board
unnamed: C2401.1, R2401.2, U2402.2 (~RESET)
unnamed: C2407.1, U2402.3 (3V3OUT)
unnamed: C2410.1, L2401.2, U2403.1 (EN), U2403.3 (IN)
unnamed: D2401.2 (A), R2411.2
unnamed: J2401.1 (VBUS), L2401.1
unnamed: J2401.6 (Shield), L2402.2
unnamed: R2402.2, R2403.1, U2401.3 (+INA)
unnamed: R2403.2, R2404.1, U2401.4 (-INB)
unnamed: R2407.2, R2410.1, U2403.4 (OUT)
POS5_USB_PGOOD: R2405.2, U2401.1 (OUTA), U2401.6 (OUTB); also elsewhere on the board
POS5_USB_SNS+: R2410.2; also elsewhere on the board
POS5_USB_SNS-: R2406.2; also elsewhere on the board
USB_UART_RX_ISO: U2402.7 (TXD); also elsewhere on the board
USB_UART_TX_ISO: U2402.10 (RXD); also elsewhere on the board
~USB_ACTIVE: D2401.1 (K), U2402.6 (CBUS0)

Notes on the sheet:
11. USB UART Bridge

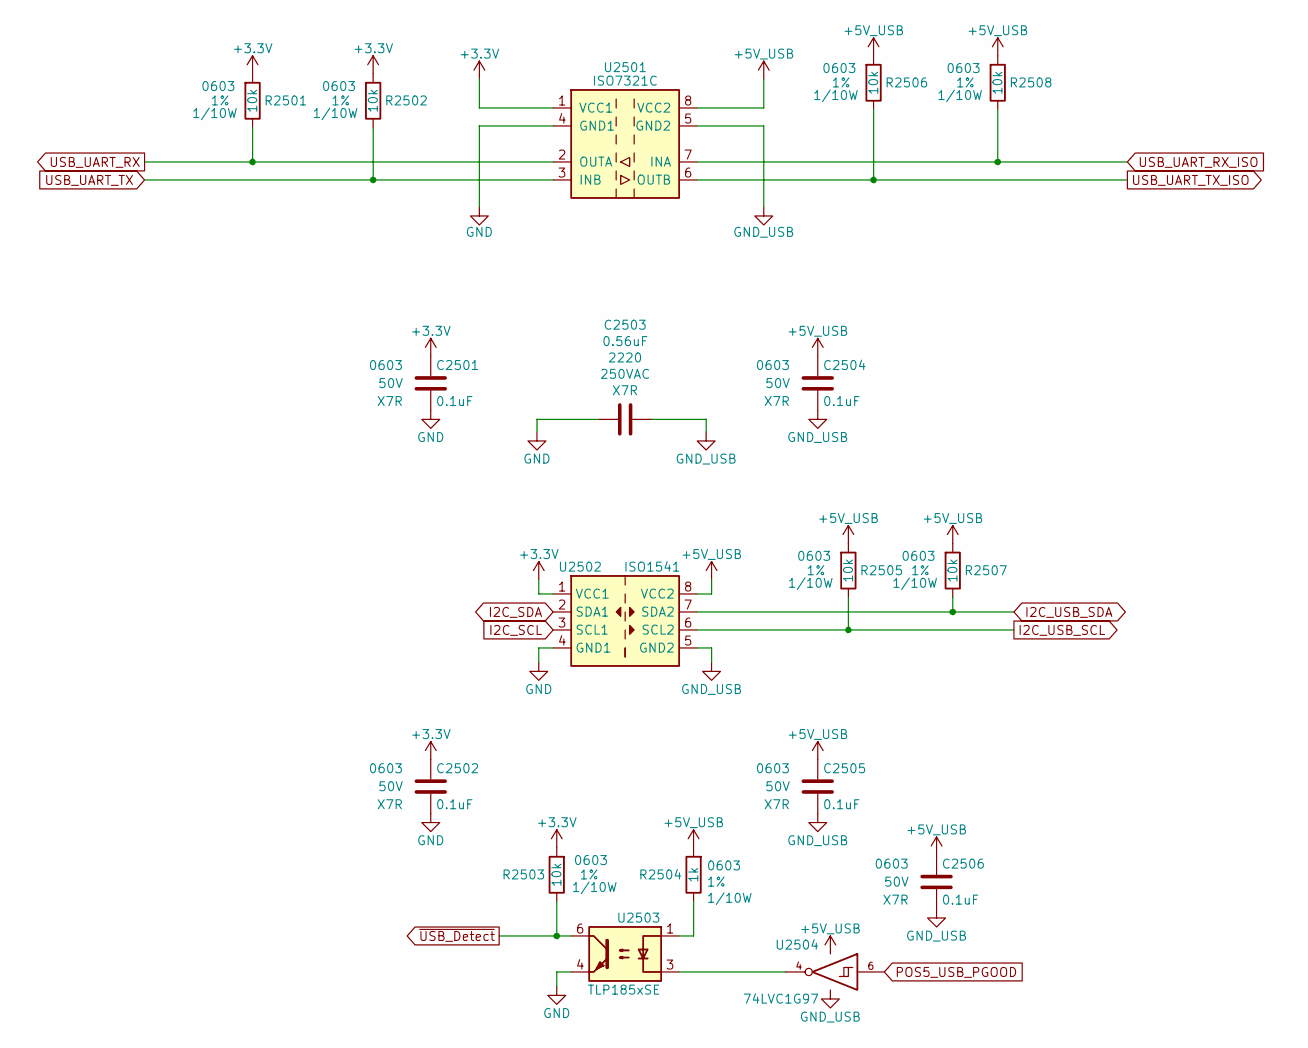
[picture p85: schematic USB_UART_Isolation.sch, VFD Clock]

Parts:
C2501, C2502, C2504, C2505, C2506: 0.1uF; C_0603; Voltage 50V; Digi-Key PN 311-1344-1-ND
C2503: 0.56uF; C_2220; Voltage 250VAC; Digi-Key PN 565-4707-1-ND
R2501, R2502, R2503, R2505, R2506, R2507, R2508: 10k; R_0603; Tolerance 1%; Digi-Key PN RMCF0603FT10K0CT-ND
R2504: 1k; R_0603; Tolerance 1%; Digi-Key PN RMCF0603FT1K00CT-ND
U2501: ISO7321C; SOIC-8_3.9x4.9mm_Pitch1.27mm; Digi-Key PN 296-42102-1-ND
U2502: ISO1541; SOIC-8_3.9x4.9mm_P1.27mm; Digi-Key PN 296-34872-1-ND
U2503: TLP185xSE; SOIC-4_4.55x3.7mm_P2.54mm; Digi-Key PN TLP185(GB-TPLSECT-ND
U2504: 74LVC1G97; SOT-363_SC-70-6; Digi-Key PN 296-15582-1-ND

Connections:
+3V3: C2501.1, C2502.1, R2501.1, R2502.1, R2503.1, U2501.1 (VCC1), U2502.1 (VCC1); also elsewhere on the board
+5V_USB: C2504.1, C2505.1, C2506.1, R2504.1, R2505.1, R2506.1, R2507.1, R2508.1, U2501.8 (VCC2), U2502.8 (VCC2), U2504.1 (VCC), U2504.5 (VCC); also elsewhere on the board
GND: C2501.2, C2502.2, C2503.1, U2501.4 (GND1), U2502.4 (GND1), U2503.4; also elsewhere on the board
GND_USB: C2503.2, C2504.2, C2505.2, C2506.2, U2501.5 (GND2), U2502.5 (GND2), U2504.2 (GND), U2504.3 (GND); also elsewhere on the board
I2C_SCL: U2502.3 (SCL1); also elsewhere on the board
I2C_SDA: U2502.2 (SDA1); also elsewhere on the board
I2C_USB_SCL: R2505.2, U2502.6 (SCL2); also elsewhere on the board
I2C_USB_SDA: R2507.2, U2502.7 (SDA2); also elsewhere on the board
unnamed: R2504.2, U2503.1
unnamed: U2503.3, U2504.4
POS5_USB_PGOOD: U2504.6; also elsewhere on the board
USB_UART_RX: R2501.2, U2501.2 (OUTA); also elsewhere on the board
USB_UART_RX_ISO: R2508.2, U2501.7 (INA); also elsewhere on the board
USB_UART_TX: R2502.2, U2501.3 (INB); also elsewhere on the board
USB_UART_TX_ISO: R2506.2, U2501.6 (OUTB); also elsewhere on the board
~USB_Detect: R2503.2, U2503.6; also elsewhere on the board

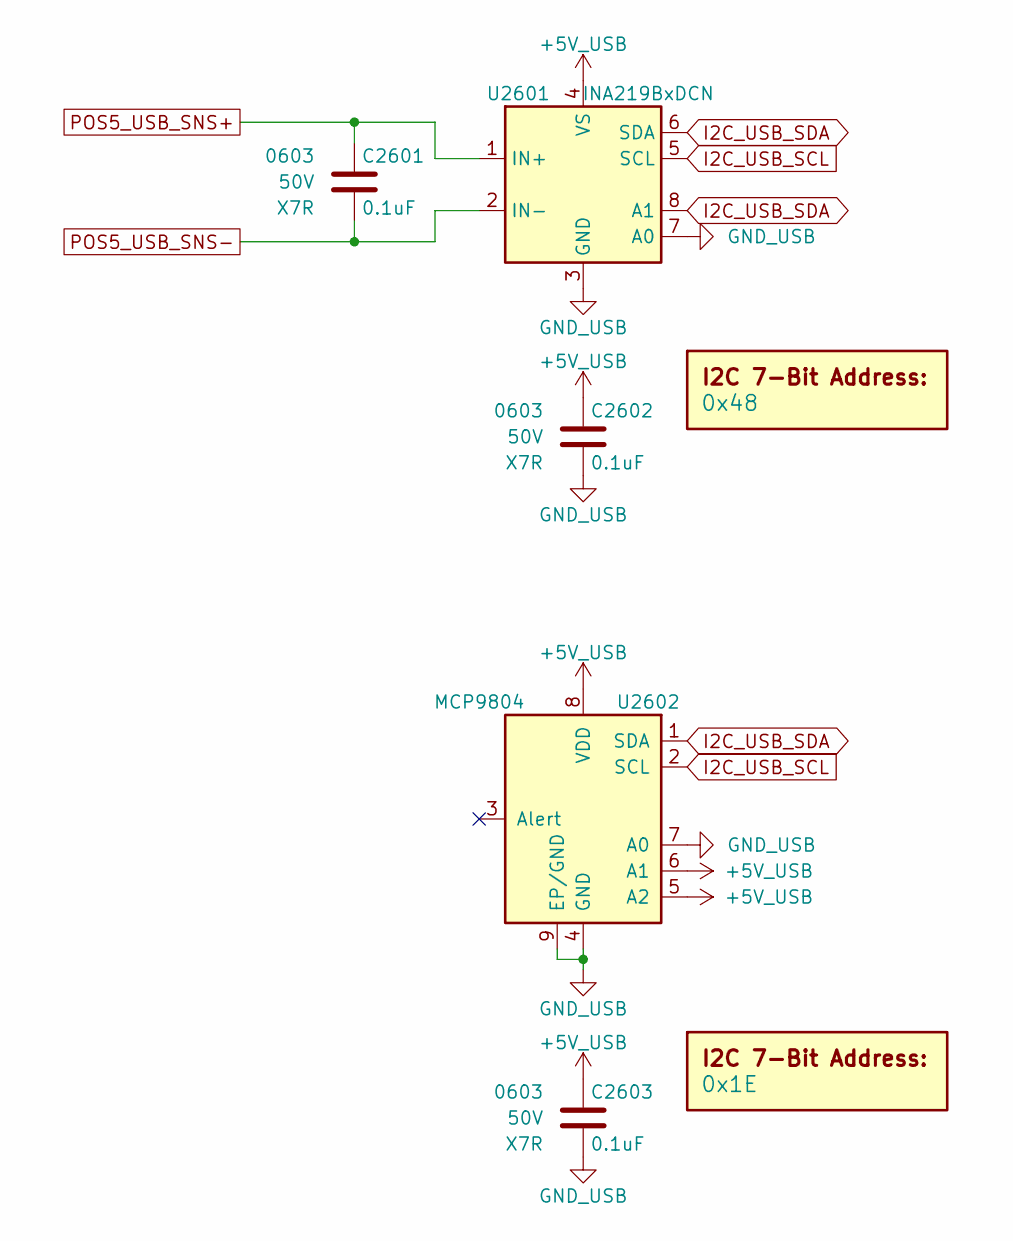
[picture p86: schematic USB_Telemetry.sch]

Parts:
C2601, C2602, C2603: 0.1uF; C_0603; Voltage 50V; Digi-Key PN 399-6856-1-ND
DOC2601: 0x48
DOC2602: 0x1E
U2601: INA219BxDCN; SOT-23-8; Digi-Key PN 296-46420-1-ND
U2602: MCP9804; DFN-8-1EP_3x2mm_P0.5mm_EP1.3x1.5mm; Digi-Key PN MCP9804T-E/MCCT-ND

Connections:
+5V_USB: C2602.1, C2603.1, U2601.4 (VS), U2602.5 (A2), U2602.6 (A1), U2602.8 (VDD); also elsewhere on the board
GND_USB: C2602.2, C2603.2, U2601.3 (GND), U2601.7 (A0), U2602.4 (GND), U2602.7 (A0), U2602.9 (EP/GND); also elsewhere on the board
I2C_USB_SCL: U2601.5 (SCL), U2602.2 (SCL); also elsewhere on the board
I2C_USB_SDA: U2601.6 (SDA), U2601.8 (A1), U2602.1 (SDA); also elsewhere on the board
POS5_USB_SNS+: C2601.1, U2601.1 (IN+); also elsewhere on the board
POS5_USB_SNS-: C2601.2, U2601.2 (IN-); also elsewhere on the board

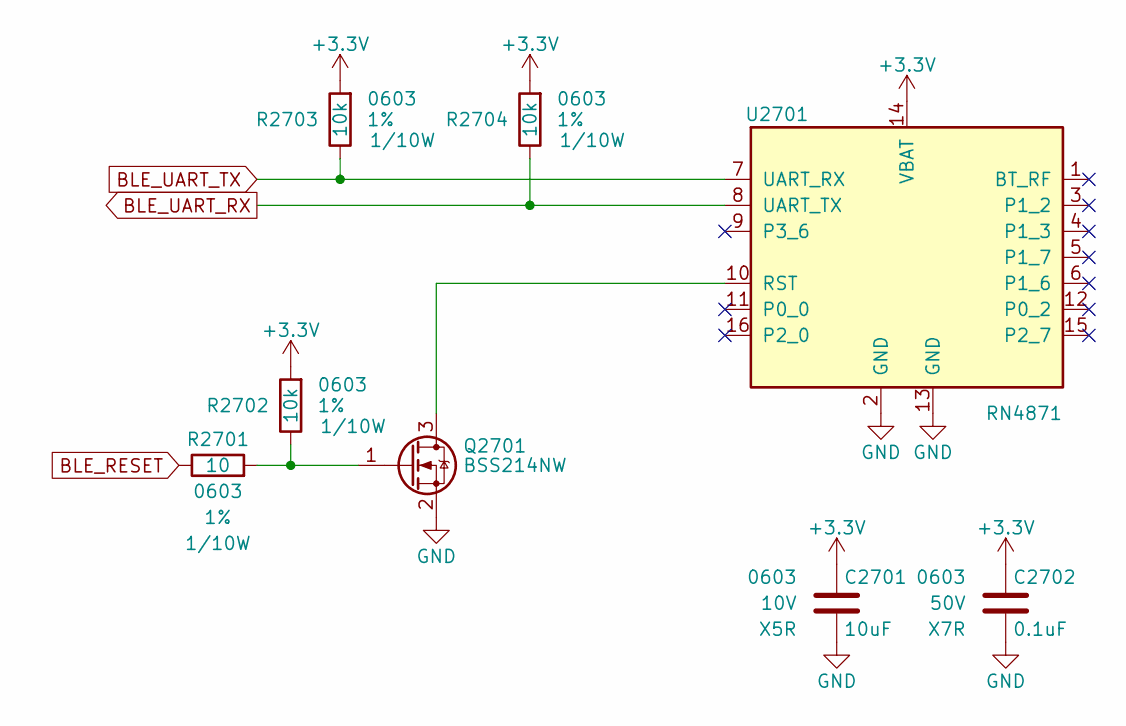
[picture p87: schematic BLE.sch]

Parts:
C2701: 10uF; C_0603; Voltage 10V; Digi-Key PN 490-14372-1-ND
C2702: 0.1uF; C_0603; Voltage 50V; Digi-Key PN 311-1344-1-ND
Q2701: BSS214NW; SOT-323_SC-70; Digi-Key PN BSS214NWH6327XTSA1CT-ND
R2701: 10; R_0603; Tolerance 1%; Digi-Key PN YAG3351CT-ND
R2702, R2703, R2704: 10k; R_0603; Tolerance 1%; Digi-Key PN RHM10KADCT-ND
U2701: RN4871; Microchip_RN4871; Digi-Key PN RN4871-I/RM130-ND

Connections:
+3V3: C2701.1, C2702.1, R2702.1, R2703.1, R2704.1, U2701.14 (VBAT); also elsewhere on the board
BLE_RESET: R2701.2; also elsewhere on the board
BLE_UART_RX: R2704.2, U2701.8 (UART_TX); also elsewhere on the board
BLE_UART_TX: R2703.2, U2701.7 (UART_RX); also elsewhere on the board
GND: C2701.2, C2702.2, Q2701.2 (S), U2701.2 (GND), U2701.13 (GND); also elsewhere on the board
unnamed: Q2701.1 (G), R2701.1, R2702.2
unnamed: Q2701.3 (D), U2701.10 (RST)
