drewsum/VFD_Clock/rev_a/hdw/Logic_Board/VFD_Clock/VFD_Clock.kicad_pcb

## KiCad design rev_a/hdw/Logic_Board/VFD_Clock/VFD_Clock.kicad_pcb (continued)

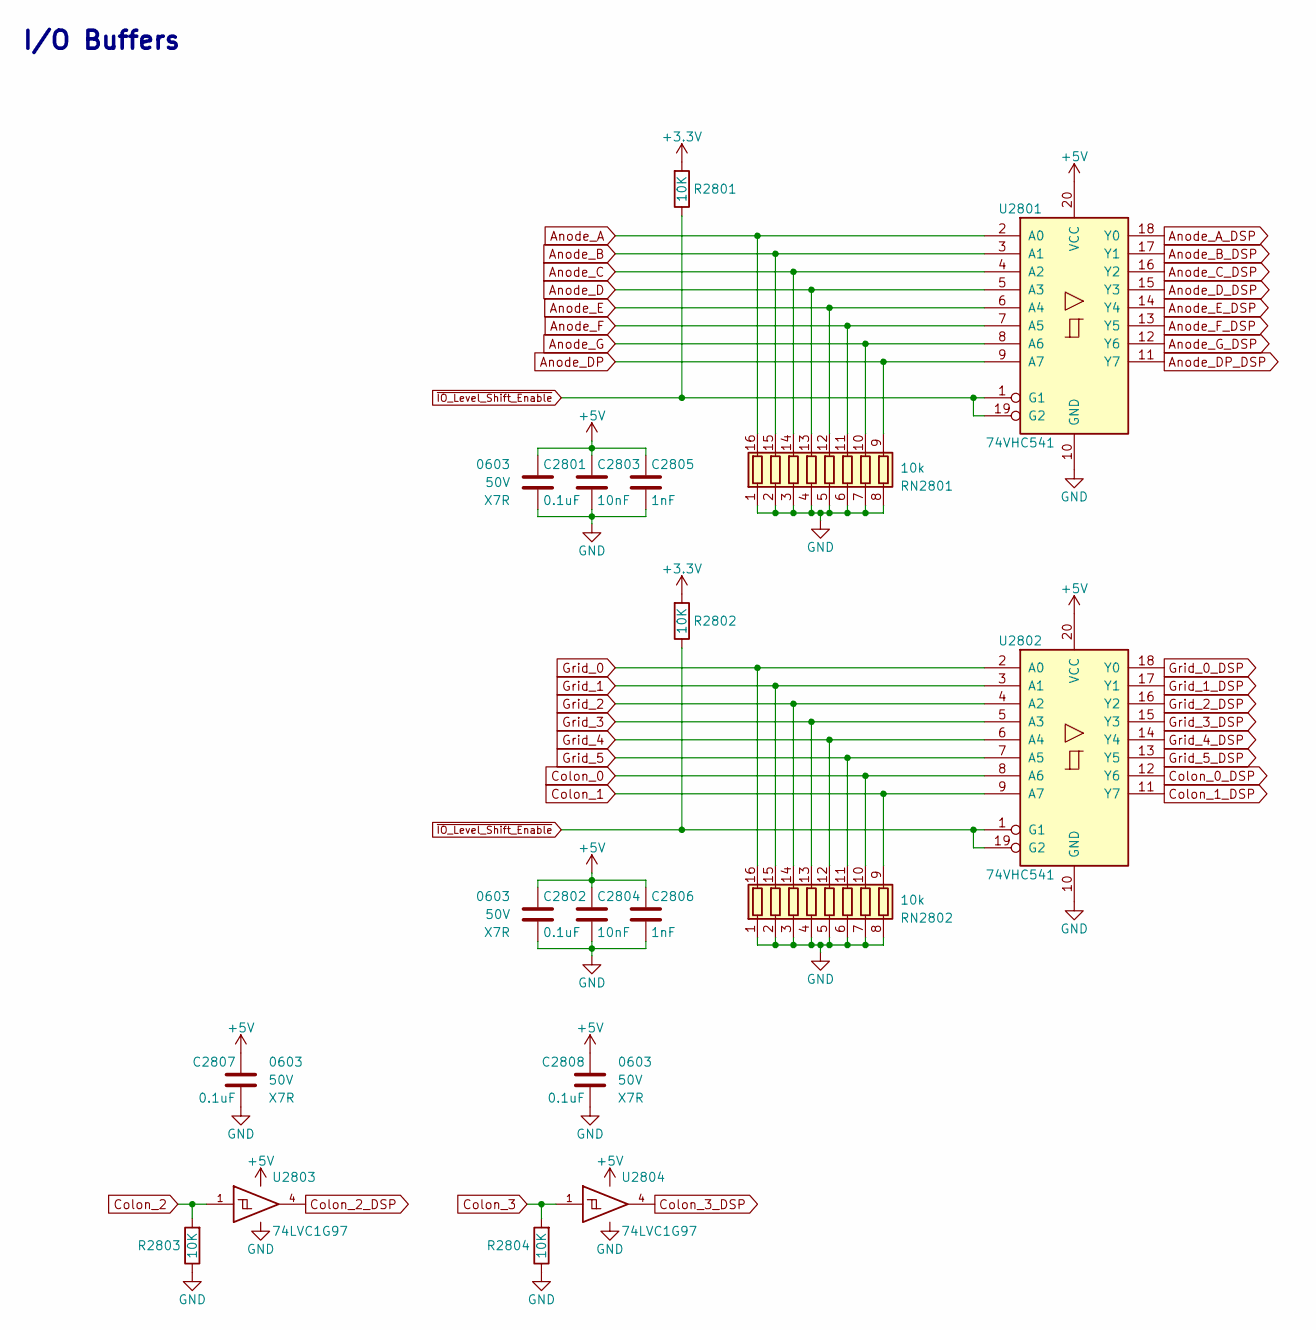
[picture p88: schematic IO_Buffers_1.sch, Electronic Display Logic Board]

Parts:
C2801, C2802, C2807, C2808: 0.1uF; C_0603; Voltage 50V; Digi-Key PN 311-1344-1-ND
C2803, C2804: 10nF; C_0603; Voltage 50V; Digi-Key PN 1276-1921-1-ND
C2805, C2806: 1nF; C_0603; Voltage 50V; Digi-Key PN 1276-1018-1-ND
R2801, R2802, R2803, R2804: 10K; R_0603; Tolerance 1%; Digi-Key PN RHM10KADCT-ND
RN2801, RN2802: 10k; R_Array_Convex_8x0602; Digi-Key PN Y1103CT-ND
U2801, U2802: 74VHC541; WQFN-20-1EP_2.5x4.5mm_P0.5mm_EP1x2.9mm; Digi-Key PN 1727-7068-1-ND
U2803, U2804: 74LVC1G97; SOT-363_SC-70-6; Digi-Key PN 296-15582-1-ND

Connections:
+3V3: R2801.1, R2802.1; also elsewhere on the board
+5V: C2801.1, C2802.1, C2803.1, C2804.1, C2805.1, C2806.1, C2807.1, C2808.1, U2801.20 (VCC), U2802.20 (VCC), U2803.5 (VCC), U2804.5 (VCC); also elsewhere on the board
Anode_A: RN2801.16 (R1.2), U2801.2 (A0); also elsewhere on the board
Anode_A_DSP: U2801.18 (Y0); also elsewhere on the board
Anode_B: RN2801.15 (R2.2), U2801.3 (A1); also elsewhere on the board
Anode_B_DSP: U2801.17 (Y1); also elsewhere on the board
Anode_C: RN2801.14 (R3.2), U2801.4 (A2); also elsewhere on the board
Anode_C_DSP: U2801.16 (Y2); also elsewhere on the board
Anode_D: RN2801.13 (R4.2), U2801.5 (A3); also elsewhere on the board
Anode_DP: RN2801.9 (R8.2), U2801.9 (A7); also elsewhere on the board
Anode_DP_DSP: U2801.11 (Y7); also elsewhere on the board
Anode_D_DSP: U2801.15 (Y3); also elsewhere on the board
Anode_E: RN2801.12 (R5.2), U2801.6 (A4); also elsewhere on the board
Anode_E_DSP: U2801.14 (Y4); also elsewhere on the board
Anode_F: RN2801.11 (R6.2), U2801.7 (A5); also elsewhere on the board
Anode_F_DSP: U2801.13 (Y5); also elsewhere on the board
Anode_G: RN2801.10 (R7.2), U2801.8 (A6); also elsewhere on the board
Anode_G_DSP: U2801.12 (Y6); also elsewhere on the board
Colon_0: RN2802.10 (R7.2), U2802.8 (A6); also elsewhere on the board
Colon_0_DSP: U2802.12 (Y6); also elsewhere on the board
Colon_1: RN2802.9 (R8.2), U2802.9 (A7); also elsewhere on the board
Colon_1_DSP: U2802.11 (Y7); also elsewhere on the board
Colon_2: R2803.1, U2803.1; also elsewhere on the board
Colon_2_DSP: U2803.4; also elsewhere on the board
Colon_3: R2804.1, U2804.1; also elsewhere on the board
Colon_3_DSP: U2804.4; also elsewhere on the board
GND: C2801.2, C2802.2, C2803.2, C2804.2, C2805.2, C2806.2, C2807.2, C2808.2, R2803.2, R2804.2, RN2801.1 (R1.1), RN2801.2 (R2.1), RN2801.3 (R3.1), RN2801.4 (R4.1), RN2801.5 (R5.1), RN2801.6 (R6.1), RN2801.7 (R7.1), RN2801.8 (R8.1), RN2802.1 (R1.1), RN2802.2 (R2.1), RN2802.3 (R3.1), RN2802.4 (R4.1), RN2802.5 (R5.1), RN2802.6 (R6.1), RN2802.7 (R7.1), RN2802.8 (R8.1), U2801.10 (GND), U2801.21 (GND), U2802.10 (GND), U2802.21 (GND), U2803.2 (GND), U2803.3 (GND), U2803.6 (GND), U2804.2 (GND), U2804.3 (GND), U2804.6 (GND); also elsewhere on the board
Grid_0: RN2802.16 (R1.2), U2802.2 (A0); also elsewhere on the board
Grid_0_DSP: U2802.18 (Y0); also elsewhere on the board
Grid_1: RN2802.15 (R2.2), U2802.3 (A1); also elsewhere on the board
Grid_1_DSP: U2802.17 (Y1); also elsewhere on the board
Grid_2: RN2802.14 (R3.2), U2802.4 (A2); also elsewhere on the board
Grid_2_DSP: U2802.16 (Y2); also elsewhere on the board
Grid_3: RN2802.13 (R4.2), U2802.5 (A3); also elsewhere on the board
Grid_3_DSP: U2802.15 (Y3); also elsewhere on the board
Grid_4: RN2802.12 (R5.2), U2802.6 (A4); also elsewhere on the board
Grid_4_DSP: U2802.14 (Y4); also elsewhere on the board
Grid_5: RN2802.11 (R6.2), U2802.7 (A5); also elsewhere on the board
Grid_5_DSP: U2802.13 (Y5); also elsewhere on the board
~IO_Level_Shift_Enable: R2801.2, R2802.2, U2801.1 (G1), U2801.19 (G2), U2802.1 (G1), U2802.19 (G2); also elsewhere on the board

Notes on the sheet:
I/O Buffers

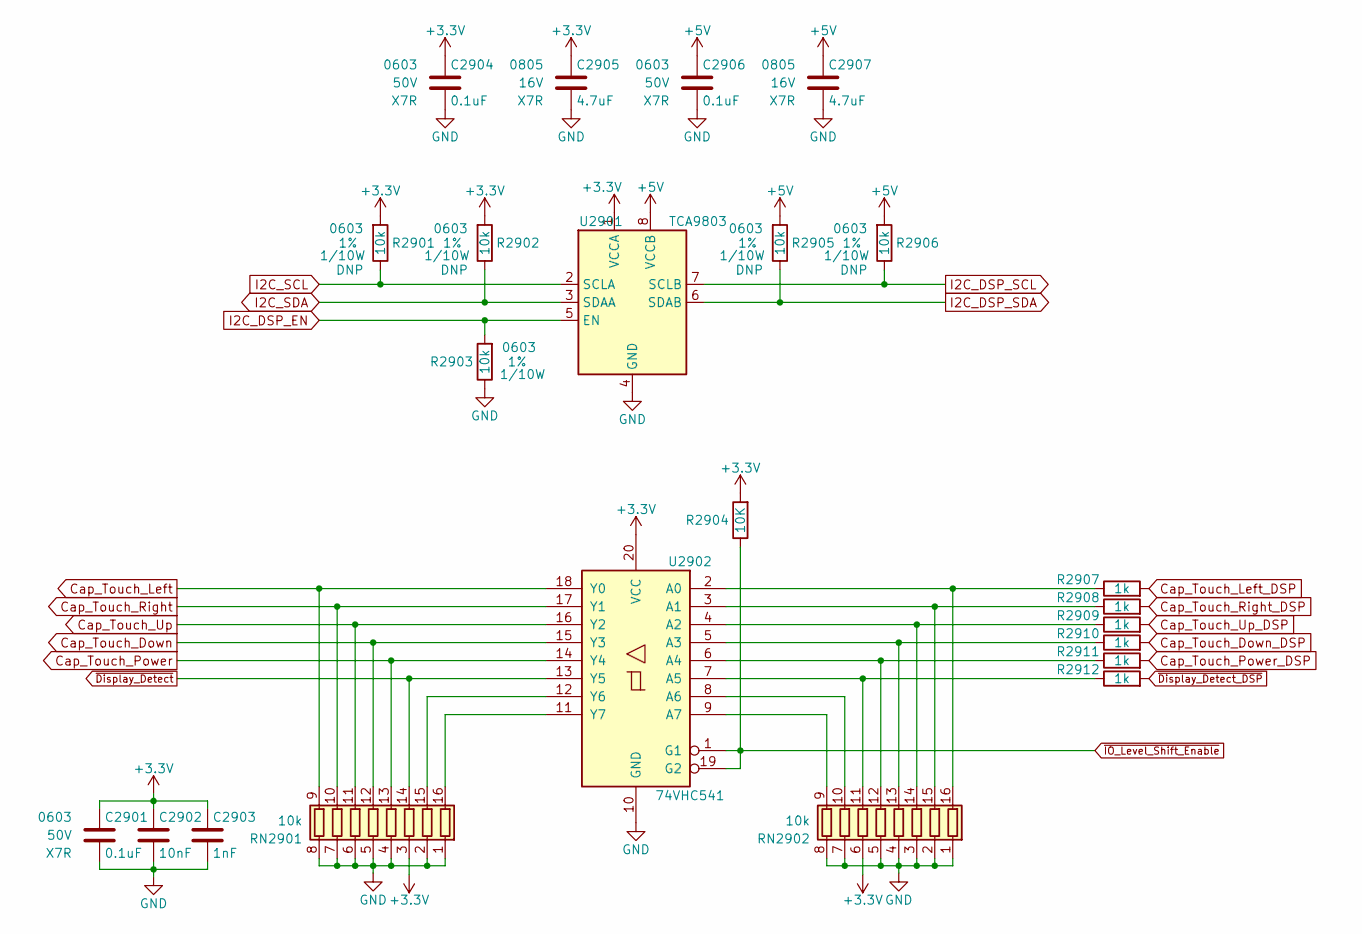
[picture p89: schematic IO_Buffers_2.sch]

Parts:
C2901, C2904, C2906: 0.1uF; C_0603; Voltage 50V; Digi-Key PN 311-1344-1-ND
C2902: 10nF; C_0603; Voltage 50V; Digi-Key PN 1276-1921-1-ND
C2903: 1nF; C_0603; Voltage 50V; Digi-Key PN 1276-1018-1-ND
C2905, C2907: 4.7uF; C_0805; Voltage 16V; Digi-Key PN 1276-2970-1-ND
R2901, R2902, R2905, R2906: 10k; R_0603; Tolerance 1%; Digi-Key PN DNP
R2903: 10k; R_0603; Tolerance 1%; Digi-Key PN RMCF0603FT10K0CT-ND
R2904: 10K; R_0603; Tolerance 1%; Digi-Key PN RHM10KADCT-ND
R2907, R2908, R2909, R2910, R2911, R2912: 1k; R_0603; Tolerance 1%; Digi-Key PN RMCF0603FT1K00CT-ND
RN2901, RN2902: 10k; R_Array_Convex_8x0602; Digi-Key PN Y1103CT-ND
U2901: TCA9803; VSSOP-8_3.0x3.0mm_P0.65mm; Digi-Key PN 296-47829-1-ND
U2902: 74VHC541; WQFN-20-1EP_2.5x4.5mm_P0.5mm_EP1x2.9mm; Digi-Key PN 1727-7068-1-ND

Connections:
+3V3: C2901.1, C2902.1, C2903.1, C2904.1, C2905.1, R2901.1, R2902.1, R2904.1, RN2901.3 (R3.1), RN2902.6 (R6.1), U2901.1 (VCCA), U2902.20 (VCC); also elsewhere on the board
+5V: C2906.1, C2907.1, R2905.1, R2906.1, U2901.8 (VCCB); also elsewhere on the board
Cap_Touch_Down: RN2901.12 (R5.2), U2902.15 (Y3); also elsewhere on the board
Cap_Touch_Down_DSP: R2910.1; also elsewhere on the board
Cap_Touch_Left: RN2901.9 (R8.2), U2902.18 (Y0); also elsewhere on the board
Cap_Touch_Left_DSP: R2907.1; also elsewhere on the board
Cap_Touch_Power: RN2901.13 (R4.2), U2902.14 (Y4); also elsewhere on the board
Cap_Touch_Power_DSP: R2911.1; also elsewhere on the board
Cap_Touch_Right: RN2901.10 (R7.2), U2902.17 (Y1); also elsewhere on the board
Cap_Touch_Right_DSP: R2908.1; also elsewhere on the board
Cap_Touch_Up: RN2901.11 (R6.2), U2902.16 (Y2); also elsewhere on the board
Cap_Touch_Up_DSP: R2909.1; also elsewhere on the board
GND: C2901.2, C2902.2, C2903.2, C2904.2, C2905.2, C2906.2, C2907.2, R2903.2, RN2901.1 (R1.1), RN2901.2 (R2.1), RN2901.4 (R4.1), RN2901.5 (R5.1), RN2901.6 (R6.1), RN2901.7 (R7.1), RN2901.8 (R8.1), RN2902.1 (R1.1), RN2902.2 (R2.1), RN2902.3 (R3.1), RN2902.4 (R4.1), RN2902.5 (R5.1), RN2902.7 (R7.1), RN2902.8 (R8.1), U2901.4 (GND), U2902.10 (GND), U2902.21 (GND); also elsewhere on the board
I2C_DSP_EN: R2903.1, U2901.5 (EN); also elsewhere on the board
I2C_DSP_SCL: R2906.2, U2901.7 (SCLB); also elsewhere on the board
I2C_DSP_SDA: R2905.2, U2901.6 (SDAB); also elsewhere on the board
I2C_SCL: R2901.2, U2901.2 (SCLA); also elsewhere on the board
I2C_SDA: R2902.2, U2901.3 (SDAA); also elsewhere on the board
unnamed: R2907.2, RN2902.16 (R1.2), U2902.2 (A0)
unnamed: R2908.2, RN2902.15 (R2.2), U2902.3 (A1)
unnamed: R2909.2, RN2902.14 (R3.2), U2902.4 (A2)
unnamed: R2910.2, RN2902.13 (R4.2), U2902.5 (A3)
unnamed: R2911.2, RN2902.12 (R5.2), U2902.6 (A4)
unnamed: R2912.2, RN2902.11 (R6.2), U2902.7 (A5)
unnamed: RN2901.15 (R2.2), U2902.12 (Y6)
unnamed: RN2901.16 (R1.2), U2902.11 (Y7)
unnamed: RN2902.9 (R8.2), U2902.9 (A7)
unnamed: RN2902.10 (R7.2), U2902.8 (A6)
~Display_Detect: RN2901.14 (R3.2), U2902.13 (Y5); also elsewhere on the board
~Display_Detect_DSP: R2912.1; also elsewhere on the board
~IO_Level_Shift_Enable: R2904.2, U2902.1 (G1), U2902.19 (G2); also elsewhere on the board

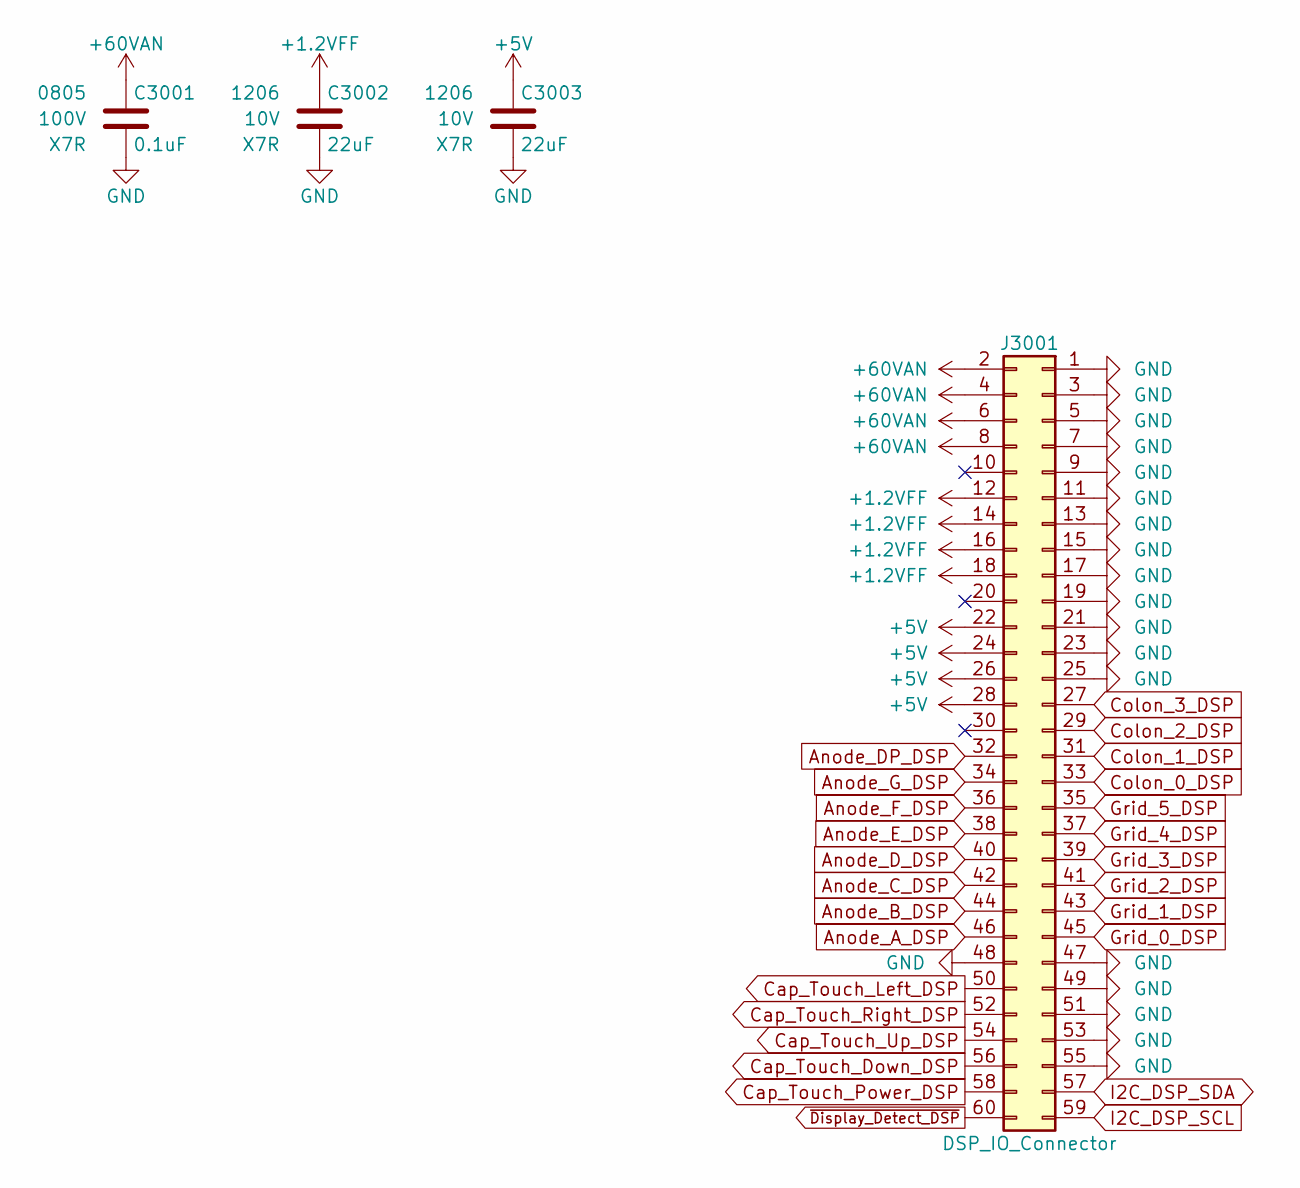
[picture p90: schematic IO_Connectors.sch]

Parts:
C3001: 0.1uF; C_0805; Voltage 100V; Digi-Key PN 490-4789-1-ND
C3002, C3003: 22uF; C_1206; Voltage 10V; Digi-Key PN 1276-3148-1-ND
J3001: DSP_IO_Connector; ERF8-030-07.0-S-DV-K-TR; Digi-Key PN ERF8-030-07.0-S-DV-K-TR

Connections:
+1.2VFF: C3002.1, J3001.12, J3001.14, J3001.16, J3001.18; also elsewhere on the board
+5V: C3003.1, J3001.22, J3001.24, J3001.26, J3001.28; also elsewhere on the board
+60VAN: C3001.1, J3001.2, J3001.4, J3001.6, J3001.8; also elsewhere on the board
Anode_A_DSP: J3001.46; also elsewhere on the board
Anode_B_DSP: J3001.44; also elsewhere on the board
Anode_C_DSP: J3001.42; also elsewhere on the board
Anode_DP_DSP: J3001.32; also elsewhere on the board
Anode_D_DSP: J3001.40; also elsewhere on the board
Anode_E_DSP: J3001.38; also elsewhere on the board
Anode_F_DSP: J3001.36; also elsewhere on the board
Anode_G_DSP: J3001.34; also elsewhere on the board
Cap_Touch_Down_DSP: J3001.56; also elsewhere on the board
Cap_Touch_Left_DSP: J3001.50; also elsewhere on the board
Cap_Touch_Power_DSP: J3001.58; also elsewhere on the board
Cap_Touch_Right_DSP: J3001.52; also elsewhere on the board
Cap_Touch_Up_DSP: J3001.54; also elsewhere on the board
Colon_0_DSP: J3001.33; also elsewhere on the board
Colon_1_DSP: J3001.31; also elsewhere on the board
Colon_2_DSP: J3001.29; also elsewhere on the board
Colon_3_DSP: J3001.27; also elsewhere on the board
GND: C3001.2, C3002.2, C3003.2, J3001.1, J3001.3, J3001.5, J3001.7, J3001.9, J3001.11, J3001.13, J3001.15, J3001.17, J3001.19, J3001.21, J3001.23, J3001.25, J3001.47, J3001.48, J3001.49, J3001.51, J3001.53, J3001.55; also elsewhere on the board
Grid_0_DSP: J3001.45; also elsewhere on the board
Grid_1_DSP: J3001.43; also elsewhere on the board
Grid_2_DSP: J3001.41; also elsewhere on the board
Grid_3_DSP: J3001.39; also elsewhere on the board
Grid_4_DSP: J3001.37; also elsewhere on the board
Grid_5_DSP: J3001.35; also elsewhere on the board
I2C_DSP_SCL: J3001.59; also elsewhere on the board
I2C_DSP_SDA: J3001.57; also elsewhere on the board
~Display_Detect_DSP: J3001.60; also elsewhere on the board

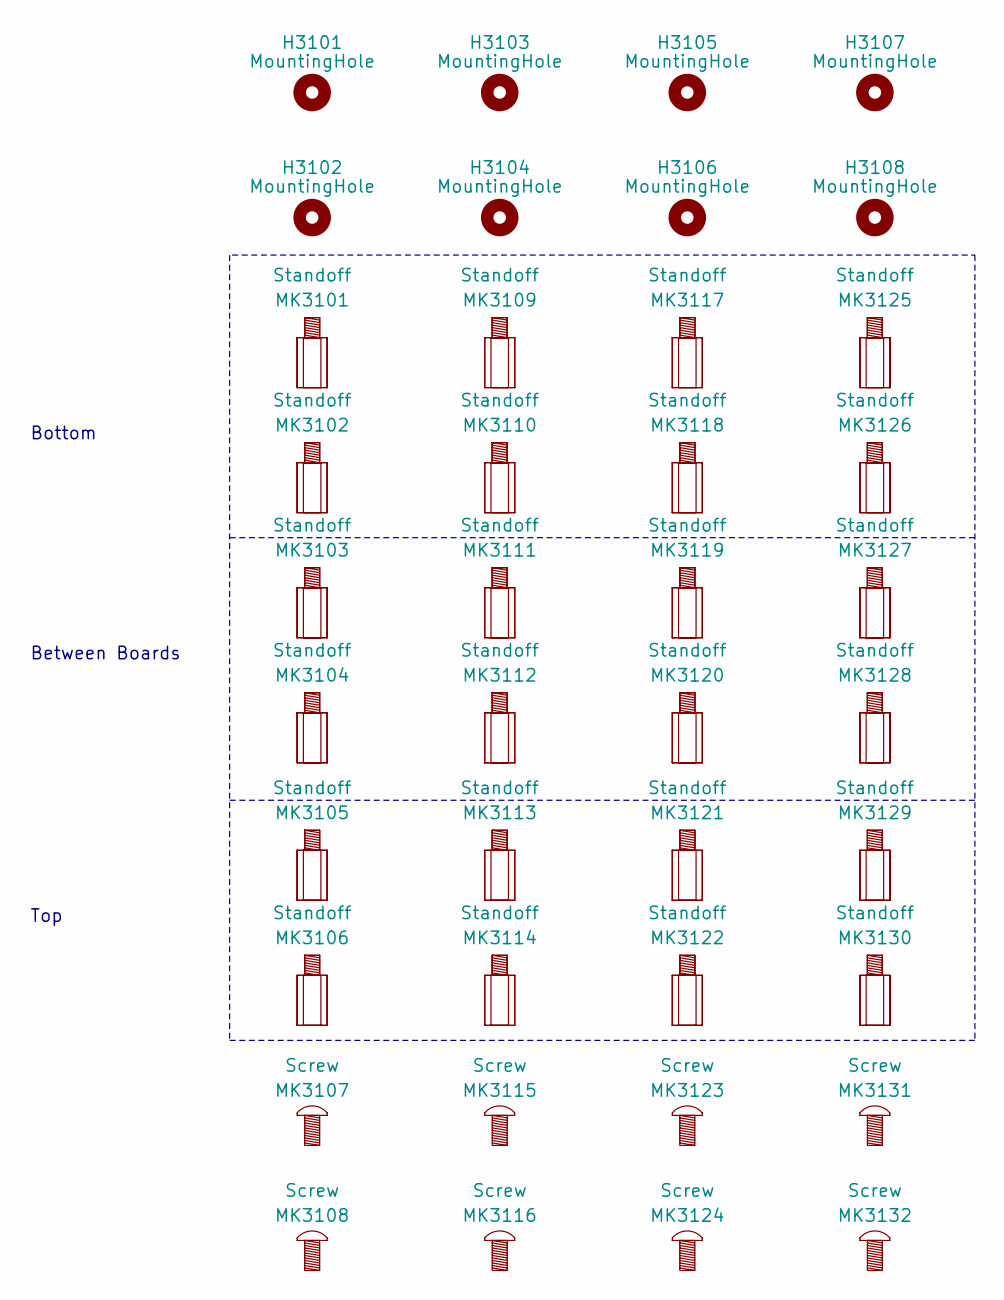
[picture p91: schematic Mechanical.sch, VFD Clock]

Parts:
H3101, H3102, H3103, H3104, H3105, H3106, H3107, H3108: MountingHole; MountingHole_3mm
MK3101, MK3102, MK3105, MK3106, MK3109, MK3110, MK3113, MK3114, MK3117, MK3118, MK3121, MK3122, MK3125, MK3126, MK3129, MK3130: Standoff; Digi-Key PN 1772-2080-ND
MK3103, MK3104, MK3111, MK3112, MK3119, MK3120, MK3127, MK3128: Standoff; Digi-Key PN 1772-1220-ND
MK3107, MK3108, MK3115, MK3116, MK3123, MK3124, MK3131, MK3132: Screw; Digi-Key PN 36-9900-ND

Notes on the sheet:
Bottom
Between Boards
Top

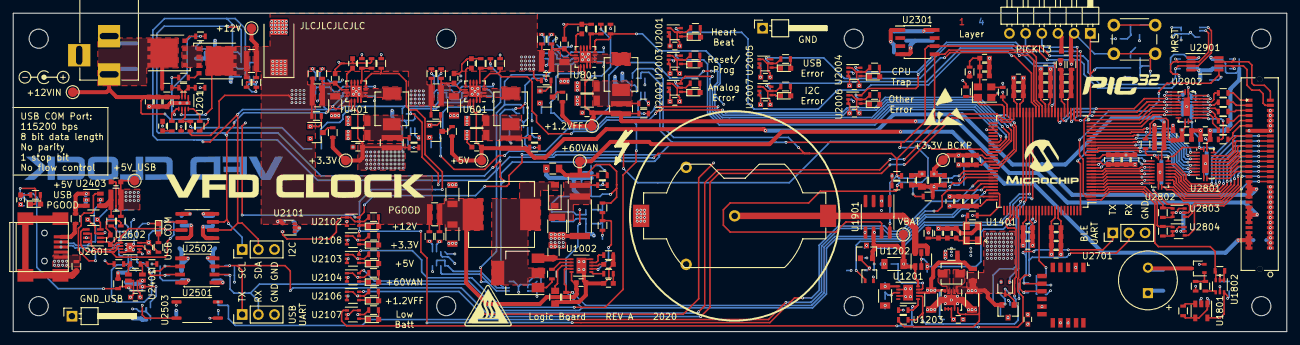
[picture p92: board VFD_Clock.kicad_pcb from above]

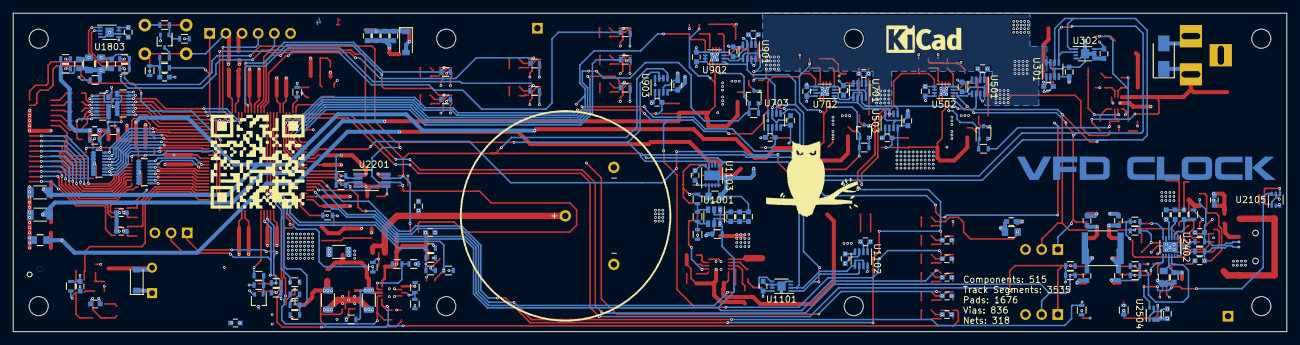
[picture p93: board VFD_Clock.kicad_pcb from below]

Board: 4 copper layers, 200.0 x 50.0 mm, 475 parts (163 on the bottom side), 257 nets.
