drewsum/VFD_Clock/rev_b/sfw/U1401_firmware/VFD_Clock.X/temperature_sensors.c

#include "temperature_sensors.h"

#include <stdio.h>

#include "pin_macros.h"
#include "telemetry.h"
#include "terminal_control.h"

// This function initializes all temperature sensors in the project, if available
void tempSensorsInitialize(void) {
 
    MCP9804TempSensorInitialize(POS12_TEMP_SNS_ADDR, &error_handler.flags.pos12_temp);
    MCP9804TempSensorInitialize(POS3P3_TEMP_SNS_ADDR, &error_handler.flags.pos3p3_temp);
    MCP9804TempSensorInitialize(POS5_TEMP_SNS_ADDR, &error_handler.flags.pos5_temp);
    MCP9804TempSensorInitialize(POS1P2_VFF_TEMP_SNS_ADDR, &error_handler.flags.pos1p2_vff_temp);
    MCP9804TempSensorInitialize(POS60_VAN_TEMP_SNS_ADDR, &error_handler.flags.pos60_van_temp);
    MCP9804TempSensorInitialize(AMB_TEMP_SNS_ADDR, &error_handler.flags.amb_temp);
    
}

// this function gets temperature data for all temperature sensors
void tempSensorsRetrieveData(void) {
 
    telemetry.pos12.temperature         = MCP9804GetTemperature(POS12_TEMP_SNS_ADDR, &error_handler.flags.pos12_temp);
    telemetry.pos3p3.temperature        = MCP9804GetTemperature(POS3P3_TEMP_SNS_ADDR, &error_handler.flags.pos3p3_temp);
    telemetry.pos5.temperature          = MCP9804GetTemperature(POS5_TEMP_SNS_ADDR, &error_handler.flags.pos5_temp);
    telemetry.pos1p2_vff.temperature    = MCP9804GetTemperature(POS1P2_VFF_TEMP_SNS_ADDR, &error_handler.flags.pos1p2_vff_temp);
    telemetry.pos60_van.temperature     = MCP9804GetTemperature(POS60_VAN_TEMP_SNS_ADDR, &error_handler.flags.pos60_van_temp);
    telemetry.ambient_temperature       = MCP9804GetTemperature(AMB_TEMP_SNS_ADDR, &error_handler.flags.amb_temp);
    
    if (nBACKUP_RTC_CONFIG_PIN == LOW) telemetry.backup_rtc_temperature    = DS3231MRTCGetTemperature(BACKUP_RTC_ADDR, &error_handler.flags.backup_rtc);
    
    if (I2C_DSP_EN_PIN == HIGH) {
        telemetry.display_temperature = MCP9804GetTemperature(DSPLY_TEMP_SNS_ADDR, &error_handler.flags.dsply_temp);
    }
    
    temp_sense_data_request = 0;
    
}

// this function prints out the status for all temperature sensors
void printTemperatureSensorStatus(void) {
    // print config data for all temp sensors
    
    MCP9804printStatus(POS12_TEMP_SNS_ADDR, &error_handler.flags.pos12_temp);
    MCP9804printStatus(POS3P3_TEMP_SNS_ADDR, &error_handler.flags.pos3p3_temp);
    MCP9804printStatus(POS5_TEMP_SNS_ADDR, &error_handler.flags.pos5_temp);
    MCP9804printStatus(POS1P2_VFF_TEMP_SNS_ADDR, &error_handler.flags.pos1p2_vff_temp);
    MCP9804printStatus(POS1P2_VFF_TEMP_SNS_ADDR, &error_handler.flags.pos1p2_vff_temp);
    MCP9804printStatus(POS60_VAN_TEMP_SNS_ADDR, &error_handler.flags.pos60_van_temp);
    MCP9804printStatus(AMB_TEMP_SNS_ADDR, &error_handler.flags.amb_temp);
    if (nDISPLAY_DETECT_PIN == 0) {
        MCP9804printStatus(DSPLY_TEMP_SNS_ADDR, &error_handler.flags.dsply_temp);
    }
}
