drewsum/VFD_Clock/rev_b/sfw/U1401_firmware/VFD_Clock.X/vfd_multiplexing.c

#include <xc.h>
#include <string.h>

#include "vfd_multiplexing.h"
#include "clock_functionality.h"

#include "pin_macros.h"
#include "32mz_interrupt_control.h"

// This function initializes the multiplexing timer (using timer 4)
void vfdMultiplexingTimerInitialize(void) {
 
    // Disable timer to start init
    T4CONbits.ON = 0;
    
    // Enable stop in idle, we don't want to mux when in sleep mode
    T4CONbits.SIDL = 1;
    
    // Disable gating
    T4CONbits.TGATE = 0;
    
    // prescaler of 1:2 and period of 12500 gives a muxing period of ~2ms
    // this gives a refresh rate of around 60 Hz
    
    // Set prescaler to 1:2
    T4CONbits.TCKPS = 0b001;
    
    // Set period to 12500
    PR4 = 12500;
    
    // Disable 32 bit mode
    T4CONbits.T32 = 0;
    
    // Set clock source to PBCLK3
    T4CONbits.TCS = 0;
    
    // Clear timer
    TMR4 = 0;
    
    // Clear Timer Interrupt Flag
    clearInterruptFlag(Timer4);
    
    // Set Timer interrupt priority
    setInterruptPriority(Timer4, 5);
    setInterruptSubpriority(Timer4, 2);
    
    // Enable timer interrupt
    enableInterrupt(Timer4);
    
    // set first tube to drive to vfd_tube_0
    active_tube = vfd_tube_0;
    
    // Start timer
    T4CONbits.ON = 1;
    
}

// This function initializes the brightness timer (using timer 5)
void vfdBrightnessTimerInitialize(void) {
    
    // Disable timer to start init
    T5CONbits.ON = 0;
    
    // Enable stop in idle, we don't want to mux when in sleep mode
    T5CONbits.SIDL = 1;
    
    // Disable gating
    T5CONbits.TGATE = 0;
    
    // prescaler of 1:2 and period of 11000 gives an on time of ~1.75ms
    
    // Set prescaler to 1:2
    T5CONbits.TCKPS = 0b001;
    
    // Set brightness to 100%
    PR5 = 100 * vfd_display_brightness_setting;
    
    // Set clock source to PBCLK3
    T5CONbits.TCS = 0;
    
    // Clear timer
    TMR5 = 0;
    
    // Clear Timer Interrupt Flag
    clearInterruptFlag(Timer5);
    
    // Set Timer interrupt priority
    setInterruptPriority(Timer5, 5);
    setInterruptSubpriority(Timer5, 2);
    
    // Enable timer interrupt
    enableInterrupt(Timer5);
    
}

// this function sets the brightness of the display based on what you pass it
// number must be between 10 and 100
void vfdSetDisplayBrightness(uint8_t input_brightness) {
 
    if (input_brightness > 100 || input_brightness < 10) return;
    
    PR5 = 100 * input_brightness;
    
}

// This function stops both multiplexing timers
void vfdTimersStop(void) {
 
    T4CONbits.ON = 0;
    T5CONbits.ON = 0;
    TMR4 = 0;
    TMR5 = 0;
    
    // blank all grids
    blankVFDGrids();
    
    // Blank all anodes
    blankVFDAnodes();
    
}


// muxing timer interrupt service routine
void __ISR(_TIMER_4_VECTOR, IPL5SRS) vfdMultiplexingTimerISR(void) {
    
    // Set the grids for the VFD tubes based on the active_tube global enum
    setVFDGrids();
    
    // Set the anodes for the given VFD tube
    // only do this for tubes that display numbers, not the colons
    // inverse which number appears where, since we want data to show up left to right,
    // to match the order of characters in vfd_display_buffer[]
    setVFDAnodes(vfd_display_buffer[7 - active_tube]);
    
    // Set the DP anode high if we want to display PM/AM time
    if (am_pm_enable == 1 && active_tube == vfd_tube_4 && dp_anode_request == 1) ANODE_DP_PIN = HIGH;
    
    // increment active tube and reset if needed
    active_tube++;
    if (active_tube > vfd_tube_5) active_tube = vfd_tube_0;
    
    // start brightness timer
    T5CONbits.ON = 1;
    
    // clear IRQ
    clearInterruptFlag(Timer4);
    
}

// brightness timer interrupt service routine
void __ISR(_TIMER_5_VECTOR, IPL5SRS) vfdBrightnessTimerISR(void) {
    
    // stop brightness timer
    T5CONbits.ON = 0;
    
    // blank all grids
    blankVFDGrids();
    
    // Blank all anodes
    blankVFDAnodes();
    
    // clear IRQ
    clearInterruptFlag(Timer5);
    
}

// This function sets all VFD tube grids low
void blankVFDGrids(void) {
 
    // Set all grids, along with colon anodes, low
    GRID_0_PIN = LOW;
    GRID_1_PIN = LOW;
    GRID_2_PIN = LOW;
    GRID_3_PIN = LOW;
    GRID_4_PIN = LOW;
    GRID_5_PIN = LOW;
    COLON_0_PIN = LOW;
    COLON_1_PIN = LOW;
    COLON_2_PIN = LOW;
    COLON_3_PIN = LOW;
    
}

// This function blanks all VFD anodes
void blankVFDAnodes(void) {
 
    // blank all anodes
    ANODE_A_PIN = LOW;
    ANODE_B_PIN = LOW;
    ANODE_C_PIN = LOW;
    ANODE_D_PIN = LOW;
    ANODE_E_PIN = LOW;
    ANODE_F_PIN = LOW;
    ANODE_G_PIN = LOW;
    ANODE_DP_PIN = LOW;
    
}

// This function sets up the grids for driving tubes based on active_tube enum
void setVFDGrids(void) {

    // decide what to do based on which tube we want to drive
    switch (active_tube) {
     
        case vfd_tube_0:
            GRID_0_PIN = HIGH;
            break;
            
        case vfd_tube_1:
            GRID_1_PIN = HIGH;
            break;
            
        case vfd_tube_2:
            GRID_2_PIN = HIGH;
            break;
            
        case vfd_tube_3:
            GRID_3_PIN = HIGH;
            break;    
            
        case vfd_tube_4:
            GRID_4_PIN = HIGH;
            break;
            
        case vfd_tube_5:
            GRID_5_PIN = HIGH;
            break;
            
        case right_colon:
            setVFDColonAnodes(0, vfd_display_buffer[5]);
            break;
            
        case left_colon:
            setVFDColonAnodes(1, vfd_display_buffer[2]);
            break;
            
        default:
            break;
        
    }
    
}

// This function sets the proper anodes to display the character passed 
// PASS A CHARACTER, NOT A NUMBER!
void setVFDAnodes(char input_char) {
 
    // Set anodes based on input_char
    // This is a mapping of all supported characters
    // This switch statement acts as a seven segment decoder
    switch (input_char) {
        
        case '0':
            ANODE_A_PIN = HIGH;
            ANODE_B_PIN = HIGH;
            ANODE_C_PIN = HIGH;
            ANODE_D_PIN = HIGH;
            ANODE_E_PIN = HIGH;
            ANODE_F_PIN = HIGH;
            break;
            
        case '1':
            ANODE_B_PIN = HIGH;
            ANODE_C_PIN = HIGH;
            break;
            
        case '2':
            ANODE_A_PIN = HIGH;
            ANODE_B_PIN = HIGH;
            ANODE_D_PIN = HIGH;
            ANODE_E_PIN = HIGH;
            ANODE_G_PIN = HIGH;
            break;
            
        case '3':
            ANODE_A_PIN = HIGH;
            ANODE_B_PIN = HIGH;
            ANODE_C_PIN = HIGH;
            ANODE_D_PIN = HIGH;
            ANODE_G_PIN = HIGH;
            break;
            
        case '4':
            ANODE_B_PIN = HIGH;
            ANODE_C_PIN = HIGH;
            ANODE_F_PIN = HIGH;
            ANODE_G_PIN = HIGH;
            break;
            
        case '5':
            ANODE_A_PIN = HIGH;
            ANODE_C_PIN = HIGH;
            ANODE_D_PIN = HIGH;
            ANODE_F_PIN = HIGH;
            ANODE_G_PIN = HIGH;
            break;
            
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
            ANODE_C_PIN = 1;
            ANODE_D_PIN = 1;
            ANODE_E_PIN = 0;
            ANODE_F_PIN = 1;
            ANODE_G_PIN = 1;
            break;
        
        case 'y':
            ANODE_A_PIN = 0;
            ANODE_B_PIN = 1;
            ANODE_C_PIN = 1;
            ANODE_D_PIN = 1;
            ANODE_E_PIN = 0;
            ANODE_F_PIN = 1;
            ANODE_G_PIN = 1;
            break;    
        
    }
    
}

// This function sets anodes for the colons
// pass a colon number (0:1) and a character to display (:, _, and *)
void setVFDColonAnodes(uint8_t colon_number, char input_char) {
 
    // Kick out if stuff is passed incorrectly
    if (colon_number >= 2) return;
    
    if (colon_number == 0) {
     
        switch (input_char) {
         
            case '*':
                COLON_2_PIN = HIGH;
                break;
                
            case '_':
                COLON_3_PIN = HIGH;
                break;
                
            case ':':
                COLON_2_PIN = HIGH;
                COLON_3_PIN = HIGH;
                break;
            
            default:
                break;
                
        }
        
    }
    
    else if (colon_number == 1) {
     
        switch (input_char) {
         
            case '*':
                COLON_0_PIN = HIGH;
                break;
                
            case '_':
                COLON_1_PIN = HIGH;
                break;
                
            case ':':
                COLON_0_PIN = HIGH;
                COLON_1_PIN = HIGH;
                break;
            
            default:
                break;
                
        }
        
    }
    
    
}
