drewsum/VFD_Clock/rev_b/sfw/U1401_firmware/VFD_Clock.X/adc_channels.c

#include "adc_channels.h"

#include <stdio.h>

#include "32mz_interrupt_control.h"
#include "telemetry.h"
#include "terminal_control.h"

/*
 * 
 * Used ADC channels: 
 * AN7 (Pin RB12) - VBAT ADC
 * AN43 - Internal VREF
 * AN44 - Die Temp
 * 
 * */

// this function sets up ADC channels
void adcChannelsInitialize(void) {
 
    /* Select ADC input mode for each channel*/
    ADCIMCON1bits.DIFF7  = 0; // Single ended mode
    ADCIMCON1bits.SIGN7  = 0; //unsigned data format
    ADCIMCON3bits.DIFF43 = 0; // Single ended mode
    ADCIMCON3bits.SIGN43 = 0; // unsigned data format
    ADCIMCON3bits.DIFF44 = 0; // Single ended mode
    ADCIMCON3bits.SIGN44 = 0; // unsigned data format
    
    /* Configure interrupt enables */
    ADCGIRQEN1bits.AGIEN7  = 1;     // enable data ready 7 IRQ
    ADCGIRQEN2bits.AGIEN43 = 1;     // enable data ready 43 IRQ
    ADCGIRQEN2bits.AGIEN44 = 1;     // enable data ready 44 IRQ
    
    // set IRQ priorities
    setInterruptPriority(ADC_Data_7, 1);
    setInterruptPriority(ADC_Data_43, 1);
    setInterruptPriority(ADC_Data_44, 1);
    
    // set IRQ subpriorities
    setInterruptSubpriority(ADC_Data_7, 0);
    setInterruptSubpriority(ADC_Data_43, 2);
    setInterruptSubpriority(ADC_Data_44, 3);
    
    /* Configure common scan */
    ADCCSS1 = 0;
    ADCCSS2 = 0;
    ADCCSS1bits.CSS7 = 1;           // Enable channel 7 for common scan
    ADCTRG2bits.TRGSRC7 = 0b00011;  // Set AN7 conversion trigger as common scan
    ADCCSS2bits.CSS43 = 1;          // Enable Channel 43 for common scan
    ADCCSS2bits.CSS44 = 1;          // Enable Channel 44 for common scan
    
    // clear interrupt flags
    clearInterruptFlag(ADC_Data_7);
    clearInterruptFlag(ADC_Data_43);
    clearInterruptFlag(ADC_Data_44);
    
    // enable data ready interrupts
    enableInterrupt(ADC_Data_7);
    enableInterrupt(ADC_Data_43);
    enableInterrupt(ADC_Data_44);
    
}

// these ISRs are triggered when data for their respective ADC channel is ready
void __ISR(_ADC_DATA7_VECTOR, IPL1SRS) ADCData7ISR(void) {
 
    // check to see if data is actually ready
    if (ADCDSTAT1bits.ARDY7) {
        
        // copy ADC conversion result into telemetry
        telemetry.battery_voltage = (double) (ADCDATA7 * ADC_VOLTS_PER_LSB * adc_cal_gain * 5.863);
        
    }
    
    // clear IRQ
    clearInterruptFlag(ADC_Data_7);
    
}

void __ISR(_ADC_DATA43_VECTOR, IPL1SRS) ADCData43ISR(void) {

    // check to see if data is actually ready
    if (ADCDSTAT2bits.ARDY43) {
        // copy ADC conversion result into telemetry
        telemetry.adc_vref_voltage = (double) ADCDATA43 * ADC_VOLTS_PER_LSB;
        // compensate for errors in the ADC, we know VREF is supposed to be 1.2V
        adc_cal_gain = (1.2 / telemetry.adc_vref_voltage);
        
    }
    
    // clear IRQ
    clearInterruptFlag(ADC_Data_43);
    
}

void __ISR(_ADC_DATA44_VECTOR, IPL1SRS) ADCData44ISR(void) {
    
    // check to see if data is actually ready
    if (ADCDSTAT2bits.ARDY44) {

        // copy ADC conversion result into telemetry
        telemetry.mcu_die_temp = (double) ((ADCDATA44 * ADC_VOLTS_PER_LSB * adc_cal_gain) - 0.7) / 0.005 + DIE_TEMP_OFFSET;
        
    }
    
    // clear IRQ
    clearInterruptFlag(ADC_Data_44);
    
}

// this function prints out ADC channel status
void printADCChannelStatus(void) {
 
    // print out presence of each analog input
    if (ADCSYSCFG0bits.AN0) terminalTextAttributes(GREEN_COLOR, BLACK_COLOR, NORMAL_FONT);
    else terminalTextAttributes(RED_COLOR, BLACK_COLOR, NORMAL_FONT);
    printf("    Channel AN0 is %s\n\r", ADCSYSCFG0bits.AN0 ? "present" : "absent");
    if (ADCSYSCFG0bits.AN1) terminalTextAttributes(GREEN_COLOR, BLACK_COLOR, NORMAL_FONT);
    else terminalTextAttributes(RED_COLOR, BLACK_COLOR, NORMAL_FONT);
    printf("    Channel AN1 is %s\n\r", ADCSYSCFG0bits.AN1 ? "present" : "absent");
    if (ADCSYSCFG0bits.AN2) terminalTextAttributes(GREEN_COLOR, BLACK_COLOR, NORMAL_FONT);
    else terminalTextAttributes(RED_COLOR, BLACK_COLOR, NORMAL_FONT);
    printf("    Channel AN2 is %s\n\r", ADCSYSCFG0bits.AN2 ? "present" : "absent");
    if (ADCSYSCFG0bits.AN3) terminalTextAttributes(GREEN_COLOR, BLACK_COLOR, NORMAL_FONT);
    else terminalTextAttributes(RED_COLOR, BLACK_COLOR, NORMAL_FONT);
    printf("    Channel AN3 is %s\n\r", ADCSYSCFG0bits.AN3 ? "present" : "absent");
    if (ADCSYSCFG0bits.AN3) terminalTextAttributes(GREEN_COLOR, BLACK_COLOR, NORMAL_FONT);
    else terminalTextAttributes(RED_COLOR, BLACK_COLOR, NORMAL_FONT);
    printf("    Channel AN3 is %s\n\r", ADCSYSCFG0bits.AN3 ? "present" : "absent");
    if (ADCSYSCFG0bits.AN4) terminalTextAttributes(GREEN_COLOR, BLACK_COLOR, NORMAL_FONT);
    else terminalTextAttributes(RED_COLOR, BLACK_COLOR, NORMAL_FONT);
    printf("    Channel AN4 is %s\n\r", ADCSYSCFG0bits.AN4 ? "present" : "absent");
    if (ADCSYSCFG0bits.AN5) terminalTextAttributes(GREEN_COLOR, BLACK_COLOR, NORMAL_FONT);
    else terminalTextAttributes(RED_COLOR, BLACK_COLOR, NORMAL_FONT);
    printf("    Channel AN5 is %s\n\r", ADCSYSCFG0bits.AN5 ? "present" : "absent");
    if (ADCSYSCFG0bits.AN6) terminalTextAttributes(GREEN_COLOR, BLACK_COLOR, NORMAL_FONT);
    else terminalTextAttributes(RED_COLOR, BLACK_COLOR, NORMAL_FONT);
    printf("    Channel AN6 is %s\n\r", ADCSYSCFG0bits.AN6 ? "present" : "absent");
    if (ADCSYSCFG0bits.AN7) terminalTextAttributes(GREEN_COLOR, BLACK_COLOR, NORMAL_FONT);
    else terminalTextAttributes(RED_COLOR, BLACK_COLOR, NORMAL_FONT);
    printf("    Channel AN7 is %s\n\r", ADCSYSCFG0bits.AN7 ? "present" : "absent");
    if (ADCSYSCFG0bits.AN8) terminalTextAttributes(GREEN_COLOR, BLACK_COLOR, NORMAL_FONT);
    else terminalTextAttributes(RED_COLOR, BLACK_COLOR, NORMAL_FONT);
    printf("    Channel AN8 is %s\n\r", ADCSYSCFG0bits.AN8 ? "present" : "absent");
    if (ADCSYSCFG0bits.AN9) terminalTextAttributes(GREEN_COLOR, BLACK_COLOR, NORMAL_FONT);
    else terminalTextAttributes(RED_COLOR, BLACK_COLOR, NORMAL_FONT);
    printf("    Channel AN9 is %s\n\r", ADCSYSCFG0bits.AN9 ? "present" : "absent");
    if (ADCSYSCFG0bits.AN10) terminalTextAttributes(GREEN_COLOR, BLACK_COLOR, NORMAL_FONT);
    else terminalTextAttributes(RED_COLOR, BLACK_COLOR, NORMAL_FONT);
    printf("    Channel AN10 is %s\n\r", ADCSYSCFG0bits.AN10 ? "present" : "absent");
    if (ADCSYSCFG0bits.AN11) terminalTextAttributes(GREEN_COLOR, BLACK_COLOR, NORMAL_FONT);
    else terminalTextAttributes(RED_COLOR, BLACK_COLOR, NORMAL_FONT);
    printf("    Channel AN11 is %s\n\r", ADCSYSCFG0bits.AN11 ? "present" : "absent");
    if (ADCSYSCFG0bits.AN12) terminalTextAttributes(GREEN_COLOR, BLACK_COLOR, NORMAL_FONT);
    else terminalTextAttributes(RED_COLOR, BLACK_COLOR, NORMAL_FONT);
    printf("    Channel AN12 is %s\n\r", ADCSYSCFG0bits.AN12 ? "present" : "absent");
    if (ADCSYSCFG0bits.AN13) terminalTextAttributes(GREEN_COLOR, BLACK_COLOR, NORMAL_FONT);
    else terminalTextAttributes(RED_COLOR, BLACK_COLOR, NORMAL_FONT);
    printf("    Channel AN13 is %s\n\r", ADCSYSCFG0bits.AN13 ? "present" : "absent");
    if (ADCSYSCFG0bits.AN14) terminalTextAttributes(GREEN_COLOR, BLACK_COLOR, NORMAL_FONT);
    else terminalTextAttributes(RED_COLOR, BLACK_COLOR, NORMAL_FONT);
    printf("    Channel AN14 is %s\n\r", ADCSYSCFG0bits.AN14 ? "present" : "absent");
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
//    printf("    Channel AN62 data interrupt %s\n\r", ADCGIRQEN2bits.AGIEN62 ? "enabled" : "disabled");
//    if (ADCGIRQEN2bits.AGIEN63) terminalTextAttributes(GREEN_COLOR, BLACK_COLOR, NORMAL_FONT);
//    else terminalTextAttributes(RED_COLOR, BLACK_COLOR, NORMAL_FONT);
//    printf("    Channel AN63 data interrupt %s\n\r\n\r", ADCGIRQEN2bits.AGIEN63 ? "enabled" : "disabled");
    
    terminalTextAttributesReset();
    
}
