drewsum/VFD_Clock/rev_b/sfw/U1401_firmware/VFD_Clock.X/ds3231_rtc.c

#include "ds3231_rtc.h"

#include <stdio.h>
#include <time.h>

#include "plib_i2c.h"

#include "error_handler.h"
#include "device_control.h"
#include "terminal_control.h"



// This function initializes aN rtc at passed address. Also pass pointer to error handler flag for device
void DS3231MRTCInitialize(uint8_t device_address, volatile uint8_t *device_error_handler_flag) {
    
    // Write config data to config register on input temp sensor
    uint8_t output_data_array[2];
    output_data_array[0] = DS3231M_CONTROL_REG;
    output_data_array[1] = DS3231M_CONTROL_DATA;
    if(!I2CMaster_Write(device_address, output_data_array, 2)) {
        *device_error_handler_flag = 1;
    }
    while(i2c1Obj.state != I2C_STATE_IDLE);
    
    
    // Write config data to config register on input temp sensor
    output_data_array[0] = DS3231M_STATUS_REG;
    output_data_array[1] = DS3231M_STATUS_DATA;
    if(!I2CMaster_Write(device_address, output_data_array, 2)) {
        *device_error_handler_flag = 1;
    }
    while(i2c1Obj.state != I2C_STATE_IDLE);
    
}

// This function reads temperature sensor data from the RTC
double DS3231MRTCGetTemperature(uint8_t device_address, volatile uint8_t *device_error_handler_flag) {
 
    // Check to see if we're starting up into a broken I2C state machine
    while(i2c1Obj.state != I2C_STATE_IDLE);
    
    uint8_t data_reg_pointer[1];
    uint8_t readBytes[2];
    data_reg_pointer[0] = DS3231M_TEMP_MSB_REG;
    if(!I2CMaster_WriteRead(device_address, &data_reg_pointer[0], 1, readBytes, 2)) {
        *device_error_handler_flag = 1;
    }
    while(i2c1Obj.state != I2C_STATE_IDLE);
    
    if (i2c1Obj.state == I2C_STATE_IDLE) {
        // convert received data to volts
        // from section 8.6.3.2 of datasheet
        return (readBytes[0] * 1.0) + ((readBytes[1] >> 6) * 0.25);
    }
    else {
        *device_error_handler_flag = 1;
        return 0.0;
    }
    
    
}

// This function stores the passed time into the RTC. Pass time as a time_t structure
void DS3231MRTCStoreTime(uint8_t device_address, volatile uint8_t *device_error_handler_flag, struct tm input_time) {
 
    // save passed time into variables for writing into RTC
    // First, convert time elements into BCD and shift into format for RTC
    uint8_t write_seconds_01    = input_time.tm_sec % 10;
    uint8_t write_seconds_10    = (input_time.tm_sec / 10) % 10;
    uint8_t write_seconds       = (write_seconds_10 << 4) | write_seconds_01;
    uint8_t write_minutes_01    = input_time.tm_min % 10;
    uint8_t write_minutes_10    = (input_time.tm_min / 10) % 10;
    uint8_t write_minutes       = (write_minutes_10 << 4) | write_minutes_01;
    uint8_t write_hours_01      = input_time.tm_hour % 10;
    uint8_t write_hours_10      = (input_time.tm_hour / 10) % 10;
    uint8_t write_hours         = (write_hours_10 << 4) | write_hours_01;
    
    // Now do the same with date
    uint8_t write_day           = input_time.tm_wday + 1;       // 1 indexed, unlike time.c
    uint8_t write_date_01       = input_time.tm_mday % 10;
    uint8_t write_date_10       = (input_time.tm_mday / 10) % 10;
    uint8_t write_date          = (write_date_10 << 4) | write_date_01;
    uint8_t write_month_01      = (input_time.tm_mon + 1) % 10;     // time.c encodes month 0 indexed
    uint8_t write_month_10      = ((input_time.tm_mon + 1) / 10) % 10;      // time.c encodes month as 0 indexed
    uint8_t write_month         = (write_month_10 << 4) | write_month_01;
    uint8_t write_year_01       = (input_time.tm_year - 100) % 10;      // time.c encodes year as year since 1900
    uint8_t write_year_10       = ((input_time.tm_year - 100) / 10) % 10;      // time.c encodes year as year since 1900
    uint8_t write_year          = (write_year_10 << 4) | write_year_01;
    
    // Now shit all this stuff out to the RTC itself over I2C bus
    // Seconds
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
