drewsum/VFD_Clock/(commit log)

2018-07-04 Initial commit of KiCad schematic files/netlist/project for VFD Clock project
    [+5V_MNG_Power_Supply.sch, +5V_Power_Supply.sch, Ambient_Light_Sensor.sch, AnalogInputs.sch, AnodeDrivers.sch, BackupSupply.sch, Display.sch, FirmwareNotes.sch]
2018-07-14 Final commit of working copy for KiCad version 4.0.7, updating to KiCad 5
2018-07-14 Final final commit for KiCad version 4.0.7
    [Ambient_Light_Sensor.sch, AnalogInputs.sch, AnodeDrivers.sch, BackupSupply.sch, Display.sch, GridDrivers.sch, Microcontroller.sch, PGOOD_Indicators.sch]
2018-07-15 Revert "Final final commit for KiCad version 4.0.7"
    This reverts commit fbe75abb0d1613021aeb88c6dcc17fa8dcce395f.
    [Ambient_Light_Sensor.sch, AnalogInputs.sch, AnodeDrivers.sch, BackupSupply.sch, Display.sch, GridDrivers.sch, Microcontroller.sch, PGOOD_Indicators.sch]
2018-07-15 Initial commit of KiCad version 5 project
    [Ambient_Light_Sensor-2018-07-14-21-00-56.sch, Ambient_Light_Sensor-2018-07-14-21-04-08.sch, Ambient_Light_Sensor.sch, AnalogInputs-2018-07-14-21-00-56.sch, AnalogInputs-2018-07-14-21-04-08.sch, AnalogInputs.sch, AnodeDrivers-2018-07-14-21-00-56.sch, AnodeDrivers-2018-07-14-21-04-08.sch]
2018-07-15 Converted \root\ sheet to table of contents
    [VFD_Clock.sch]
2018-07-15 Added supercap backup circuits to backup supply sheet
    [BackupSupply.sch, PGOOD_Indicators.sch, Status_Indicators.sch]
2018-07-15 Added tube life sheet, blank for now
    [Ambient_Light_Sensor.sch, AnalogInputs.sch, AnodeDrivers.sch, BackupSupply.sch, Display.sch, FirmwareNotes.sch, GridDrivers.sch, Microcontroller.sch]
2018-07-15 Resolved an issue with the field names of resistors on anode and grid driver sheets
    [Ambient_Light_Sensor.sch, AnalogInputs.sch, AnodeDrivers.sch, BackupSupply.sch, Display.sch, GridDrivers.sch, Programming.sch, Pushbuttons.sch]
2018-07-15 Populated tube life counter sheet
    [Tube_Life_Timer.sch]
2018-07-15 Removed a ton of unused old files, not required for current project
    [+5V_MNG_Power_Supply.sch, +5V_Power_Supply.sch, HighSideSwitches.sch, Real_Time_Clock.sch, SwitchPWM.sch, TimeSet.sch, Time_Set.sch, VAN_Output_Sensing.sch]
2018-07-15 Updated UART USB converter sheet, and isolation sheet
    [Microcontroller.sch, UART_Isolation.sch, USB_UART_Converter.sch]
2018-07-15 Removed unused USB Iso sheet
    [USB_Isolation.sch]
2018-07-17 Changed input current sensor to be upstream of ideal diode
    [PowerInput.sch]
2018-07-17 Added colons and drivers to display sheet
    [Display.sch, Microcontroller.sch]
2018-07-17 Moved SCL pin location on tube life timer
    [Tube_Life_Timer.sch]
2018-07-17 Changed the status sheet drastically to use I/O expander, and changed PGOOD sheet to include HOLDUP_PGOOD LED
    [BackupSupply.sch, Display.sch, Microcontroller.sch, PGOOD_Indicators.sch, Status_Indicators.sch]
2018-07-17 Added HOLDUP voltage ADC monitoring
    [AnalogInputs.sch, BackupSupply.sch, Microcontroller.sch, POS3P3V_Power_Supply.sch, VAN_Power_Supply.sch, VFF_Power_Supply.sch]
2018-07-17 Updated PDF to current changes
2018-07-17 Fixed an issue with input voltage rail to high side switch for status LEDs
    [Status_Indicators.sch]
2018-07-17 Added a ton of test points and more indicators for system state
    [AnalogInputs.sch, BackupSupply.sch, PGOOD_Indicators.sch, POS3P3V_Power_Supply.sch, PowerInput.sch, USB_UART_Converter.sch, VAN_Power_Supply.sch, VFF_Power_Supply.sch]
2018-07-17 Added decoupling caps on PGOOD LED buffers
    [PGOOD_Indicators.sch, POS3P3V_Power_Supply.sch, USB_UART_Converter.sch, VAN_Power_Supply.sch, VFF_Power_Supply.sch]
2018-07-19 Added a config field for every part, DNP some I2C pullups, added I2C header, changed some serial port functionality
    [Ambient_Light_Sensor.sch, Microcontroller.sch, SerialNumber.sch, Status_Indicators.sch, Tube_Life_Timer.sch, UART_Isolation.sch, USB_UART_Converter.sch]
2018-07-19 Altered encoder circuit to use little logic to simplify firmware, resized active low signals to it on micro better, updated PDF
    [Microcontroller.sch, Pushbuttons.sch, Status_Indicators.sch, USB_UART_Converter.sch]
2018-07-19 Added mechanical sheet with moutning holes, hardware, graphical PCB symbols, and fiducials
    [Ambient_Light_Sensor.sch, AnalogInputs.sch, AnodeDrivers.sch, BackupSupply.sch, Display.sch, FirmwareNotes.sch, GridDrivers.sch, Mechanical.sch]
2018-07-19 Added I2C Address symbols for I2C devices
    [Ambient_Light_Sensor.sch, Microcontroller.sch, SerialNumber.sch, Status_Indicators.sch, Tube_Life_Timer.sch]
2018-07-21 Changed +3.3V power supply to LTC3833 centered design
    [POS3P3V_Power_Supply.sch]
2018-07-21 Found component values for holdup circuits
    [BackupSupply.sch]
2018-07-23 Annotated all components, finished assigning footprints, netlist generated
    [Ambient_Light_Sensor.sch, AnalogInputs.sch, AnodeDrivers.sch, BackupSupply.sch, Display.sch, GridDrivers.sch, Mechanical.sch, Microcontroller.sch]
2018-07-23 Slight netlist modifications, pulled changes into PCB
    [Display.sch, VFD_Clock.kicad_pcb]
2018-07-24 Changed POS3P3 MOSFETs, further schematic enhancements, footprint updates, and arranged a few more pages of components on PCB
    [POS3P3V_Power_Supply.sch, SerialNumber.sch, UART_Isolation.sch, USB_UART_Converter.sch, VFD_Clock.kicad_pcb]
2018-07-25 Switched to QFN micro, various footprint fixes, layed a a few more sheets out, changed puchbutton debouncers
    [Microcontroller.sch, Pushbuttons.sch, Status_Indicators.sch, VFD_Clock.kicad_pcb, VFF_Power_Supply.sch]
2018-07-25 Arranged USB components, various footprint fixes, added GND_USB EMI cap
    [Status_Indicators.sch, UART_Isolation.sch, USB_UART_Converter.sch, VFD_Clock.kicad_pcb]
2018-07-25 Added a bunch of Digi-Key PN's
    [Ambient_Light_Sensor.sch, AnalogInputs.sch, AnodeDrivers.sch, BackupSupply.sch, Display.sch, GridDrivers.sch, Microcontroller.sch, PGOOD_Indicators.sch]
2018-07-28 Added slight logic changes to tube life timer sheet
    [Tube_Life_Timer.sch]
2018-07-28 Added input energy monitor
    [Microcontroller.sch, PowerInput.sch]
2018-07-28 Arranged VFF power supply components on PCB
    [VFD_Clock.kicad_pcb]
2018-07-29 Removed LTC3833 for POS3P3 supply, replacing with LT8643S
    [POS3P3V_Power_Supply.sch, VAN_Power_Supply.sch, VFD_Clock.kicad_pcb]
2018-07-30 Finished POS3P3 redesign and cleaned other pages
    [Microcontroller.sch, POS3P3V_Power_Supply.sch, PowerInput.sch, Tube_Life_Timer.sch]
2018-07-30 Arranged more components on PCB, cleaned up schematic, added page titles, finished finding DigiKey PN's
    [Ambient_Light_Sensor.sch, AnalogInputs.sch, AnodeDrivers.sch, BackupSupply.sch, Display.sch, GridDrivers.sch, Mechanical.sch, Microcontroller.sch]
2018-07-31 Arranged components for backup power supply
    [VFD_Clock.kicad_pcb]
2018-08-01 Arranged power input sheet on PCB (sinished arranging individual sheets), netlist cleanup)
    [PowerInput.sch, VFD_Clock.kicad_pcb]
2018-08-01 Added preliminary board edge outline to match nixie clock form factor
    [VFD_Clock.kicad_pcb]
2018-08-02 Placed mechanical components on PCB
    [VFD_Clock.kicad_pcb]
2018-08-02 Moved fiducials
    [VFD_Clock.kicad_pcb]
2018-08-02 Placed VFD tubes and colons
    [VFD_Clock.kicad_pcb]
2018-08-02 moved VFD tubes further forward, placed power input circuit
    [VFD_Clock.kicad_pcb]
2018-08-02 Placed grid driver circuits
    [VFD_Clock.kicad_pcb]
2018-08-02 Placed USB and POS3P3 power supplies
    [VFD_Clock.kicad_pcb]
2018-08-02 Placed VAN power supply and asociated circuits
    [Pushbuttons.sch, VFD_Clock.kicad_pcb]
2018-08-02 Placed backup supply and associated circuits
    [VFD_Clock.kicad_pcb]
2018-08-02 Placed VAN supply and associated circuits
    [VFD_Clock.kicad_pcb]
2018-08-02 Placed pushbuttons
    [VFD_Clock.kicad_pcb]
2018-08-02 Started staging Micro and associated parts for placement
    [VFD_Clock.kicad_pcb]
2018-08-05 Switched back to TQFP micro package, placed lots of aux circuits, grid drivers, anode drivers
    [Microcontroller.sch, VFD_Clock.kicad_pcb]
2018-08-05 Finished first pass of arranging parts. Resized sheet to size A
    [VFD_Clock.kicad_pcb]
2018-08-07 Added diff pair signal names, assigned design rules to obvious nets
    [Microcontroller.sch, USB_UART_Converter.sch, VFD_Clock.kicad_pcb]
2018-08-08 Started routing non-critical signals
    [VFD_Clock.kicad_pcb]
2018-08-08 Routed more minor signals
    [VFD_Clock.kicad_pcb]
2018-08-17 More power routing, random low priority signals
    [VFD_Clock.kicad_pcb]
2018-08-18 More power routing
    [VFD_Clock.kicad_pcb]
2018-08-18 More random power routing
    [VFD_Clock.kicad_pcb]
2018-08-18 More random routing, started routing anode connections
    [VFD_Clock.kicad_pcb]
2018-08-19 Finished routing anodes and grids
    [VFD_Clock.kicad_pcb]
2018-08-19 Routed out grid control signals from micro
    [VFD_Clock.kicad_pcb]
2018-08-19 Finished routing anode and grid control signals from micro, routed UART from micro
    [VFD_Clock.kicad_pcb]
2018-08-19 Routed I2C and various analog signals
    [VFD_Clock.kicad_pcb]
2018-08-19 More random analog routing, random small logic signals
    [VFD_Clock.kicad_pcb]
2018-08-19 Routed more I2C and various analog/digital low voltage signals
    [VFD_Clock.kicad_pcb]
2018-08-19 Routed almost all signals, pushbuttons remain
    [VFD_Clock.kicad_pcb]
2018-08-19 Switched a few pushbutton pins to make layout easier
    [Microcontroller.sch, VFD_Clock.kicad_pcb]
2018-08-21 Finished routing pushbuttons
    [VFD_Clock.kicad_pcb]
2018-08-22 Added silkscreen symbols outlined in mechanical sheet, moved power connector
    [VFD_Clock.kicad_pcb]
2018-08-23 Substantial Silkscreen Changes, rotated most ref des's, added symbols and text
    [VFD_Clock.kicad_pcb]
2018-08-23 Added high frequency caps across holdup supercaps
    [BackupSupply.sch, Microcontroller.sch, VFD_Clock.kicad_pcb]
2018-08-23 Added reset detection circuit
    [Ambient_Light_Sensor.sch, AnalogInputs.sch, AnodeDrivers.sch, BackupSupply.sch, Display.sch, FirmwareNotes.sch, GridDrivers.sch, Mechanical.sch]
2018-08-23 Arranged and routed reset detect circuit on PCB
    [VFD_Clock.kicad_pcb]
2018-09-05 Changed from mechanical pushbuttons to mTouch capacitive touch sensing
    [Microcontroller.sch, Pushbuttons.sch, USB_UART_Converter.sch, VFD_Clock.kicad_pcb]
2019-04-09 Repo restructuring
    [Ambient_Light_Sensor-2018-07-14-21-00-56.sch, Ambient_Light_Sensor-2018-07-14-21-04-08.sch, Ambient_Light_Sensor.sch, AnalogInputs-2018-07-14-21-00-56.sch, AnalogInputs-2018-07-14-21-04-08.sch, AnalogInputs.sch, AnodeDrivers-2018-07-14-21-00-56.sch, AnodeDrivers-2018-07-14-21-04-08.sch]
2019-04-09 Redesigned +1.2V VFF
    [Anode_Drivers.sch, Grid_Drivers.sch, Mechanical.sch, Microcontroller.sch, POS1P2_VFF_Power_Supply.sch, POS3P3_BCKP_Supply.sch, POS3P3_Power_Supply.sch, POS60_VAN_Power_Supply.sch]
2019-04-09 More revisions
    [Anode_Drivers.sch, Grid_Drivers.sch, Mechanical.sch, Microcontroller.sch, POS1P2_VFF_Power_Supply.sch, POS24_Input.sch, POS3P3_BCKP_Supply.sch, POS3P3_Power_Supply.sch]
2019-04-11 More work, project restructuring
    [Anode_Drivers.sch, Grid_Drivers.sch, IO_Buffers.sch, IO_Connectors.sch, Mechanical.sch, Microcontroller.sch, Microcontroller_Programming.sch, PGOOD_LEDs.sch]
2019-04-19 Added display board schematic, other additions to logic board
    [Analog_Conditioning.sch, Anode_Drivers.sch, Grid_Drivers.sch, IO_Buffers_1.sch, IO_Buffers_2.sch, IO_Connectors.sch, IV-8_Display_Board.kicad_pcb, IV-8_Display_Board.sch]
2019-04-19 Added +3.3V SW sheet
    [Analog_Conditioning.sch, IO_Buffers_1.sch, IO_Connectors.sch, Mechanical.sch, Microcontroller.sch, Microcontroller_Bypass.sch, Microcontroller_Programming.sch, PGOOD_LEDs.sch]
2019-12-23 Resurrected project
    [Analog_Conditioning.sch, Anode_Drivers.sch, Grid_Drivers.sch, IO_Buffers_1.sch, IO_Buffers_2.sch, IO_Connectors.sch, LT3757.xls, Mechanical.sch]
2019-12-24 Power supply additions
    [IO_Buffers_1.sch, IO_Buffers_2.sch, IO_Connectors.sch, Mechanical.sch, Microcontroller.sch, Microcontroller_Bypass.sch, Microcontroller_Clocking.sch, Microcontroller_Programming.sch]
2019-12-24 Added USB telemetry, isolation, and POS60_VAN current sense
    [IO_Buffers_1.sch, IO_Buffers_2.sch, IO_Connectors.sch, Mechanical.sch, Microcontroller.sch, Microcontroller_Bypass.sch, Microcontroller_Clocking.sch, Microcontroller_Programming.sch]
2019-12-28 Lots of schematic additions
    [I2C_Buffer.sch, IO_Buffers_1.sch, IO_Buffers_2.sch, IO_Connectors.sch, Mechanical.sch, Microcontroller.sch, Microcontroller_Bypass.sch, Microcontroller_Clocking.sch]
2019-12-29 Started IV-6 display board, continued logic board development
    [Anode_Drivers.sch, Grid_Drivers.sch, IO_Buffers_1.sch, IO_Buffers_2.sch, IV-6_Display_Board.kicad_pcb, IV-6_Display_Board.sch, Mechanical.sch, Menu_LEDs.sch]
2020-01-11 Added backup RTC, IO connector, other stuff
    [Anode_Drivers.sch, Backup_RTC.sch, Grid_Drivers.sch, I2C_Buffer.sch, IO_Buffers_1.sch, IO_Buffers_2.sch, IO_Connector.sch, IO_Connectors.sch]
2020-01-18 Changed to configurable discrete gates, added VBAT stuff
    [Mechanical.sch, Microcontroller_Bypass.sch, PGOOD_LEDs.sch, POS12_Telemetry.sch, POS1P2_VFF_Power_Supply.sch, POS1P2_VFF_Telemetry.sch, POS3P3_BCKP_Supply.sch, POS3P3_Power_Supply.sch]
2020-01-18 More IV6 board dev
    [Anode_Drivers.sch, Grid_Drivers.sch, IO_Connector.sch, IV-6_Display_Board.sch, Menu_LEDs.sch, Pushbuttons.sch, VFD_Tubes.sch]
2020-01-19 Display board tweaks, added buzzer, other stuff
    [Anode_Drivers.sch, Backup_RTC.sch, Bulk_Capacitance.sch, Colons.sch, Display_Telemetry.sch, Grid_Drivers.sch, I2C_Buffer.sch, IO_Buffers_1.sch]
2020-01-22 Reorganized logic board pages
    [Anode_Drivers.sch, Backup_RTC.sch, Grid_Drivers.sch, I2C_Buffer.sch, IO_Buffers_1.sch, IO_Buffers_2.sch, IO_Connectors.sch, Mechanical.sch]
2020-01-23 Assigned logic board I2C addresses
2020-01-24 Few hdw tweaks
    [Display_Telemetry.sch, IO_Buffers_1.sch, IO_Buffers_2.sch, IO_Connector.sch, IO_Connectors.sch, Menu_LEDs.sch, Microcontroller.sch, PGOOD_LEDs.sch]
2020-02-02 Added TOF to display board
    [Anode_Drivers.sch, Bulk_Capacitance.sch, Colons.sch, Display_Telemetry.sch, Grid_Drivers.sch, IO_Buffers_2.sch, IO_Connector.sch, IO_Connectors.sch]
2020-02-02 Added backup ADC circuits
    [Misc_Power.sch]
2020-02-06 Few fixes, added BLE
    [BLE.sch, Backup_RTC.sch, I2C_Buffer.sch, IO_Buffers_1.sch, IO_Buffers_2.sch, IO_Connectors.sch, Mechanical.sch, Microcontroller.sch]
2020-02-07 Arranged more parts on PCB
    [POS60_VAN_Telemetry.sch, USB_UART_Bridge.sch, VFD_Clock.kicad_pcb]
2020-02-08 Finished arranging groups of parts
    [POS3P3_BCKP_Supply.sch, VFD_Clock.kicad_pcb]
2020-02-09 placed most parts on board
    [VFD_Clock.kicad_pcb]
2020-02-10 Started routing
    [BLE.sch, IO_Connectors.sch, POS3P3_BCKP_Supply.sch, POS60_VAN_Power_Supply.sch, USB_UART_Bridge.sch, VFD_Clock.kicad_pcb]
2020-02-10 Lots more routing, primarily power stuff
    [POS60_VAN_Power_Supply.sch, VFD_Clock.kicad_pcb]
2020-02-10 More routing
    [VFD_Clock.kicad_pcb]
2020-02-11 Moar routing
    [VFD_Clock.kicad_pcb]
2020-02-12 More rowding
    [Microcontroller.sch, VFD_Clock.kicad_pcb]
2020-02-15 Changed buzzer clock, netlist changes
    [IO_Connectors.sch, Mechanical.sch, Microcontroller.sch, Misc_Circuits.sch, VFD_Clock.kicad_pcb]
2020-02-15 Added two more colon signals, more low speed signal routes
    [IO_Buffers_1.sch, IO_Connectors.sch, Microcontroller.sch, VFD_Clock.kicad_pcb]
2020-02-15 Finished first pass on routing
    [IO_Connectors.sch, Microcontroller.sch, VFD_Clock.kicad_pcb]
2020-02-15 Changed to taller samtec connector
    [IO_Connectors.sch, VFD_Clock.kicad_pcb]
2020-02-16 Added lots of info on silk, logos, etc
    [IO_Connectors.sch, Mechanical.sch, VFD_Clock.csv, VFD_Clock.kicad_pcb]
2020-02-24 Started display board PCB
    [Anode_Drivers.sch, BLE.sch, Bulk_Capacitance.sch, Colons.sch, Display_Telemetry.sch, Grid_Drivers.sch, IO_Connector.sch, IV-6_Display_Board.kicad_pcb]
2020-02-25 rotated VFDs
    [IV-6_Display_Board.kicad_pcb]
2020-02-25 Added IV-1 colon tubes
    [Colons.sch, IV-6_Display_Board.kicad_pcb, VFD_Tubes.sch]
2020-02-25 some display board routing, arrangment
    [Colons.sch, IV-6_Display_Board.kicad_pcb]
2020-02-26 Routed grad and anode drive signals
    [Grid_Drivers.sch, IV-6_Display_Board.kicad_pcb, VFD_Tubes.sch]
2020-02-27 Finished display board layout first pass
    [IV-6_Display_Board.kicad_pcb]
2020-02-28 refactored a lot of display board stuff
    [Anode_Drivers.sch, IV-6_Display_Board.kicad_pcb]
2020-02-28 More display board fixes
    [IV-6_Display_Board.kicad_pcb]
2020-02-29 reclassed some nets, placed I2C devices
    [IV-6_Display_Board.kicad_pcb]
2020-03-01 some reclassing
    [IV-6_Display_Board.kicad_pcb]
2020-03-01 Finished IV-6 layout, generated gerbers, BOM
    [Bulk_Capacitance.sch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]
2020-03-08 Adjusted BOM
    [VFD_Clock_BOM.csv, VFD_Clock_BOM.xlsx, VFD_Clock_BOM.xlsx.xlsx]
2020-03-08 Added MCU firmware project
    [configuration.h]
2020-03-11 Added pin macros to firmware
2020-03-20 Added core drivers, GPIO setup
2020-03-21 Ported heartbet timer
2020-03-21 Switched to POSC w/ PLL as clock source after boot
    [configuration.h]
2020-03-21 Ported USB UART stuff
    [PIC32_OSC_CONFIG_v1.1.xlsx]
2020-03-21 Fixed some USB clock status issues
    [device_control.c]
2020-03-21 Ported cause of reset, cleaned USB commands
    [main.c]
2020-03-21 error handler cleanup, more clock status fixes
    [device_control.c, error_handler.c, error_handler.h, heartbeat_timer.c, main.c]
2020-03-21 Added rail status, refactored some more serial commands
2020-03-21 Added rail control serial functions to enable/disable power supplies
2020-03-21 Added clock calibration python script
2020-03-26 Ported I2C control code
2020-03-27 Ported I2C master code, started temp sensor stuff
2020-03-27 More temp sensor I2C stuff
2020-03-28 Got I2C working again, no clock sticking
2020-03-28 more MCP9804 fix attempts
    [main.c, mcp9804_temp_sensor.c]
2020-03-29 Addded more power monitor stuff
2020-03-29 Added INA219 calibration setting function
2020-03-30 First pass on LTC4151 driver
2020-03-30 Fixed LTC4151 voltage measurement
    [LTC4151_power_monitor.c, LTC4151_power_monitor.h]
2020-03-30 More LTC4151 fixes using TRBs for reading
    [LTC4151_power_monitor.c, LTC4151_power_monitor.h]
2020-03-30 Refactored all I2C read stuff into TRBs for quicker bus response
2020-03-31 Added logic board time of flight query
2020-04-02 Few more bug fixes
    [ds3231_rtc.c, misc_i2c_devices.c, misc_i2c_devices.h]
2020-04-03 Added display board detection stuff
2020-04-03 Added display board time of flight stuff
2020-04-03 Added Timer status serial commands
2020-04-03 Added period and timer value prints to timer status function
2020-04-03 Added early framework for VFD multiplexing
2020-04-03 Added basic framework for driving grids and anodes
2020-04-05 Added updates for display board LEDs
2020-04-05 Added cap touch interrupt support
2020-04-11 Cleaned up tube blanking when setting a value for time with pushbuttons
2020-04-11 Reworked menu flow to make it easier to use
    [clock_functionality.c]
2020-04-11 Fixed weekday display stuff, added ability to set with pushbuttons
    [clock_functionality.c, clock_functionality.h]
2020-04-11 Added power toggle button functionality
2020-04-11 Removed 'set rail enable' serial command
2020-04-12 Added alarm buzzer into clock
    [clock_functionality.c, clock_functionality.h, main.c]
2020-04-13 Fixed I2C addresses in schematic
    [Backup_RTC.sch, POS12_Telemetry.sch, POS1P2_VFF_Telemetry.sch, POS3P3_Telemetry.sch, POS5_Telemetry.sch, POS60_VAN_Telemetry.sch, Time_of_Flight.sch, USB_Telemetry.sch]
2020-04-14 converted certain I2C variables to 32 bit types
2020-04-14 Removed error handler from cache
    [error_handler.h]
2020-04-14 Few I2C master driver optimizations
2020-04-14 Changed I2C Master ISR to IPL7
2020-04-14 Added automatic time recovery on reset
    [main.c]
2020-04-14 fixed some help command strings
    [pgood_monitor.c]
2020-04-15 Lowerd I2C Baud to fix temp sensor data issue
2020-04-15 Adjusted some I2C transaction delays
2020-04-15 Removed more unused 10bit I2C bloat
2020-04-16 a few more i2c fix attempts
    [main.c]
2020-04-18 Added some ADC code
2020-04-18 More ADC stuff
2020-04-18 Got ADC channels working correctly
    [adc_channels.c]
2020-04-19 Moved ADC channels status function into ADC status module, made it its own serial command
2020-04-19 Added I2C master status serial message
2020-04-19 Added some I2C slave status commands
2020-04-19 Added more I2C slave status stuff
2020-04-19 Added temp sensor status messages
2020-04-19 Finished I2C slave status messages
2020-04-19 Changed alarm arm and 24hr setting from binary to true and false strings
2020-10-07 moved rev A data to rev_a directory
    [Anode_Drivers.sch, BLE.sch, Backup_RTC.sch, Bulk_Capacitance.sch, Colons.sch, Display_Telemetry.sch, Grid_Drivers.sch, I2C_Buffer.sch]
2020-10-08 started rev B schematic work
    [BLE.sch, Backup_RTC.sch, I2C_Buffer.sch, IO_Buffers_1.sch, IO_Buffers_2.sch, IO_Connectors.sch, Mechanical.sch, Microcontroller.sch]
2020-10-09 Added USB UART level shifting, few PCB deletions
    [USB_UART_Bridge.sch, VFD_Clock.kicad_pcb]
2020-10-09 PCB changes, deletions
    [Backup_RTC.sch, IO_Buffers_1.sch, IO_Buffers_2.sch, Microcontroller.sch, Microcontroller_Bypass.sch, Microcontroller_Clocking.sch, Microcontroller_Programming.sch, Misc_Circuits.sch]
2020-10-13 Finished rev B schematic, pulled into PCB
    [BLE.sch, Backup_RTC.sch, I2C_Buffer.sch, IO_Buffers_1.sch, IO_Buffers_2.sch, IO_Connectors.sch, Mechanical.sch, Microcontroller.sch]
2020-10-14 More sch work, ran ERC
    [I2C_Buffer.sch, IO_Buffers_2.sch, Microcontroller.sch, Microcontroller_Clocking.sch, USB_UART_Bridge.sch, VFD_Clock.kicad_pcb]
2020-10-15 placed more new parts on board
    [VFD_Clock.kicad_pcb]
2020-10-15 finished placing new parts
    [VFD_Clock.kicad_pcb]
2020-10-17 More rev B PCB routing
    [Microcontroller.sch, VFD_Clock.kicad_pcb]
2020-10-17 moar rev b rowting
    [VFD_Clock.kicad_pcb]
2020-10-18 more routing on rev B pcb
    [Microcontroller.sch, VFD_Clock.kicad_pcb]
2020-10-18 finished rev B PCB, BOM
    [Backup_RTC.sch, Misc_Circuits.sch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]
2020-11-25 copied rev A firmware to start
    [PIC32_OSC_CONFIG_v1.1.xlsx, configuration.h]
2020-11-25 updated pin macros
2020-11-25 started updating pin setup
2020-11-25 Copied a lot of updated I2C device drivers, peripheral drivers
    [configuration.h]
2020-11-25 more I2C port fixes
    [LTC4151_power_monitor.c, error_handler.h, main.c, power_monitors.c, power_monitors.h, tca9555_io_expander.c]
2020-11-27 fixed a lot of legacy I2C drivers
    [error_handler.h, tca9555_io_expander.c]
2020-11-27 lots of fixups, ports
    [main.c, misc_i2c_devices.c, pgood_monitor.c, pin_macros.h]
2020-11-27 fixed some PGOOD monitor stuff
    [heartbeat_services.c, main.c, pgood_monitor.c, pin_macros.h, power_monitors.c, telemetry.h]
2020-12-14 lots of bug fixes, got rev b firmware started
    [LTC4151_power_monitor.c, adc_channels.c, adc_channels.h, ds1683_time_of_flight.c, ds3231_rtc.c, gpio_setup.c, ina219_power_monitor.c, mcp9804_temp_sensor.c]
2020-12-15 fixed power button INT mapping
    [gpio_setup.c]
2020-12-15 fixed PORT IOC interrupt bug
    [32mz_interrupt_control.c]
2020-12-15 fixed GPIO setting bugs
    [gpio_setup.c, gpio_setup.h, main.c]
2020-12-15 added set power serial command
2020-12-16 added serial command for setting display board
2020-12-16 added lots of string fixes, firmware and hardware revision string macros
    [main.c]
2021-01-09 clock calibration script bugfix
